vluncasu/SolarSkin/README.md

# SolarSkin - a 3D printed kinetic facade

The original SolarSkin office carries **twenty moving modules** across its
front. Behind the facade are four occupied levels, furnished rooms and a
technical roof. The assembled CAD model stands about 87 cm tall.
In the Blender scene, each row and column starts at a different point in
the opening cycle. Together the leaves make a wave across the building.

[Browse all building angles](docs/20_building_views.md) · [Original render sheets by revision](docs/21_revision_views.md)

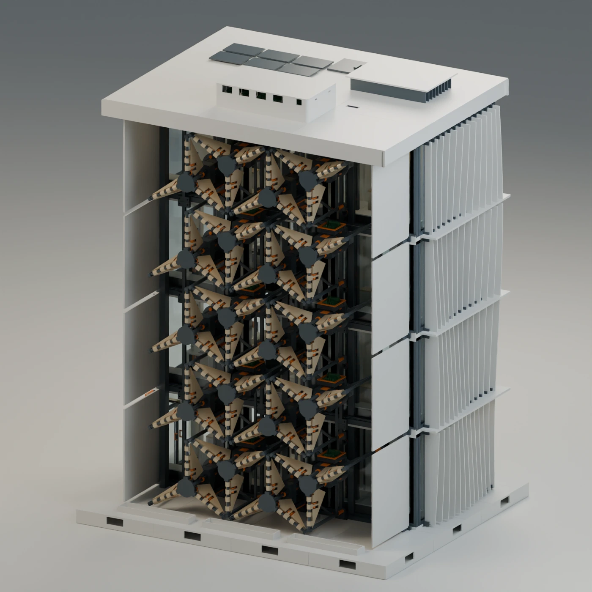
[picture p1: media/renders/original20_front.webp]
Complete September SolarSkin office with its twenty kinetic modules


**[Download the original building - Blender and FreeCAD ZIP](https://github.com/vluncasu/SolarSkin/releases/latest/download/SOLARSKIN_ORIGINAL_OFFICE_20.zip)**
· [Open the animated Blender model](cad/original_20_module_building/COMPLETE_BUILDING_20.blend)
· [Corrected R6 assembly in FreeCAD](cad/original_20_module_building/COMPLETE_BUILDING_R6.FCStd)
· [Download the CAD, print files and manuals](https://github.com/vluncasu/SolarSkin/releases)

| The twenty-module facade in motion | Inside the building | Roof equipment |
|---|---|---|
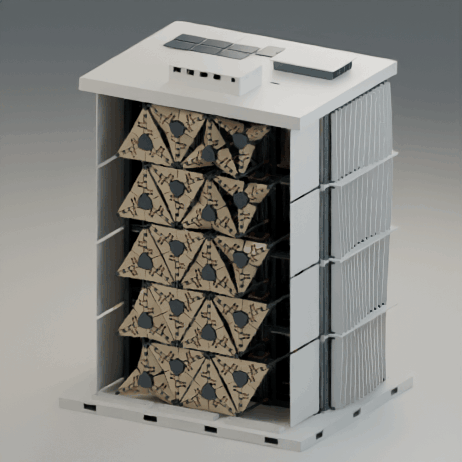
[picture p2: media/renders/original20_motion.gif]
Wave across the original twenty-module office
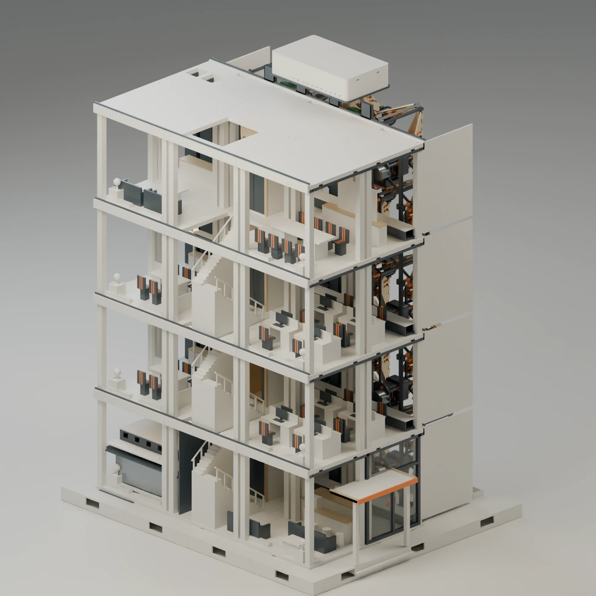
[picture p3: media/renders/original20_cutaway.webp]
Office floors and furnishings in cutaway
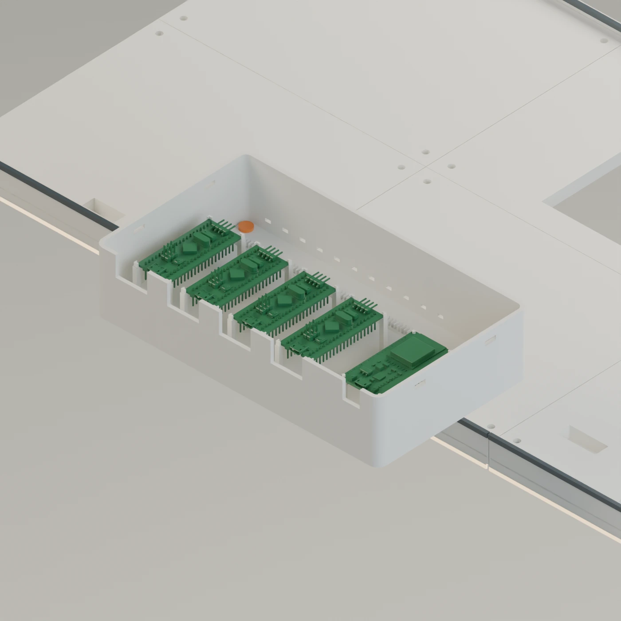
[picture p4: media/renders/original20_roof.webp]
Plant and access space on the technical roof
|  |  |  |

| Around the building | Glazed rear facade | Furnished floor |
|---|---|---|
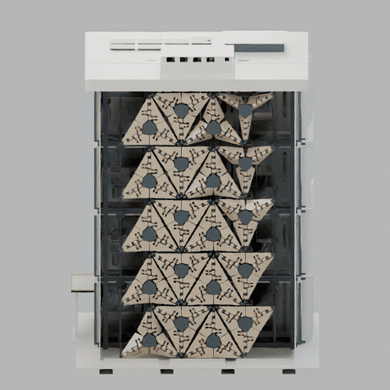
[picture p5: media/views/original20_orbit.gif]
Around the building
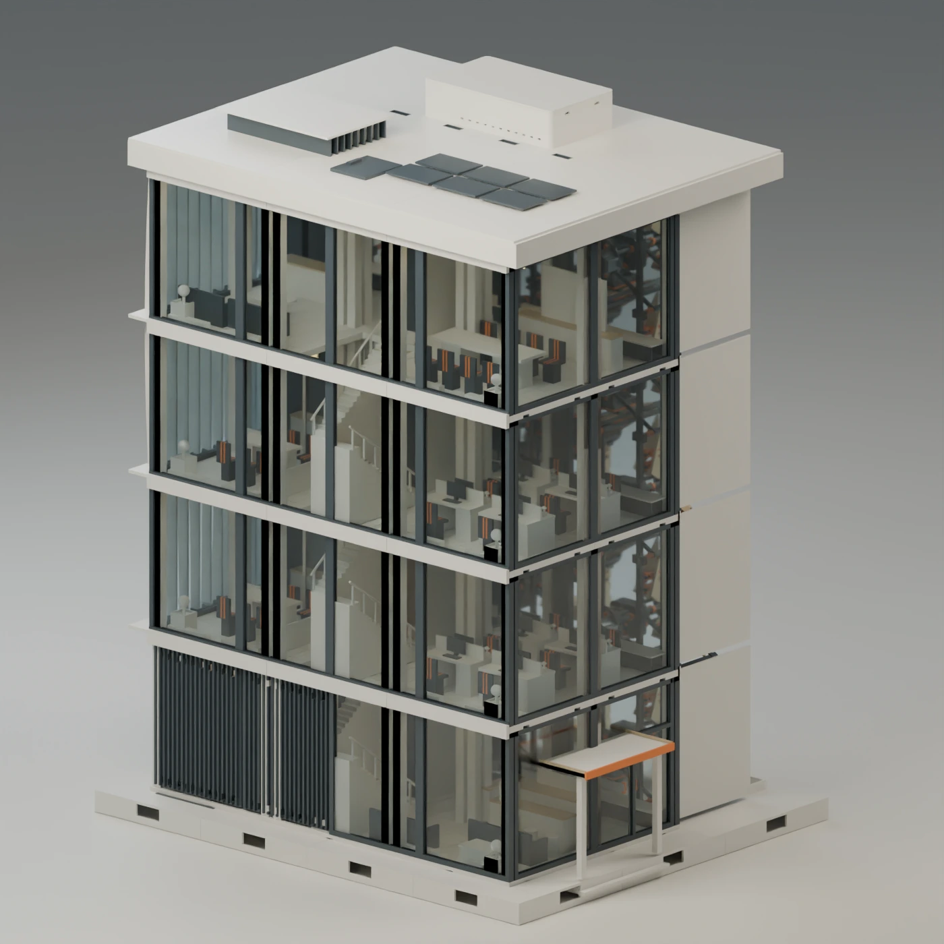
[picture p6: media/renders/original20_rear.webp]
Glazed rear facade
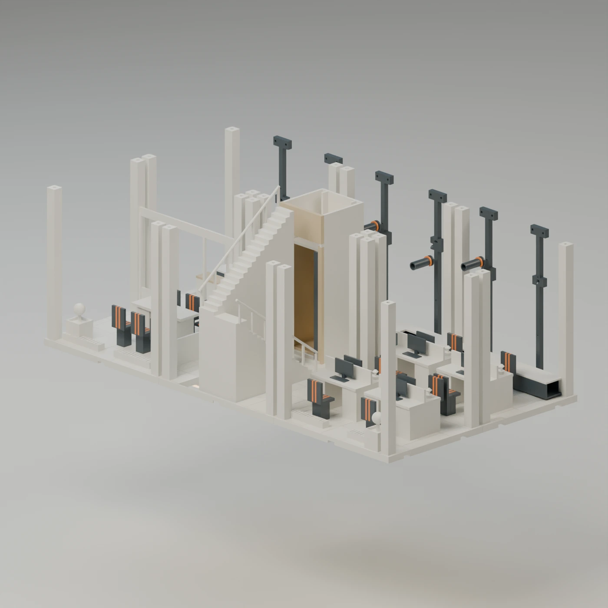
[picture p7: media/renders/original20_floor.webp]
Furnished floor
|  |  |  |

[All angles of the original twenty-module office](docs/20_building_views.md#original-twenty-module-office).

The facade animation above is an accelerated preview. Open the Blender file and
press Space to see the full 40-second sequence at its saved playback rate.
The R6 FreeCAD file exposes the individual M01-M20 placements for inspection.
[Building elevations, office detail and revision notes](docs/19_original_office.md).

## Compact office, Aurora pavilion and rigid office

| Compact office | Aurora pavilion | Rigid office |
|---|---|---|
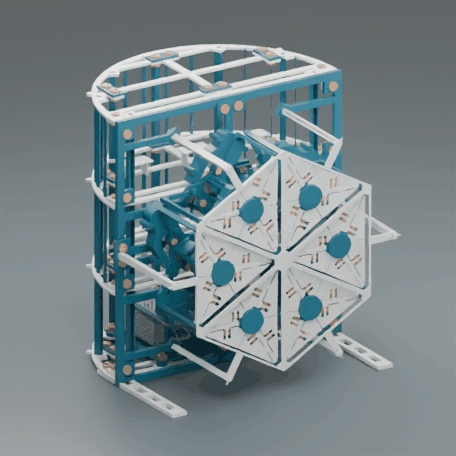
[picture p8: media/renders/compact_motion.gif]
Six modules folding on the compact office
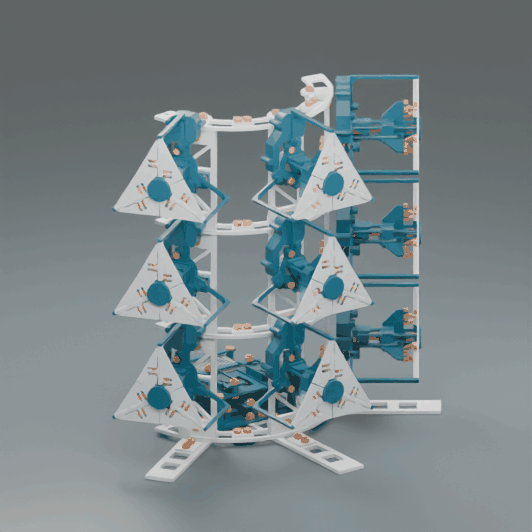
[picture p9: media/renders/aurora_motion.gif]
Moving leaves on the Aurora pavilion
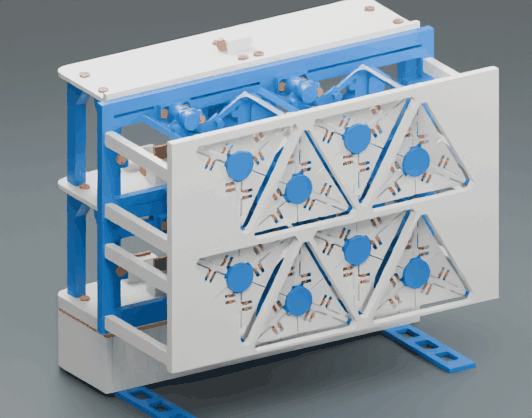
[picture p10: media/renders/rigid_motion.gif]
Eight modules opening on the rigid office
|  |  |  |
| [Animated Blender assembly](cad/earlier_offices/COMPACT_OFFICE.blend) | [Animated Blender assembly](cad/earlier_offices/AURORA_PAVILION.blend) | [Animated Blender assembly](cad/earlier_offices/RIGID_OFFICE.blend) |

The cameras in the motion previews stay still while the leaves move. In the views
below, the buildings stay still so you can inspect the sides, roof and rear.

| Compact office | Aurora pavilion | Rigid office |
|---|---|---|
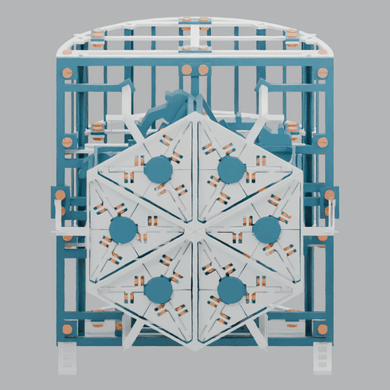
[picture p11: media/views/compact_orbit.gif]
Compact office
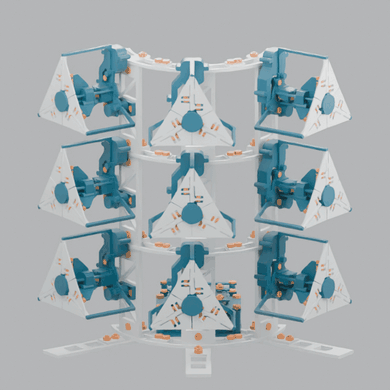
[picture p12: media/views/aurora_orbit.gif]
Aurora pavilion
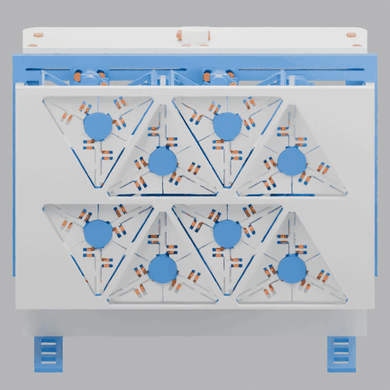
[picture p13: media/views/rigid_orbit.gif]
Rigid office
|  |  |  |

| Compact - curved rear | Aurora - service side | Rigid - rear floors |
|---|---|---|
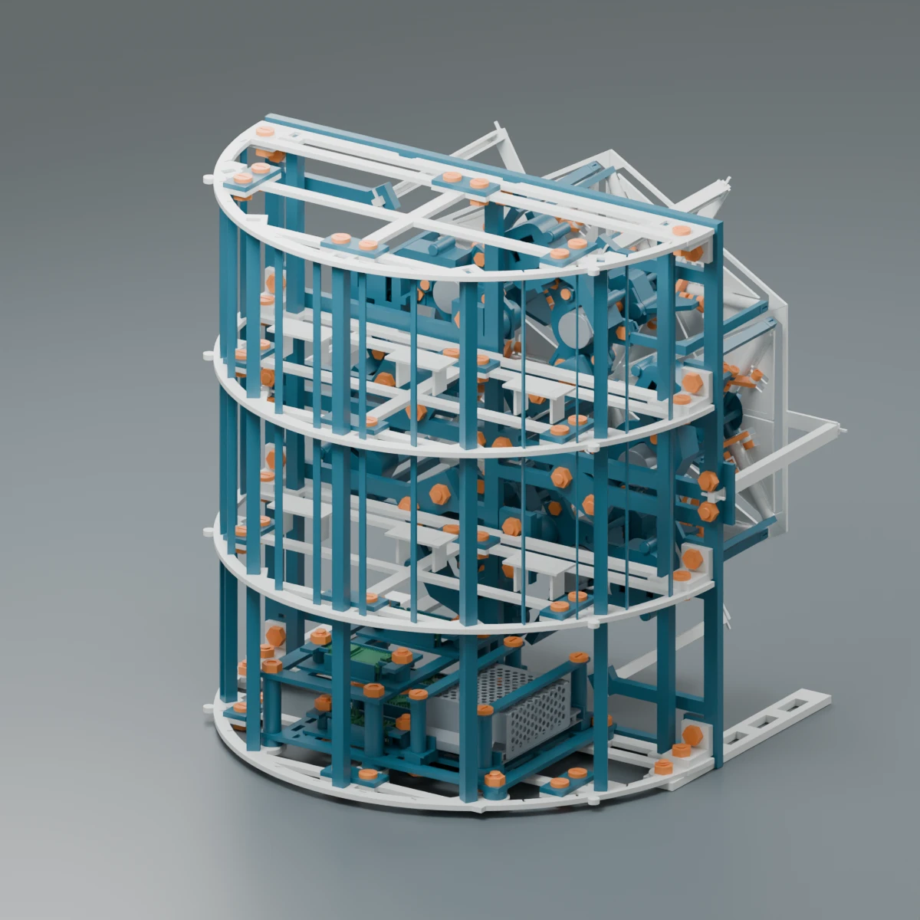
[picture p14: media/views/compact_source_rear.webp]
Compact - curved rear
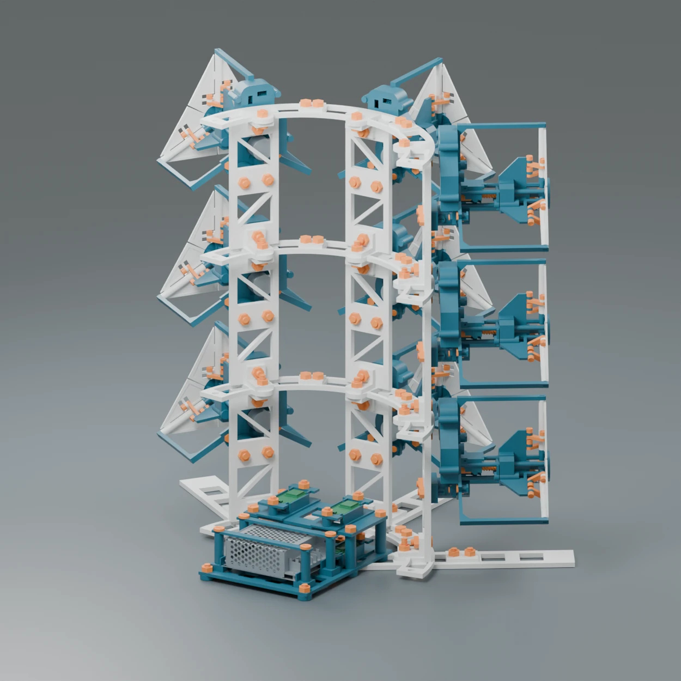
[picture p15: media/views/aurora_source_service_rear.webp]
Aurora - service side
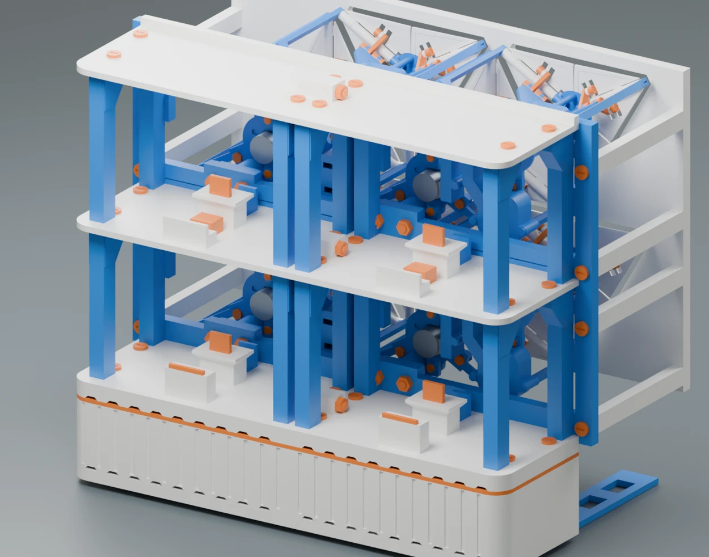
[picture p16: media/views/rigid_source_rear.webp]
Rigid - rear floors
|  |  |  |

| Compact - technical cassette | Aurora - exposed frame | Rigid - equipment bay |
|---|---|---|
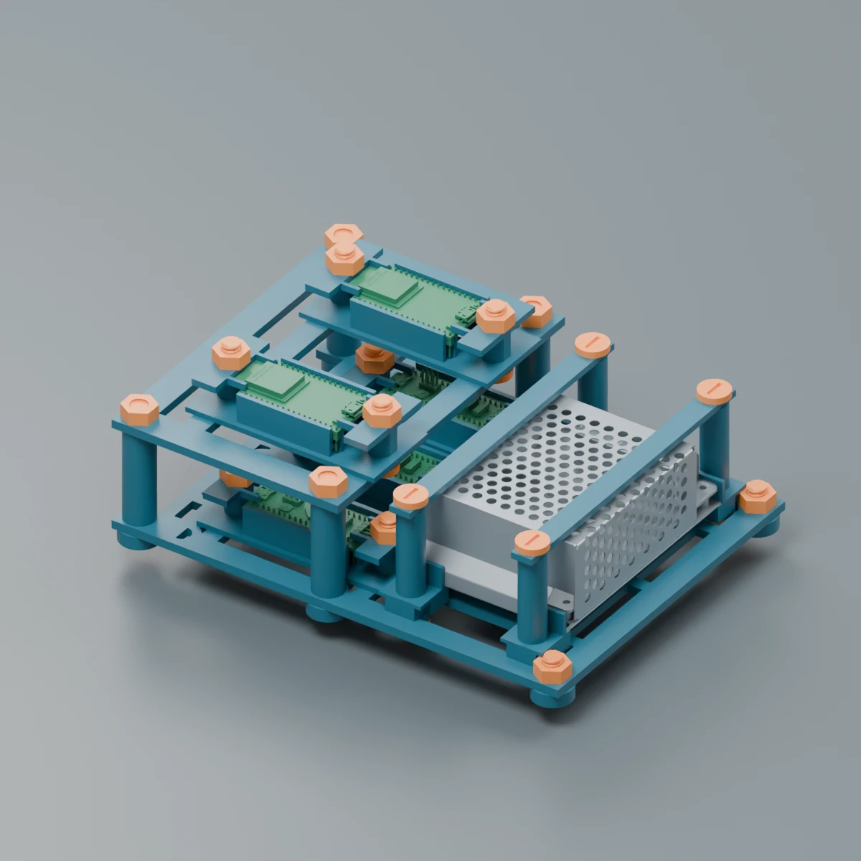
[picture p17: media/views/compact_source_electronics.webp]
Compact - technical cassette
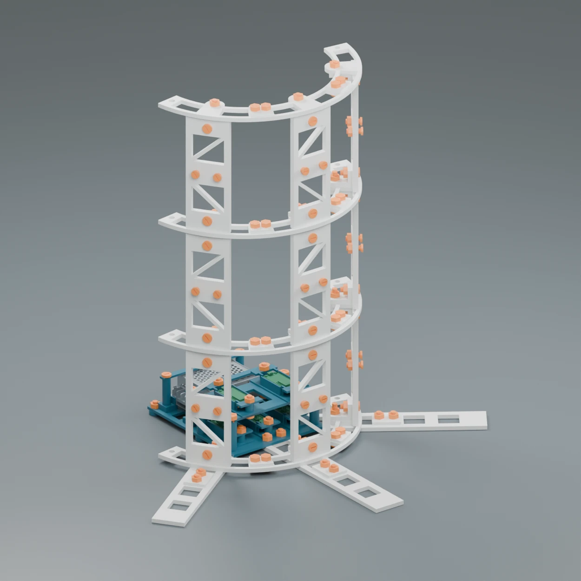
[picture p18: media/views/aurora_source_structure.webp]
Aurora - exposed frame
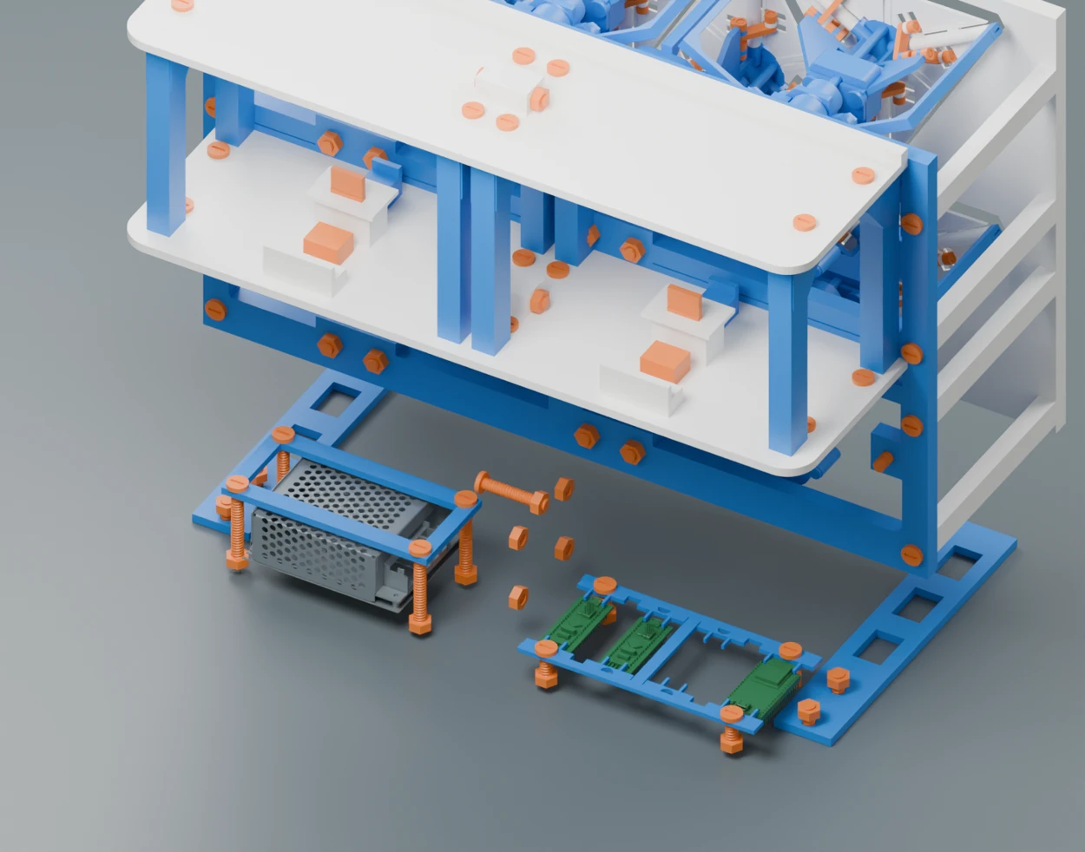
[picture p19: media/views/rigid_source_equipment_bay.webp]
Rigid - equipment bay
|  |  |  |

[All angles of the compact office](docs/20_building_views.md#compact-office) · [All angles of the aurora pavilion](docs/20_building_views.md#aurora-pavilion) · [All angles of the rigid office](docs/20_building_views.md#rigid-office).

The opening sequences follow the original CAD motion of the leaves.
Compact has six installed modules, Aurora has nine, and Rigid has eight.
The assemblies contain 36, 54 and 48 moving leaves respectively. Follow a single hinge in each view to see how its leaf
moves relative to the fixed frame.

The [design archive](docs/18_architectural_design_archive.md) includes the
[nine-position office animation](media/renders/building_motion.gif) and
identifies the later mounting revisions by their original folder names.

### Nine-module office

| Exterior survey | View into the rear | Service access |
|---|---|---|
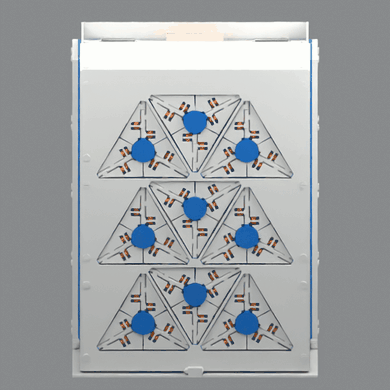
[picture p20: media/views/office9_orbit.gif]
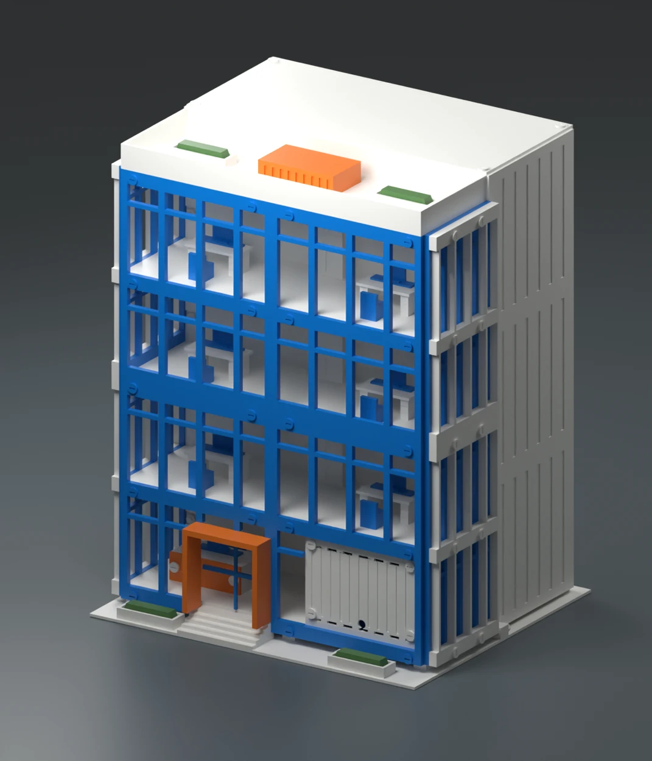
[picture p21: media/views/office9_source_rear.webp]
View into the rear
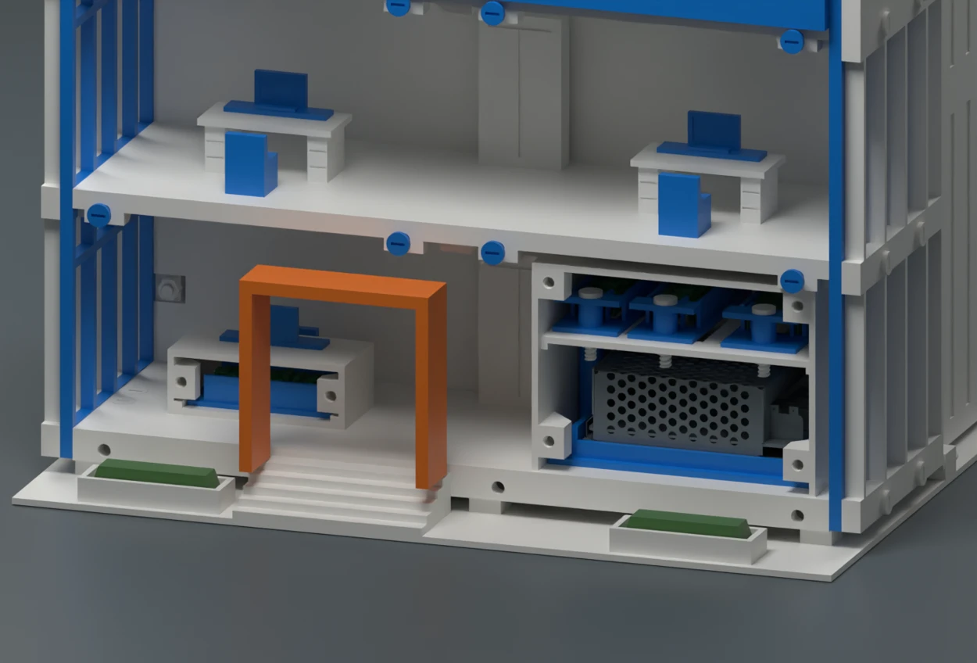
[picture p22: media/views/office9_source_service.webp]
Service access
|  |  |  |

[All angles of the nine-module office](docs/20_building_views.md#nine-module-office).

## The later furnished office - sixteen modules

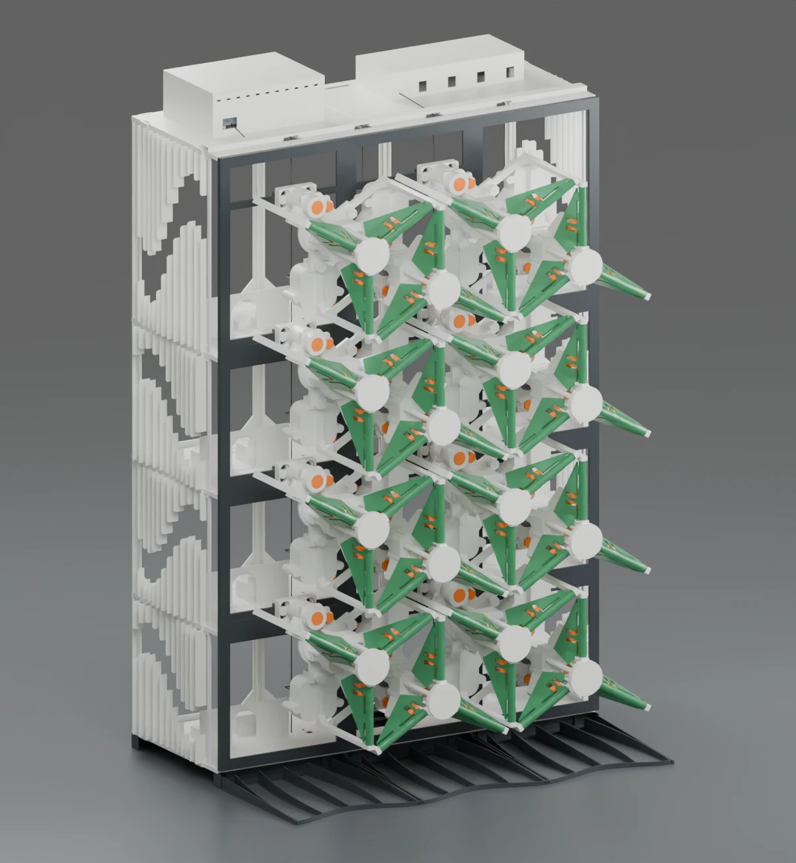
[picture p23: media/renders/furnished_open.webp]
The furnished sixteen-module office


[Open this office in Blender](cad/furnished/OFFICE_16.blend).

The rear is open so that you can see past the facade into the rooms.
The stair runs through the middle. Two reception units sit on the first
occupied level, four workshop units occupy the middle levels and two meeting
units sit above them. Every unit drops onto its floor and is held by a
two-pin bar. Fit that bar while you can still reach it from above.

| Facade closed | View from the rear |
|---|---|
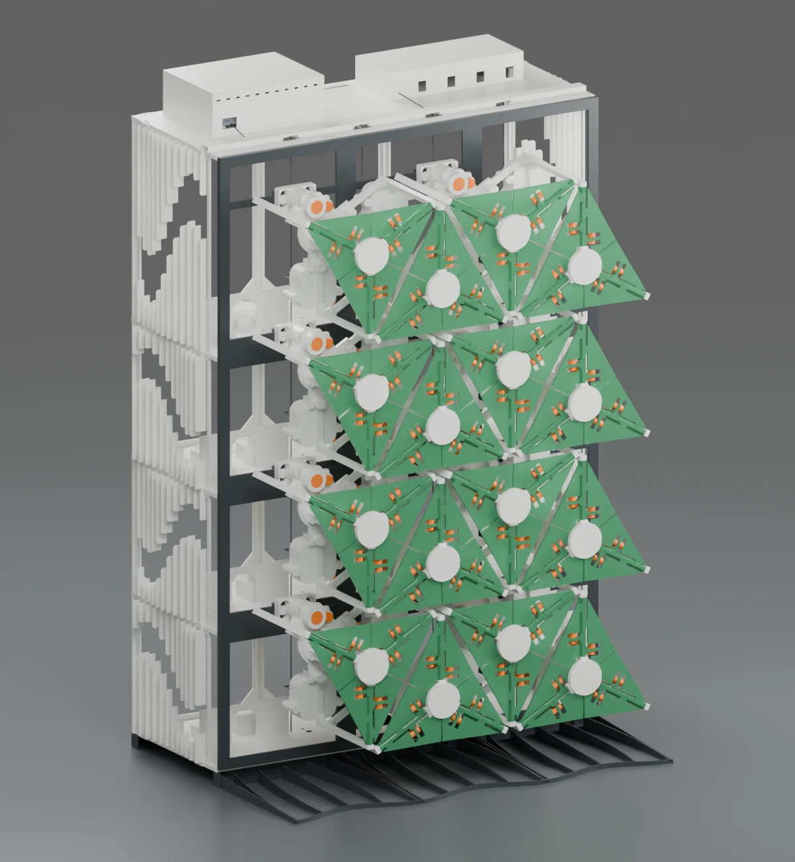
[picture p24: media/renders/furnished_closed.webp]
Closed leaves on the furnished office
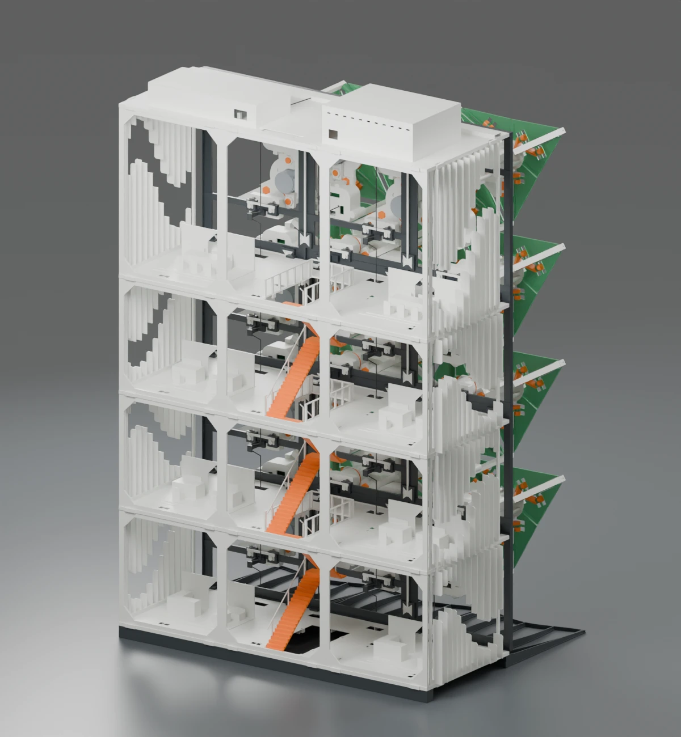
[picture p25: media/renders/furnished_rear.webp]
Open rear frames expose the floors and rooms
|  |  |

| Stair and landings | Furniture detail |
|---|---|
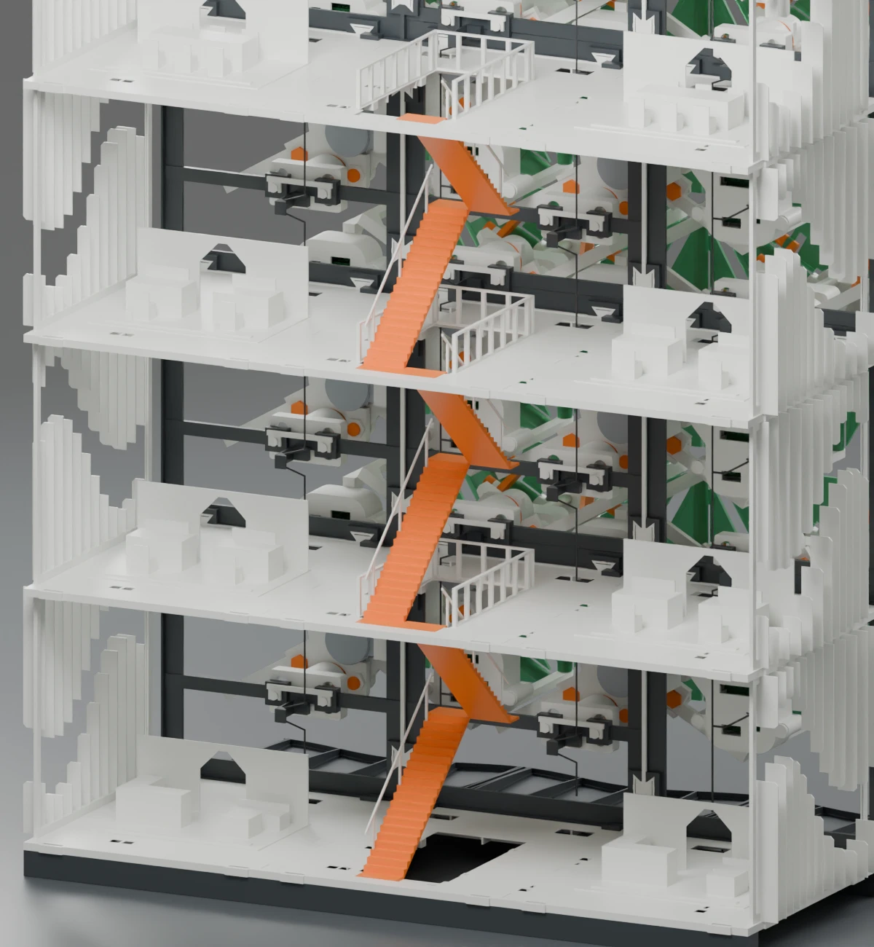
[picture p26: media/renders/furnished_interior.webp]
Stair flights connecting the furnished floors
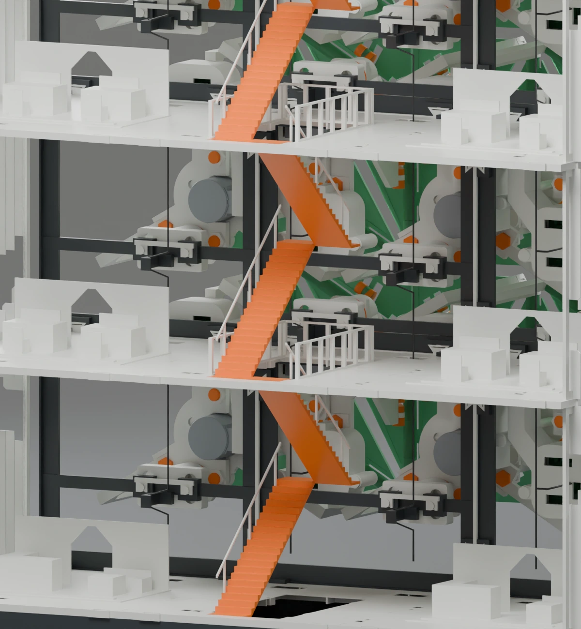
[picture p27: media/renders/furnished_room_detail.webp]
Furnished room and adjacent circulation space
|  |  |

The wavy strips along the sides are eight printed panels. Each panel carries
its fins in one frame, which sets their spacing during assembly. The fins
project between 8 and 14 mm. At the front, twelve cassettes carry the sixteen
module receivers. The rear view below shows the cassette joints that are
hidden once the facade is on the building.

| Side panel profile | Rear of the facade before installation | Ribbed front base |
|---|---|---|
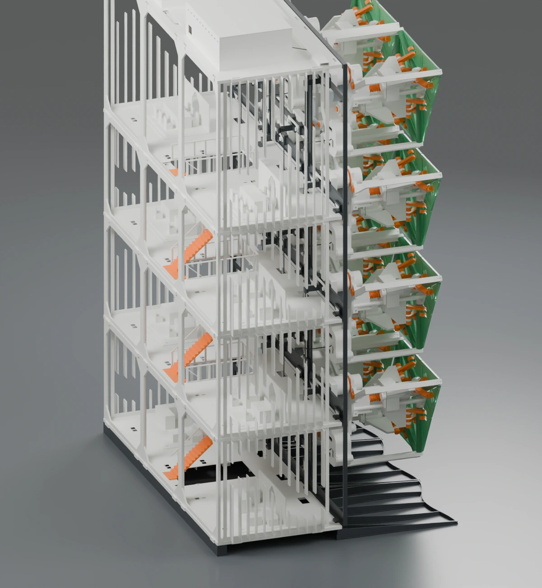
[picture p28: media/renders/furnished_fin_profile.webp]
Projection of the side fins
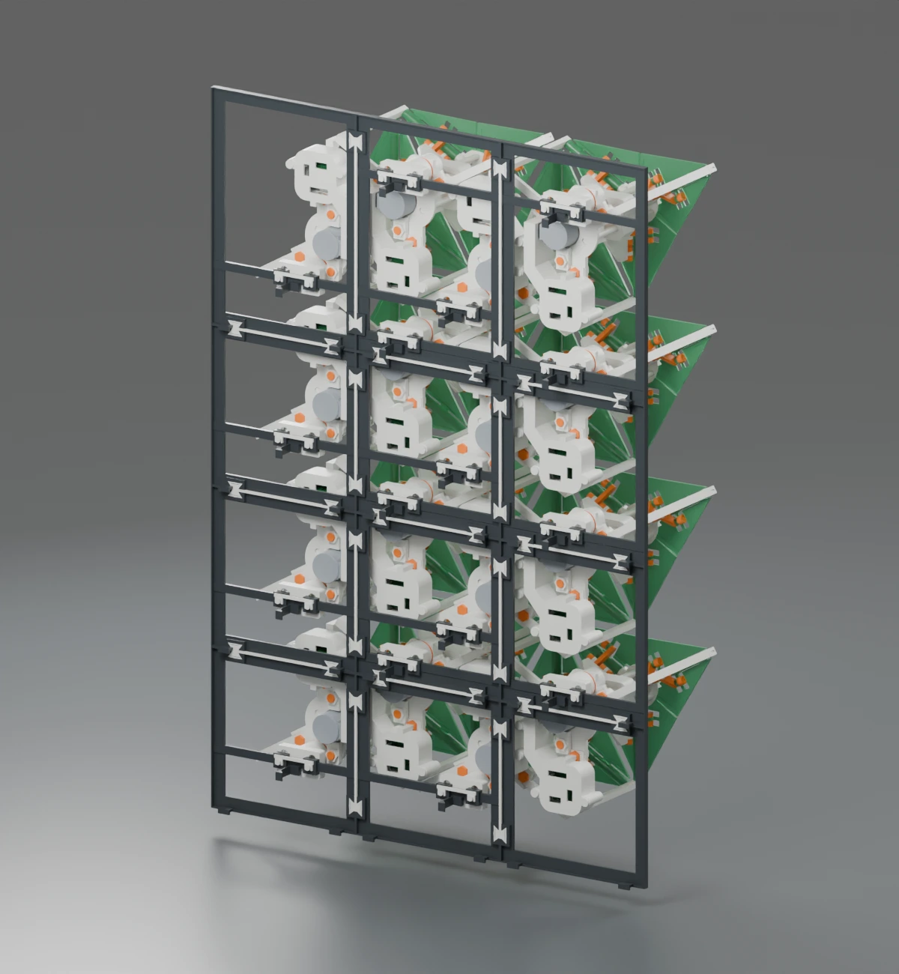
[picture p29: media/renders/furnished_cassette_rear.webp]
Back of the separately assembled facade
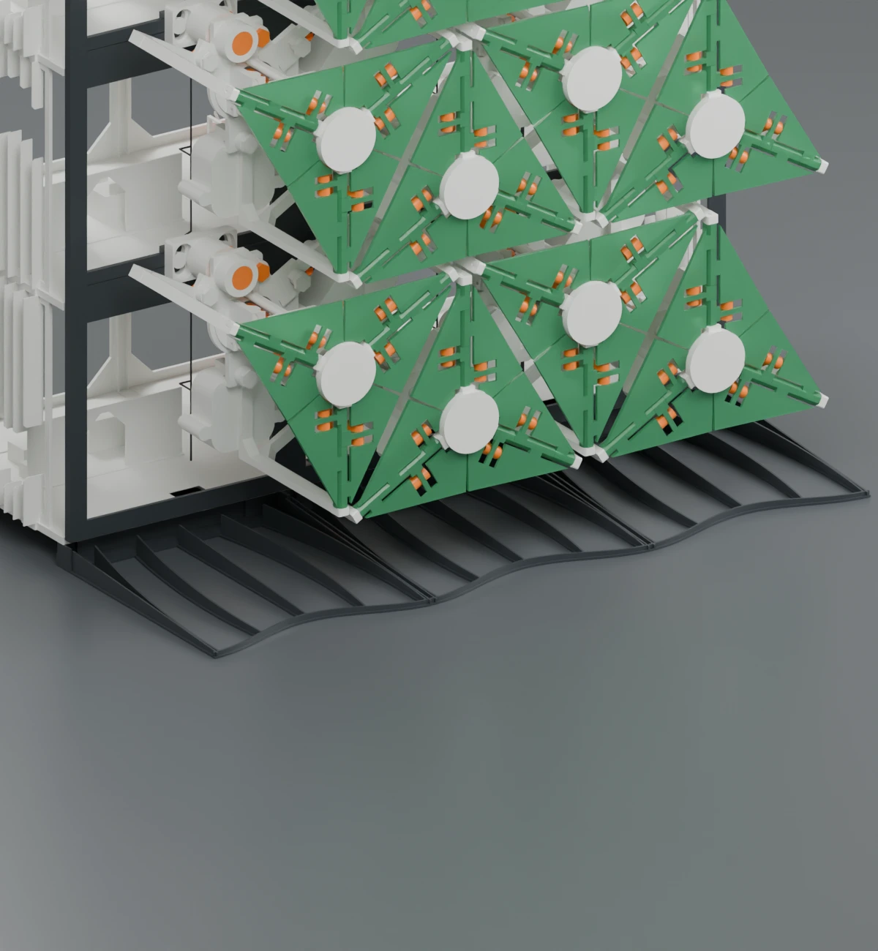
[picture p30: media/renders/furnished_fan_base.webp]
Fan-shaped ribs at the front base
|  |  |  |

| Exterior survey | Direct side view | Roof plan |
|---|---|---|
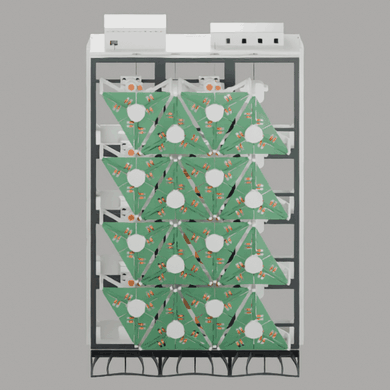
[picture p31: media/views/furnished_orbit.gif]
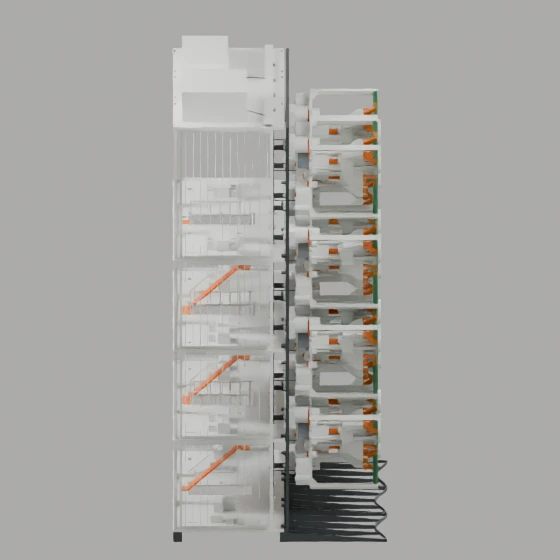
[picture p32: media/views/furnished_side-a.webp]
Direct side view
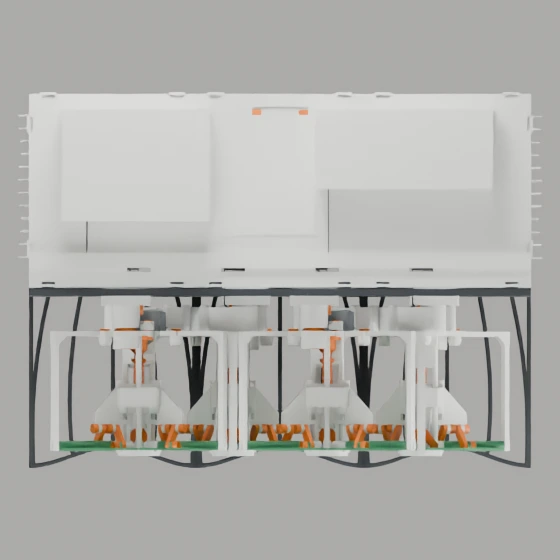
[picture p33: media/views/furnished_roof.webp]
Roof plan
|  |  |  |

[All angles of the furnished office](docs/20_building_views.md#furnished-office).

The furnished office requires **193 architectural pieces on 46 print beds**.
That count assumes the moving modules have already been made.
[Building parts and quantities](docs/atlas/furnished-office.md) ·
[Floor-by-floor assembly](docs/furnished_workshop.md) ·
[Prepared print beds](print/furnished/)

## Watch one module open

| Complete mechanism | Same motion with the leaves and outer frame hidden |
|---|---|
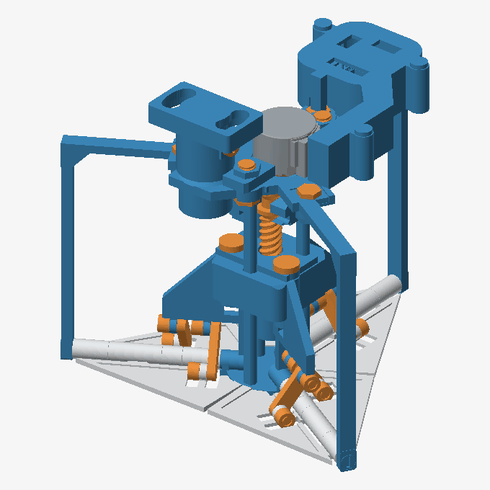
[picture p34: media/renders/module_cycle.gif]
Animated six-leaf module from the 10 mm Blender assembly
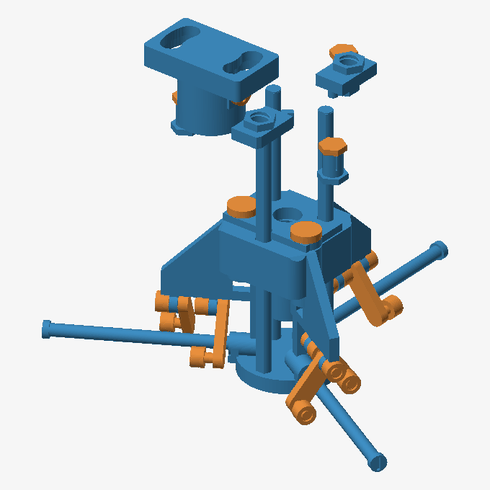
[picture p35: media/renders/module_drive.gif]
Carriage and rods travelling between the two end poses
|  |  |

Follow the blue carriage in the right-hand view. Three guides keep it from
turning with the screw. As it slides, each rod pulls on a point 12 mm from
its leaf pivot. Both animations use the same frames from the
[mechanism CAD](cad/01_mechanism/MECHANISM_10MM.blend). Playback is for
inspection. The motor speed on the stand is set in firmware.

The screw has three thread starts. Adjacent crests are 3.33 mm apart
along the axis. A nut following one start advances **10 mm per turn**.
With a 20 mm rod, moving a leaf from 0 to 75 degrees requires 15.348 mm
of carriage travel. That takes 1.535 screw turns, or about **6,287 half-steps**
with direct coupling and the nominal 4,096 half-steps per geared output turn.
Multiply that count by any additional reduction between the output and screw.

[Thread profile and equations](docs/02_screw_and_motor_calculations.md) ·
[Linkage geometry](docs/01_mechanism_and_kinematics.md) ·
[Compare the calculation with nine CAD poses](docs/17_simulation_and_commissioning.md)

## Print and assemble the first module

Print the orange P13 screw and the two blue nuts, P12 and P26, first.
Run each nut along the screw by hand. A tight fit is easier to diagnose
on the bench than inside the carriage. For a complete module, the print
set has **30 blue structural parts, 6 white leaves and 26 orange parts**.
The architectural renders preserve the material colors of their own revisions.

| Fit both nuts in the carriage | Insert the screw through the side | Attach the paired leaves and rods |
|---|---|---|
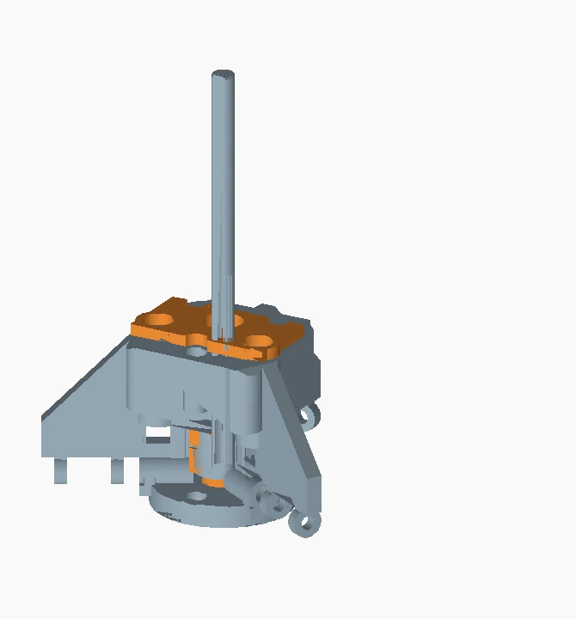
[picture p36: media/atlas/module-stage-1.webp]
Split nuts and cover fitted on the carriage
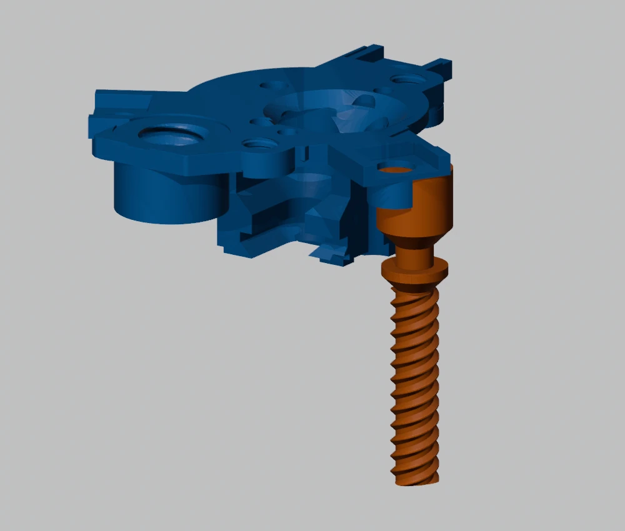
[picture p37: media/renders/screw_insertion_01.webp]
Lead screw entering the rear frame
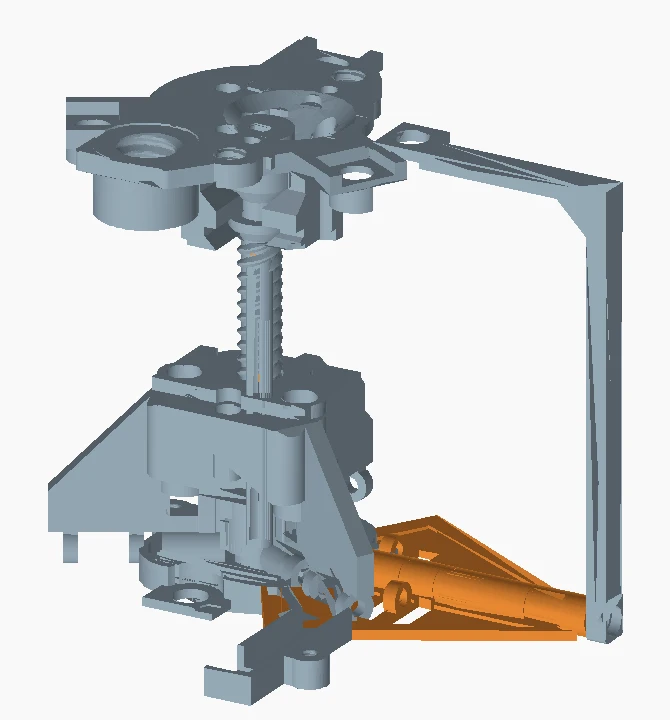
[picture p38: media/atlas/module-stage-4.webp]
Leaf hinges and six links in their assembled positions
|  |  |  |

Seat the screw in the rear frame **before** fitting the motor and clamps.
The side opening gives the coupling room to pass. After the three axles
and six rods are in place, turn the screw by hand through the intended
travel. Each rod must pivot at both ends. Check the cable loop again
with the module attached to its receiver.

[Four arranged 3MF plates](print/09_one_module_plates/) ·
[Bed layout by color](docs/13_print_beds.md) ·
[Module assembly steps](docs/module_workshop.md) ·
[All printable parts, with dimensions and two views each](docs/pdf/SOLARSKIN_ALL_PARTS.pdf)

## The simplified office and the exhibition stand

| Simplified office | Independent stand |
|---|---|
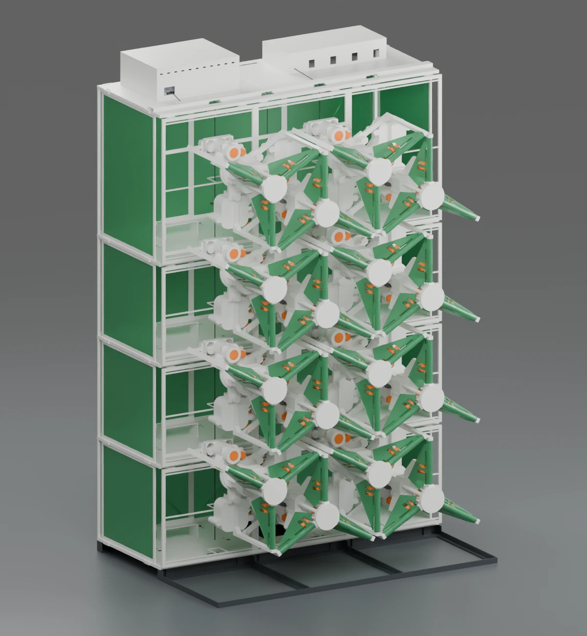
[picture p39: media/renders/simplified_open.webp]
Rapid office with its facade open
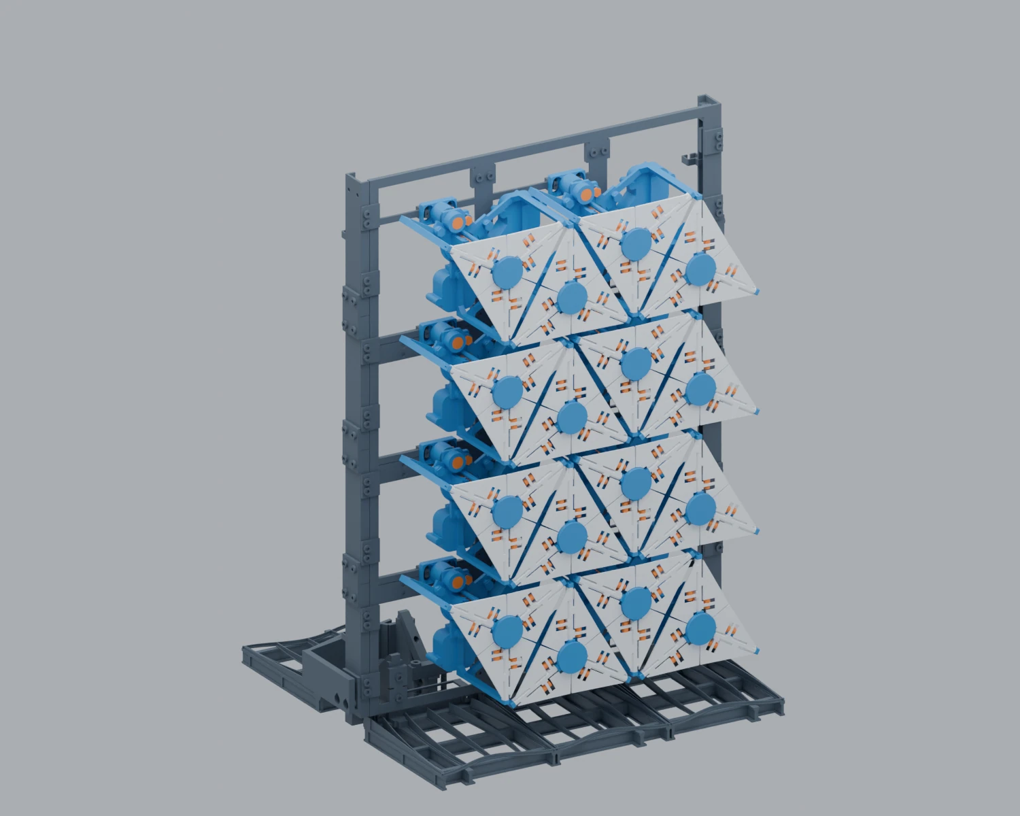
[picture p40: media/renders/assembly_01.webp]
Populated stand showing the frame and supporting feet
|  |  |
| [Open the building](cad/simplified/OFFICE_16.blend) | [Open the reinforced assembly](cad/03_reinforced_assembly/REINFORCED_16_MODULE_ASSEMBLY.blend) |

| Around the simplified office | Rapid office from the rear | Rapid office interior |
|---|---|---|
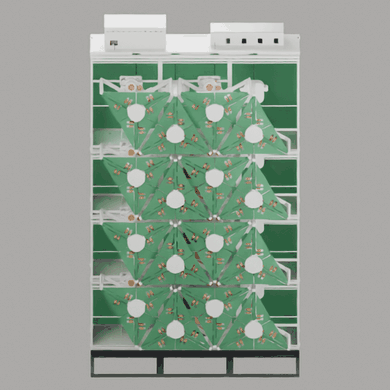
[picture p41: media/views/simplified_orbit.gif]
Around the simplified office
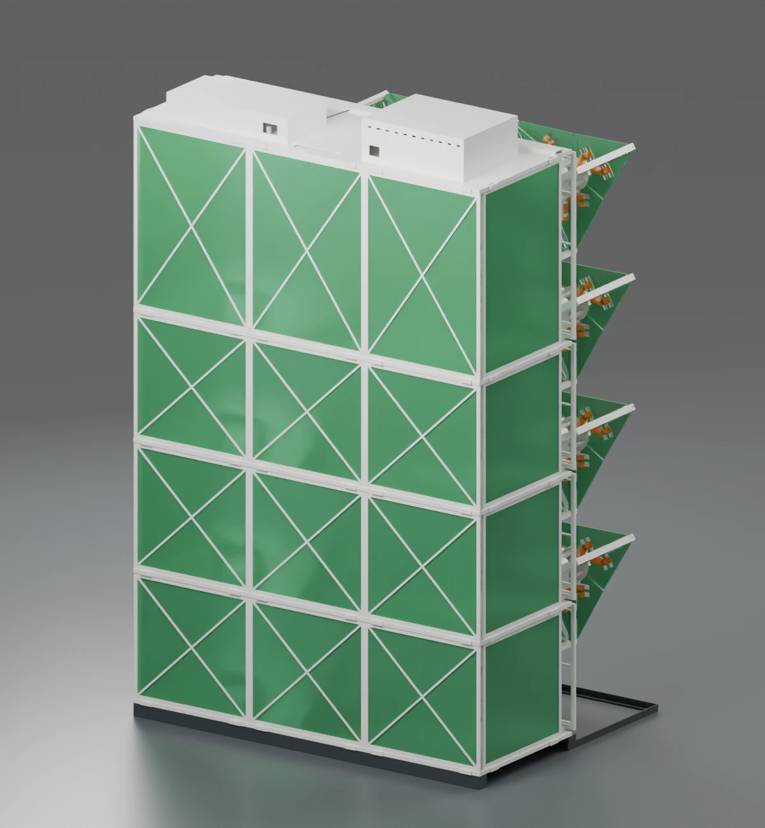
[picture p42: media/renders/simplified_rear.webp]
Rapid office from the rear
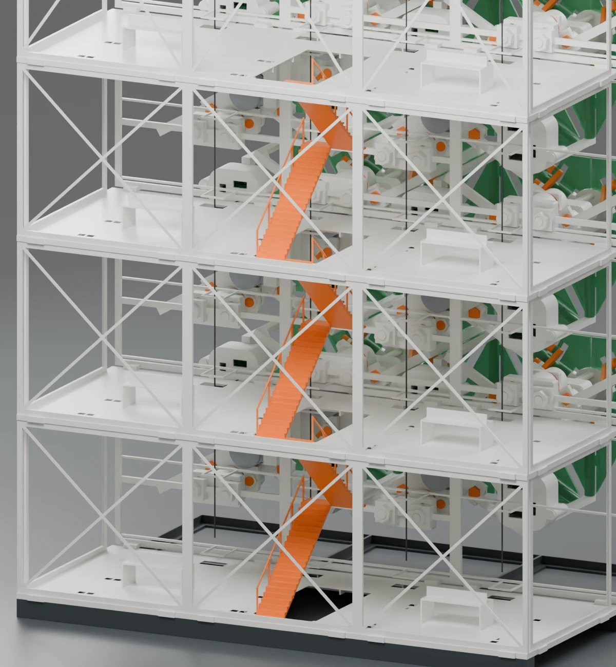
[picture p43: media/renders/simplified_interior.webp]
Rapid office interior
|  |  |  |

[All angles of the simplified office](docs/20_building_views.md#simplified-office).

The **simplified office** keeps the floors, stair and facade. Its print
inventory omits the optional furniture and includes thin translucent panes.
It takes 158 architectural pieces across 63 beds. The slabs print on edge,
so their brim and the bridges across the stair opening deserve a first-bed
check. Its receivers use J02 D8 screws. The furnished office uses F01 bolts
and an F02 locking bar.
[Rapid office inventory](docs/atlas/simplified-office.md) ·
[Assembly and glazing](docs/simplified_workshop.md)

| Around the populated stand | Empty supporting frame | Rear foot connection |
|---|---|---|
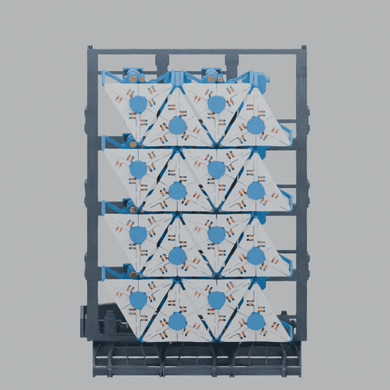
[picture p44: media/views/stand_orbit.gif]
Around the populated stand
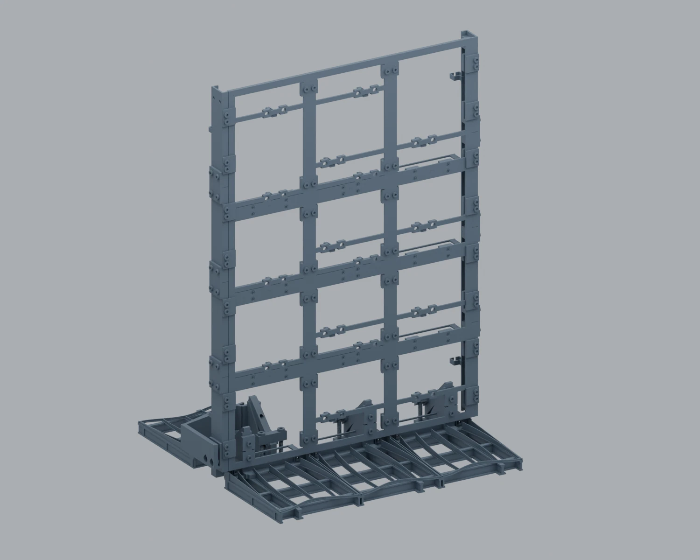
[picture p45: media/renders/assembly_03.webp]
Empty supporting frame
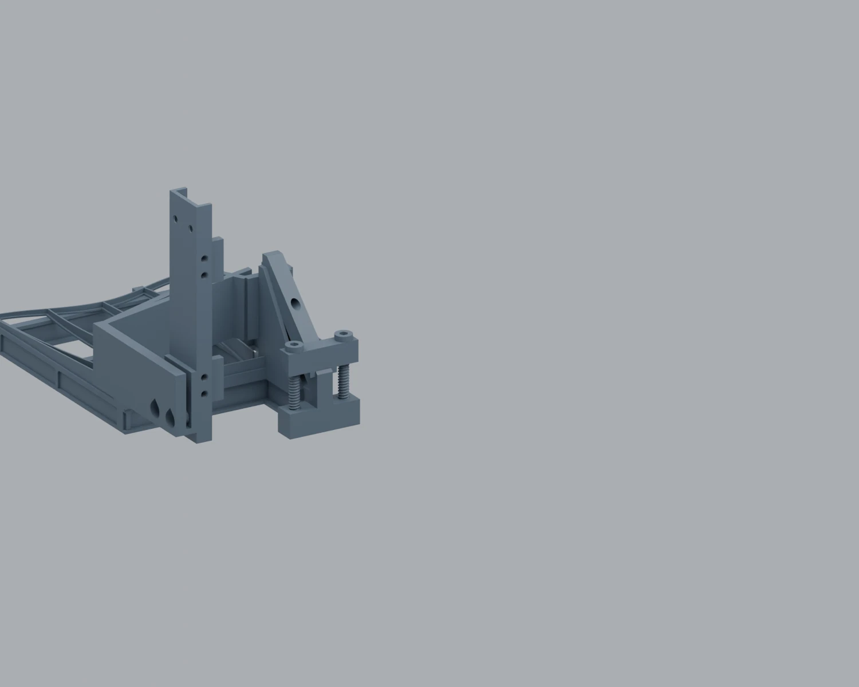
[picture p46: media/renders/assembly_08.webp]
Rear foot connection
|  |  |  |

[All angles of the independent stand](docs/20_building_views.md#independent-stand).

The **stand** leaves the motors, plugs and receiver screws accessible from
behind. Assemble its twelve cassettes on a flat surface before loading
them. The ribs bridge the cassette joints. The base supports stiffen the
printed soles, and the fourth foot extends behind the frame. In Blender,
scene 03 isolates the frame. Scenes 04 to 06 show one module attachment.
[Stand and foot assembly](docs/stand_workshop.md) ·
[Fastener sizes and cassette map](docs/05_frame_assembly.md)

## Run the facade with an ESP32

One ESP32 shifts 56 bits through seven 74HC595 registers. Each register feeds
two ULN2003 drivers. Each driver controls one 12 V geared motor, giving the
installed chain **14 motor channels** for a facade with 16 physical positions.

The baseline program starts from an assumed closed position and alternates
opening and closing without a browser. Connect to its SolarSkin Wi-Fi network
to stop, resume or reverse it. The long exhibition program commands 25,148
full steps per direction. Measure the extra reduction before using that value:
with direct coupling it would request 122.8 mm of travel from a mechanism
whose design stroke is 15.35 mm. There is no end-position sensor.

[Pin-by-pin wiring](docs/06_electronics.md) ·
[Build, calibrate and operate the firmware](docs/07_firmware.md) ·
[Commissioning sheet and simulation results](docs/17_simulation_and_commissioning.md)

For the workbench, download the [24-step assembly sequence](docs/pdf/SOLARSKIN_WORKSHOP_SEQUENCE.pdf)
and the [illustrated parts atlas](docs/pdf/SOLARSKIN_ALL_PARTS.pdf).
For the design rationale, read the [engineering manual](docs/pdf/SOLARSKIN_ENGINEERING_AND_ASSEMBLY.pdf)
and its [references](docs/11_references.md).

Maintained by [vluncasu](https://github.com/vluncasu). [License status](LICENSE_STATUS.md).
