vluncasu/SolarSkin/docs/atlas/README.md

# Illustrated parts inventory

Choose one construction route. Quantities apply to the named group. The same identifier can refer to different geometry across revisions. All dimensions below are STL bounding boxes in millimetres.

- [One mechanism - 28 entries](one-mechanism.md)
- [Independent stand - 25 entries](independent-stand.md)
- [Stand reinforcement - 14 entries](stand-reinforcement.md)
- [Furnished office - 47 entries](furnished-office.md)
- [Simplified office - 41 entries](simplified-office.md)
- [Optional architectural revision - 43 entries](optional-architectural-revision.md)
- [Workshop tools and additional exports - 2 entries](workshop-tools-and-additional-exports.md)
