vluncasu/SolarSkin/docs/10_repository_and_downloads.md

# Download SolarSkin

Open the [current release](https://github.com/vluncasu/SolarSkin/releases/latest).
Choose **SOLARSKIN_ESSENTIAL.zip** for the complete project, including all
building views, editable models, print files, firmware and manuals.
Extract it and open SolarSkin/README.md.

Choose **SOLARSKIN_ORIGINAL_OFFICE_20.zip** if you only want the original
twenty-module building in Blender and FreeCAD. Both ZIPs contain the actual
CAD files. The five PDF downloads are also inside the complete ZIP.

## Clone

```sh
git lfs install
git clone https://github.com/vluncasu/SolarSkin.git
cd SolarSkin
python3 tools/verify.py
```

Git LFS is required for editable CAD and print/PDF assets. For a download without Git, use the complete essential ZIP in [Releases](https://github.com/vluncasu/SolarSkin/releases). The release also offers the comparative study, engineering manual and parts catalogue separately. Preserve the directory structure.
