vluncasu/SolarSkin/docs/21_revision_views.md

# Saved views by design revision

These images come from the original design sheets. Each group retains its own source identifier. Some later revisions reuse the earlier architectural views while adding a fastener or mounting detail.

## Compact accents

Source: `SOLARSKIN_16_COMPACT_ACCENTE/PLANSE`.

| Front inspection | Closed facade | Open facade |
|---|---|---|
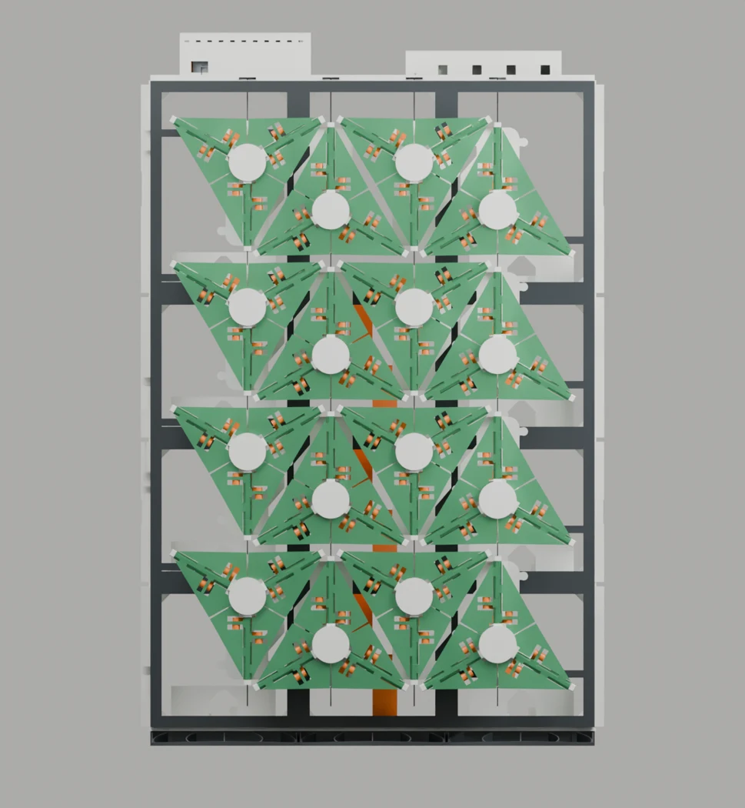
[picture p48: media/views/revisions/_16_compact_accente_00.webp]
Front inspection
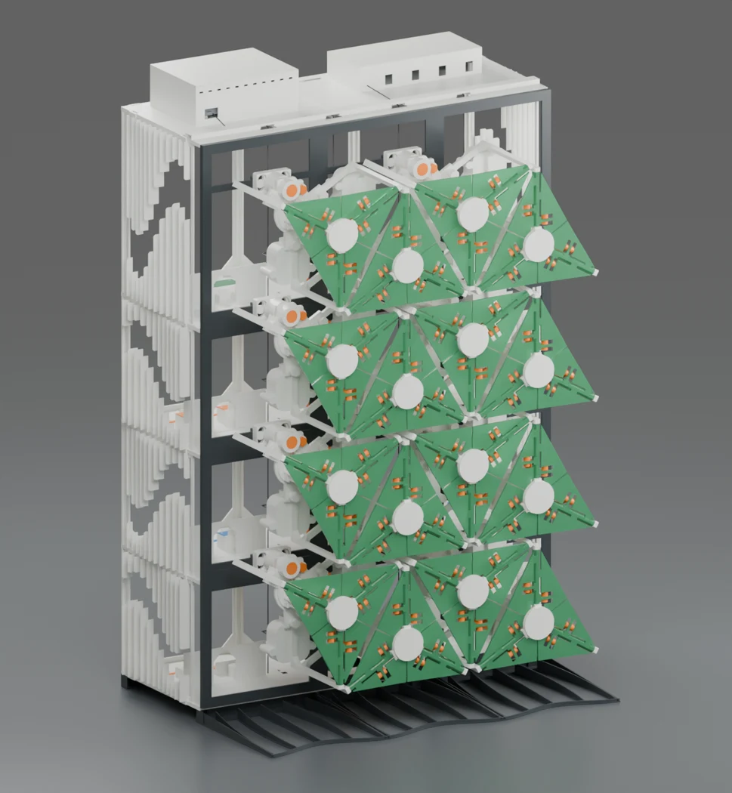
[picture p49: media/views/revisions/_16_compact_accente_01.webp]
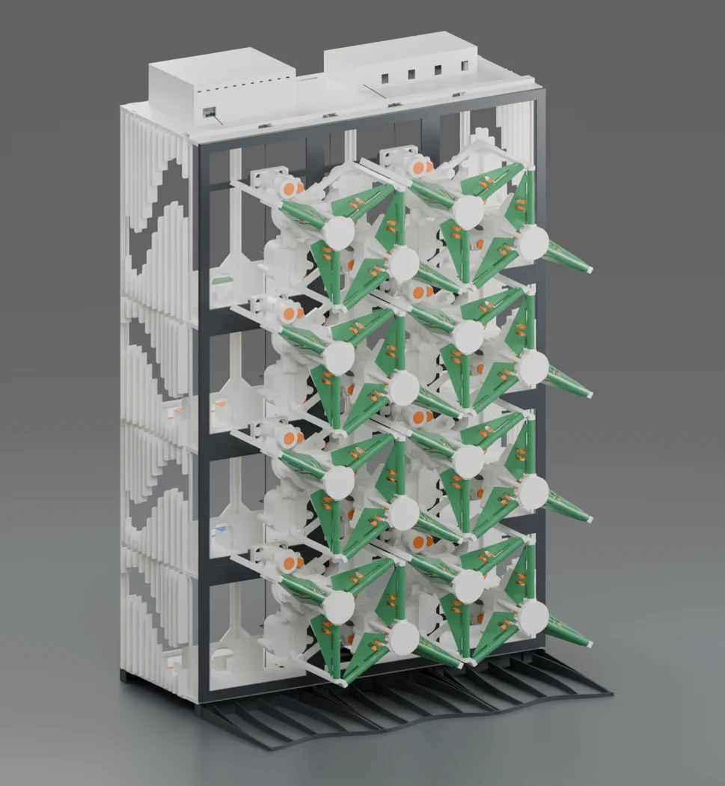
[picture p50: media/views/revisions/_16_compact_accente_02.webp]
|  |  |  |

| Rear | Stair and interior | Floor print orientation |
|---|---|---|
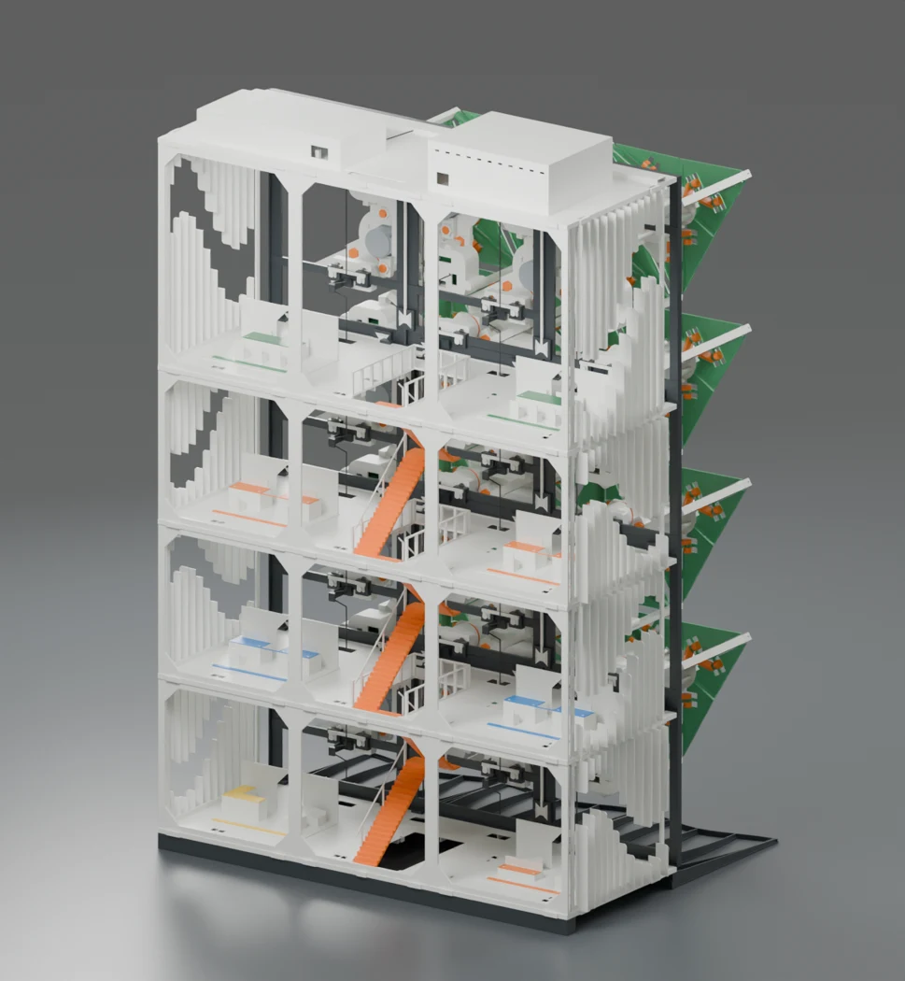
[picture p51: media/views/revisions/_16_compact_accente_03.webp]
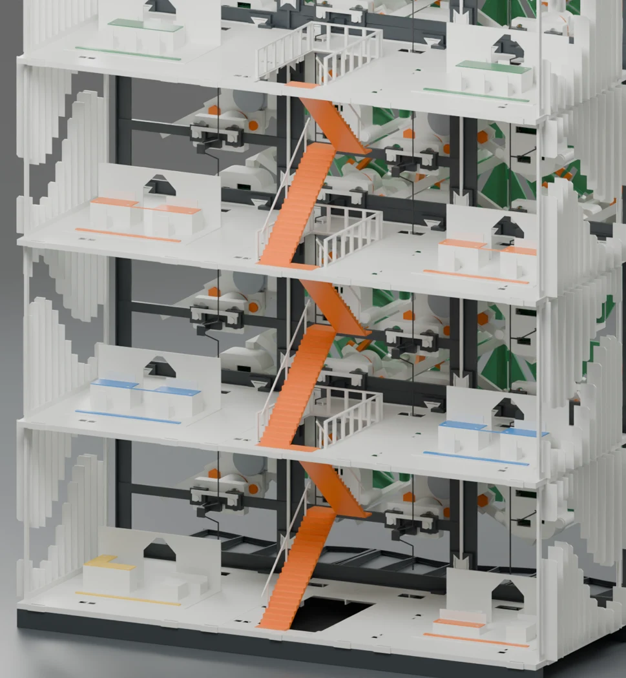
[picture p52: media/views/revisions/_16_compact_accente_04.webp]
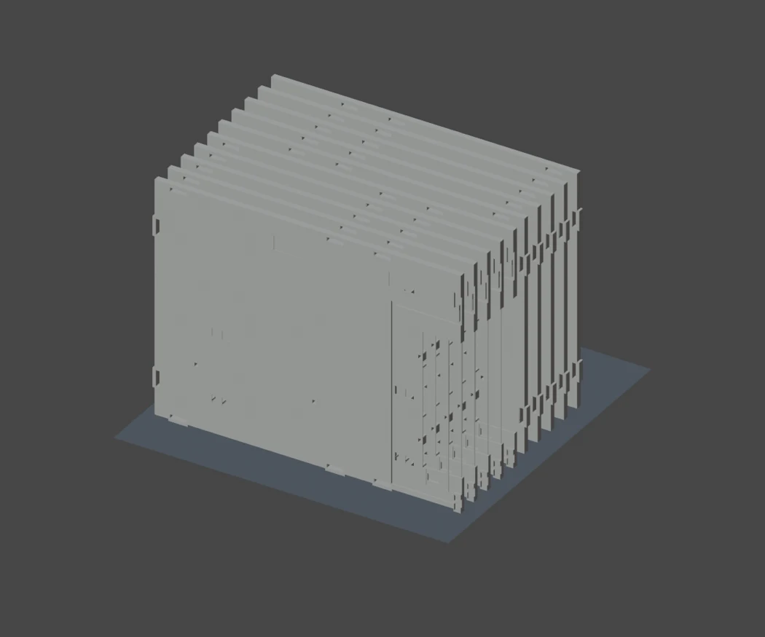
[picture p53: media/views/revisions/_16_compact_accente_05.webp]
|  |  |  |

| Facade subassembly from behind | Ribbed base | Side fins |
|---|---|---|
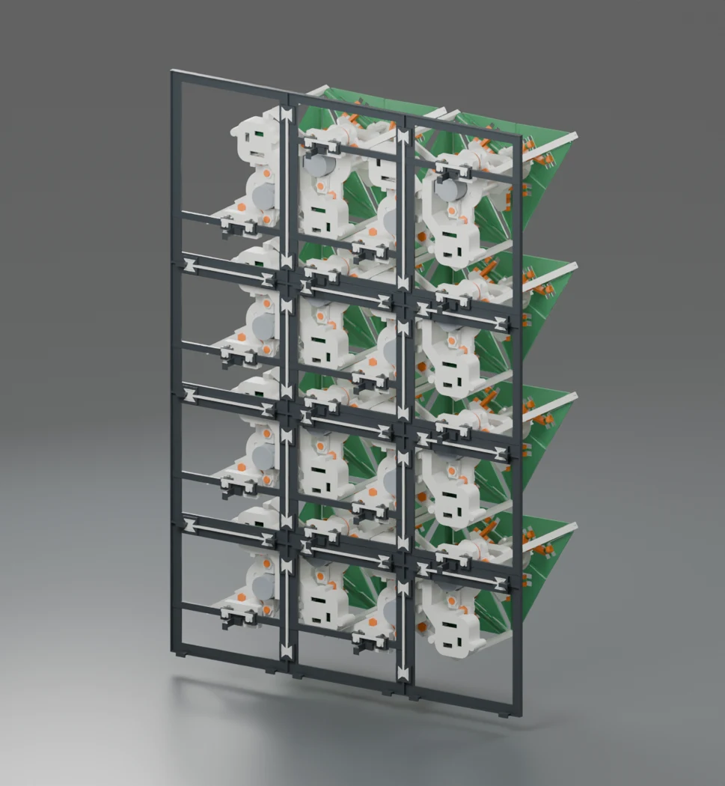
[picture p54: media/views/revisions/_16_compact_accente_06.webp]
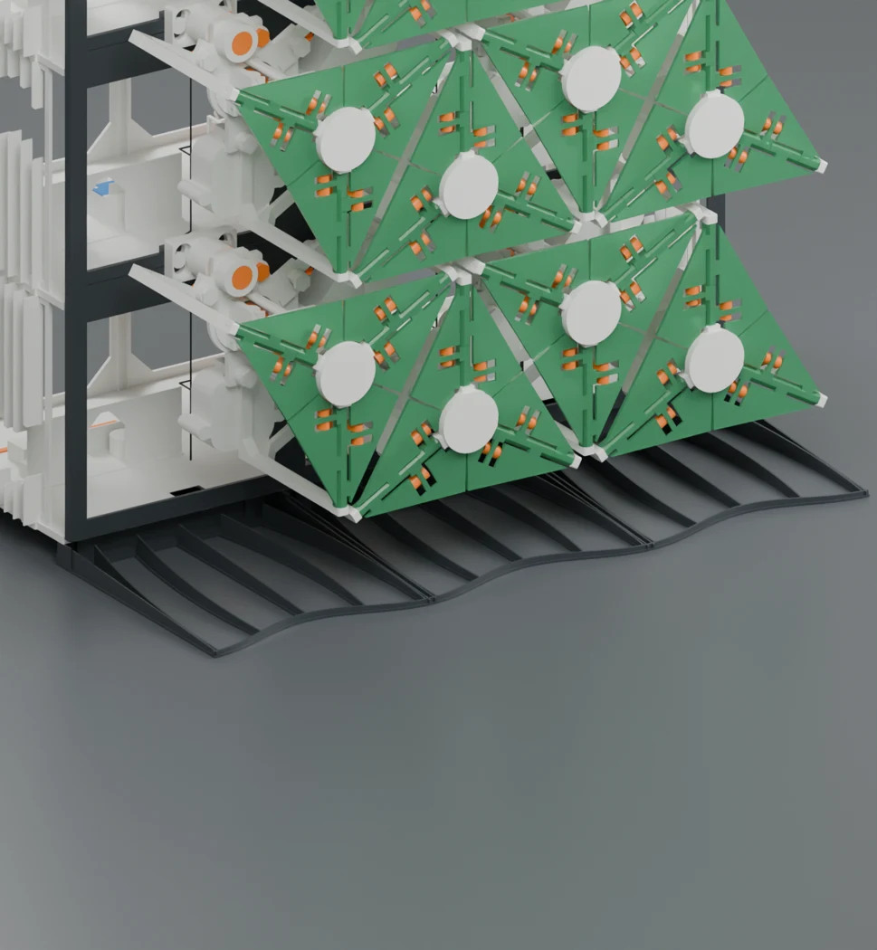
[picture p55: media/views/revisions/_16_compact_accente_07.webp]
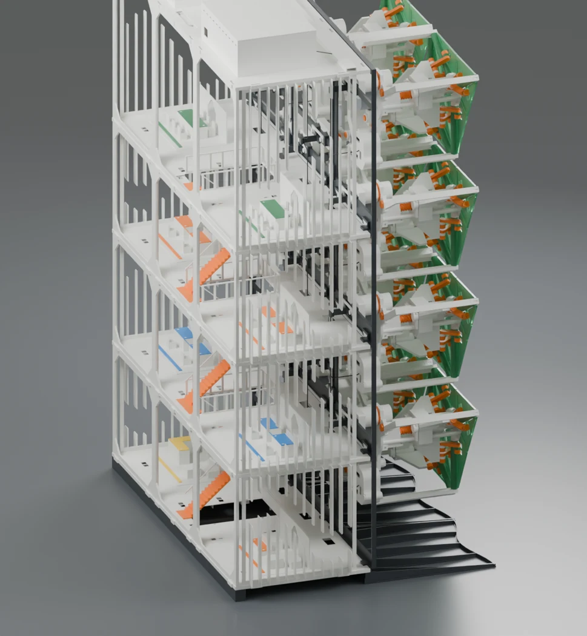
[picture p56: media/views/revisions/_16_compact_accente_08.webp]
|  |  |  |

| Furniture detail | Centred facade |
|---|---|
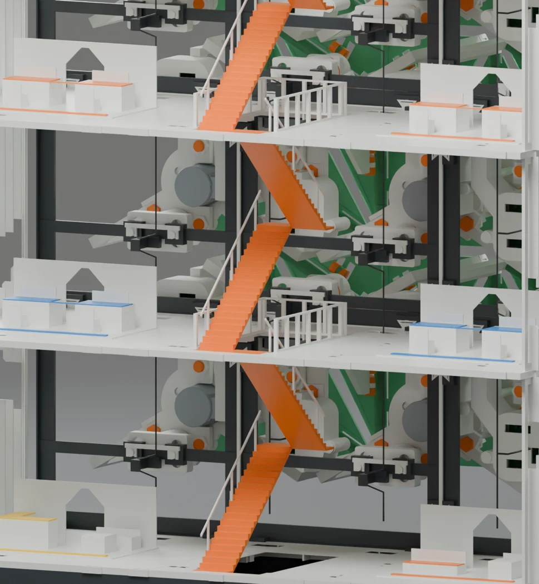
[picture p57: media/views/revisions/_16_compact_accente_09.webp]
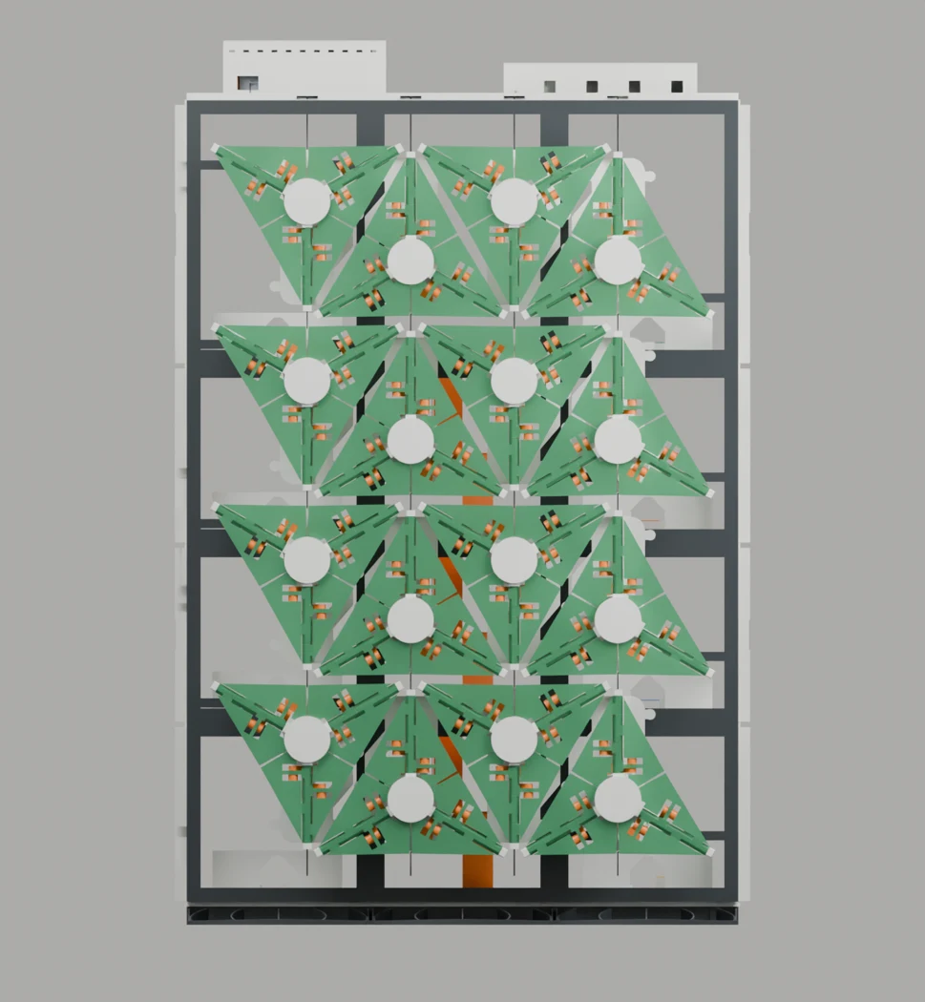
[picture p58: media/views/revisions/_16_compact_accente_10.webp]
|  |  |

## Connector revision

Source: `SOLARSKIN_16_CONECTORI/PLANSE`.

| Closed facade | Open facade | Rear |
|---|---|---|
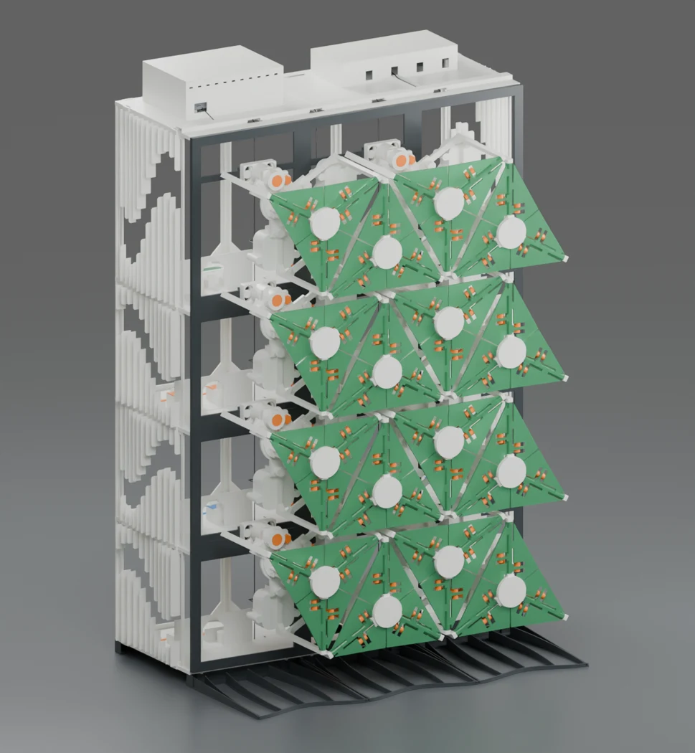
[picture p59: media/views/revisions/_16_conectori_01.webp]
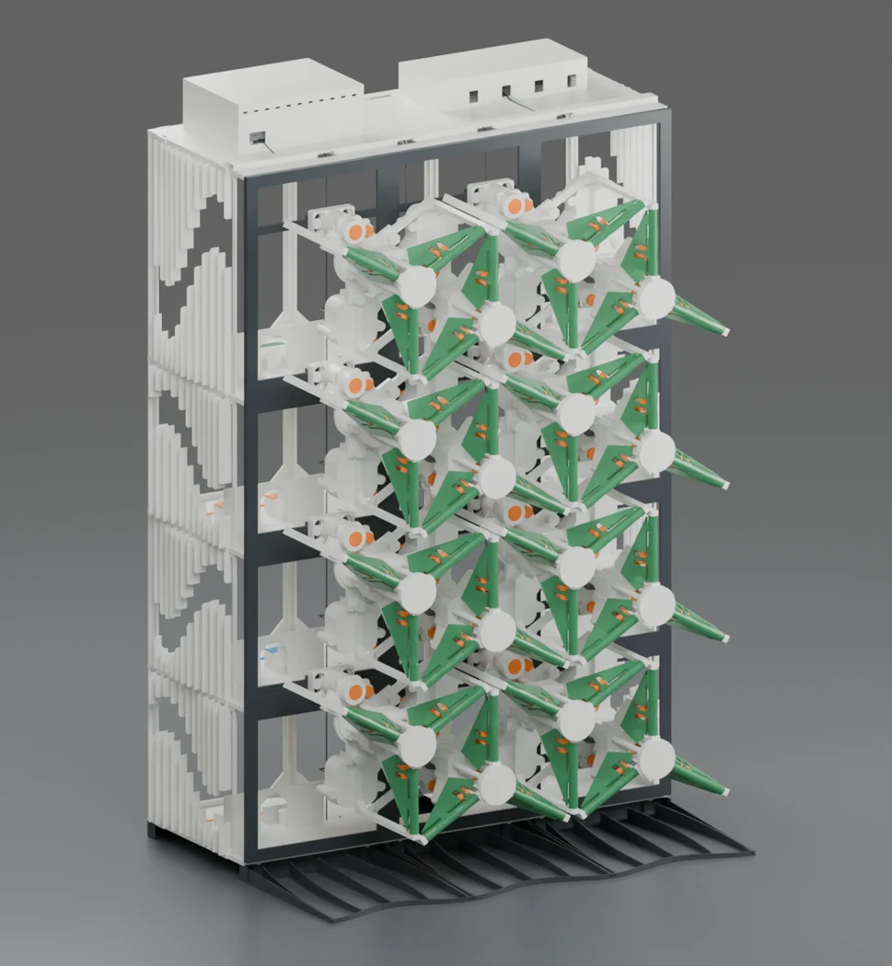
[picture p60: media/views/revisions/_16_conectori_02.webp]
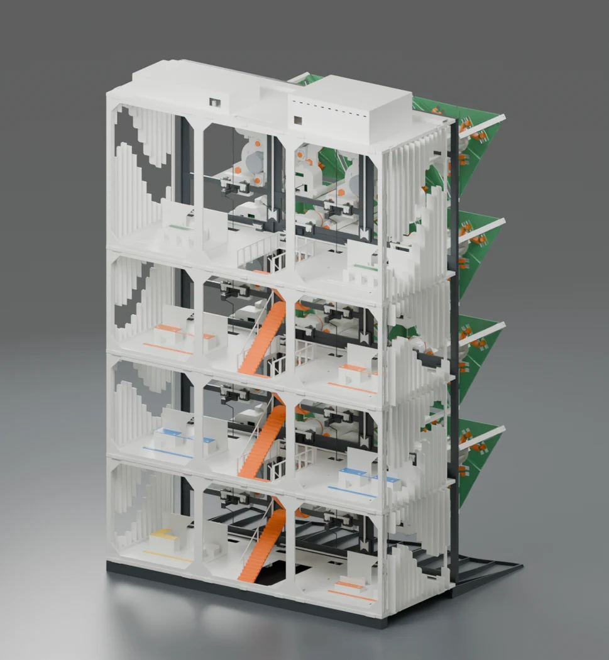
[picture p61: media/views/revisions/_16_conectori_03.webp]
|  |  |  |

| Stair and interior | Floor print orientation | Facade subassembly from behind |
|---|---|---|
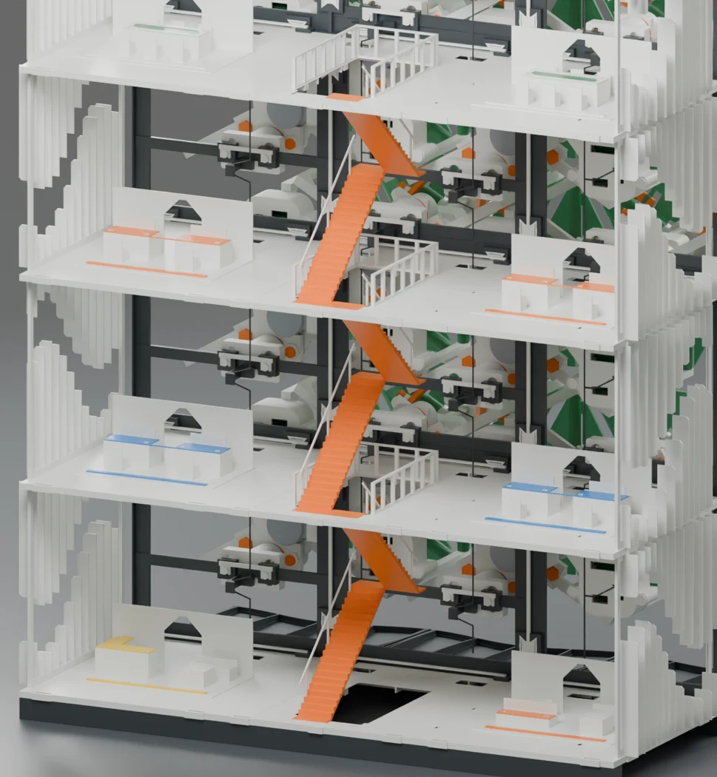
[picture p62: media/views/revisions/_16_conectori_04.webp]
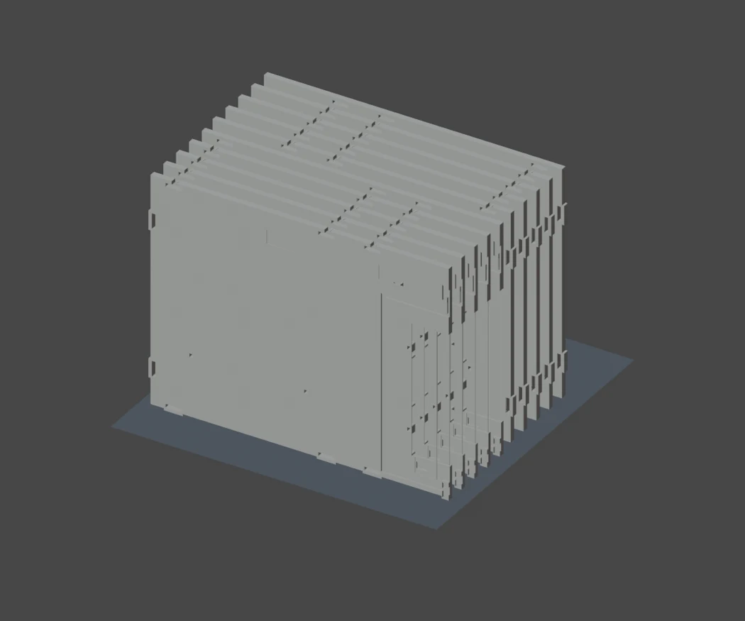
[picture p63: media/views/revisions/_16_conectori_05.webp]
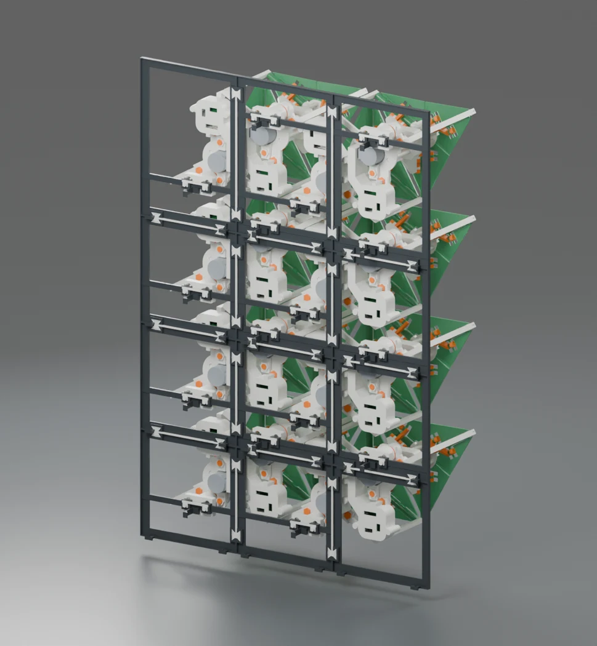
[picture p64: media/views/revisions/_16_conectori_06.webp]
|  |  |  |

| Ribbed base | Side fins | Furniture detail |
|---|---|---|
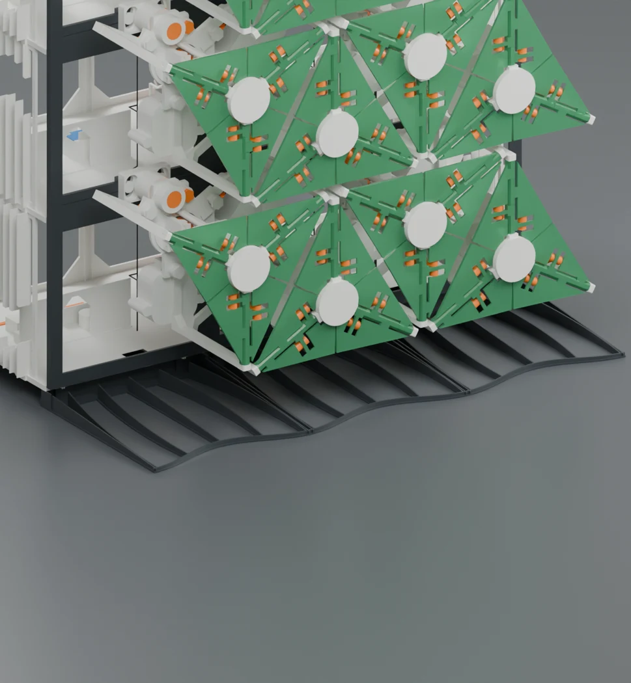
[picture p65: media/views/revisions/_16_conectori_07.webp]
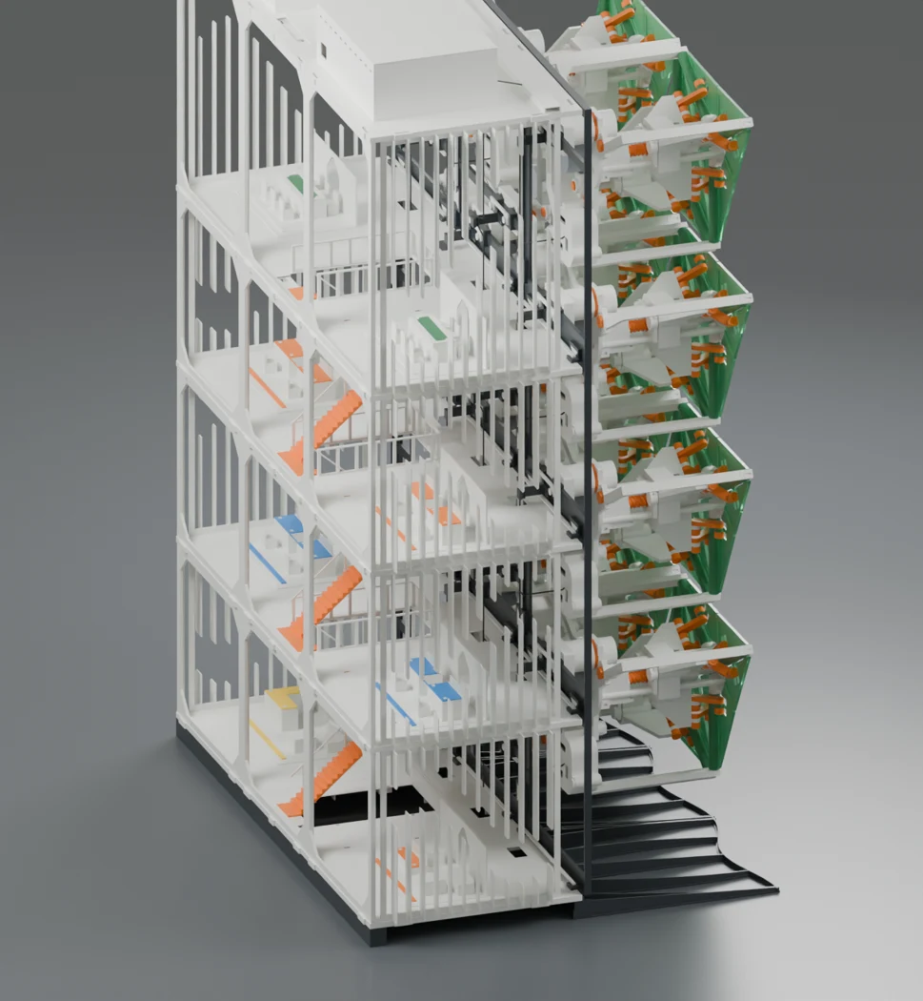
[picture p66: media/views/revisions/_16_conectori_08.webp]
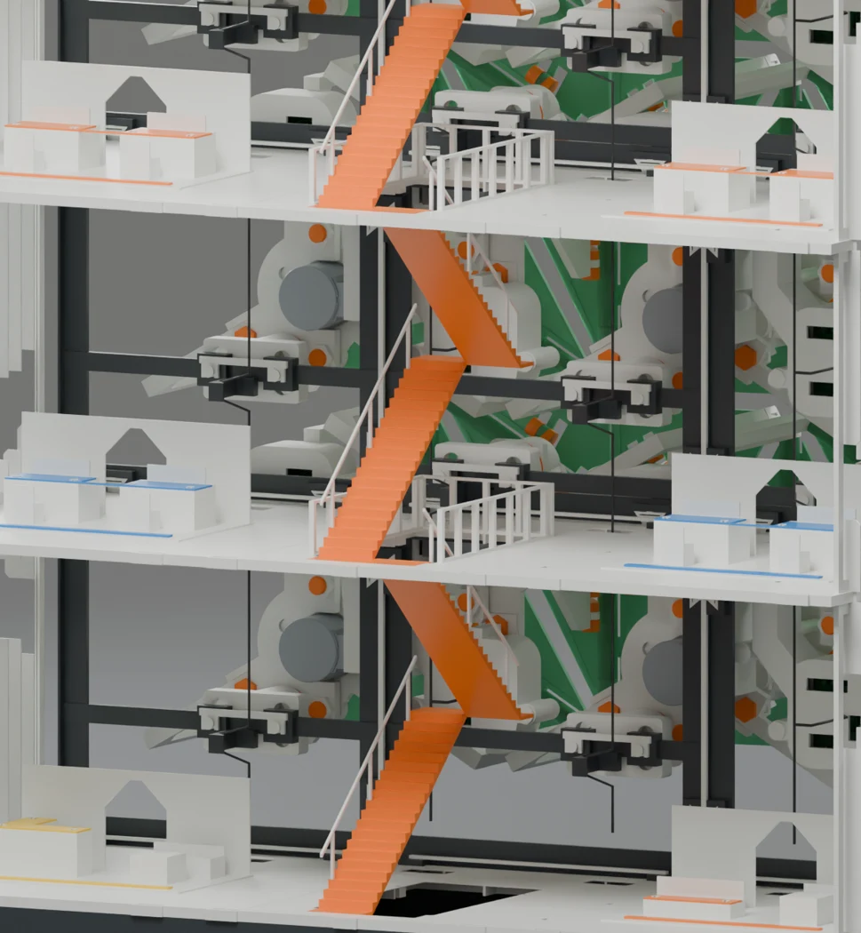
[picture p67: media/views/revisions/_16_conectori_09.webp]
|  |  |  |

| Centred facade | Accent assembly |
|---|---|
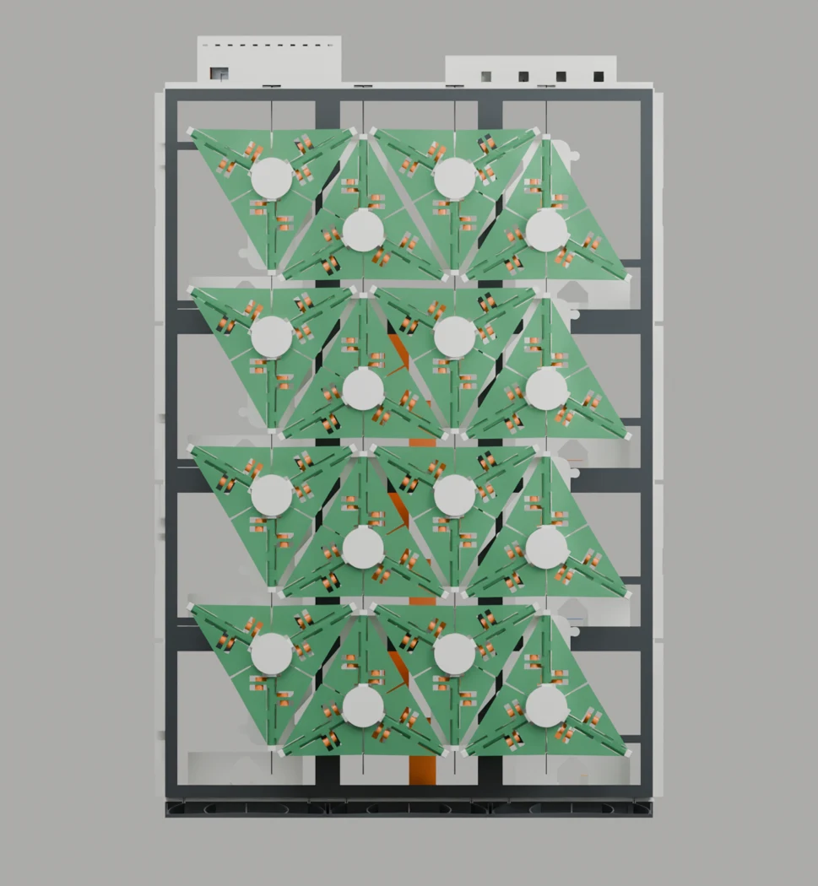
[picture p68: media/views/revisions/_16_conectori_10.webp]
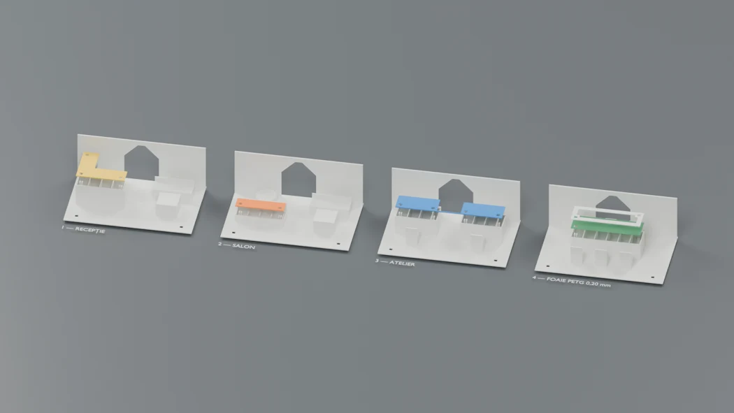
[picture p69: media/views/revisions/_16_conectori_11.webp]
|  |  |

## Unified facade

Source: `SOLARSKIN_16_FATADA_UNITARA/PLANSE`.

| Closed facade | Open facade | Rear |
|---|---|---|
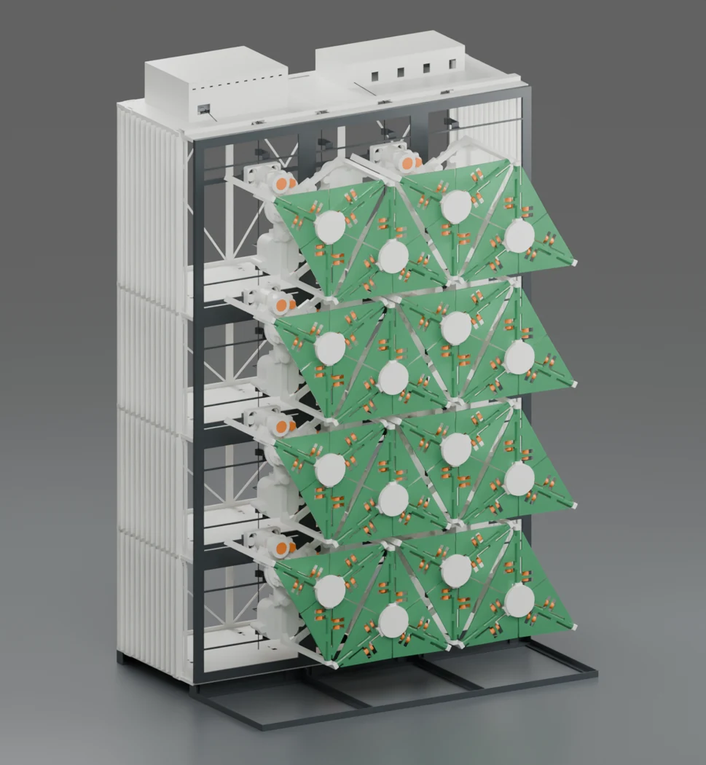
[picture p70: media/views/revisions/_16_fatada_unitara_01.webp]
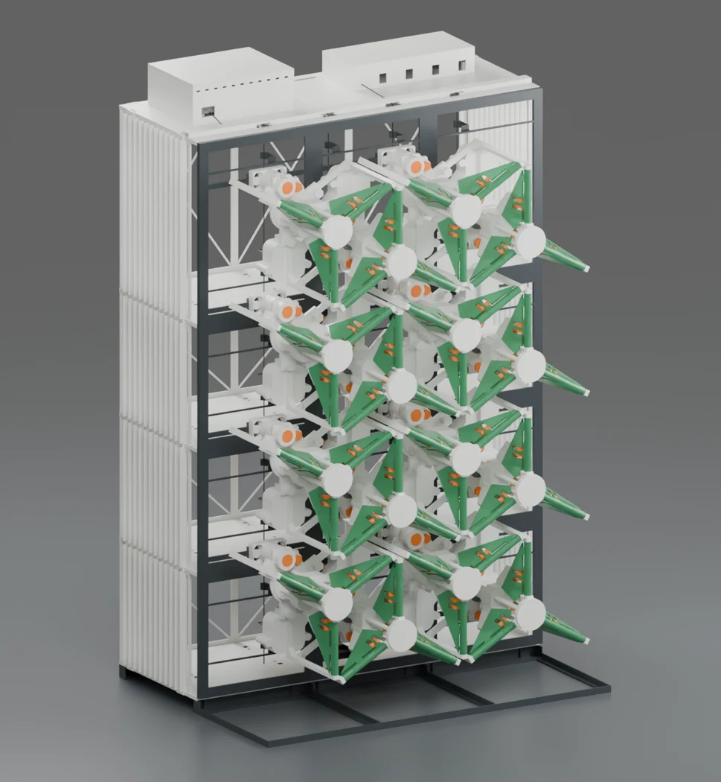
[picture p71: media/views/revisions/_16_fatada_unitara_02.webp]
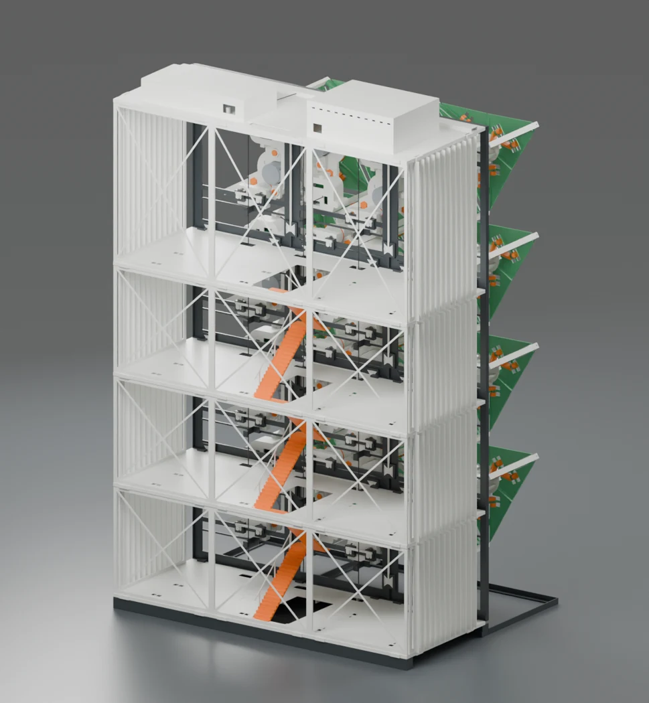
[picture p72: media/views/revisions/_16_fatada_unitara_03.webp]
|  |  |  |

| Stair and interior | Floor print orientation | Facade subassembly from behind |
|---|---|---|
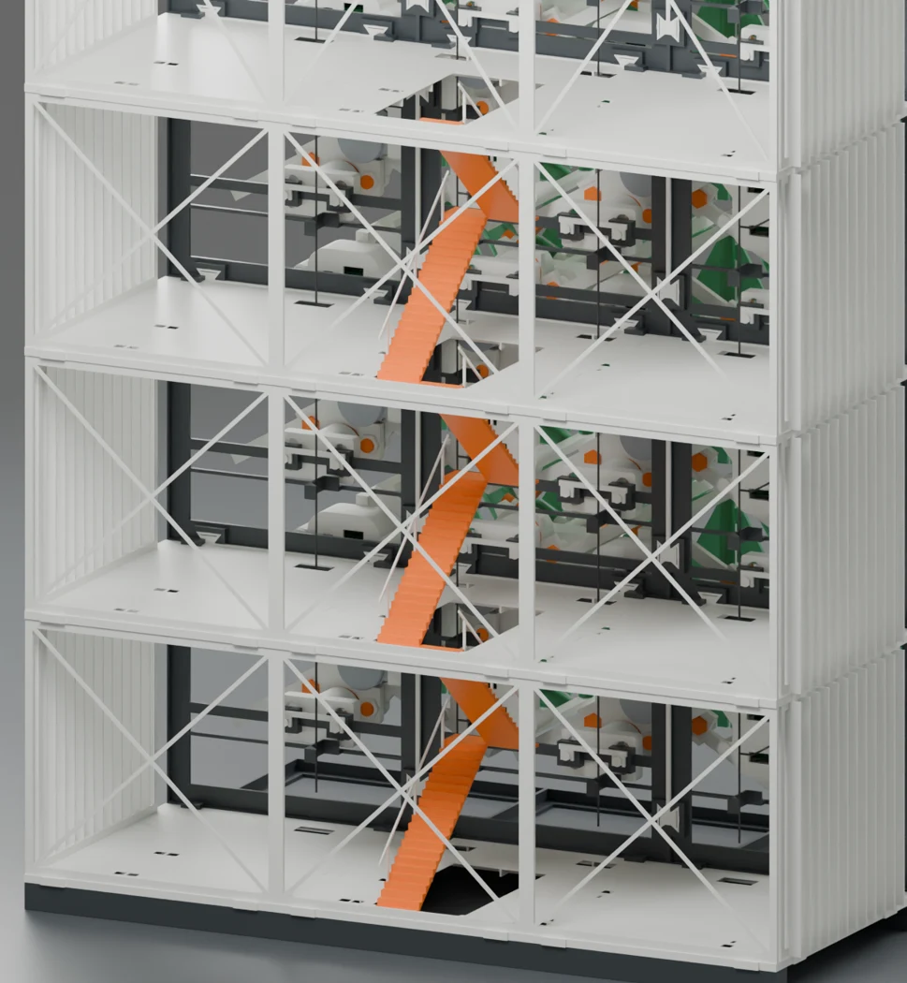
[picture p73: media/views/revisions/_16_fatada_unitara_04.webp]
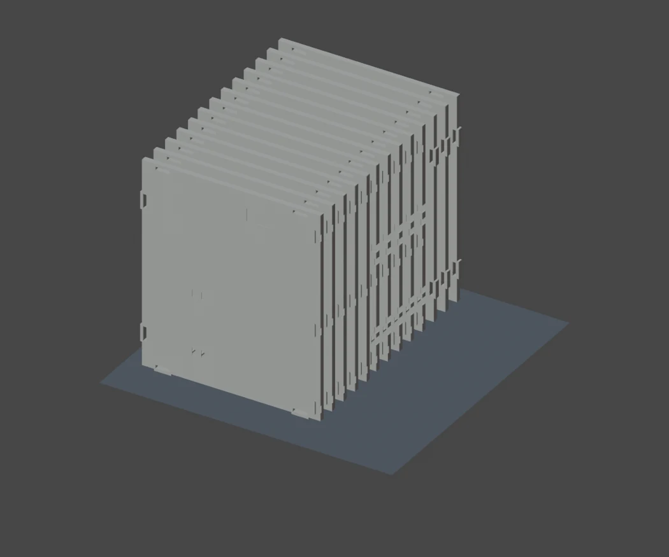
[picture p74: media/views/revisions/_16_fatada_unitara_05.webp]
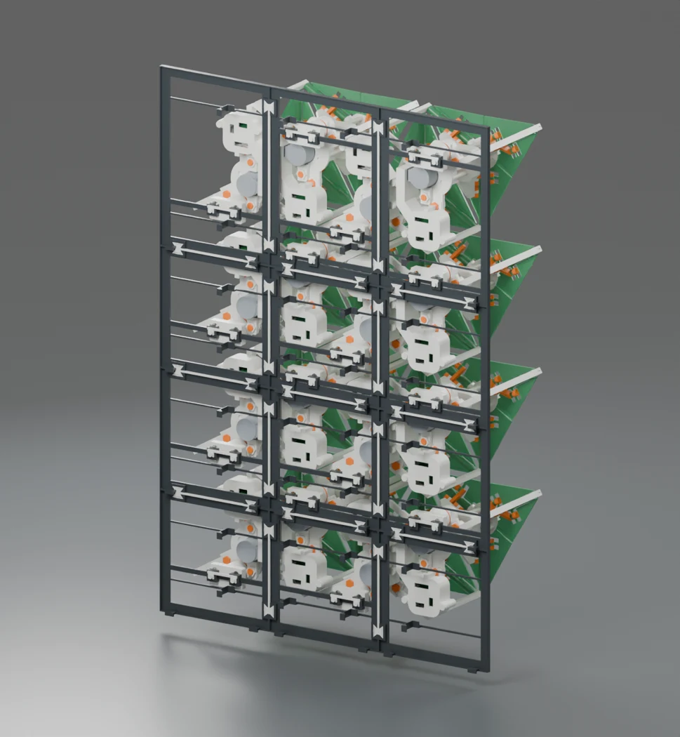
[picture p75: media/views/revisions/_16_fatada_unitara_06.webp]
|  |  |  |

## Threaded mounting revision

Source: `SOLARSKIN_16_FILET_PRIORITAR/PLANSE`.

| Closed facade | Open facade | Rear |
|---|---|---|
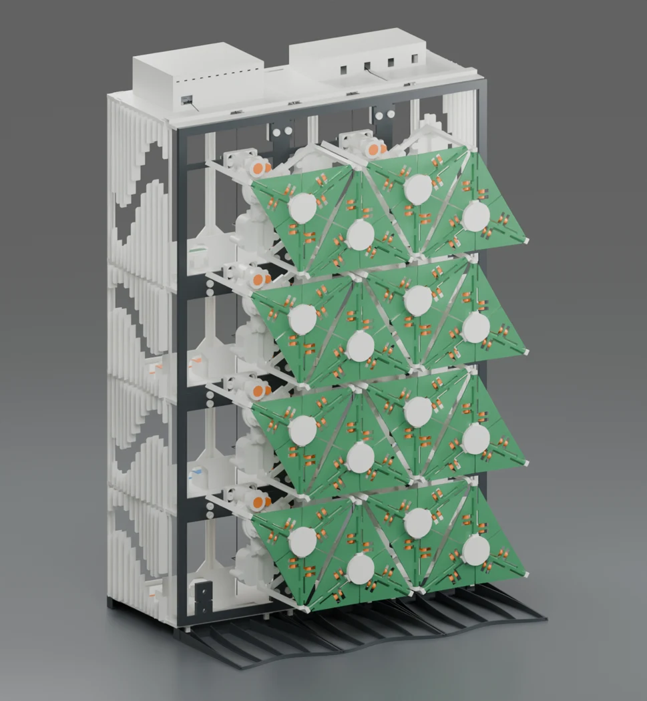
[picture p76: media/views/revisions/_16_filet_prioritar_01.webp]
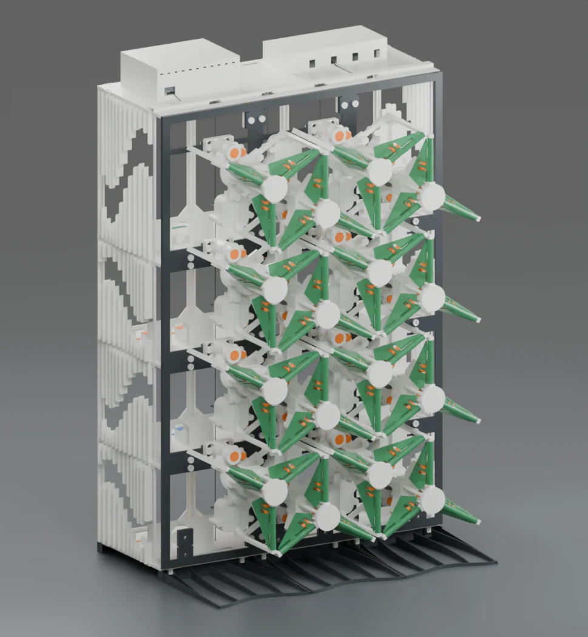
[picture p77: media/views/revisions/_16_filet_prioritar_02.webp]
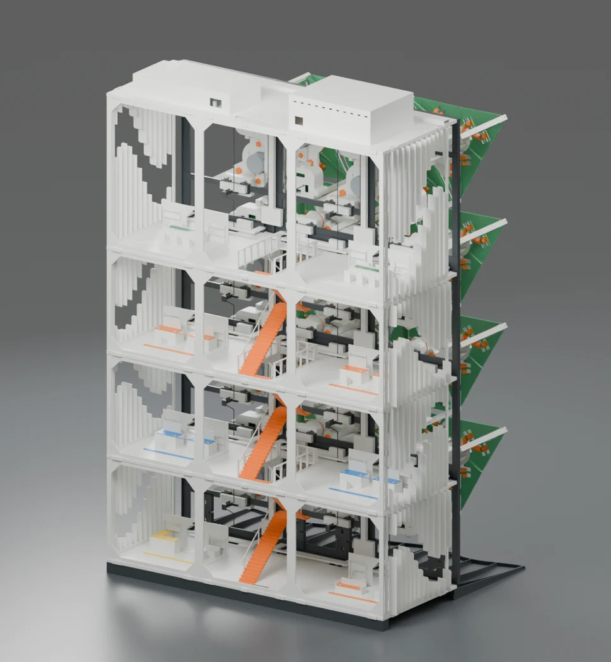
[picture p78: media/views/revisions/_16_filet_prioritar_03.webp]
|  |  |  |

| Stair and interior | Ribbed base | Side fins |
|---|---|---|
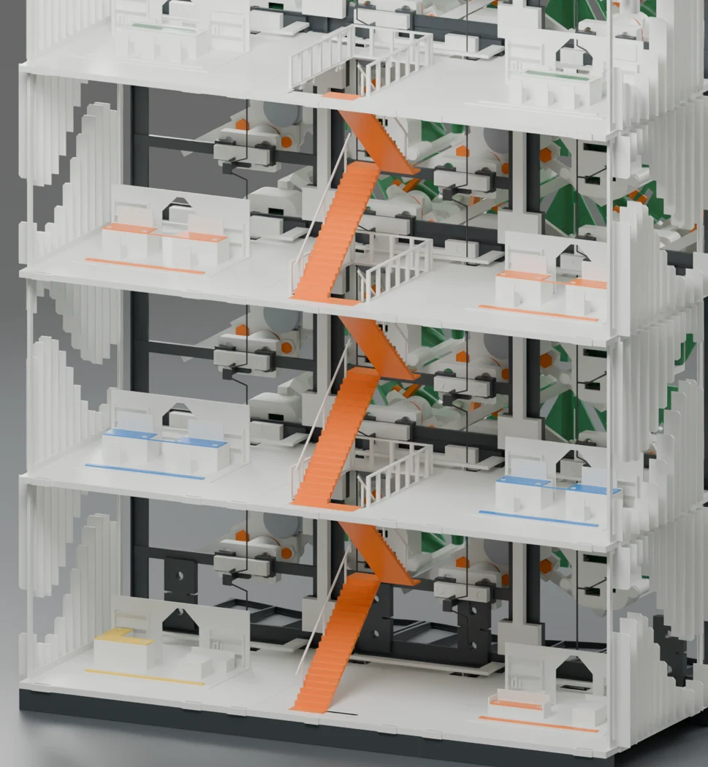
[picture p79: media/views/revisions/_16_filet_prioritar_04.webp]
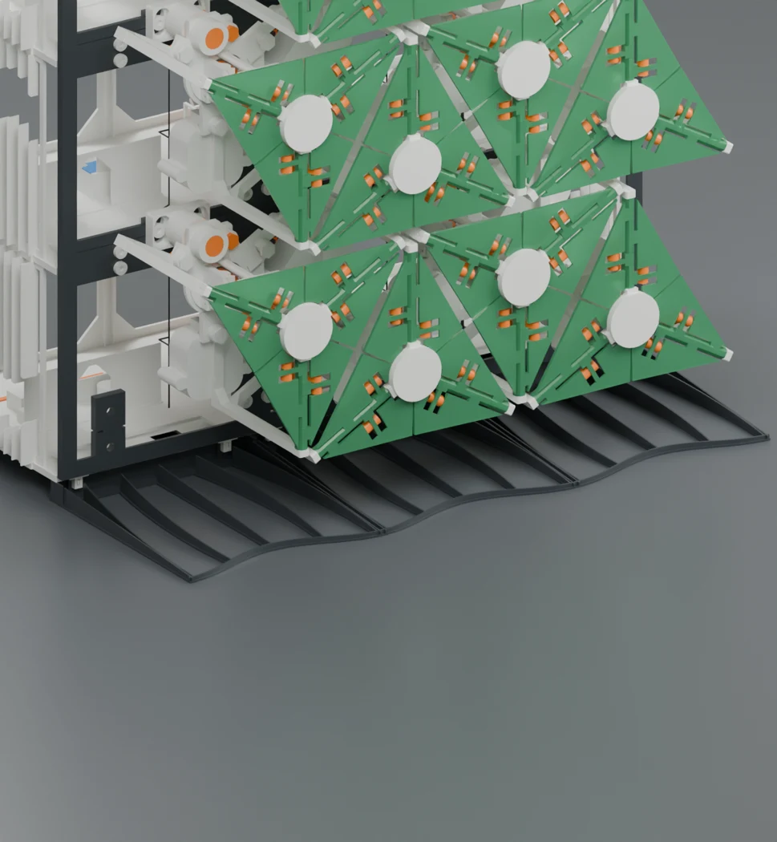
[picture p80: media/views/revisions/_16_filet_prioritar_07.webp]
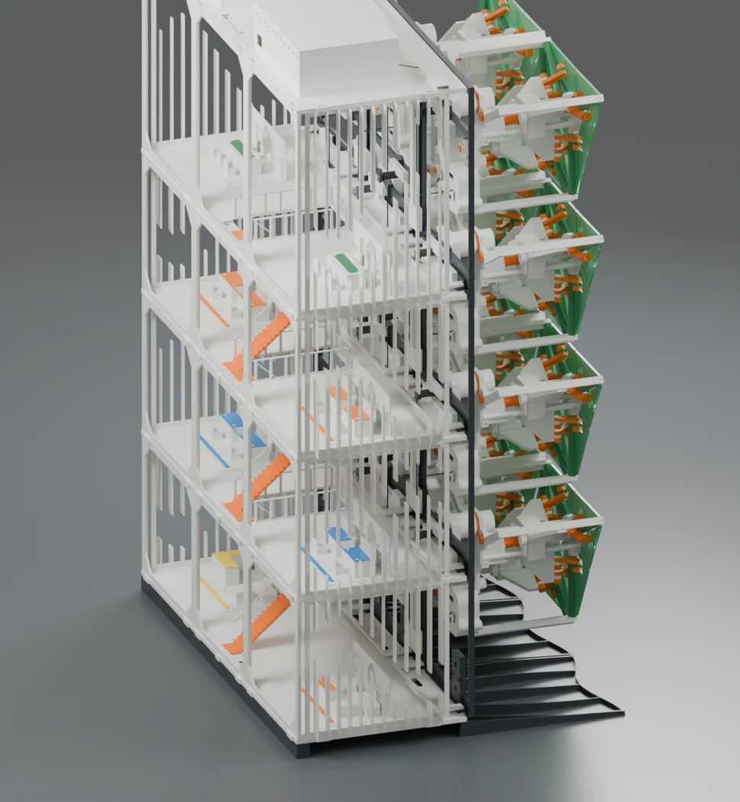
[picture p81: media/views/revisions/_16_filet_prioritar_08.webp]
|  |  |  |

| Furniture detail | Centred facade | Independent facade |
|---|---|---|
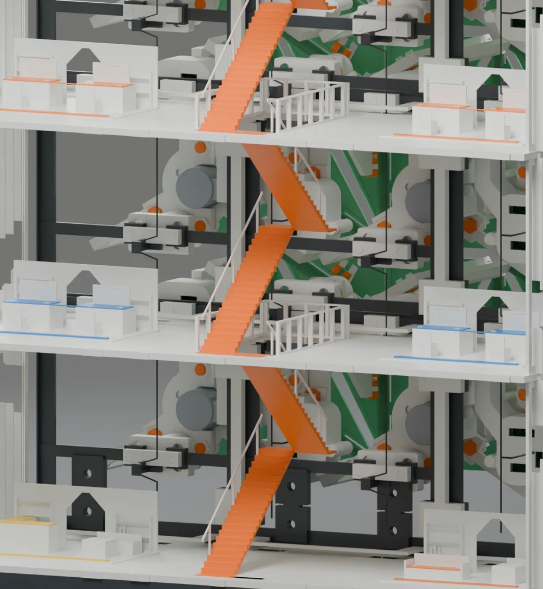
[picture p82: media/views/revisions/_16_filet_prioritar_09.webp]
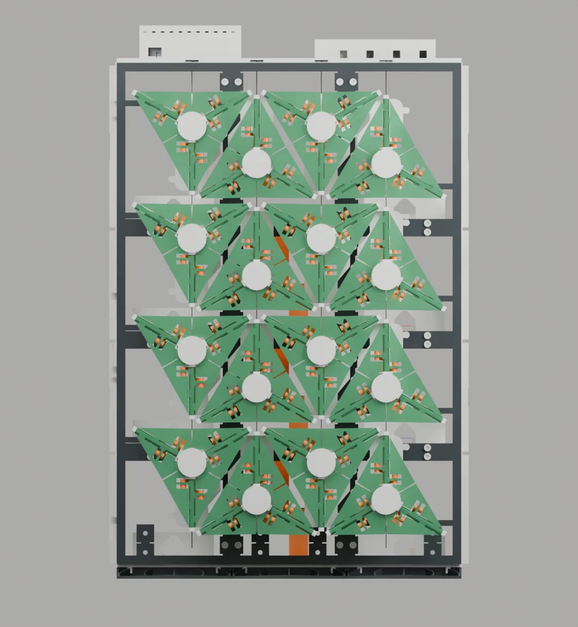
[picture p83: media/views/revisions/_16_filet_prioritar_10.webp]
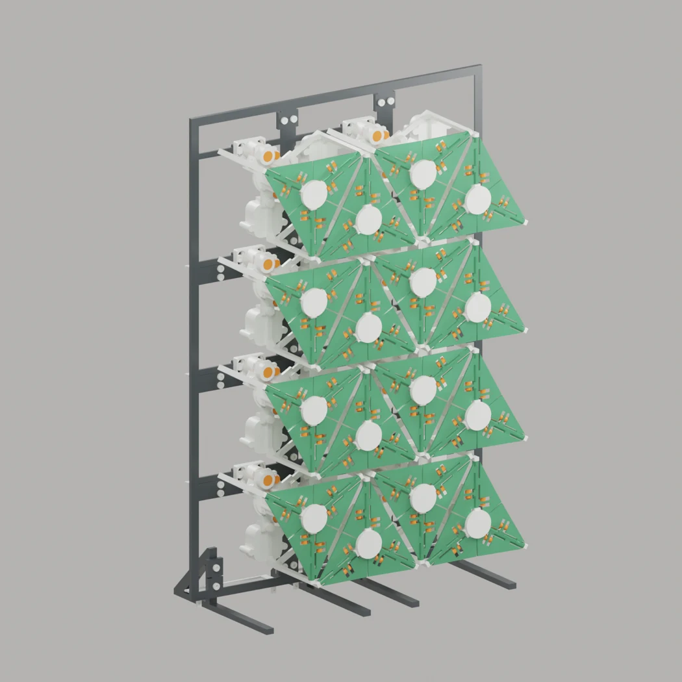
[picture p84: media/views/revisions/_16_filet_prioritar_11.webp]
Independent facade
|  |  |  |

| Thread detail |
|---|
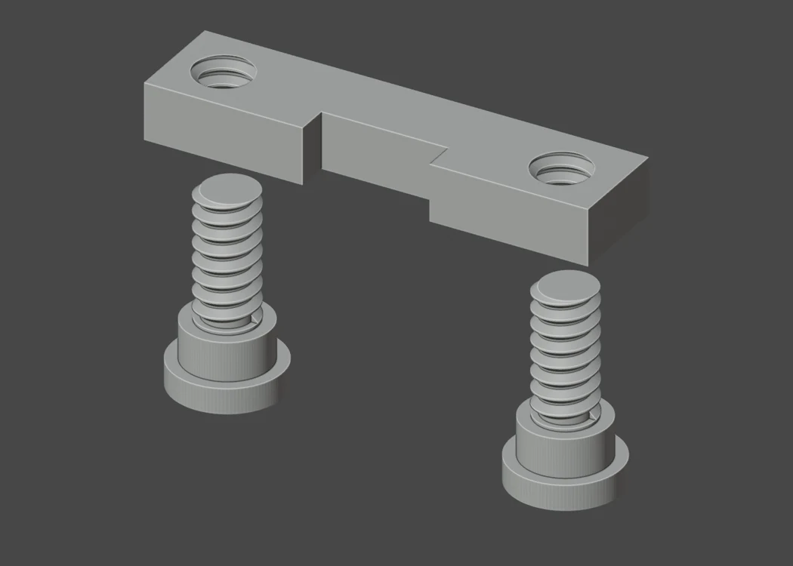
[picture p85: media/views/revisions/_16_filet_prioritar_12.webp]
Thread detail
|  |

## Engraved parts

Source: `SOLARSKIN_16_GRAVATE/PLANSE`.

| Closed facade | Open facade | Rear |
|---|---|---|
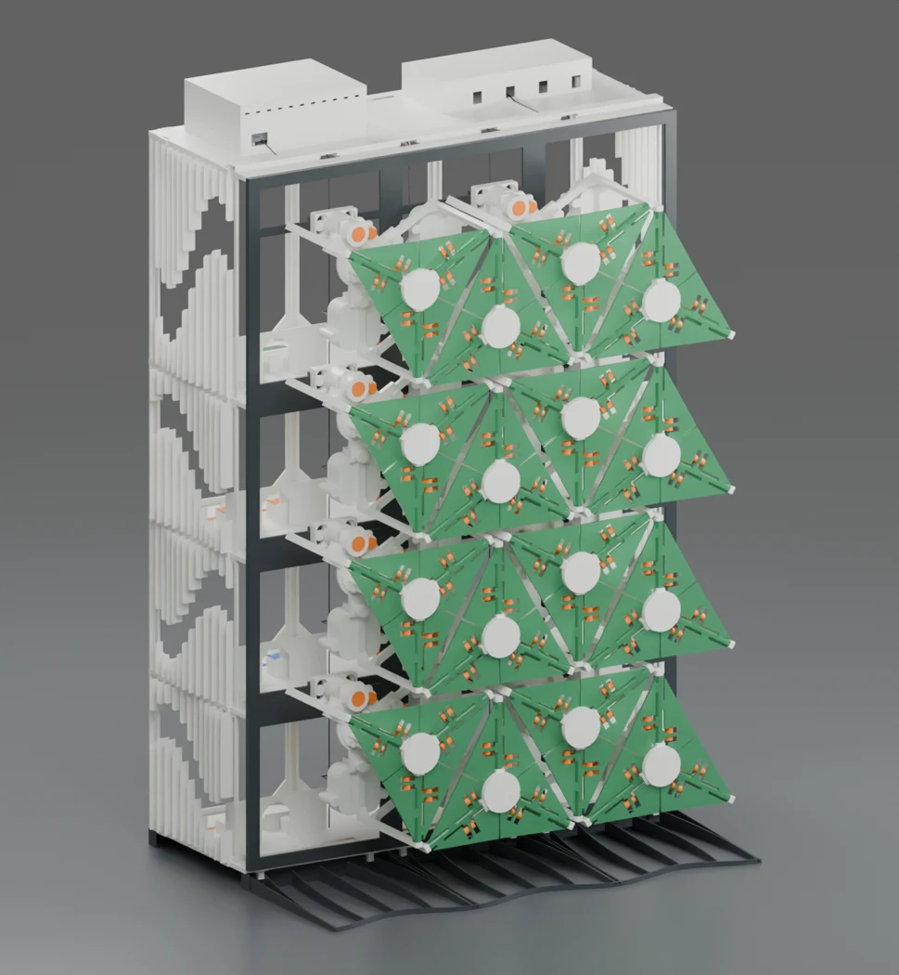
[picture p86: media/views/revisions/_16_gravate_01.webp]
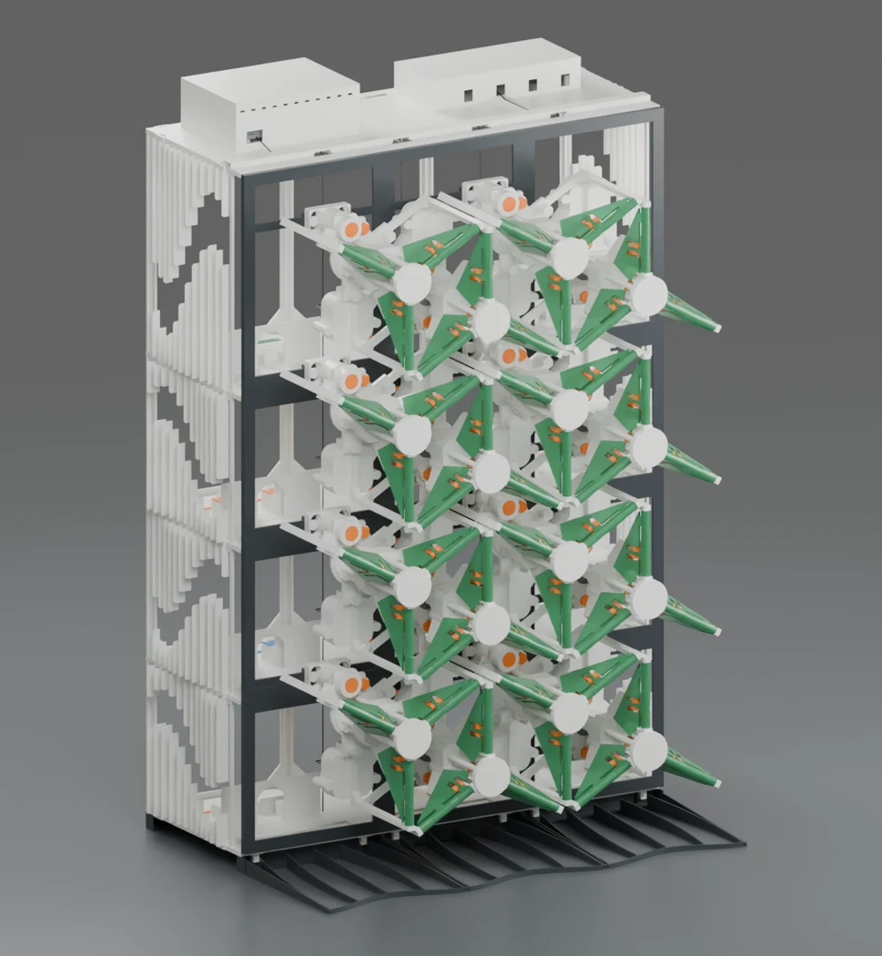
[picture p87: media/views/revisions/_16_gravate_02.webp]
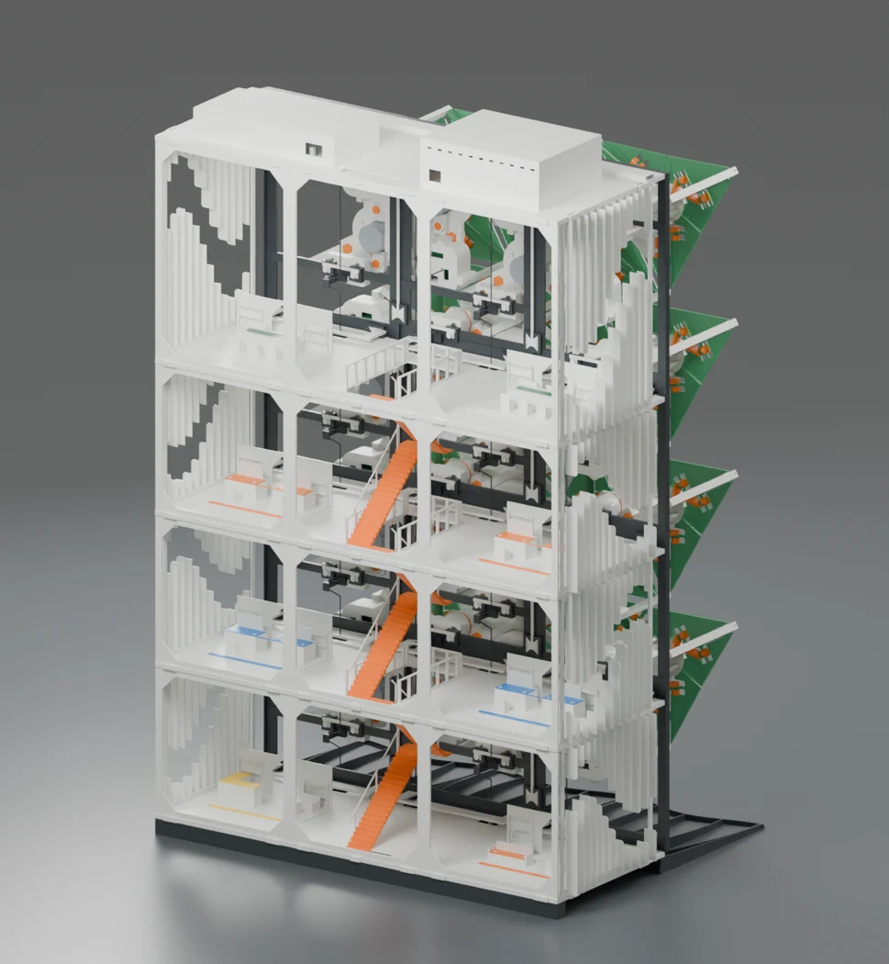
[picture p88: media/views/revisions/_16_gravate_03.webp]
|  |  |  |

| Stair and interior | Floor print orientation | Facade subassembly from behind |
|---|---|---|
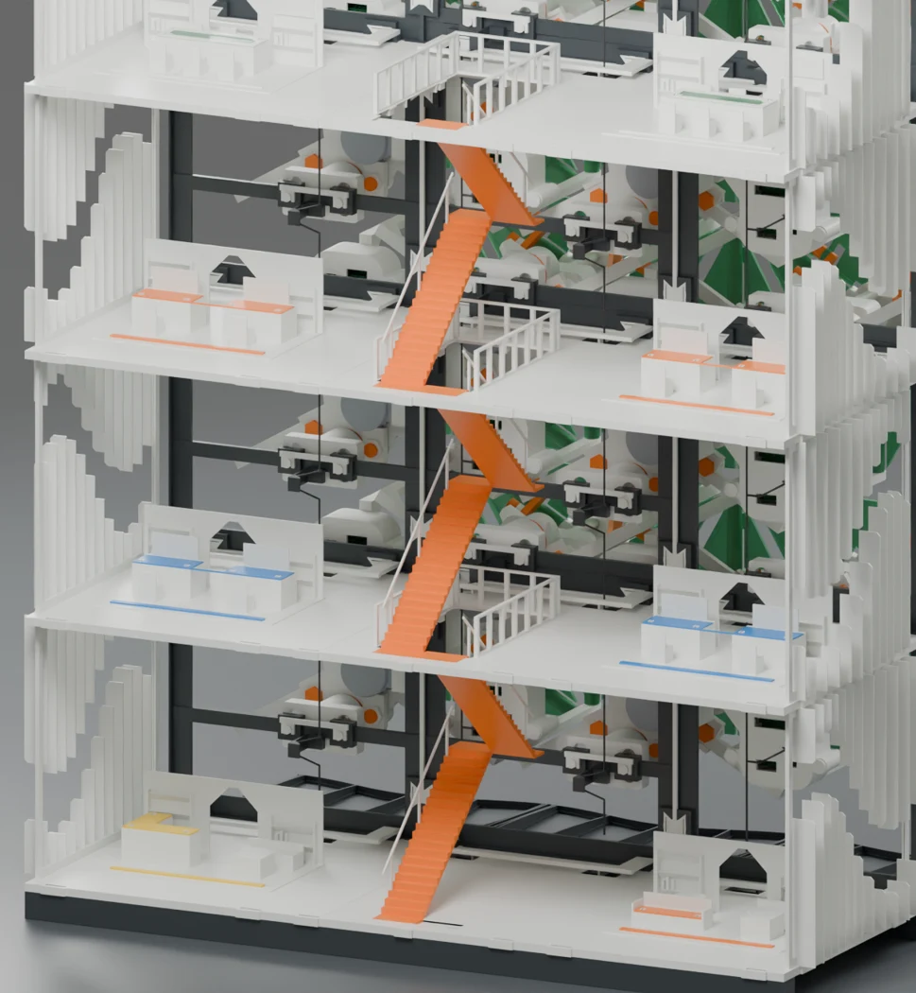
[picture p89: media/views/revisions/_16_gravate_04.webp]
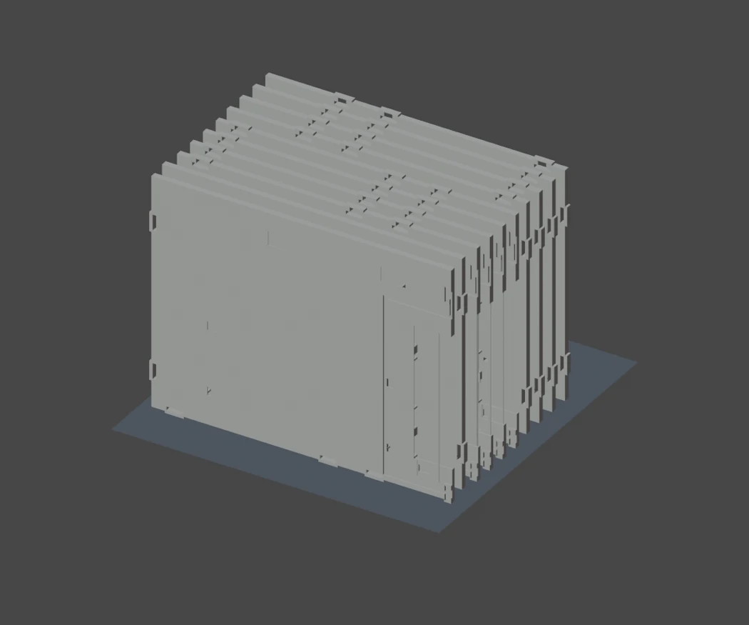
[picture p90: media/views/revisions/_16_gravate_05.webp]
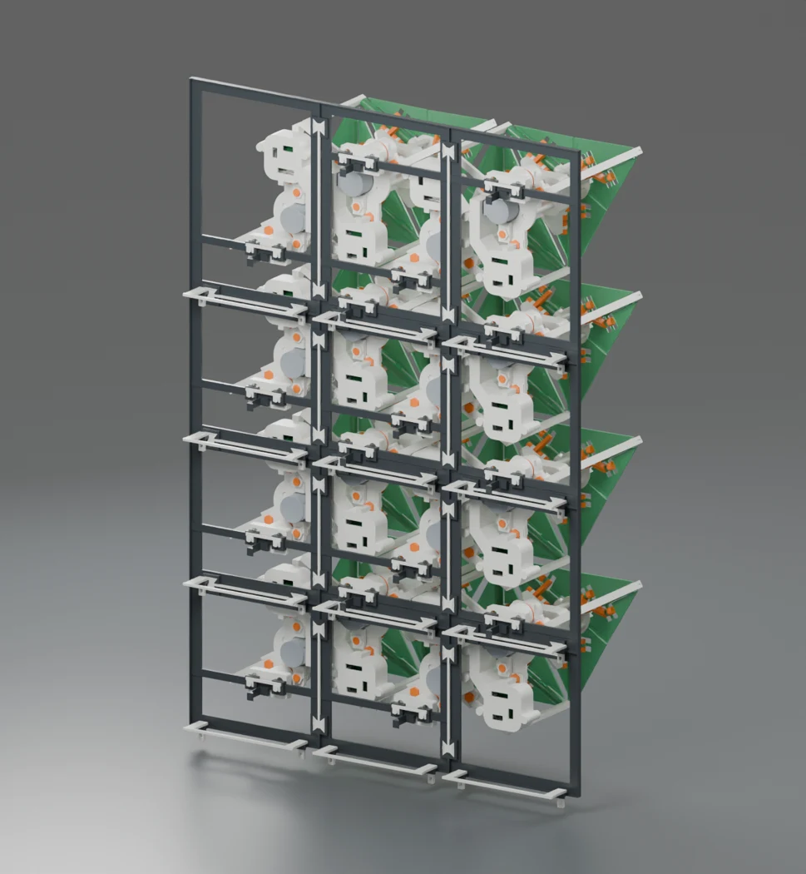
[picture p91: media/views/revisions/_16_gravate_06.webp]
|  |  |  |

| Ribbed base | Side fins | Furniture detail |
|---|---|---|
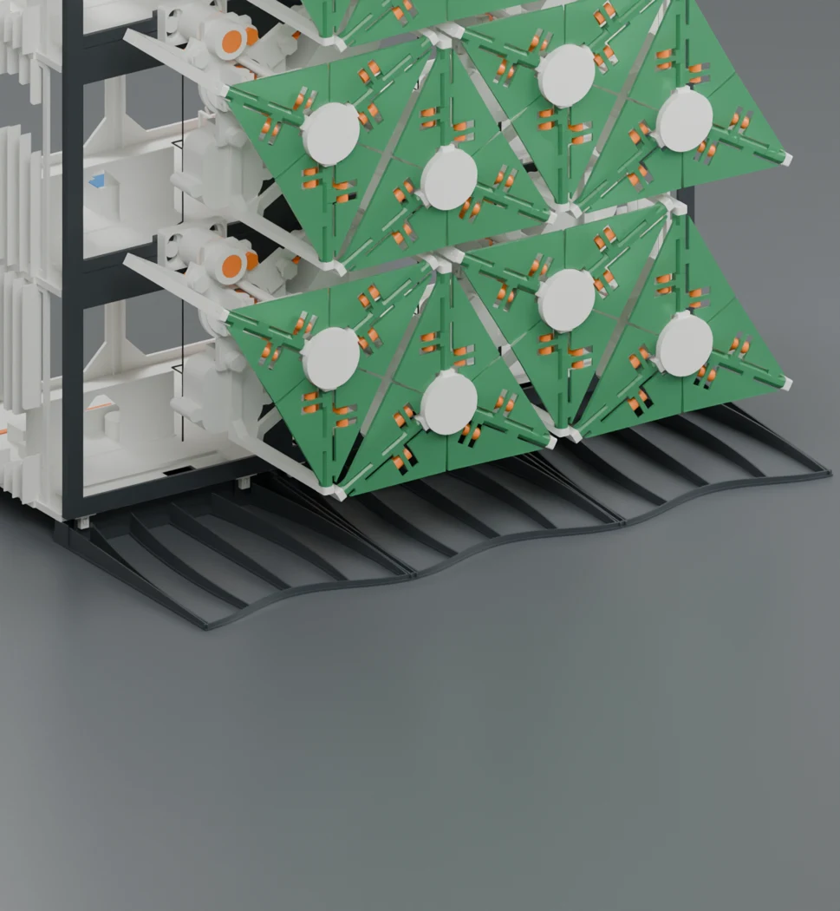
[picture p92: media/views/revisions/_16_gravate_07.webp]
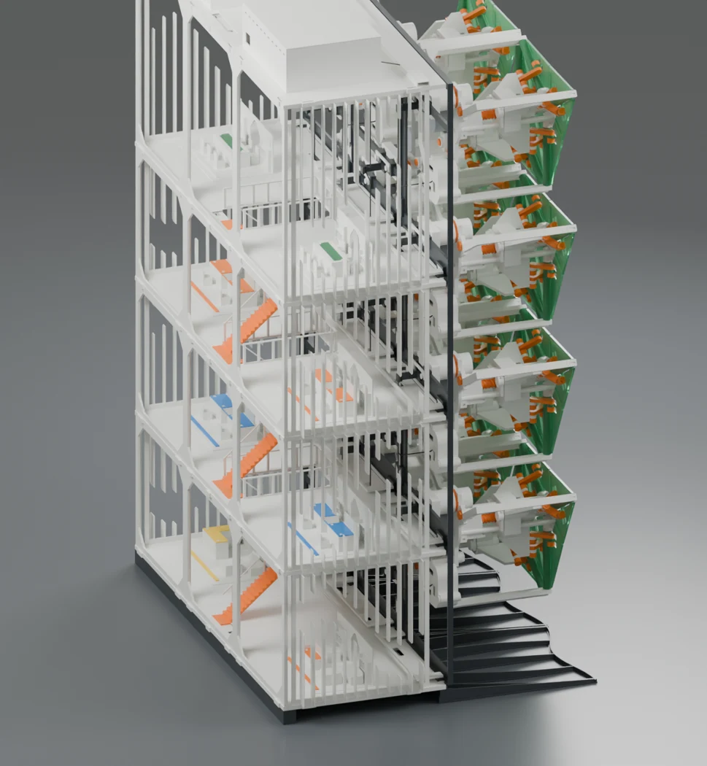
[picture p93: media/views/revisions/_16_gravate_08.webp]
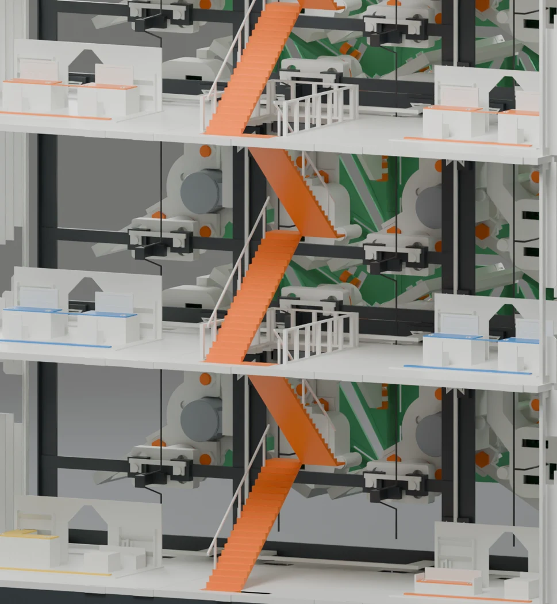
[picture p94: media/views/revisions/_16_gravate_09.webp]
|  |  |  |

| Centred facade | Accent assembly | Captive mount |
|---|---|---|
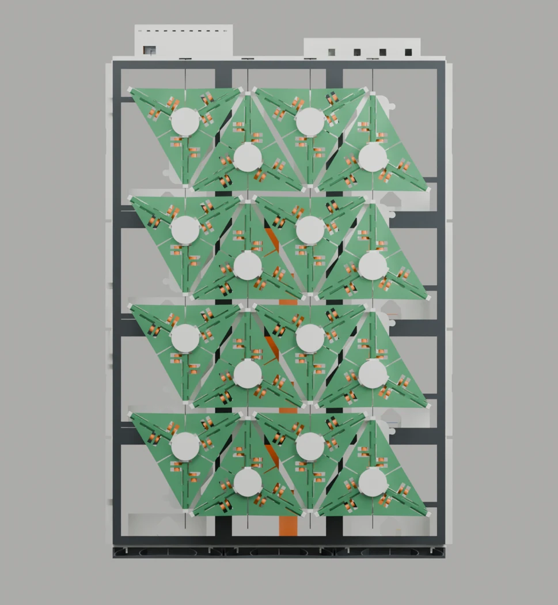
[picture p95: media/views/revisions/_16_gravate_10.webp]
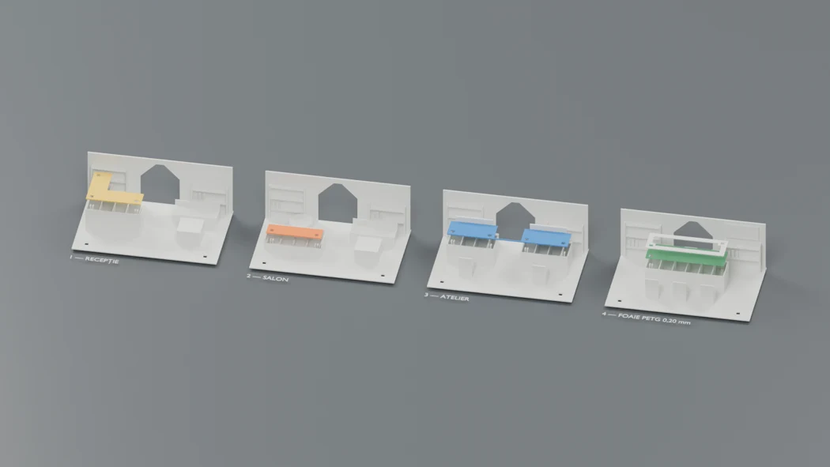
[picture p96: media/views/revisions/_16_gravate_11.webp]
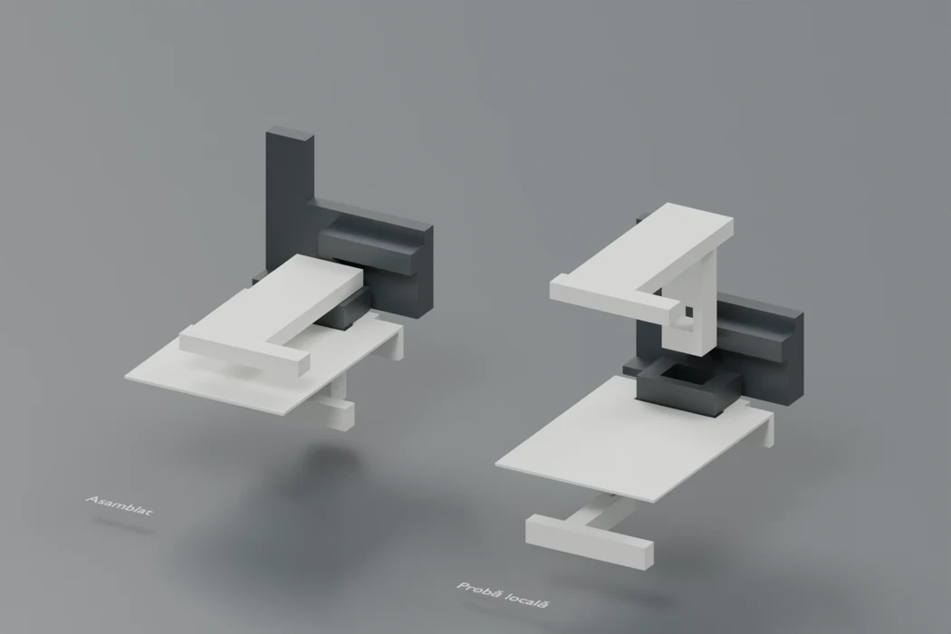
[picture p97: media/views/revisions/_16_gravate_12.webp]
Captive mount
|  |  |  |

## Integrated facade

Source: `SOLARSKIN_16_INTEGRAT/PLANSE`.

| Closed facade | Open facade | Front elevation |
|---|---|---|
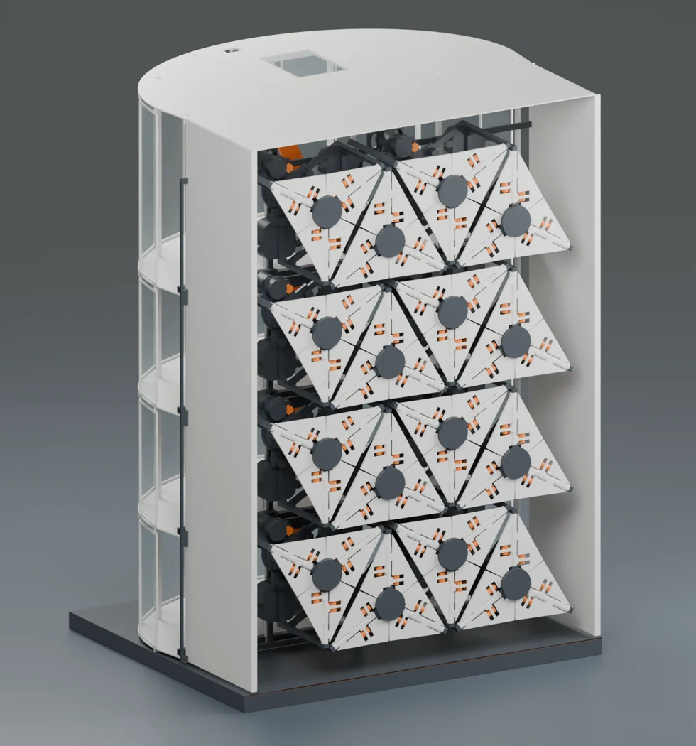
[picture p98: media/views/revisions/_16_integrat_01.webp]
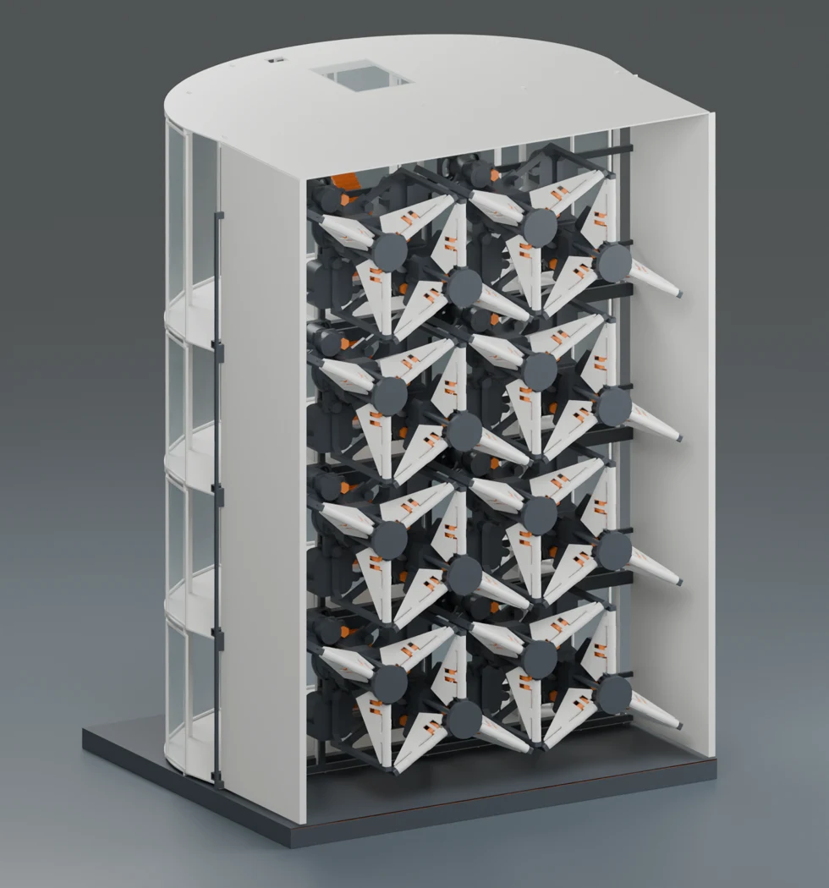
[picture p99: media/views/revisions/_16_integrat_02.webp]
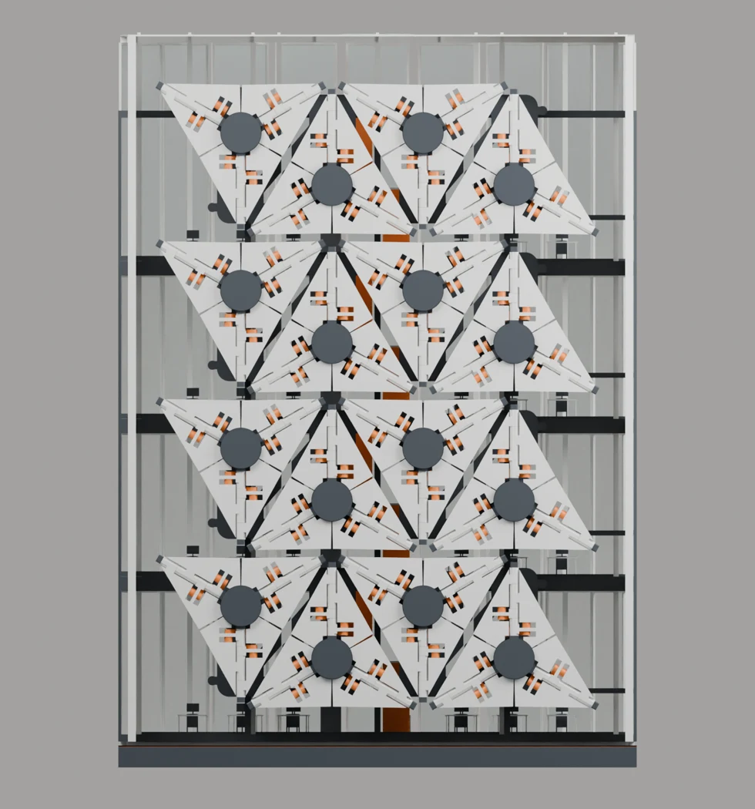
[picture p100: media/views/revisions/_16_integrat_03.webp]
Front elevation
|  |  |  |

| Office interior |
|---|
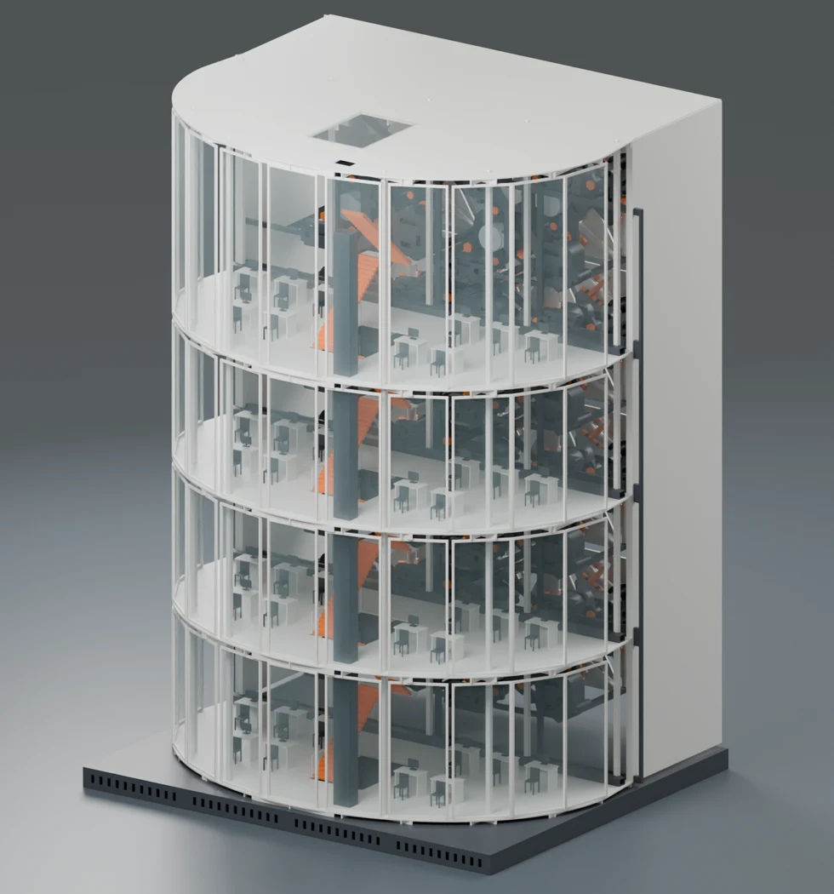
[picture p101: media/views/revisions/_16_integrat_04.webp]
Office interior
|  |

## Furnished office

Source: `SOLARSKIN_16_INTERIOR_COMPLET/PLANSE`.

| Closed facade | Open facade | Rear |
|---|---|---|
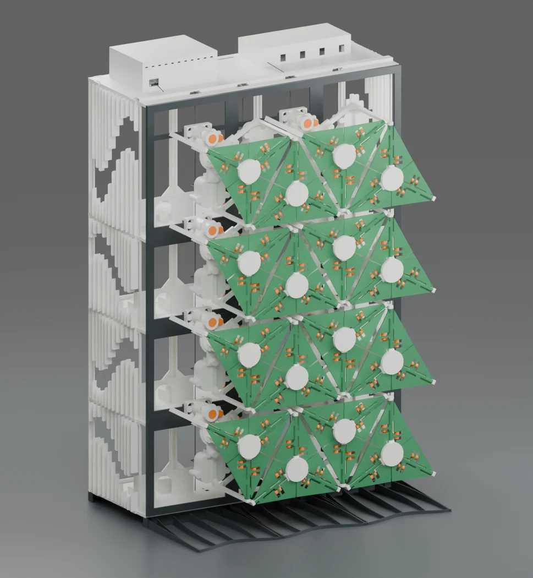
[picture p102: media/views/revisions/_16_interior_complet_01.webp]
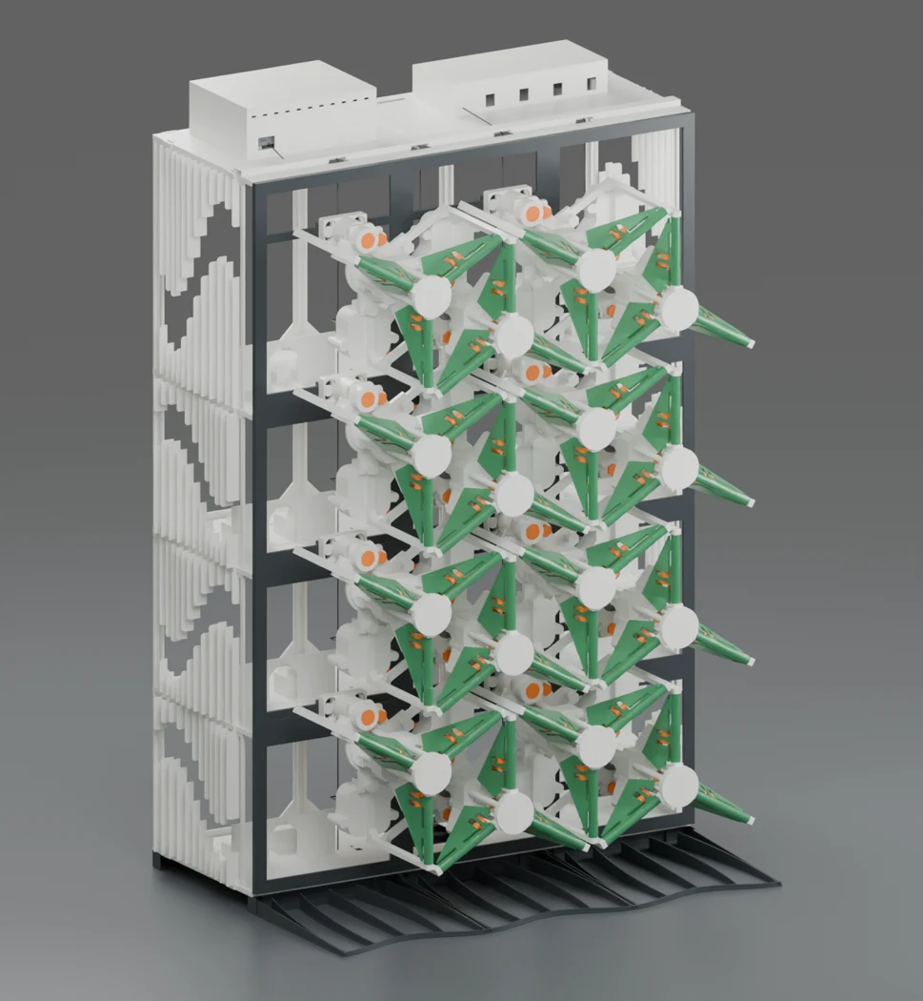
[picture p103: media/views/revisions/_16_interior_complet_02.webp]
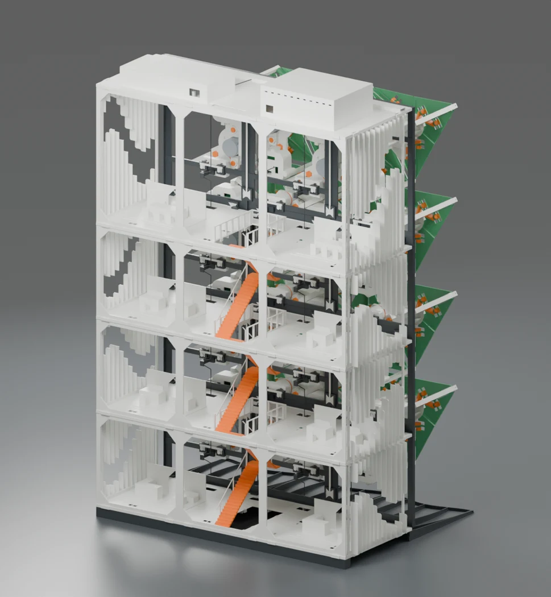
[picture p104: media/views/revisions/_16_interior_complet_03.webp]
|  |  |  |

| Stair and interior | Floor print orientation | Facade subassembly from behind |
|---|---|---|
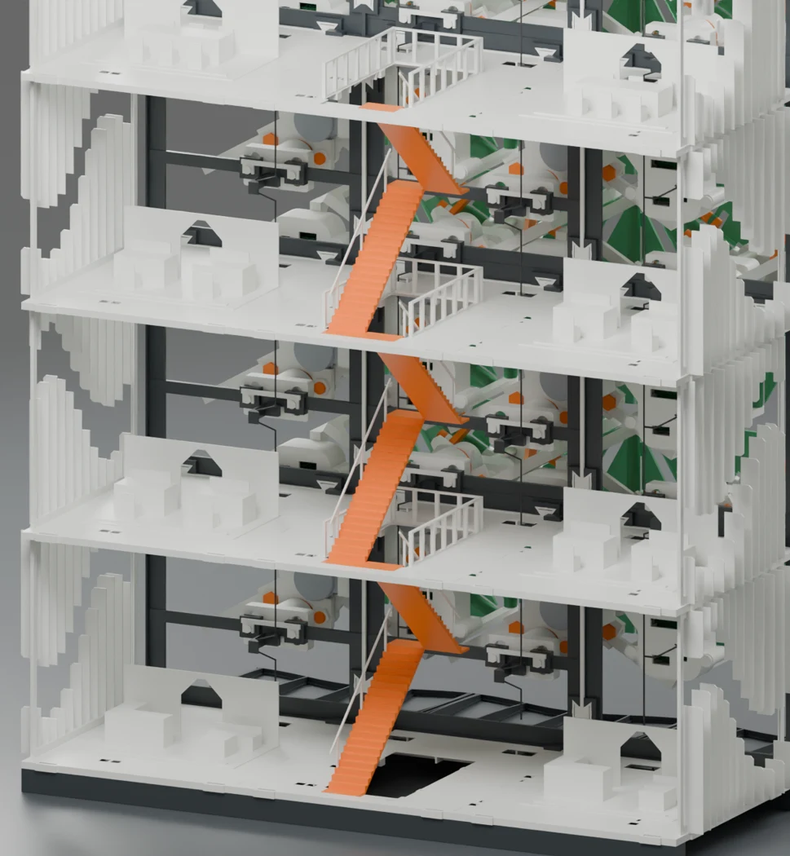
[picture p105: media/views/revisions/_16_interior_complet_04.webp]
Stair and interior
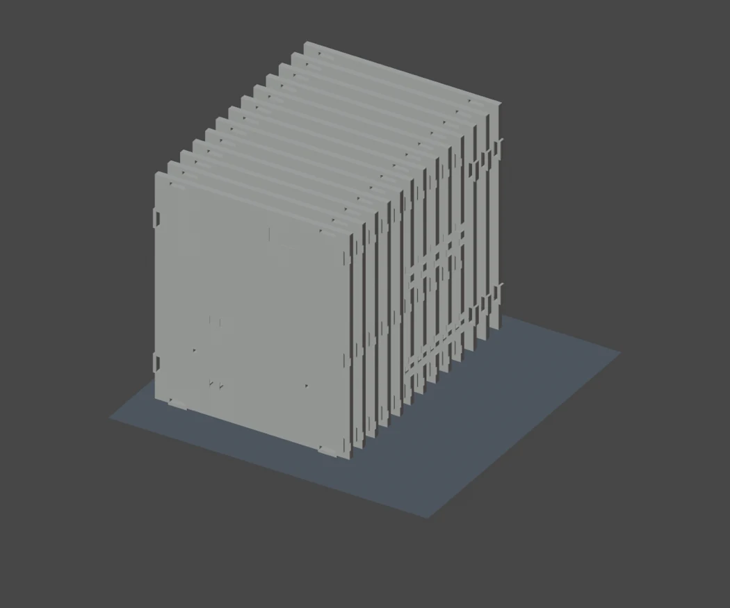
[picture p106: media/views/revisions/_16_interior_complet_05.webp]
|  |  | Facade subassembly from behind |

| Ribbed base | Side fins | Furniture detail |
|---|---|---|
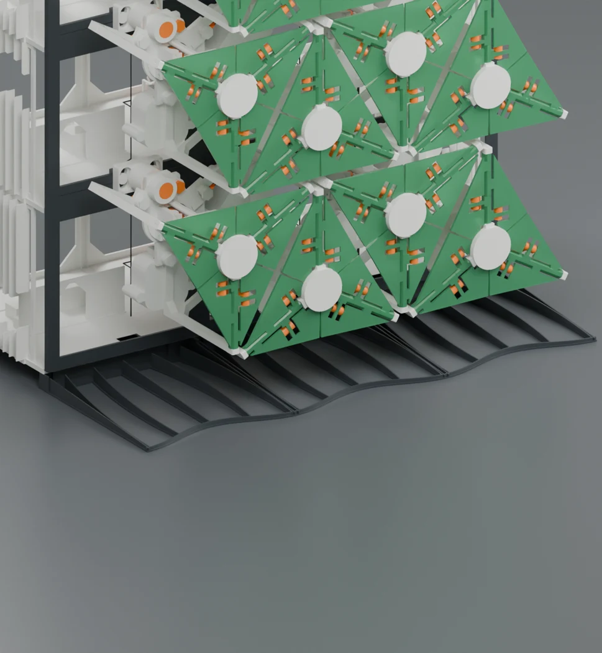
[picture p107: media/views/revisions/_16_interior_complet_07.webp]
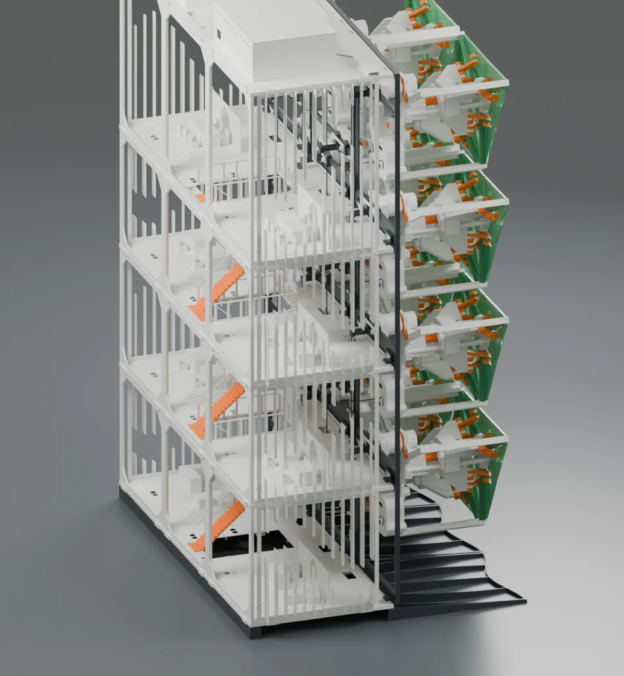
[picture p108: media/views/revisions/_16_interior_complet_08.webp]
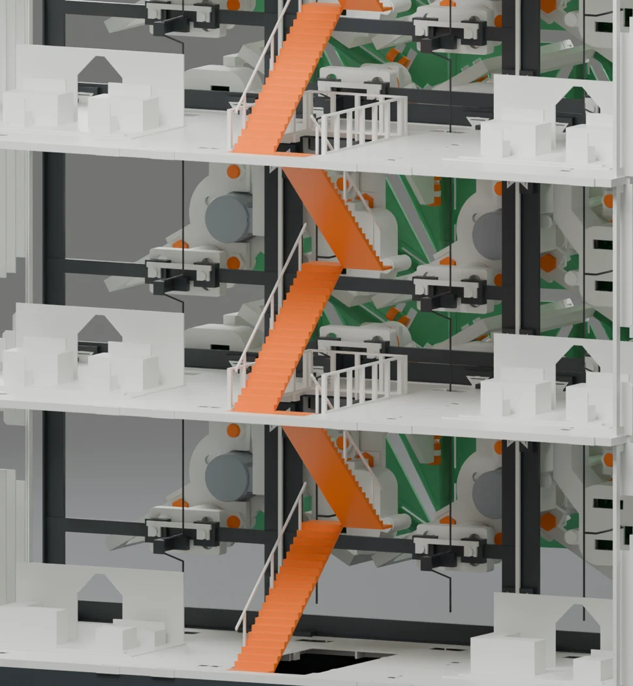
[picture p109: media/views/revisions/_16_interior_complet_09.webp]
|  |  |  |

## Marked parts

Source: `SOLARSKIN_16_PIESE_MARCATE/PLANSE`.

| Closed facade | Open facade | Rear |
|---|---|---|
| Closed facade | Open facade | Rear |

| Stair and interior | Floor print orientation | Facade subassembly from behind |
|---|---|---|
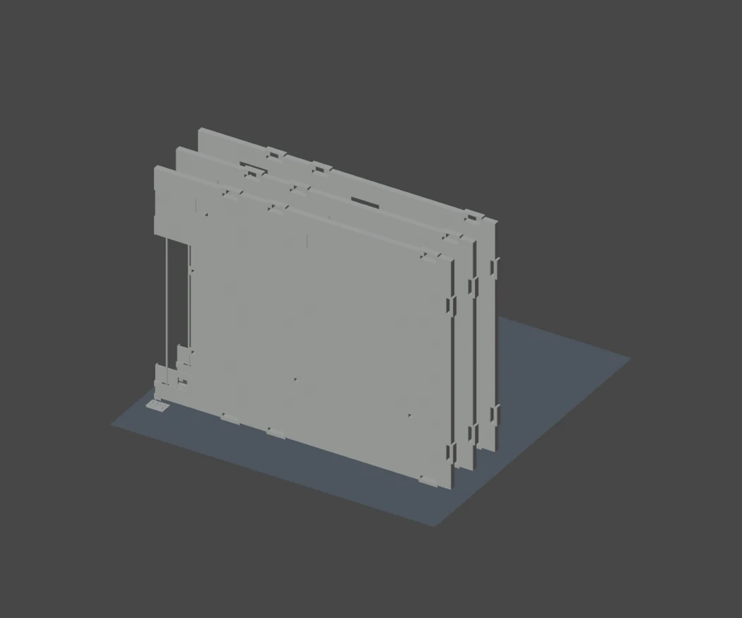
[picture p110: media/views/revisions/_16_piese_marcate_05.webp]
| Stair and interior |  | Facade subassembly from behind |

| Ribbed base | Side fins | Furniture detail |
|---|---|---|
| Ribbed base | Side fins | Furniture detail |

| Centred facade | Accent assembly | Captive mount |
|---|---|---|
| Centred facade | Accent assembly | Captive mount |

## Revised mounts

Source: `SOLARSKIN_16_PRINDERI_REVIZUITE/PLANSE`.

| Closed facade | Open facade | Rear |
|---|---|---|
| Closed facade | Open facade | Rear |

| Stair and interior | Floor print orientation | Facade subassembly from behind |
|---|---|---|
| Stair and interior | Floor print orientation | Facade subassembly from behind |

| Ribbed base | Side fins | Furniture detail |
|---|---|---|
| Ribbed base | Side fins | Furniture detail |

| Centred facade | Accent assembly | Receiver mount |
|---|---|---|
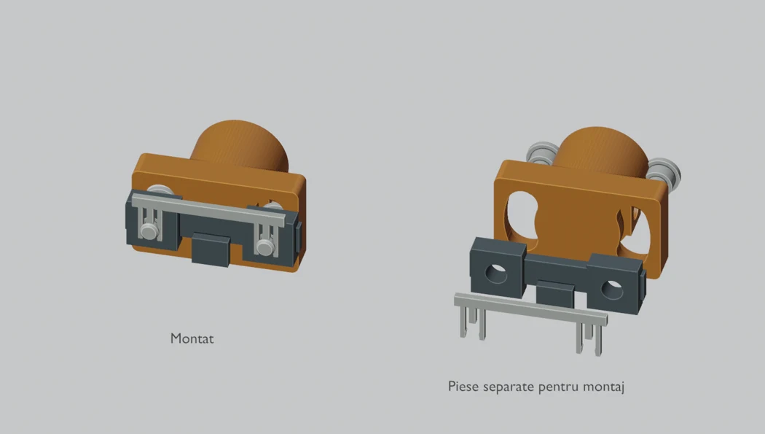
[picture p111: media/views/revisions/_16_prinderi_revizuite_13.webp]
Receiver mount
| Centred facade | Accent assembly |  |

## Interior supports

Source: `SOLARSKIN_16_REAZEME_INTERIOR/PLANSE`.

| Closed facade | Open facade | Rear |
|---|---|---|
| Closed facade | Open facade | Rear |

| Stair and interior | Floor print orientation | Facade subassembly from behind |
|---|---|---|
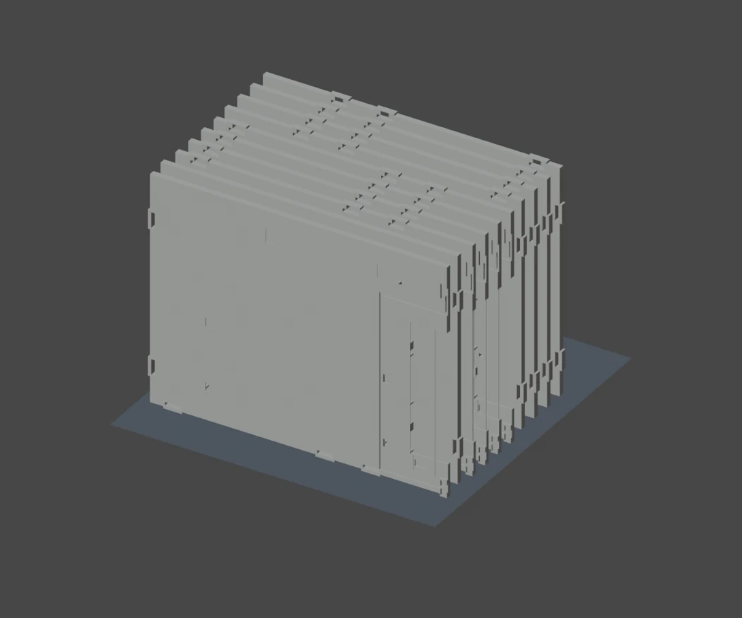
[picture p112: media/views/revisions/_16_reazeme_interior_05.webp]
| Stair and interior |  | Facade subassembly from behind |

| Ribbed base | Side fins | Furniture detail |
|---|---|---|
| Ribbed base | Side fins | Furniture detail |

| Centred facade | Accent assembly | Captive mount |
|---|---|---|
| Centred facade | Accent assembly | Captive mount |

## Sculptural envelope

Source: `SOLARSKIN_16_SCULPTURAL/PLANSE`.

| Closed facade | Open facade | Rear |
|---|---|---|
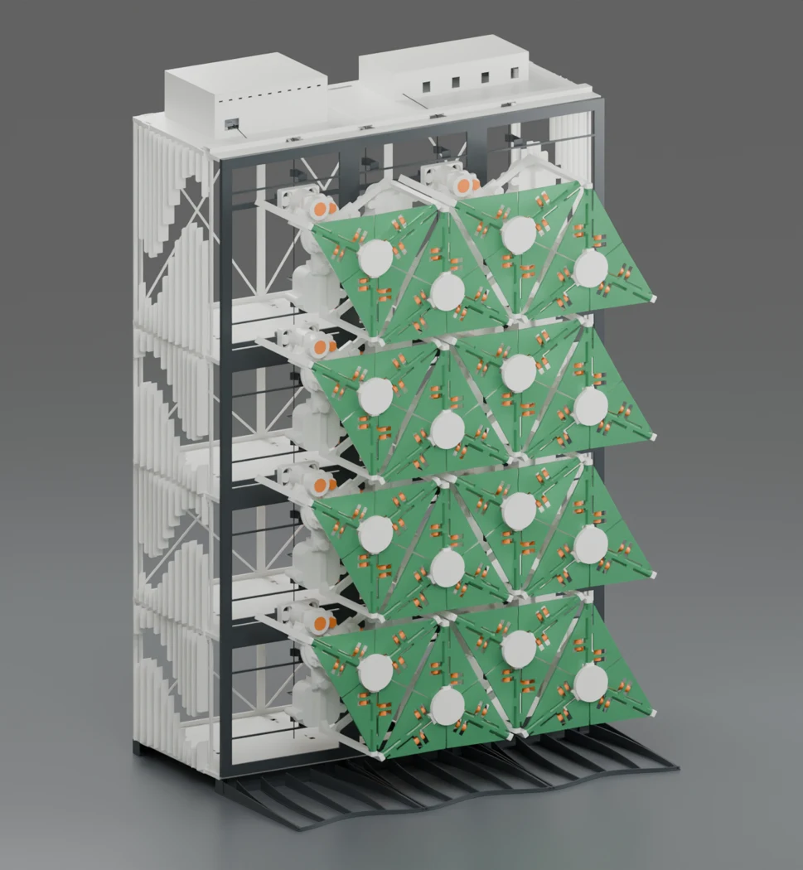
[picture p113: media/views/revisions/_16_sculptural_01.webp]
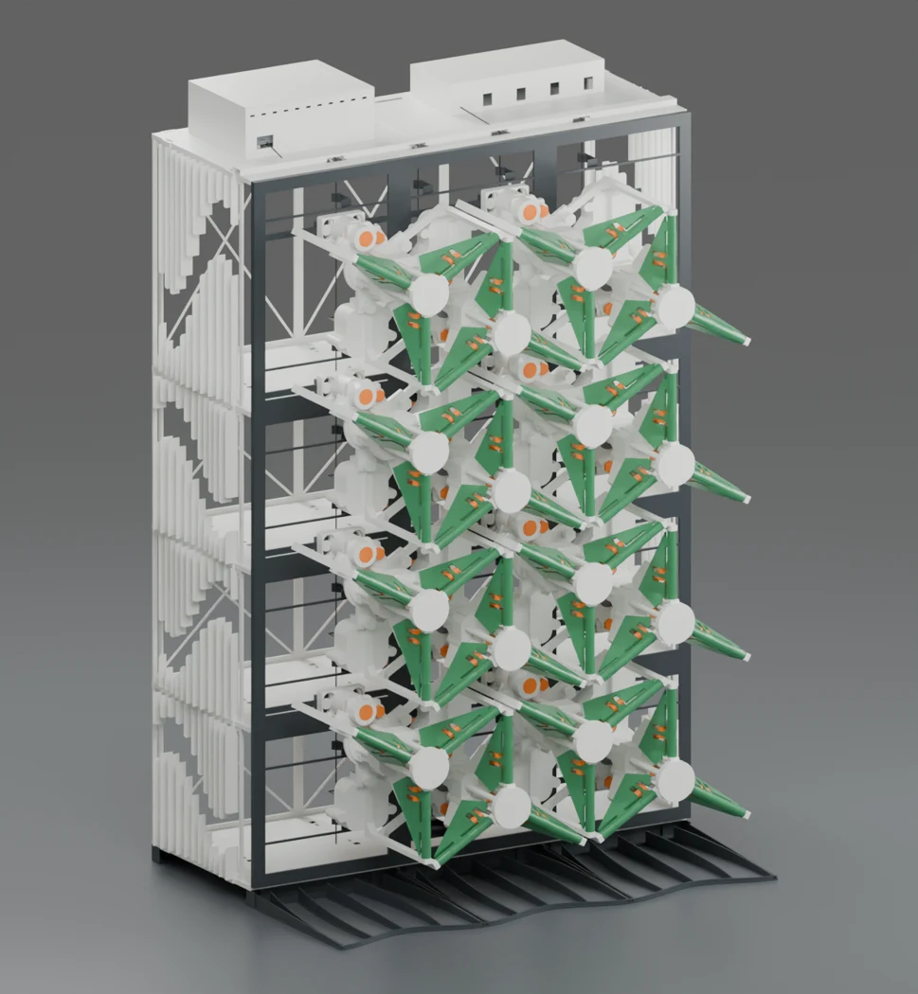
[picture p114: media/views/revisions/_16_sculptural_02.webp]
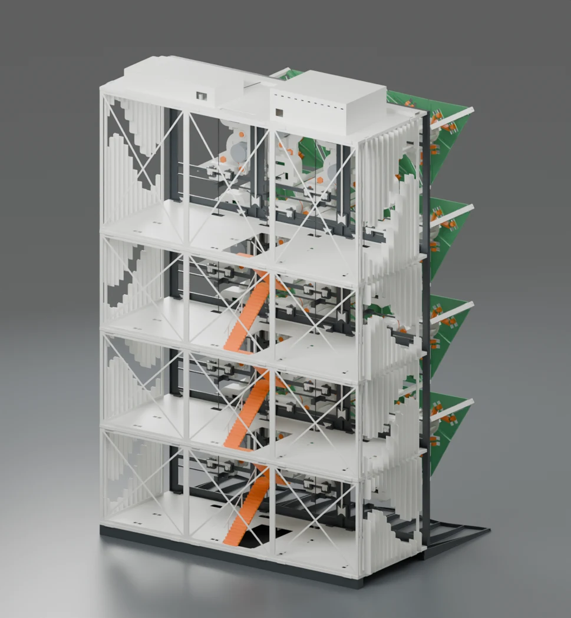
[picture p115: media/views/revisions/_16_sculptural_03.webp]
|  |  |  |

| Stair and interior | Floor print orientation | Facade subassembly from behind |
|---|---|---|
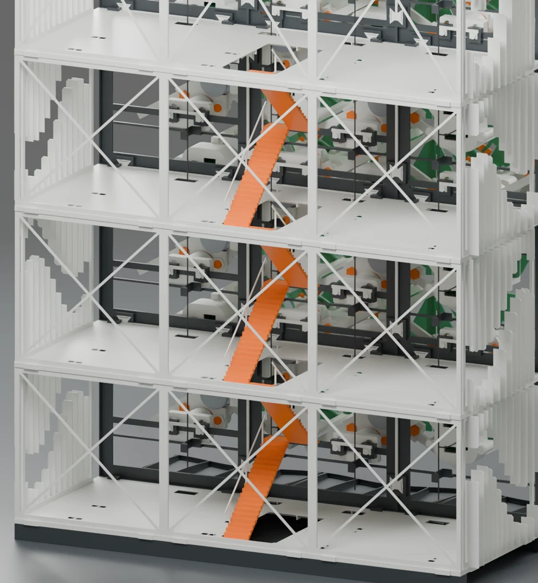
[picture p116: media/views/revisions/_16_sculptural_04.webp]
|  | Floor print orientation | Facade subassembly from behind |

| Ribbed base | Side fins |
|---|---|
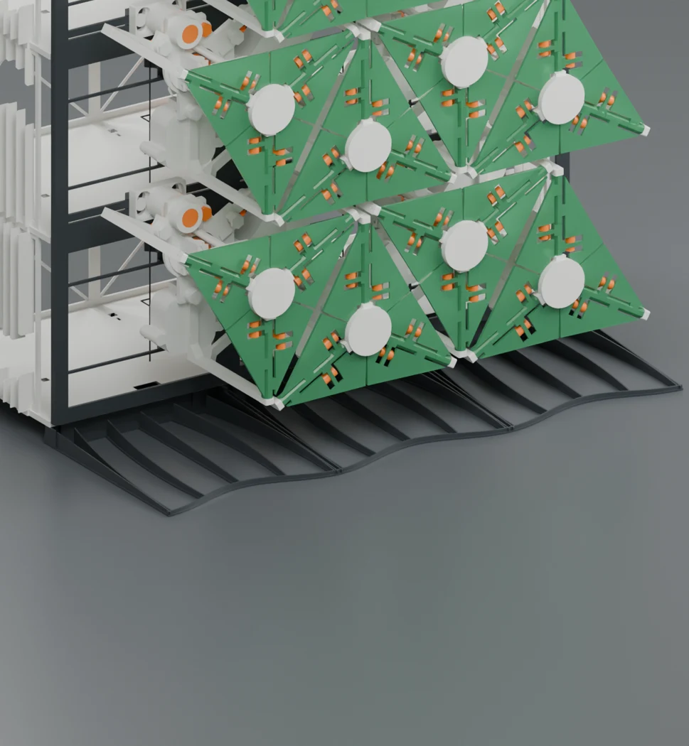
[picture p117: media/views/revisions/_16_sculptural_07.webp]
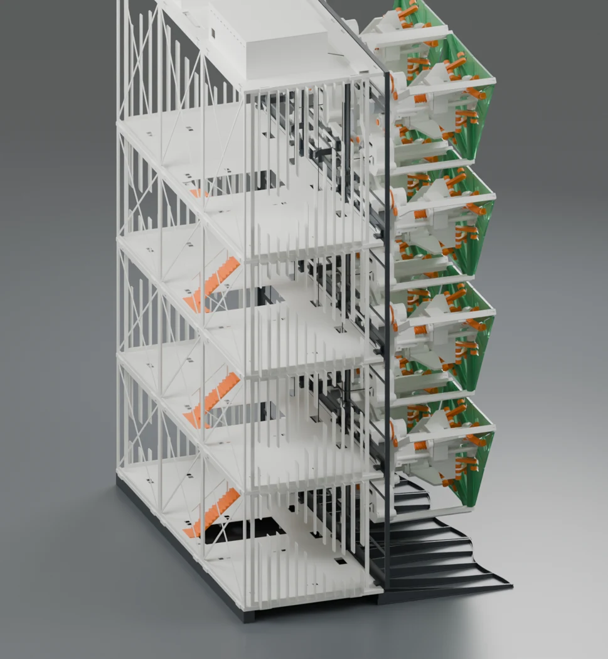
[picture p118: media/views/revisions/_16_sculptural_08.webp]
|  |  |

## Rapid office

Source: `SOLARSKIN_16_V5_RAPID/PLANSE`.

| Closed facade | Open facade | Rear |
|---|---|---|
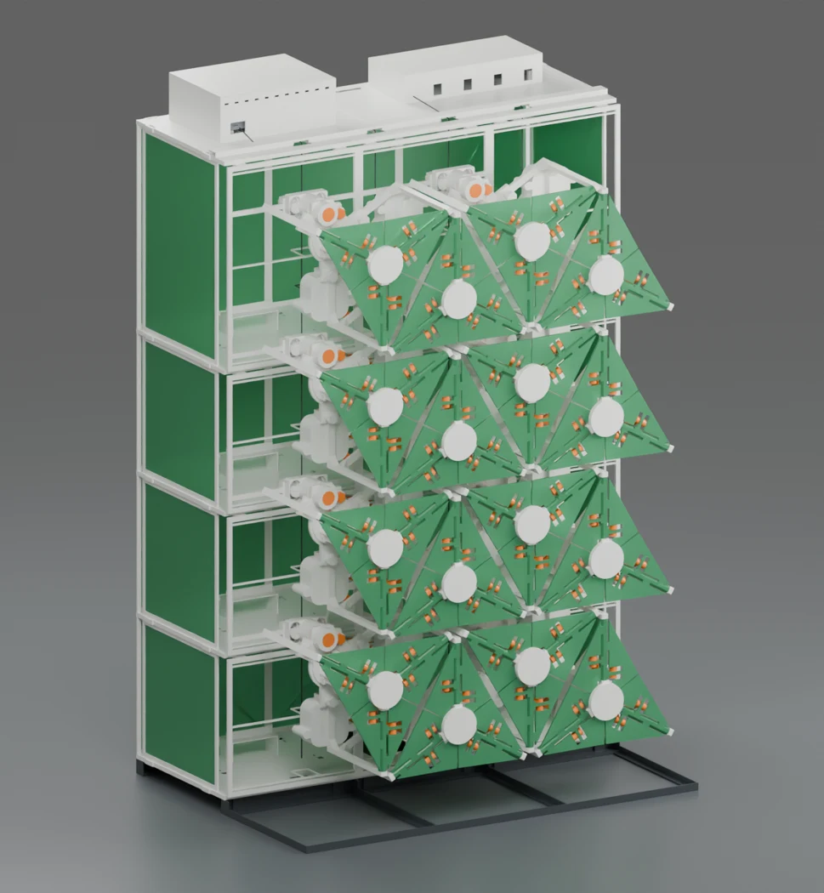
[picture p119: media/views/revisions/_16_v5_rapid_01.webp]
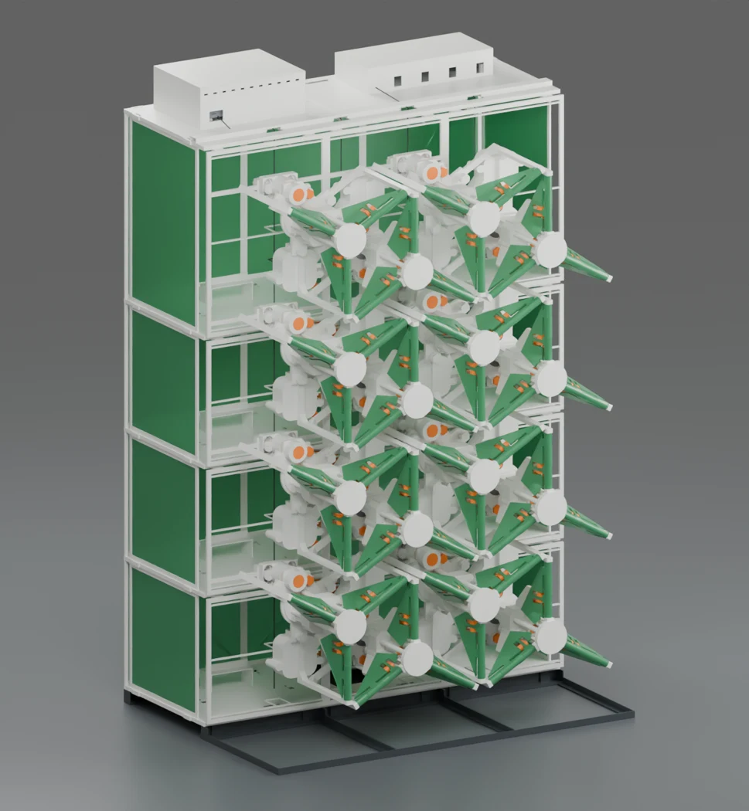
[picture p120: media/views/revisions/_16_v5_rapid_02.webp]
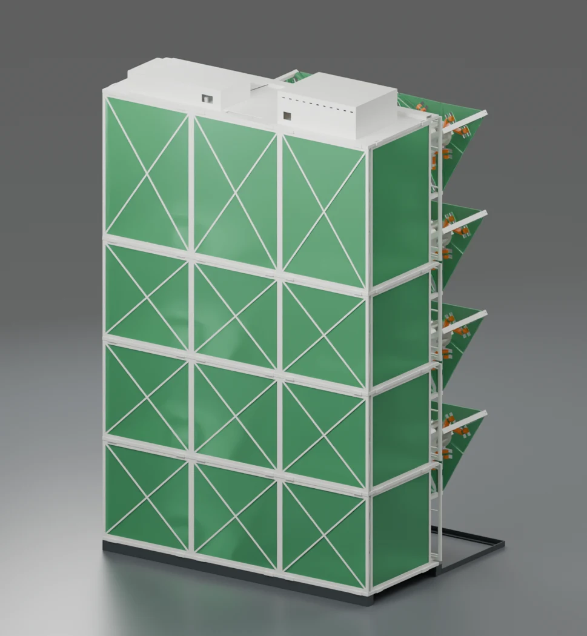
[picture p121: media/views/revisions/_16_v5_rapid_03.webp]
|  |  |  |

| Stair and interior | Floor print orientation |
|---|---|
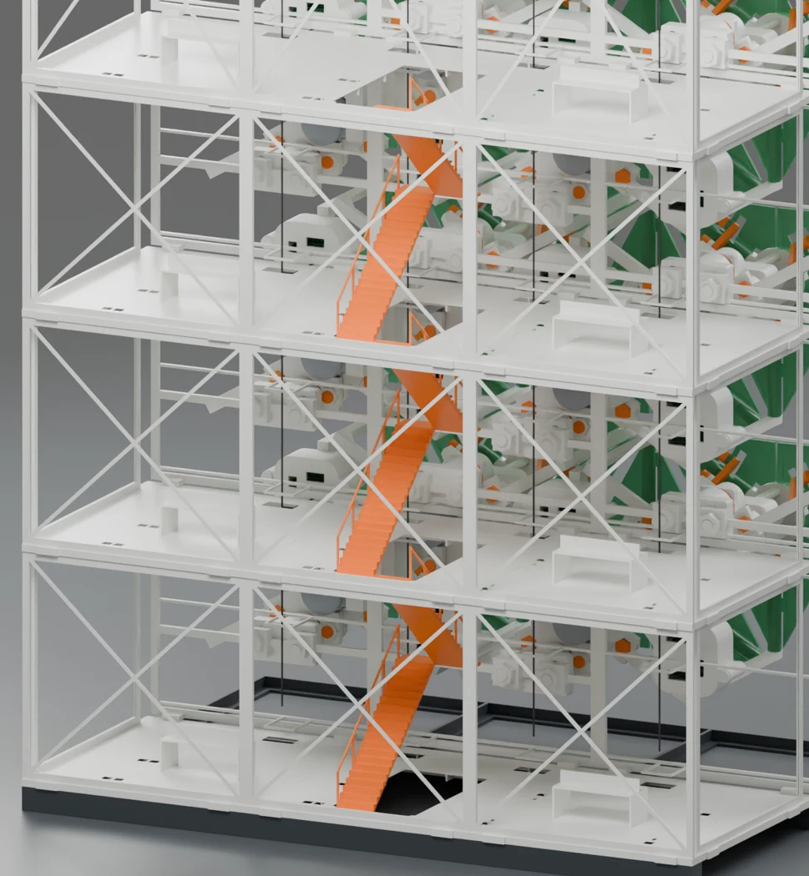
[picture p122: media/views/revisions/_16_v5_rapid_04.webp]
|  | Floor print orientation |
