vluncasu/SolarSkin/docs/simplified_workshop.md

# Simplified office - assembly sequence

Orange identifies the group being discussed. Blue-grey gives the installed context. Views show final part positions. Fit each storey while it is open.

## 1. Base and first floor

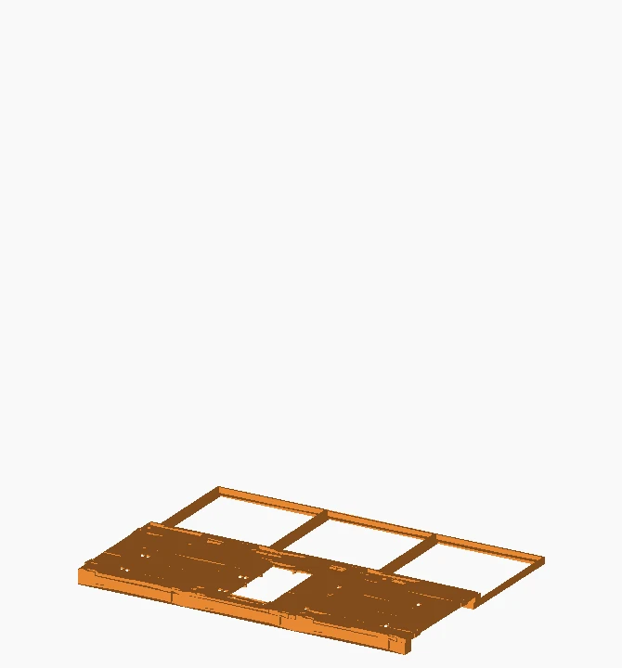
[picture p136: media/atlas/simplified-stage-0.webp]
Base and first floor


J03 fit coupon; A01 bays 1, 2 and 3; J01 floor keys; three each of B01, B02 and B03.

Test the printed joint with J03. Lay out the three floor bays in their CAD order. The central stair opening sets the orientation of the middle bay. Seat the floor on the base and install its mating keys.

**Check before continuing.** Use a flat surface. A stepped seam or a floor that rocks prevents the next level from seating.

## 2. First occupied level

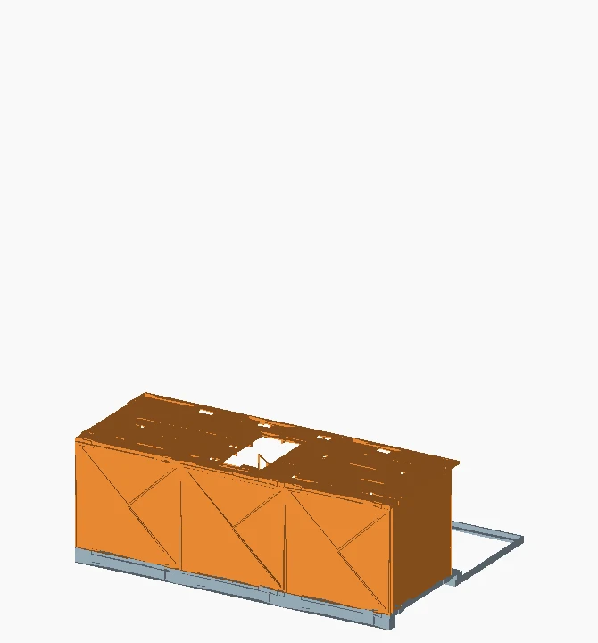
[picture p137: media/atlas/simplified-stage-1.webp]
First occupied level


A02 rear frames, S01 lower stair flight and S02 upper flight.

Locate the rear frames in the floor sockets. Assemble the two stair flights in the central opening. Build the sides and first interior while the space above the floor remains accessible. Fit V01 rear glazing into the A02 frames and V02 side glazing into A03 frames. The rapid lot omits the optional desk islands visible in the assembly reference.

**Check before continuing.** Look down through the opening. The landing must meet the next floor and the stair must clear the adjacent room.

## 3. Intermediate floors

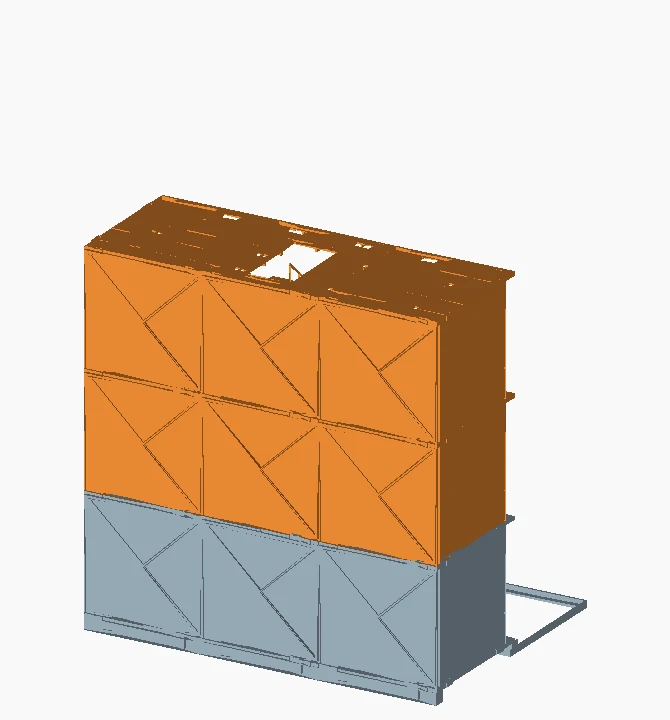
[picture p138: media/atlas/simplified-stage-2.webp]
Intermediate floors


A01 bays at each level; ordinary rear and side frames; stair flights.

Repeat the three-bay floor stack. The CAD floor origins rise from 18.0 to 170.1, 322.2 and 474.3 mm. Assemble each occupied storey before covering it. Keep glazing flat until installation. Match each ordinary pane to its own frame before stacking the next floor.

**Check before continuing.** Use the three equal 152.1 mm level intervals to identify ordinary storeys. They are assembly-origin differences, not dimensions to add to individual STL parts.

## 4. Upper storey and roof

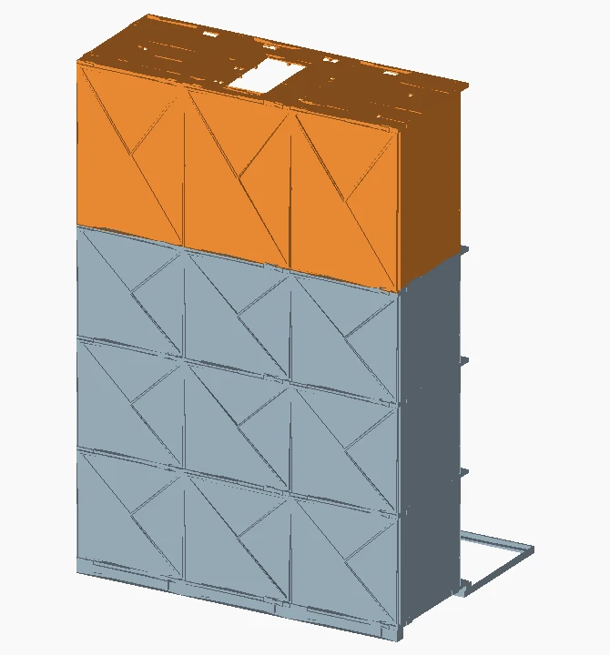
[picture p139: media/atlas/simplified-stage-3.webp]
Upper storey and roof


Tall rear and side elements; A01 roof bays; T02 roof hatch.

Use the tall frame parts at N4. The last floor-to-roof interval is 223.7 mm. Keep the service opening accessible when placing the three roof bays and the hatch. Pair the tall V01/V02 panes with the tall A02/A03 frames. Check the stair opening before seating the roof.

**Check before continuing.** Check the roof origin at Z = 698.0 mm in the scene. The hatch must remain accessible after fitting the cable channels.

## 5. Front structure and receivers

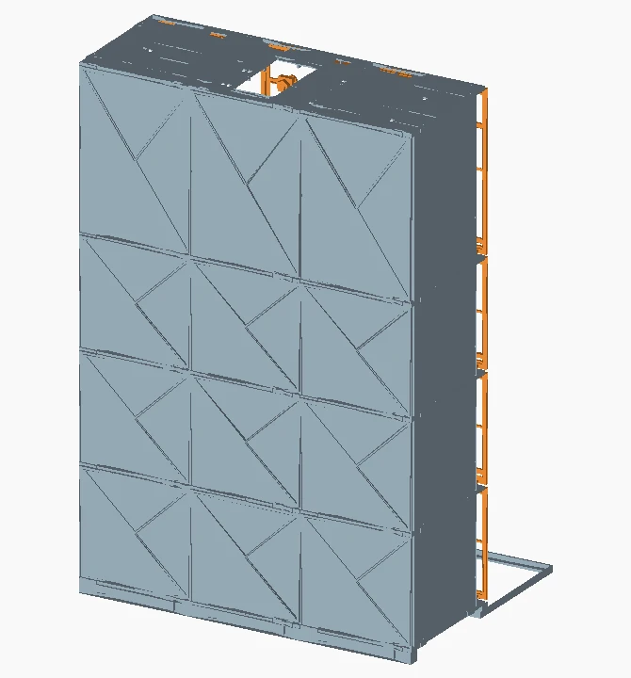
[picture p140: media/atlas/simplified-stage-4.webp]
Front structure and receivers


Twelve A04 load-bearing panels and 32 J02 D8 receiver screws.

Build three facade columns across four levels on a flat surface. Keep the module positions in front-view order: M01 to M04 at the top, M13 to M16 at the bottom. Columns 2 and 4 are rotated 180 degrees in the saved layouts. Match each panel number and N1-N4 level to the rapid Blender scene. This route uses two J02 D8 screws per module. Keep these screws separate from the F01/F02 system on the furnished building and stand.

**Check before continuing.** Test one receiver and check tool access from behind it. Support the module body while fitting it. Repeat only after the first mount allows the required leaf travel.

## 6. Roof equipment and cabling

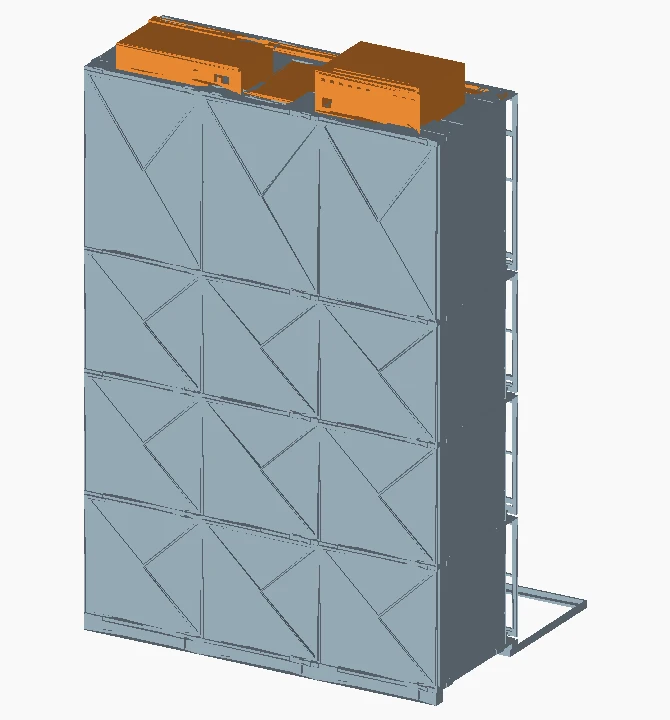
[picture p141: media/atlas/simplified-stage-5.webp]
Roof equipment and cabling


E02 enclosure, E03 lid, two E04 clamps, E05/E06 control enclosure, E07 channels and E08 covers.

Check the actual boards and source against the mounting geometry. Place the housings before routing cables. Route low-voltage leads to the drivers, leave service loops and fit the channel covers last.

**Check before continuing.** With motor power off, move the leaves through their travel and remove one service cover. The cable should neither pull on its connector nor enter the linkage sweep.
