vluncasu/SolarSkin/docs/14_photo_walkthrough.md

# SolarSkin in pictures

## Architectural development archive

The nine-position elevation and wave study belong to an earlier design. [Current three-model comparison](12_building_and_facade.md).

Open facade

Follow one group of six leaves around its hub. The building repeats the module in three rows of three.

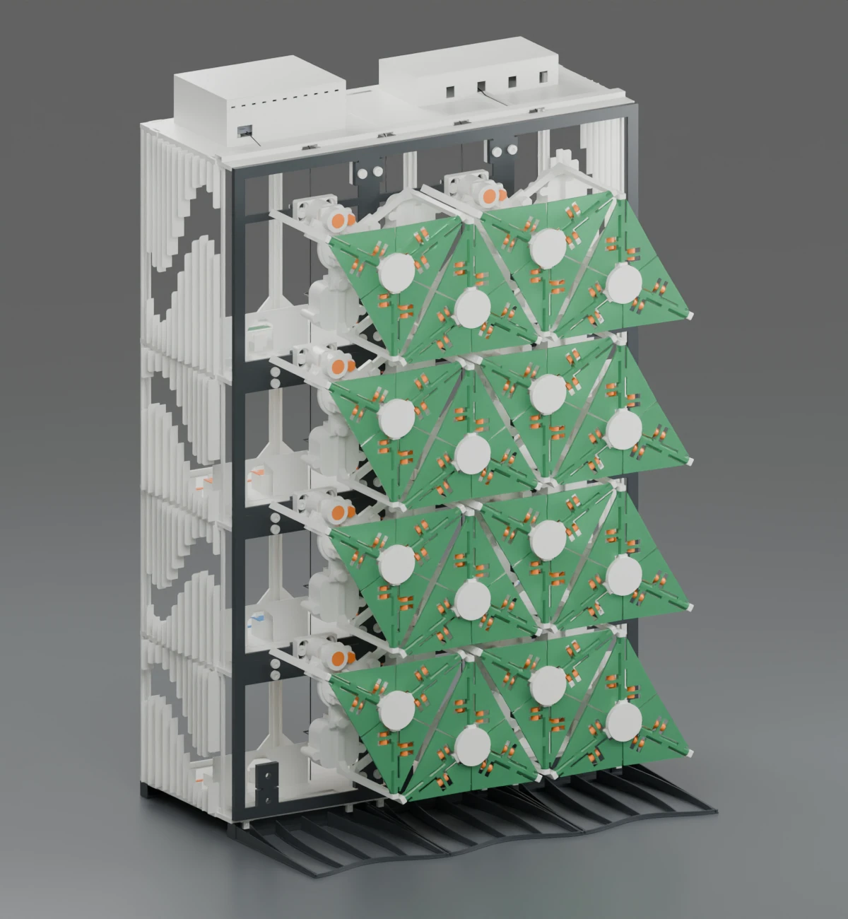
[picture p151: media/renders/building_closed.webp]
Closed facade


Compare the same facade after the leaves fold back across the openings.

Rear elevation

The rear view exposes the supporting structure behind the modules.

Office floors

The floor slabs and furniture belong to the architectural print set.

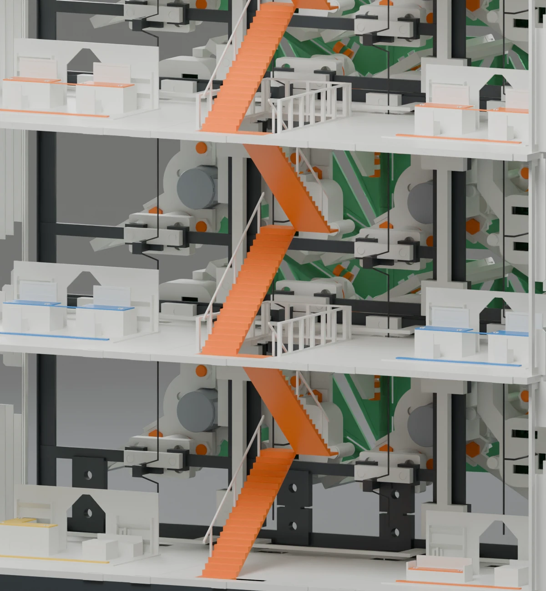
[picture p152: media/renders/interior_detail.webp]
Office interior


The interior stays visible through the rear of the model.

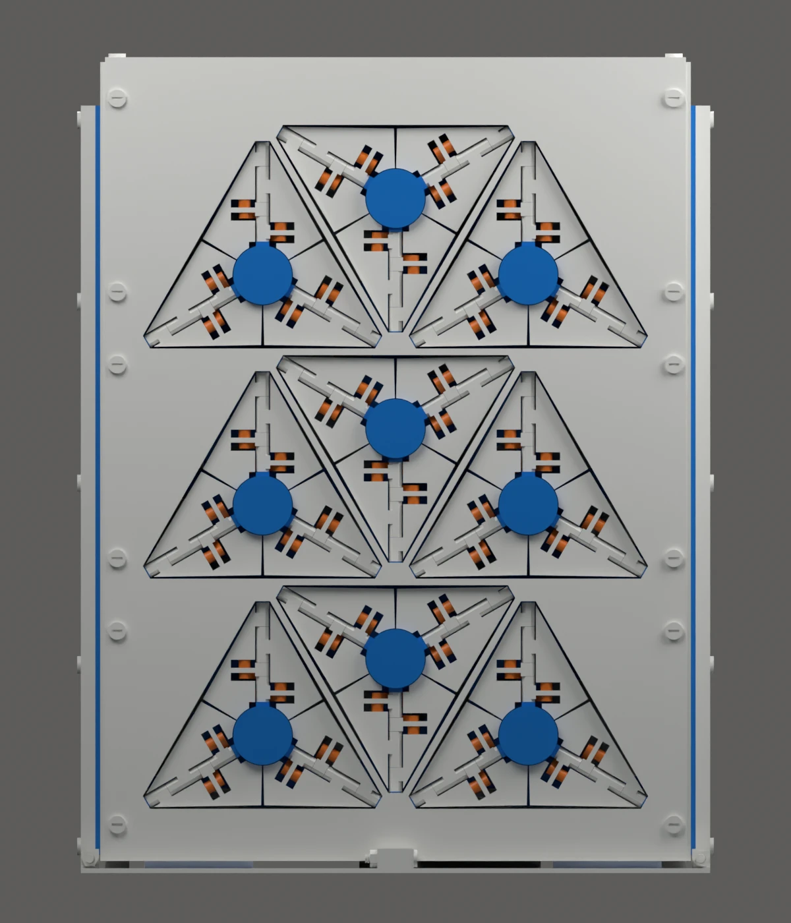
[picture p153: media/renders/building_front_elevation.webp]
Front elevation with the full three-by-three array


Seen straight on, the three rows show how the neighbouring leaves share the facade.

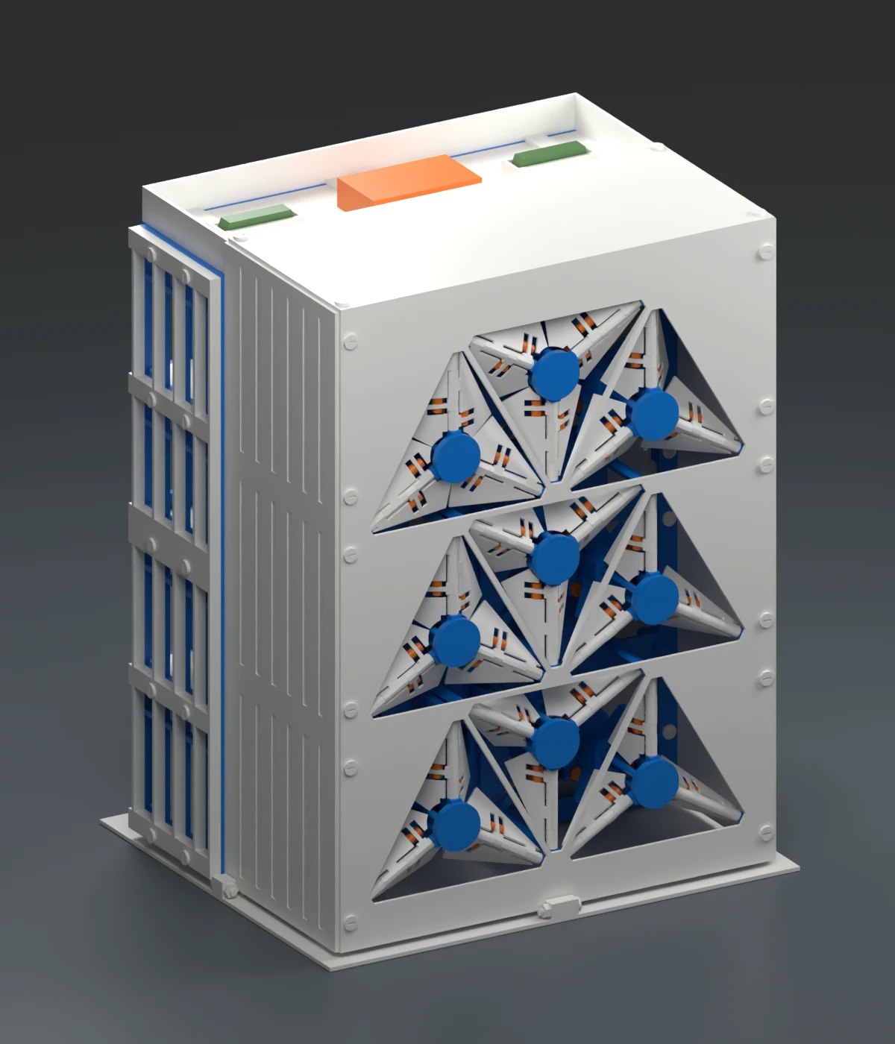
[picture p154: media/renders/building_wave_pose.webp]
Architectural wave pose


The architectural study shows a wave across the facade. The published baseline
firmware sends the same phase sequence to all fourteen channels.

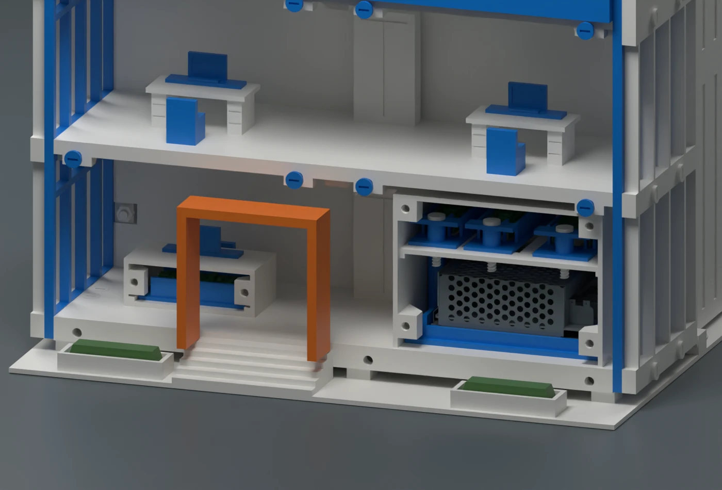
[picture p155: media/renders/building_service_access.webp]
Access behind the facade


Use the service view when locating the electronics behind the display.

## One mechanism

Six-leaf module

The three blue guides keep the carriage aligned as the orange screw turns.

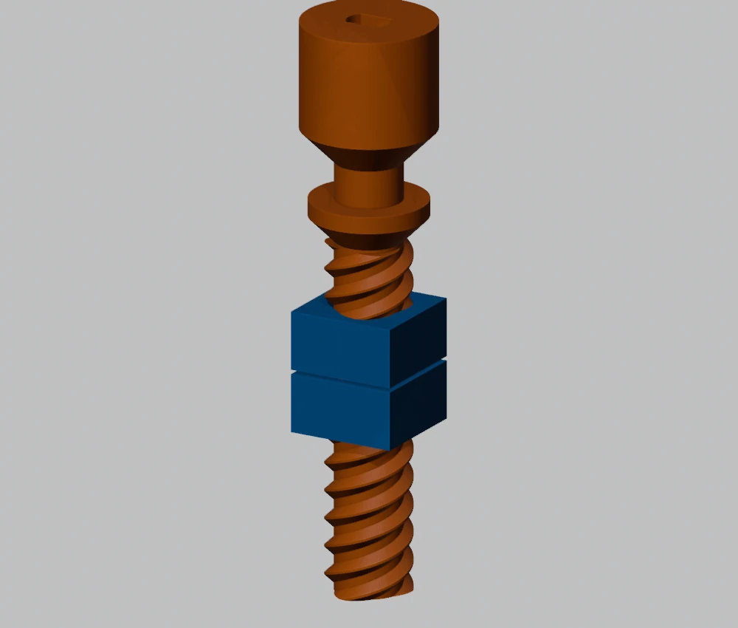
[picture p156: media/renders/lead_screw_10mm.webp]
Lead screw and split nuts


P13, P12 and P26 share the same three-start profile.

Screw entering the rear frame

Leave the motor off so the screw can enter the side opening.

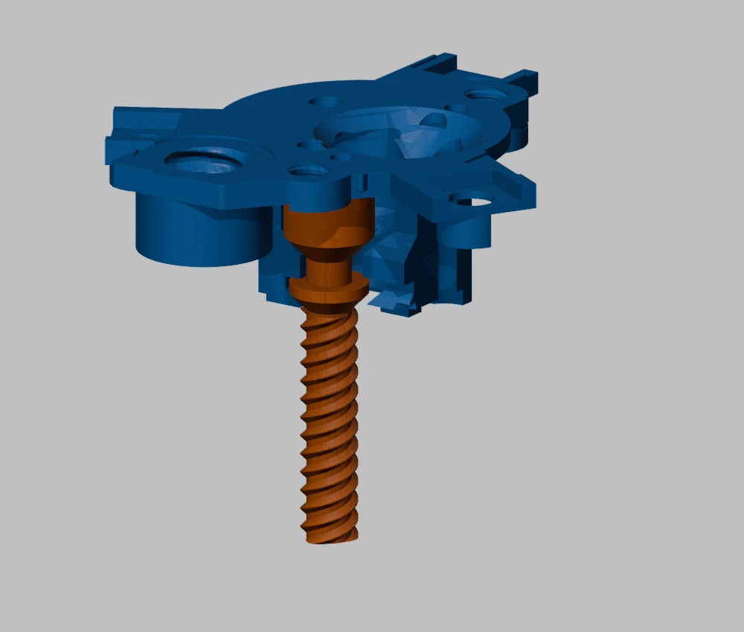
[picture p157: media/renders/screw_insertion_02.webp]
Screw moving towards the bearing


Keep the shaft parallel to its working axis.

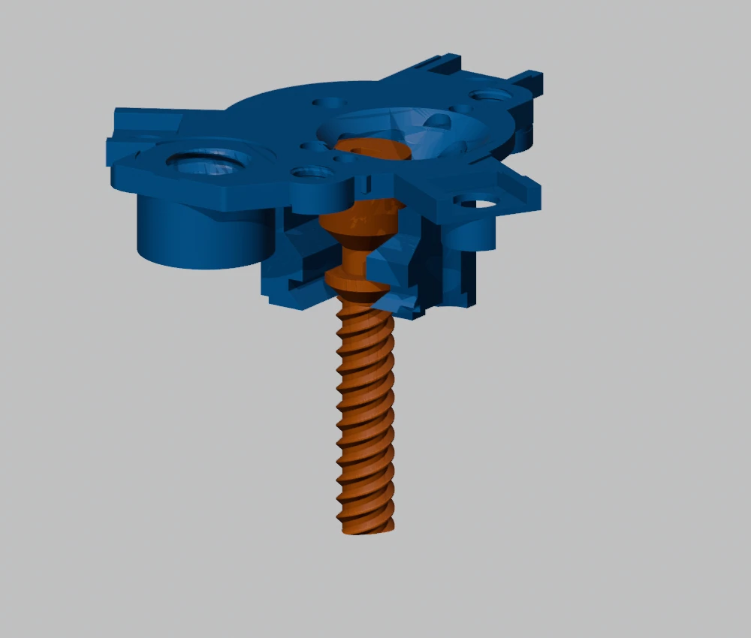
[picture p158: media/renders/screw_insertion_03.webp]
Coupling seated


Seat the shoulder before lowering the frame onto its guides.

## The exhibition stand

Populated stand

This frame has sixteen receiver positions.

Empty reinforced frame

The rear foot extends the base behind the tall frame.

Exploded module mounting

Follow the receiver from the module to the cassette.

Receiver and fasteners

Each occupied stand position uses two F01 screws and one F02 locking plate.

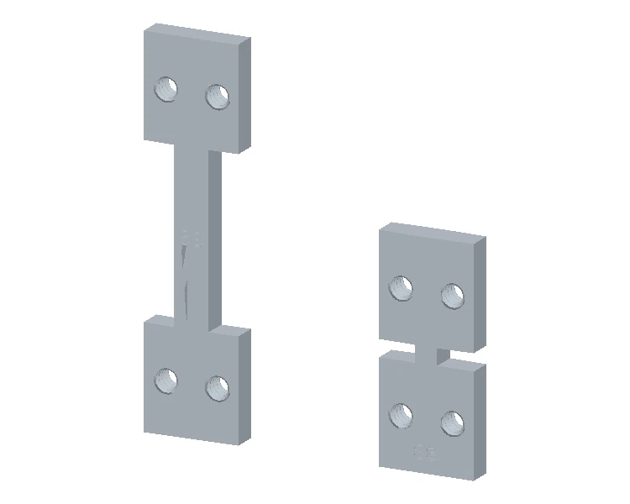
[picture p159: media/renders/frame_horizontal_splices.webp]
Horizontal joints


Align adjacent cassettes before tightening their fasteners.

Vertical joints

Keep the stacked cassettes on a flat surface during assembly.

Rear foot

The extra foot attaches through the rear adapter.

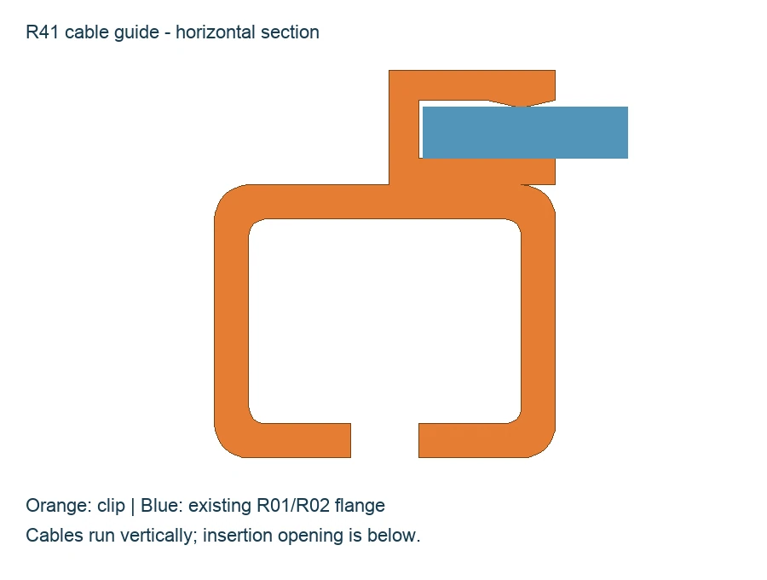
[picture p160: media/renders/cable_clip_section.webp]
Cable clip cross section


Leave a service loop between the fixed frame and each removable driver.
