vluncasu/SolarSkin/docs/18_architectural_design_archive.md

# Architectural design archive

[Original twenty-module office building and kinetic facade](19_original_office.md).

The folder identifiers below match the original design records. Several mounting revisions retain the same exterior rendering. Use the CAD and print inventory of the selected revision to identify its hardware.

## Compact office, six modules

Animated Compact office, six modules

[Open the animated Blender scene](../cad/earlier_offices/COMPACT_OFFICE.blend).

Source assembly family: `SOLARSKIN_COMPACT_OFFICE_6`.

## Aurora pavilion

Animated Aurora pavilion

[Open the animated Blender scene](../cad/earlier_offices/AURORA_PAVILION.blend).

Source assembly family: `SOLARSKIN_AURORA_9`.

## Rigid office, eight modules

Animated Rigid office, eight modules

[Open the animated Blender scene](../cad/earlier_offices/RIGID_OFFICE.blend).

Source assembly family: `SOLARSKIN_OFFICE_RIGID_8`.

## Office, nine modules

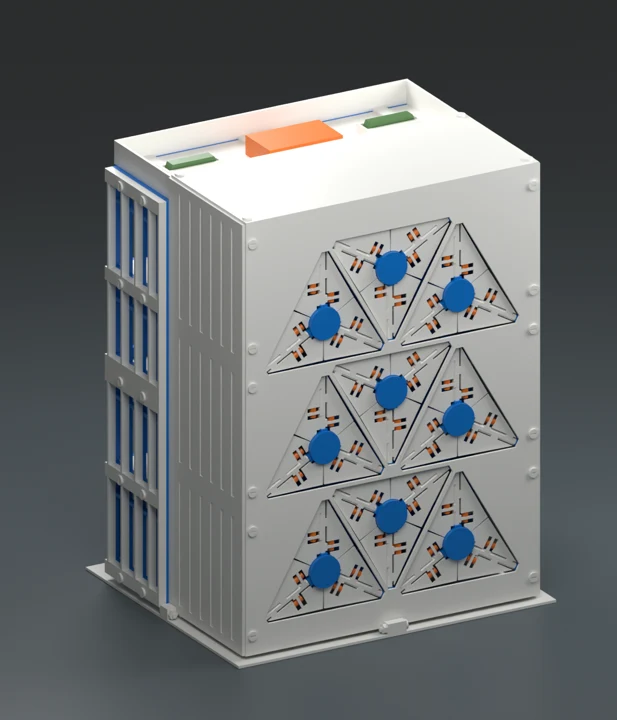
[picture p339: media/renders/archive_office_9_architect.webp]
Office, nine modules - source elevation


Source assembly family: `SOLARSKIN_OFFICE_9_ARCHITECT`.

## Integrated facade

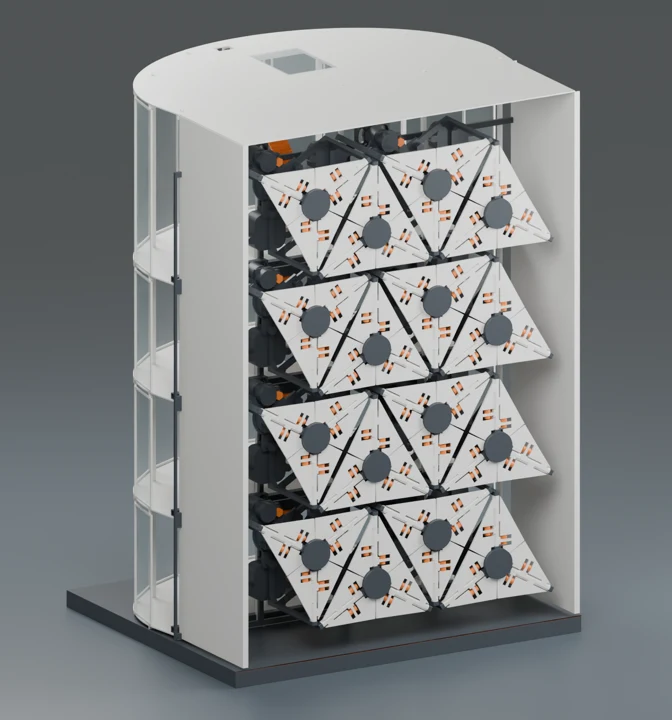
[picture p340: media/renders/archive_16_integrat.webp]
Integrated facade - source elevation


Source assembly family: `SOLARSKIN_16_INTEGRAT`. [Open the saved views](21_revision_views.md#integrated-facade).

## Rapid office

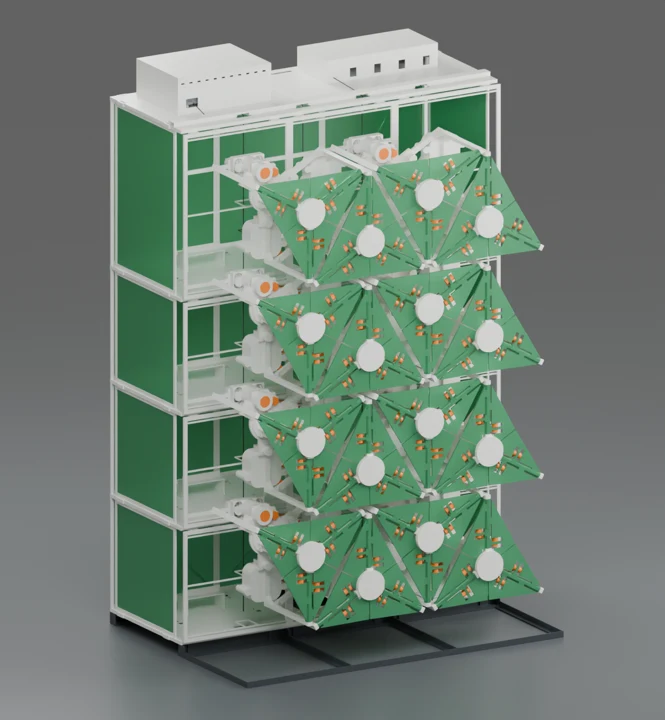
[picture p341: media/renders/archive_16_v5_rapid.webp]
Rapid office - source elevation


Source assembly family: `SOLARSKIN_16_V5_RAPID`. [Open the saved views](21_revision_views.md#rapid-office).

## Unified facade

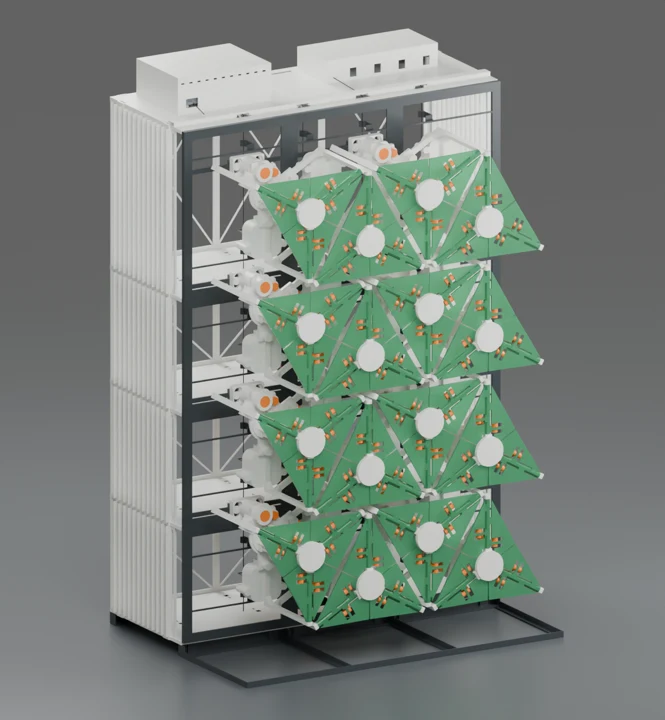
[picture p342: media/renders/archive_16_fatada_unitara.webp]
Unified facade - source elevation


Source assembly family: `SOLARSKIN_16_FATADA_UNITARA`. [Open the saved views](21_revision_views.md#unified-facade).

## Compact accents

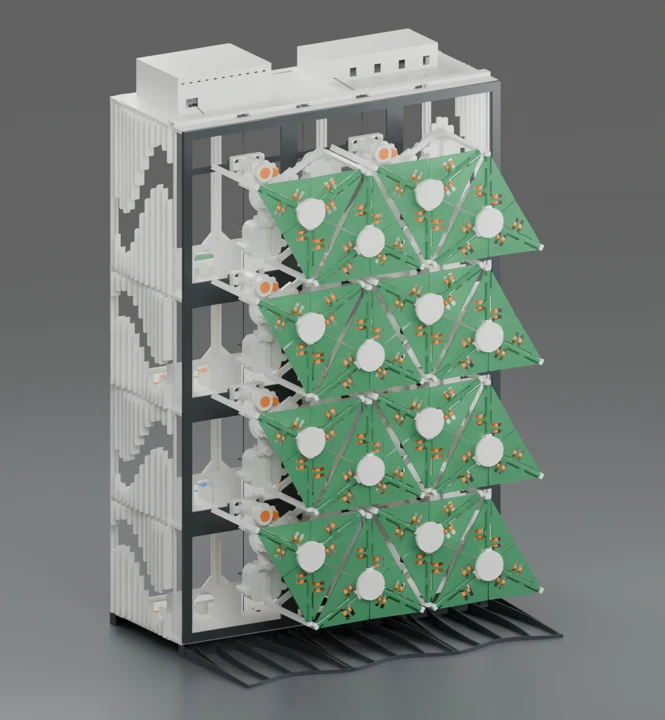
[picture p343: media/renders/archive_16_compact_accente.webp]
Compact accents - source elevation


Source assembly family: `SOLARSKIN_16_COMPACT_ACCENTE`. [Open the saved views](21_revision_views.md#compact-accents).

## Sculptural envelope

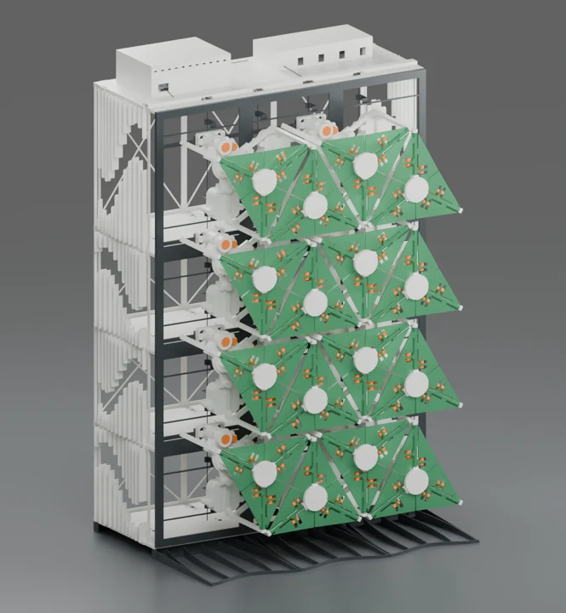
[picture p344: media/renders/archive_16_sculptural.webp]
Sculptural envelope - source elevation


Source assembly family: `SOLARSKIN_16_SCULPTURAL`. [Open the saved views](21_revision_views.md#sculptural-envelope).

## Furnished office

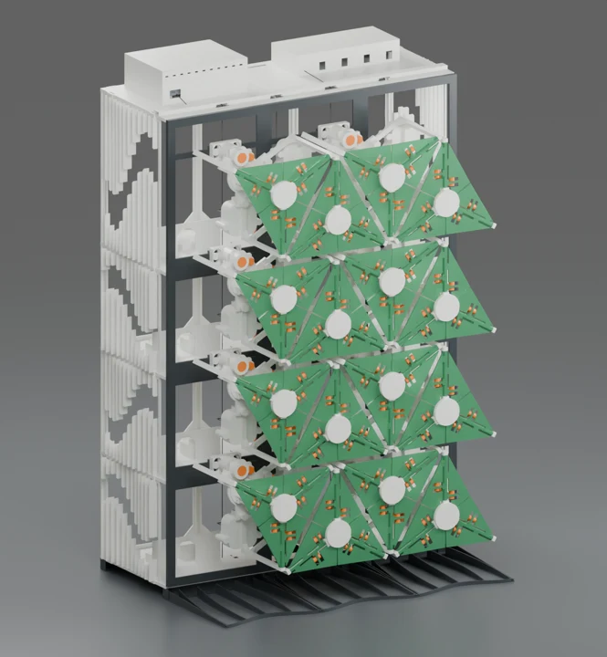
[picture p345: media/renders/archive_16_interior_complet.webp]
Furnished office - source elevation


Source assembly family: `SOLARSKIN_16_INTERIOR_COMPLET`. [Open the saved views](21_revision_views.md#furnished-office).

## Interior supports

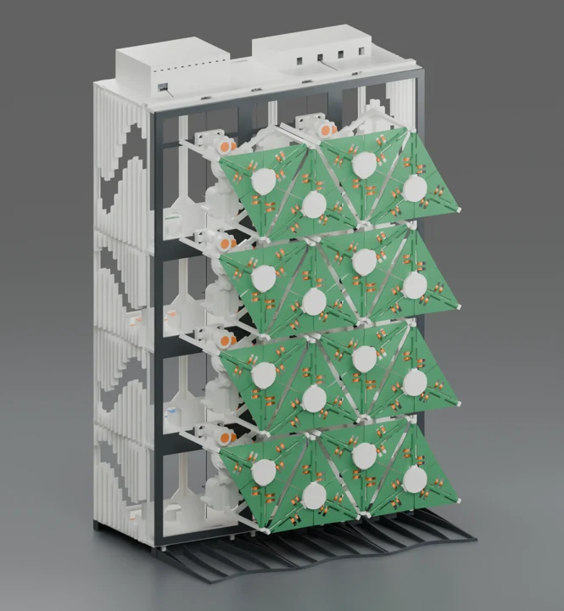
[picture p346: media/renders/archive_16_reazeme_interior.webp]
Interior supports - source elevation


Source assembly family: `SOLARSKIN_16_REAZEME_INTERIOR`. [Open the saved views](21_revision_views.md#interior-supports).

## Connector revision

Connector revision - source elevation

Source assembly family: `SOLARSKIN_16_CONECTORI`. [Open the saved views](21_revision_views.md#connector-revision).

## Revised mounts

Revised mounts - source elevation

Source assembly family: `SOLARSKIN_16_PRINDERI_REVIZUITE`. [Open the saved views](21_revision_views.md#revised-mounts).

## Marked parts

Marked parts - source elevation

Source assembly family: `SOLARSKIN_16_PIESE_MARCATE`. [Open the saved views](21_revision_views.md#marked-parts).

## Engraved parts

Engraved parts - source elevation

Source assembly family: `SOLARSKIN_16_GRAVATE`. [Open the saved views](21_revision_views.md#engraved-parts).

## Threaded mounting revision

Threaded mounting revision - source elevation

Source assembly family: `SOLARSKIN_16_FILET_PRIORITAR`. [Open the saved views](21_revision_views.md#threaded-mounting-revision).

## Motion in the downloadable scenes

The three preview assemblies preserve their building geometry and module
placement. The moving components use transforms sampled every six frames
from the original 10 mm mechanism. Each module has its own parent placement
in its building. Press Space in Blender to play the 241-frame sequence.

We reopened the delivered files and compared the world transforms of each
leaf at frames 1 and 121. All 36 leaves in Compact, 54 in Aurora and 48 in
Rigid change pose. The earlier twenty-module building retains its original
animation; all 120 of its leaves change pose between the same sampled frames.
[Read the verification record](../verification/original_offices_motion.json).
