vluncasu/SolarSkin/print/furnished/inventory.csv

part_id | copies | material | size_mm
J01_CHEIE_FLUTURE | 30 | matte_white_PLA | [9.399999999999999, 11.520000000000001, 1.4]
A01_PLANSEU_1 | 5 | matte_white_PLA | [157.60000000000002, 4.600000000000021, 181.6]
A01_PLANSEU_2 | 5 | matte_white_PLA | [156.0, 4.600000000000021, 181.6]
A01_PLANSEU_3 | 5 | matte_white_PLA | [157.60000000000002, 4.600000000000021, 181.6]
A02_CADRU_SPATE | 9 | matte_white_PLA | [156.0, 151.9, 5.000000000000016]
A02_CADRU_SPATE_INALT | 3 | matte_white_PLA | [156.0, 223.5, 5.000000000000025]
S01_SCARA_RAMPA_INFERIOARA | 3 | orange_PLA | [82.651, 112.0, 30.000000000000007]
S02_SCARA_RAMPA_SUPERIOARA | 3 | orange_PLA | [77.65100000000022, 112.0, 26.000000000000007]
J03_PROBA_IMBINARI | 1 | matte_white_PLA | [32.0, 24.0, 4.0]
E02_CUTIE_SURSA_12V | 1 | matte_white_PLA | [138.0, 105.0, 52.0]
E03_CAPAC_SURSA | 1 | matte_white_PLA | [138.0, 105.0, 3.8]
E04_BRIDA_SURSA | 2 | orange_PLA | [114.6, 50.300000000000004, 5.000000000000005]
E05_CUTIE_COMANDA | 1 | matte_white_PLA | [164.0, 75.0, 33.0]
E06_CAPAC_COMANDA | 1 | matte_white_PLA | [164.0, 75.0, 3.8]
E07_CANAL_ACOPERIS_1 | 1 | matte_white_PLA | [156.0, 14.0, 5.0]
E07_CANAL_ACOPERIS_2 | 1 | matte_white_PLA | [156.0, 14.0, 5.0]
E07_CANAL_ACOPERIS_3 | 1 | matte_white_PLA | [156.0, 14.0, 5.0]
E08_CAPAC_CANAL_ACOPERIS | 3 | matte_white_PLA | [156.0, 14.0, 0.6]
T02_TRAPA_ACOPERIS | 1 | matte_white_PLA | [66, 112, 2.8]
B03_SOCLU_SPATE_CU_TALPA | 3 | anthracite_PLA | [156.0, 14.0, 17.400000000000002]
F01_BOLT_5_6 | 32 | matte_white_PLA | [10.4, 10.4, 15.6]
F02_SIGURANTA_DUBLA | 16 | matte_white_PLA | [42.0, 9.0, 1.6000000000000005]
F05_CHEIE_VERTICALA | 6 | matte_white_PLA | [14.16, 115.53999999999999, 1.8000000000000131]
F06_CHEIE_VERTICALA_LUNGA | 2 | matte_white_PLA | [14.16, 187.14, 1.8000000000000207]
F07_CHEIE_ORIZONTALA | 9 | matte_white_PLA | [14.16, 119.44, 1.8000000000000134]
F04_CASETA_C1_N1 | 1 | anthracite_PLA | [156.00000000000003, 153.5, 30.000000000000007]
F04_CASETA_C1_N2 | 1 | anthracite_PLA | [156.00000000000003, 153.5, 30.000000000000007]
F04_CASETA_C1_N3 | 1 | anthracite_PLA | [156.0, 153.50000000000023, 30.000000000000007]
F04_CASETA_C1_N4 | 1 | anthracite_PLA | [156.0, 225.09999999999997, 30.000000000000007]
F04_CASETA_C2_N1 | 1 | anthracite_PLA | [156.00000000000003, 153.5, 30.000000000000007]
F04_CASETA_C2_N2 | 1 | anthracite_PLA | [156.0, 153.5, 30.000000000000007]
F04_CASETA_C2_N3 | 1 | anthracite_PLA | [156.00000000000006, 153.50000000000023, 30.000000000000007]
F04_CASETA_C2_N4 | 1 | anthracite_PLA | [156.00000000000003, 225.09999999999997, 30.000000000000018]
F04_CASETA_C3_N1 | 1 | anthracite_PLA | [156.0, 153.5, 13.1]
F04_CASETA_C3_N2 | 1 | anthracite_PLA | [156.0, 153.5, 30.000000000000004]
F04_CASETA_C3_N3 | 1 | anthracite_PLA | [156.0, 153.5000000000001, 30.000000000000004]
F04_CASETA_C3_N4 | 1 | anthracite_PLA | [156.0, 225.09999999999997, 30.000000000000018]
S03_BALUSTRADA_SEPARATA | 6 | matte_white_PLA | [89.8425, 88.00000000000001, 1.20000000000001]
A05_LAMELE_UNDA_ASCENDENTA | 4 | matte_white_PLA | [152.0, 151.9, 14.000000000000016]
A06_LAMELE_UNDA_DESCENDENTA | 2 | matte_white_PLA | [152.0, 151.9, 13.878478920843508]
A07_LAMELE_UNDA_ETAJ_INALT | 2 | matte_white_PLA | [152.0, 223.5, 13.878478920843516]
B04_SOCLU_EVANTAI_INTEGRAT | 3 | anthracite_PLA | [156.0, 175.20000000000002, 17.400000000000002]
I01_RECEPTIE | 2 | matte_white_PLA | [110.0, 70.0, 42.8]
I01_ATELIER | 4 | matte_white_PLA | [110.0, 70.0, 42.8]
I01_SEDINTA | 2 | matte_white_PLA | [110.0, 70.0, 42.8]
I02_BARA_POZITIONARE | 8 | matte_white_PLA | [94.0, 4.0, 4.4]
I03_PROTECTIE_GOL_SCARA | 3 | matte_white_PLA | [64.4, 104.4, 25.20000000000001]
