vluncasu/SolarSkin/media/parts/E01_iso.png

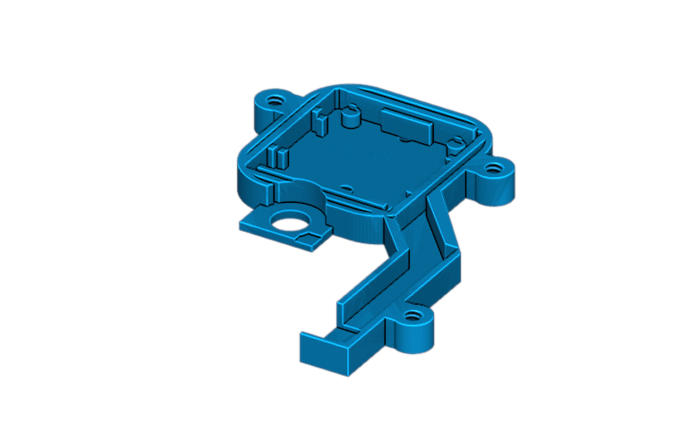
media/parts/E01_iso.png
