vluncasu/SolarSkin/media/parts/E01_plan.png

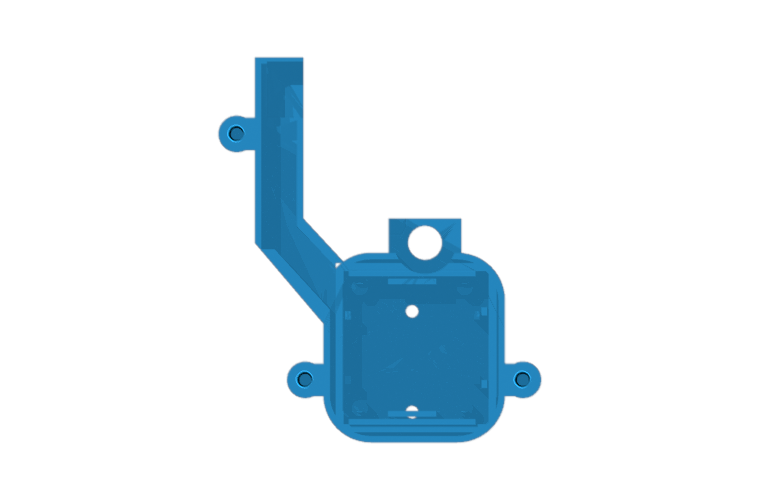
media/parts/E01_plan.png
