vluncasu/SolarSkin/media/parts/E02_iso.png

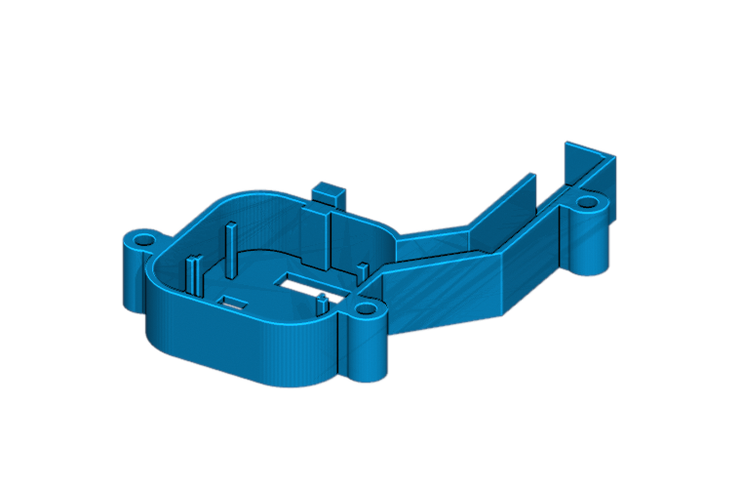
media/parts/E02_iso.png
