vluncasu/SolarSkin/media/parts/E02_plan.png

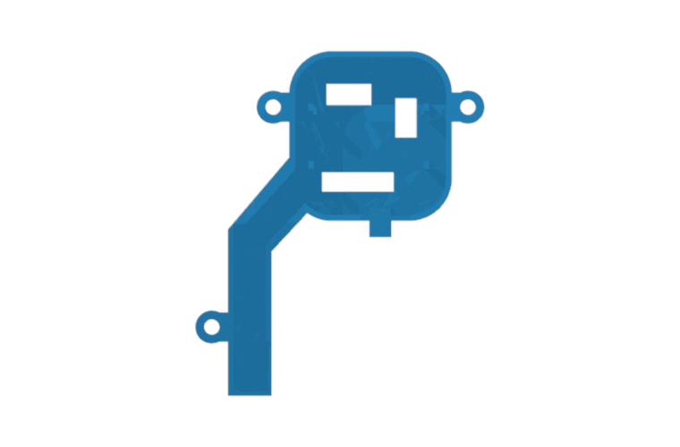
media/parts/E02_plan.png
