vluncasu/SolarSkin/media/parts/E03_iso.png

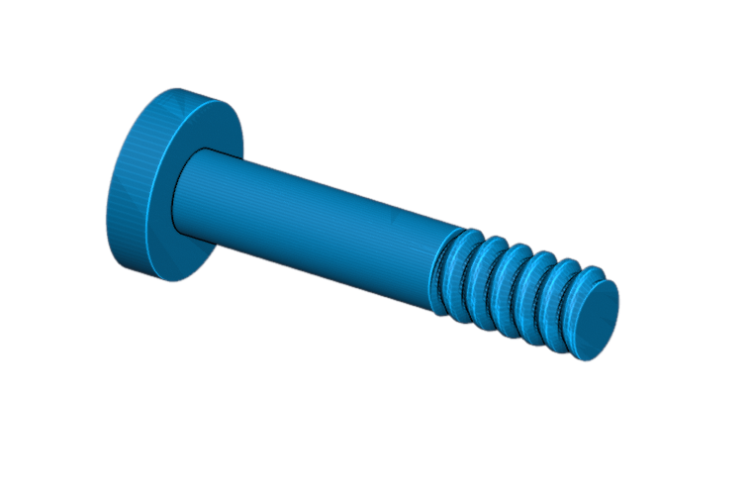
media/parts/E03_iso.png
