vluncasu/SolarSkin/media/parts/E03_plan.png

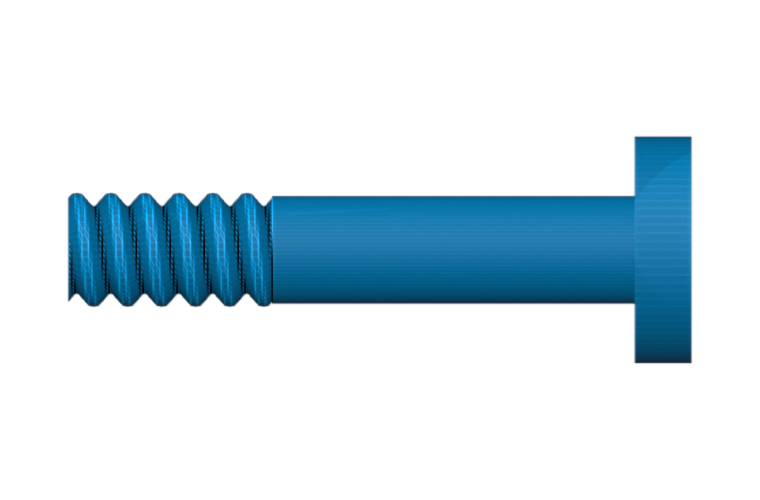
media/parts/E03_plan.png
