vluncasu/SolarSkin/media/parts/P02_iso.png

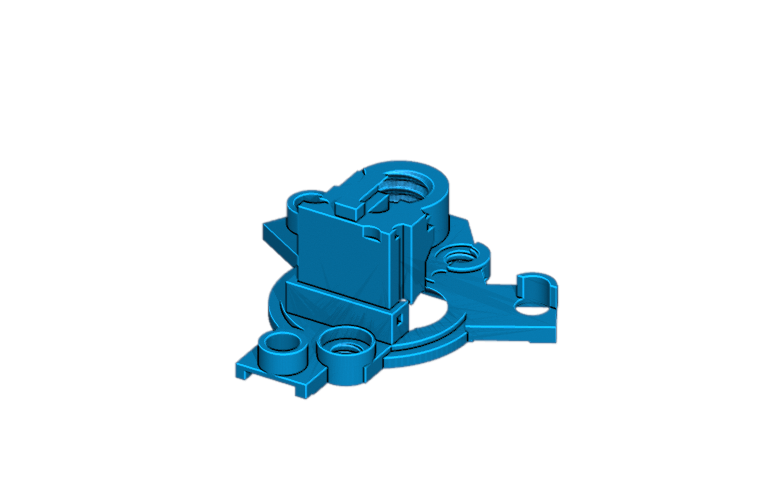
media/parts/P02_iso.png
