vluncasu/SolarSkin/media/parts/P02_plan.png

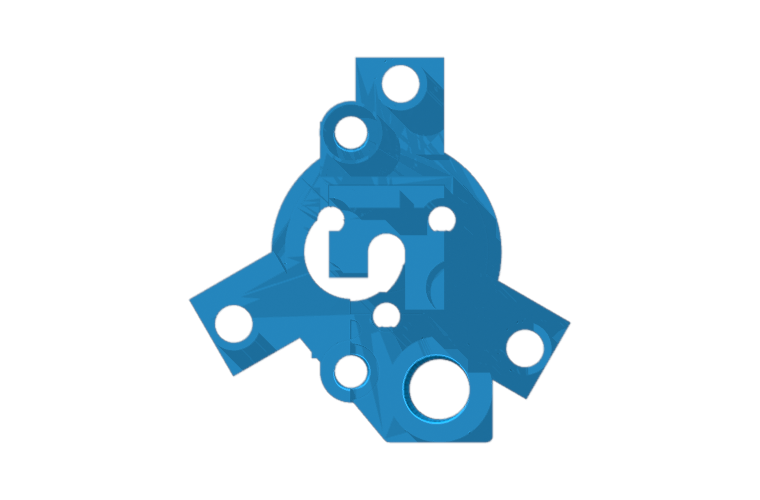
media/parts/P02_plan.png
