vluncasu/SolarSkin/media/parts/P03_iso.png

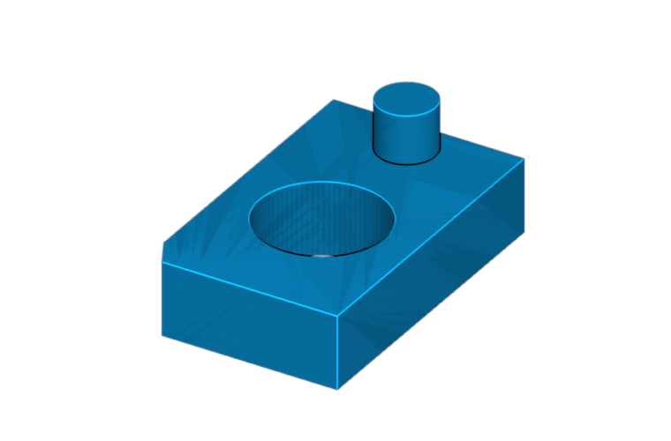
media/parts/P03_iso.png
