vluncasu/SolarSkin/media/parts/P03_plan.png

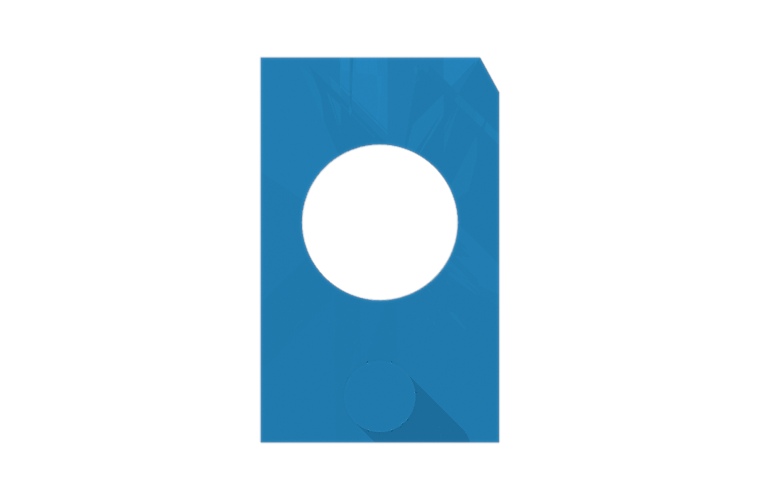
media/parts/P03_plan.png
