vluncasu/SolarSkin/media/parts/P04_iso.png

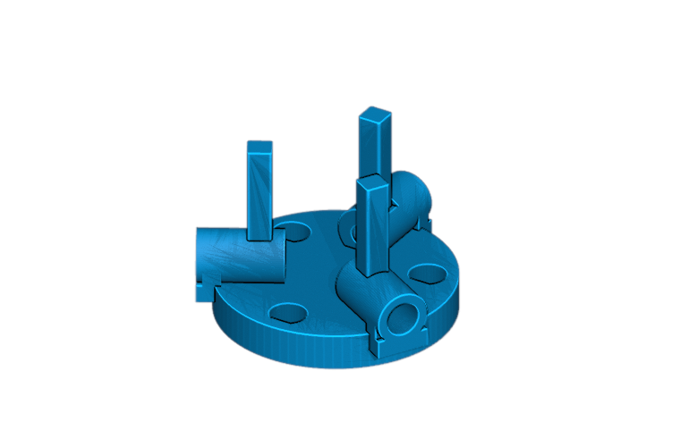
media/parts/P04_iso.png
