vluncasu/SolarSkin/media/parts/P04_plan.png

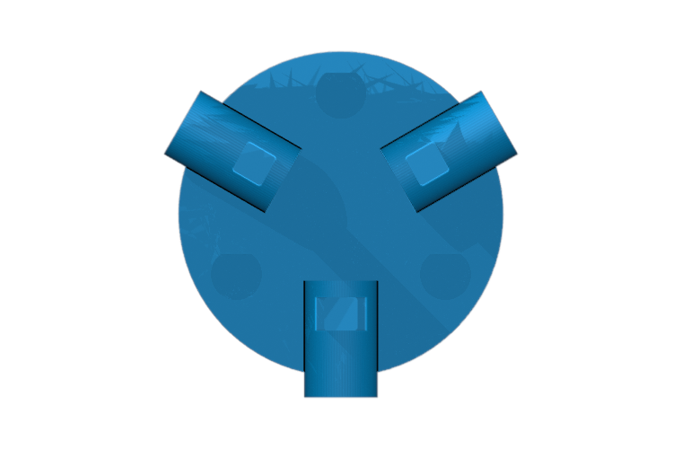
media/parts/P04_plan.png
