vluncasu/SolarSkin/media/parts/P05_iso.png

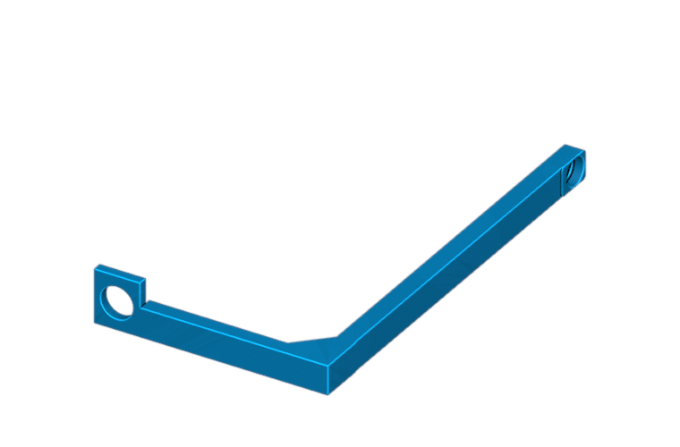
media/parts/P05_iso.png
