vluncasu/SolarSkin/media/parts/P05_plan.png

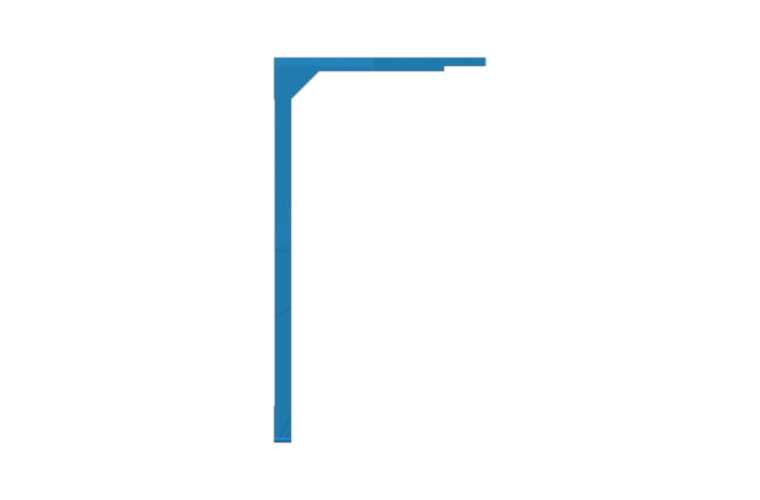
media/parts/P05_plan.png
