vluncasu/SolarSkin/media/parts/P07L_iso.png

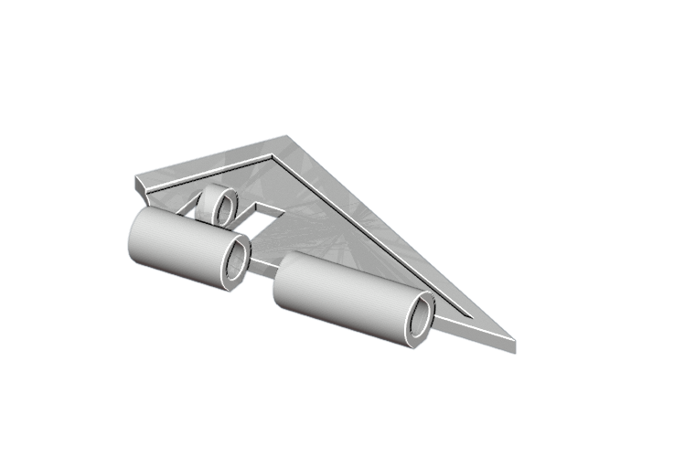
media/parts/P07L_iso.png
