vluncasu/SolarSkin/media/parts/P07L_plan.png

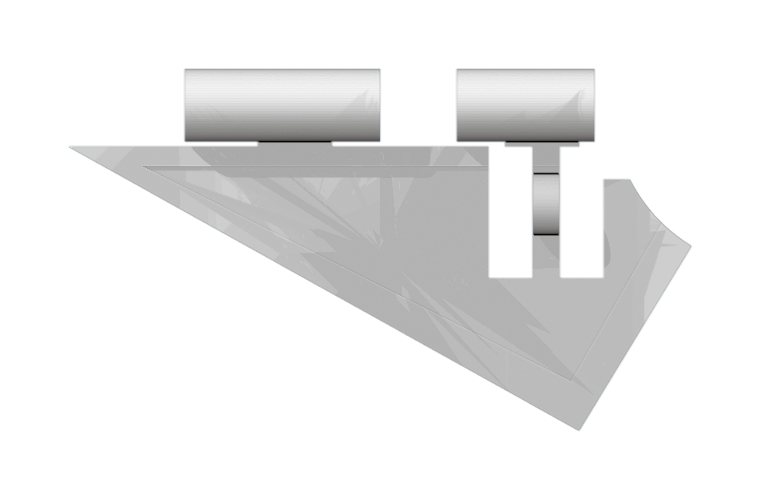
media/parts/P07L_plan.png
