vluncasu/SolarSkin/media/parts/P07R_iso.png

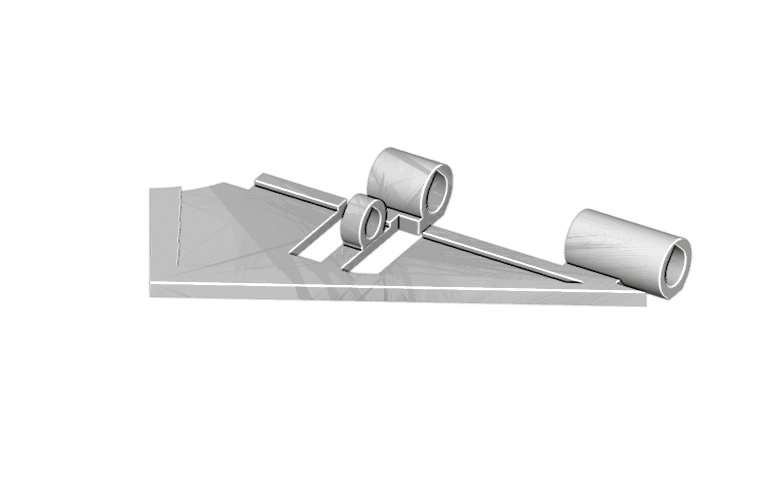
media/parts/P07R_iso.png
