vluncasu/SolarSkin/media/parts/P07R_plan.png

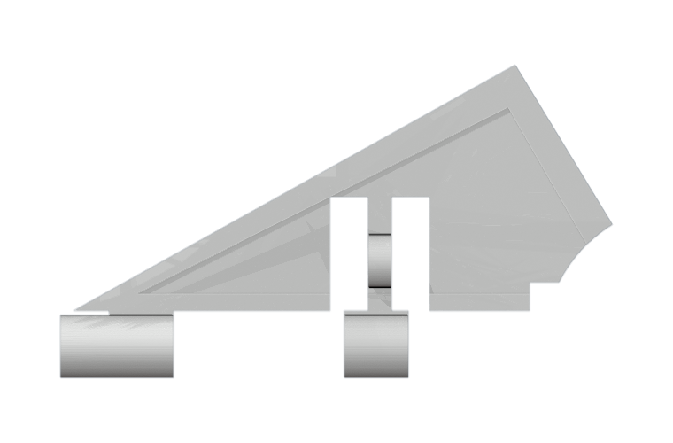
media/parts/P07R_plan.png
