vluncasu/SolarSkin/media/parts/P08_iso.png

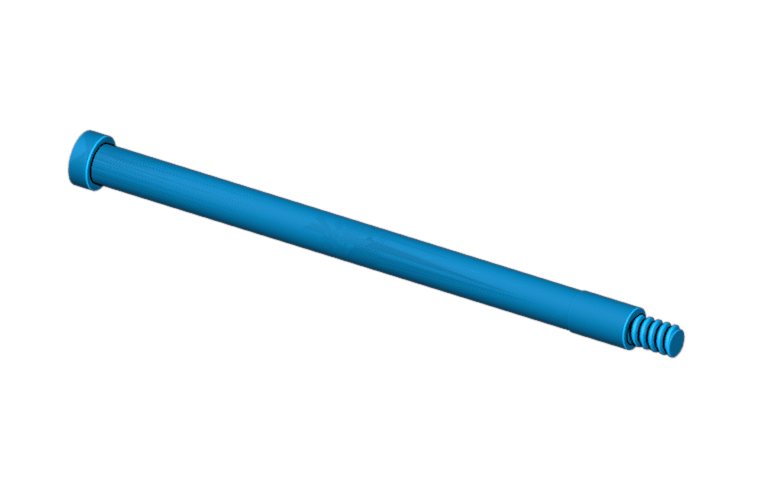
media/parts/P08_iso.png
