vluncasu/SolarSkin/media/parts/P08_plan.png

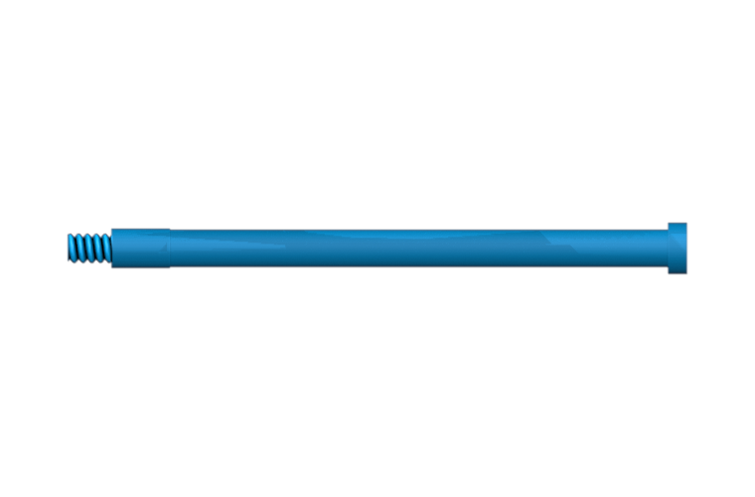
media/parts/P08_plan.png
