vluncasu/SolarSkin/media/parts/P09_plan.png

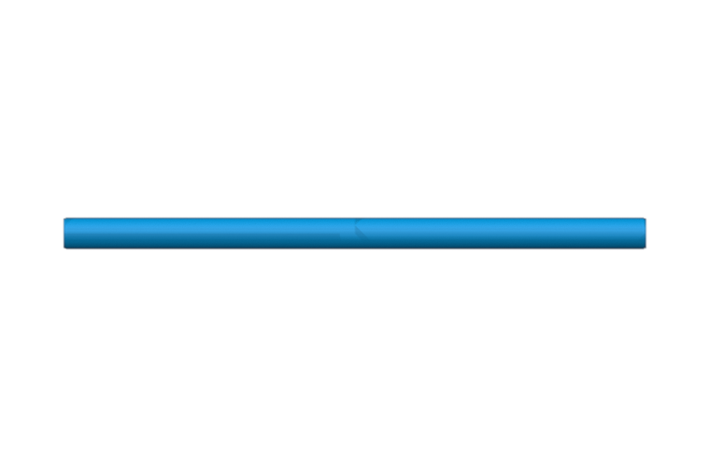
media/parts/P09_plan.png
