vluncasu/SolarSkin/media/parts/P10_iso.png

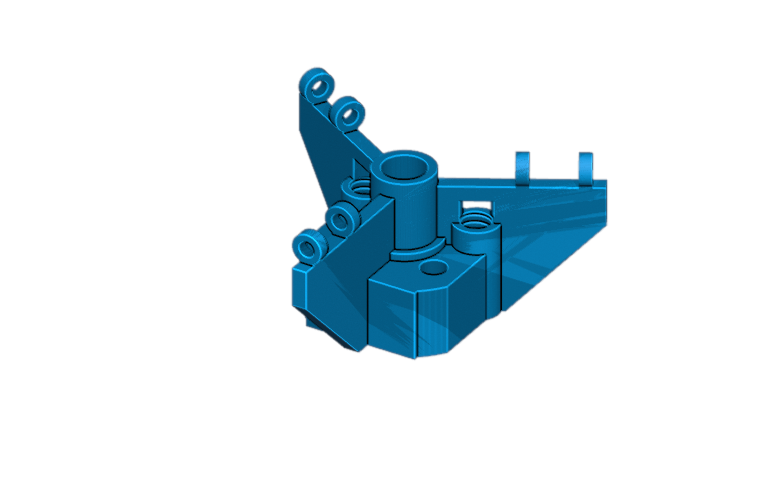
media/parts/P10_iso.png
