vluncasu/SolarSkin/media/parts/P10_plan.png

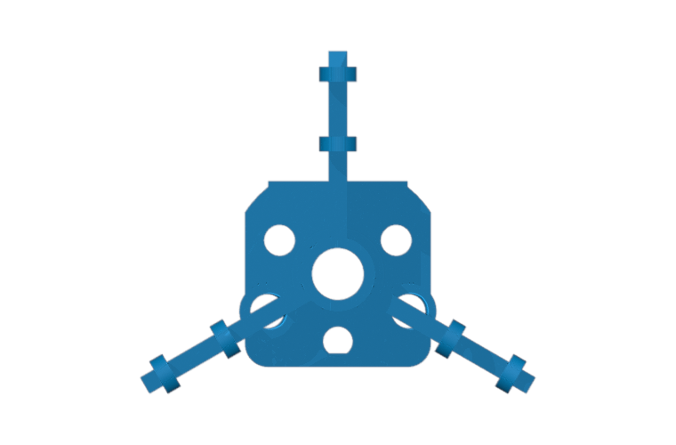
media/parts/P10_plan.png
