vluncasu/SolarSkin/media/parts/P11_iso.png

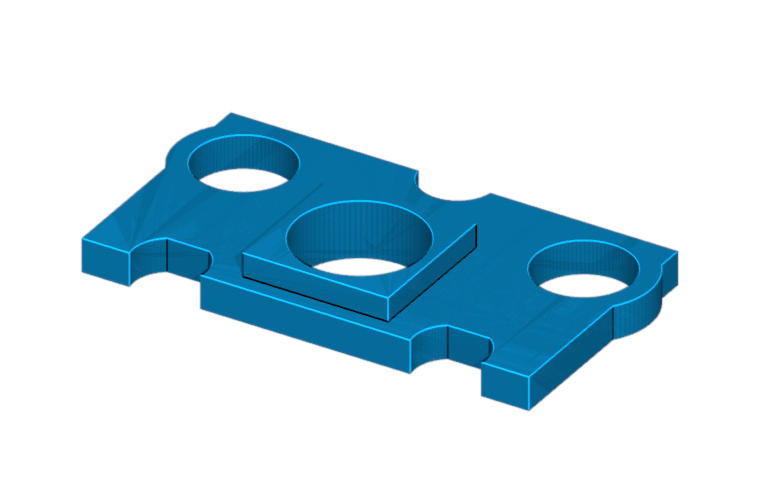
media/parts/P11_iso.png
