vluncasu/SolarSkin/media/parts/P11_plan.png

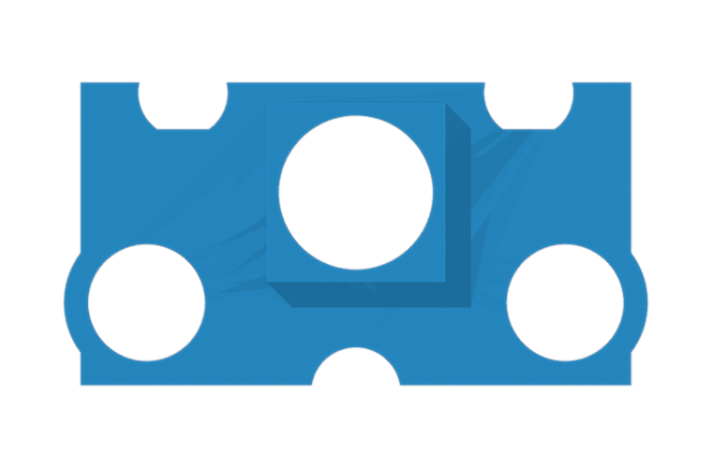
media/parts/P11_plan.png
