vluncasu/SolarSkin/media/parts/P12_iso.png

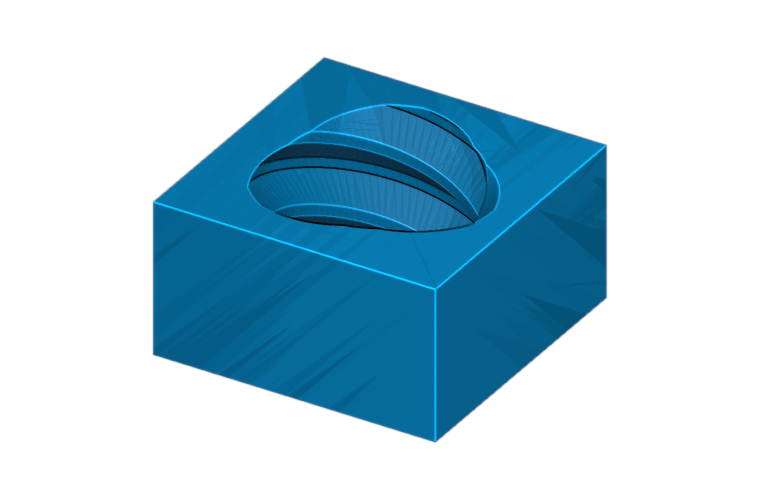
media/parts/P12_iso.png
