vluncasu/SolarSkin/media/parts/P12_plan.png

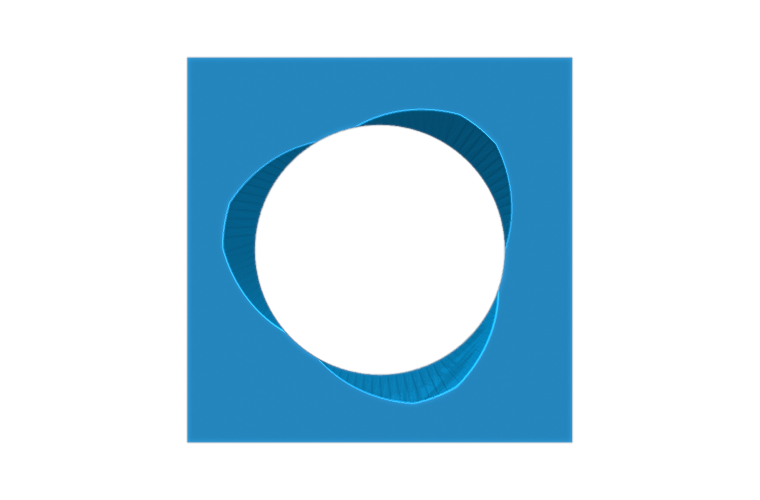
media/parts/P12_plan.png
