vluncasu/SolarSkin/media/parts/P13_iso.png

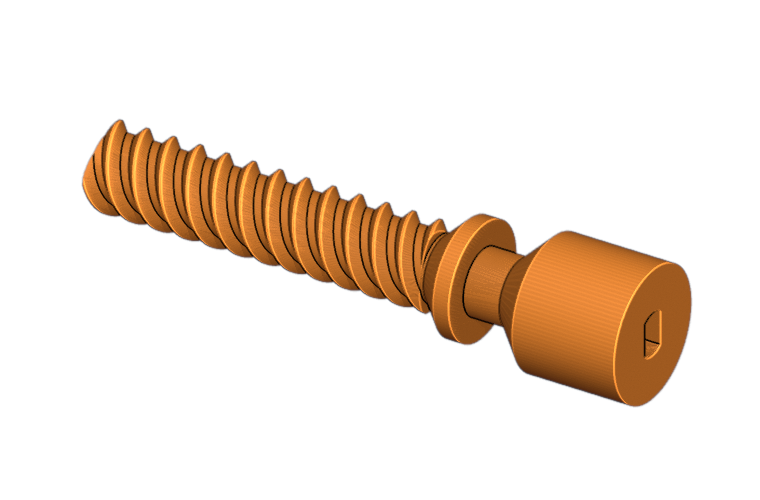
media/parts/P13_iso.png
