vluncasu/SolarSkin/media/parts/P13_plan.png

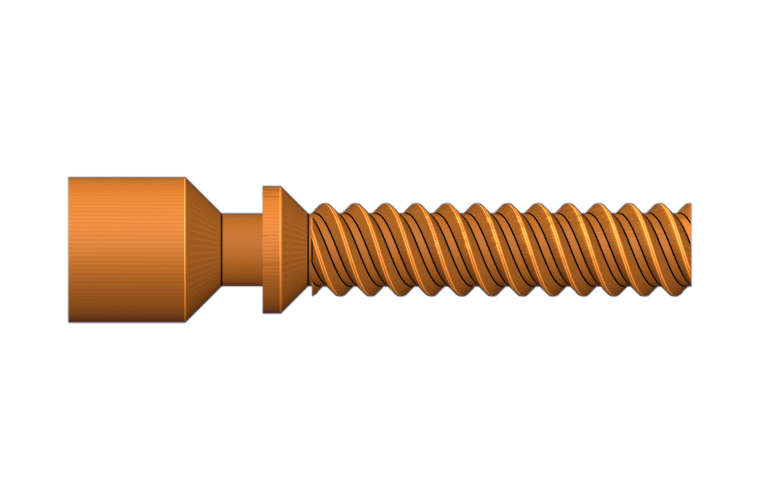
media/parts/P13_plan.png
