vluncasu/SolarSkin/media/parts/P16_iso.png

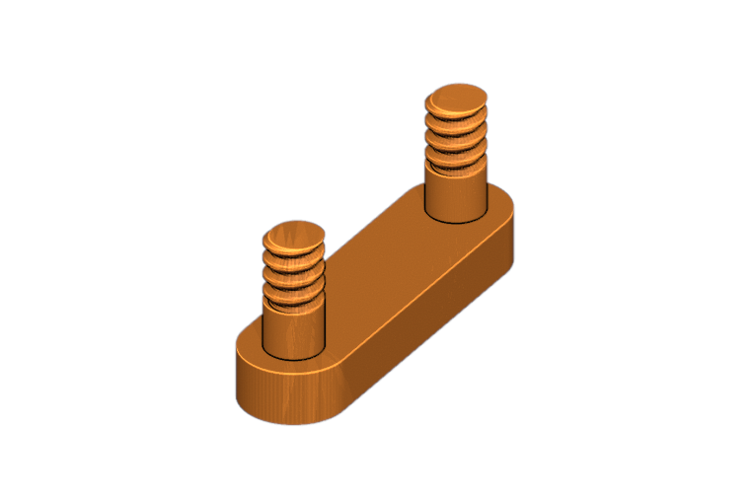
media/parts/P16_iso.png
