vluncasu/SolarSkin/media/parts/P29_iso.png

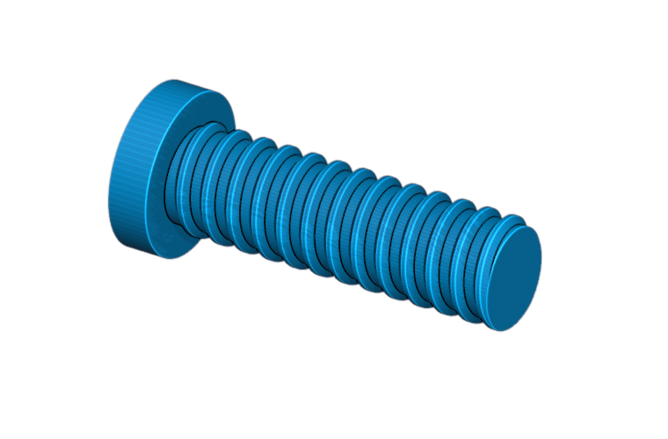
media/parts/P29_iso.png
