vluncasu/SolarSkin/media/parts/P29_plan.png

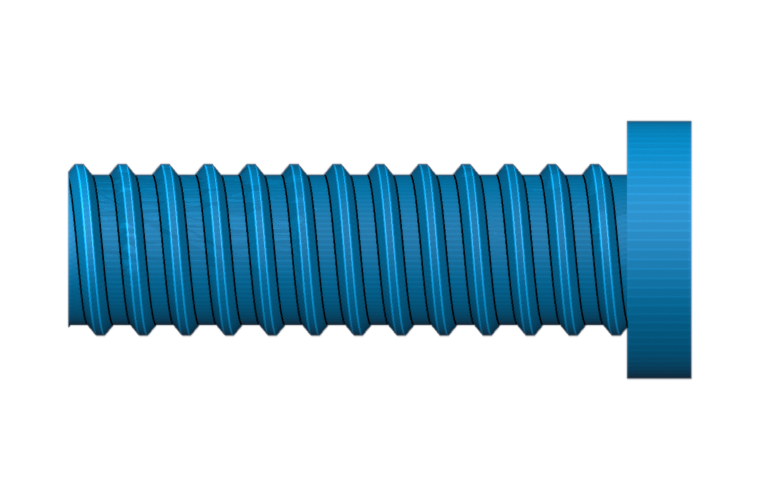
media/parts/P29_plan.png
