vluncasu/SolarSkin/media/parts/P30_iso.png

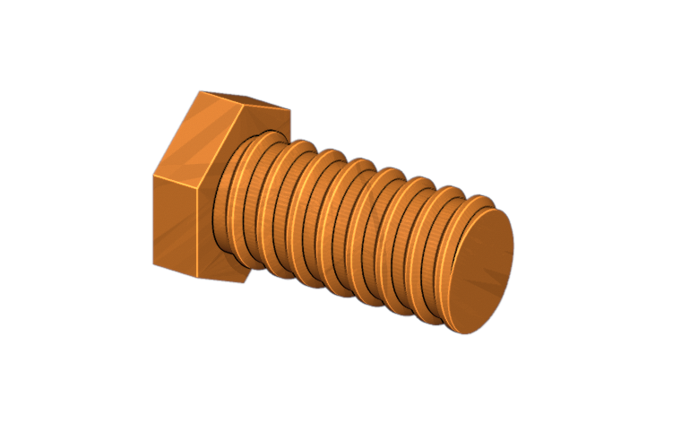
media/parts/P30_iso.png
