vluncasu/SolarSkin/media/parts/P30_plan.png

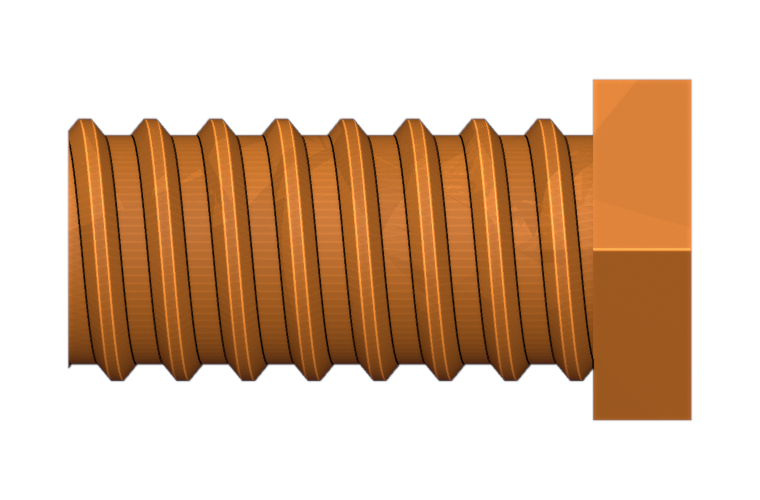
media/parts/P30_plan.png
