vluncasu/SolarSkin/media/parts/P31_iso.png

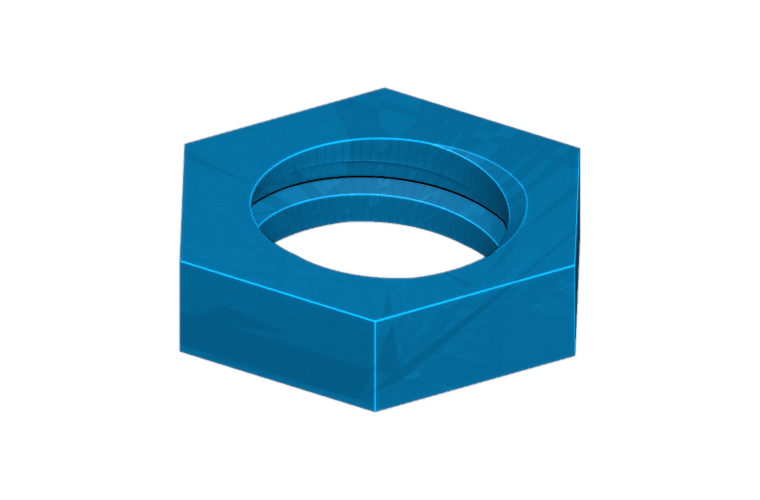
media/parts/P31_iso.png
