vluncasu/SolarSkin/media/parts/P31_plan.png

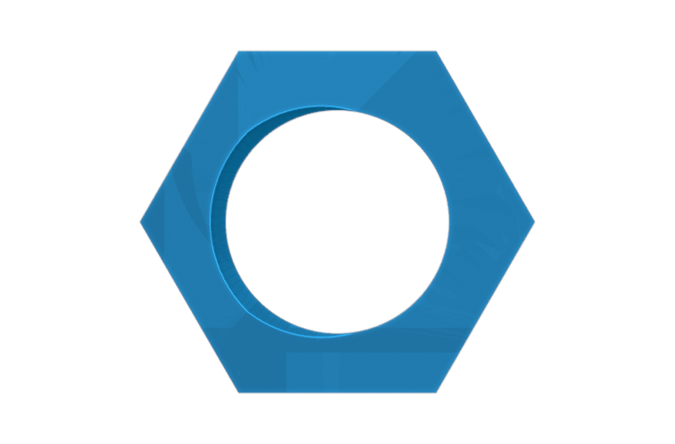
media/parts/P31_plan.png
