vluncasu/SolarSkin/media/parts/P32_plan.png

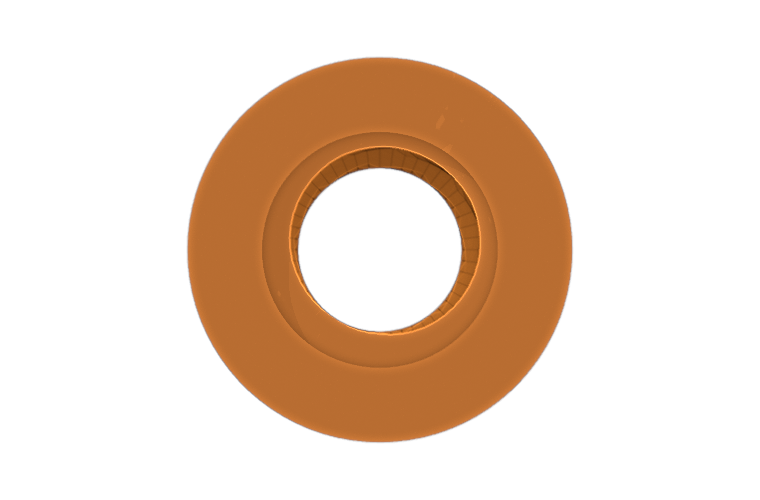
media/parts/P32_plan.png
