vluncasu/SolarSkin/media/parts/P33_iso.png

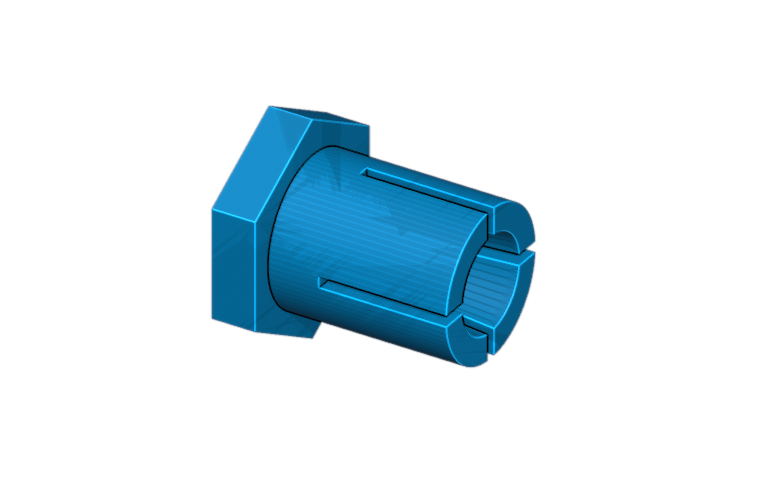
media/parts/P33_iso.png
