vluncasu/SolarSkin/media/parts/P33_plan.png

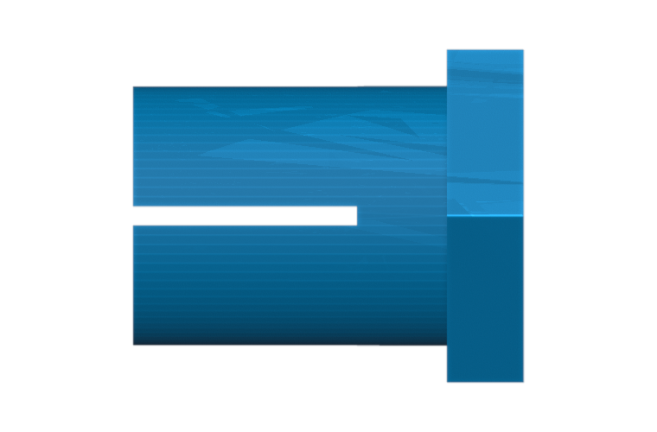
media/parts/P33_plan.png
