vluncasu/SolarSkin/media/parts/P34_iso.png

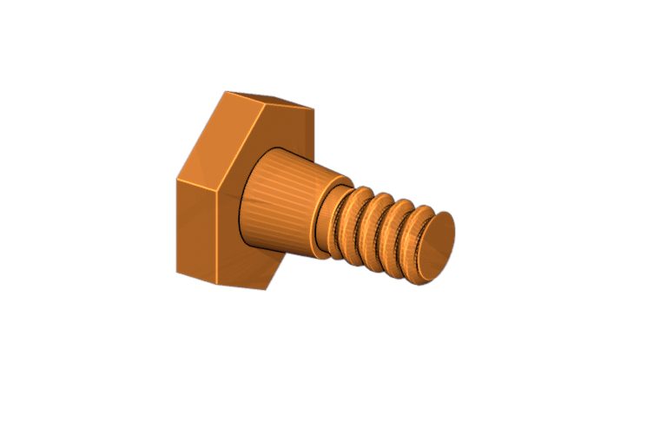
media/parts/P34_iso.png
