vluncasu/SolarSkin/media/parts/P34_plan.png

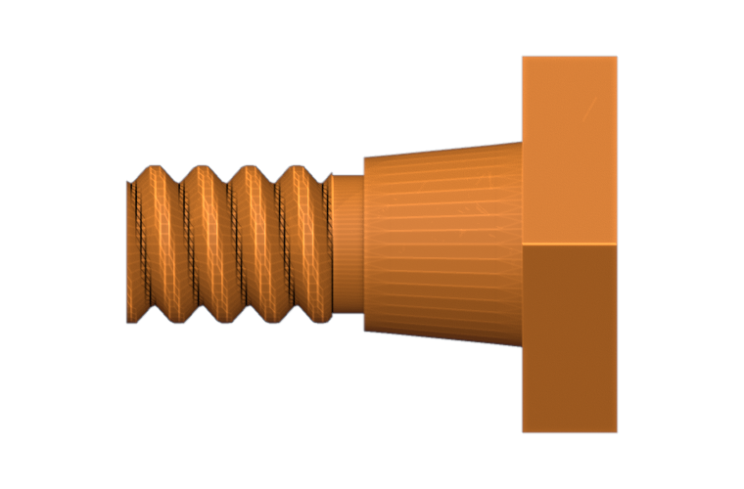
media/parts/P34_plan.png
