vluncasu/SolarSkin/media/parts/P36_plan.png

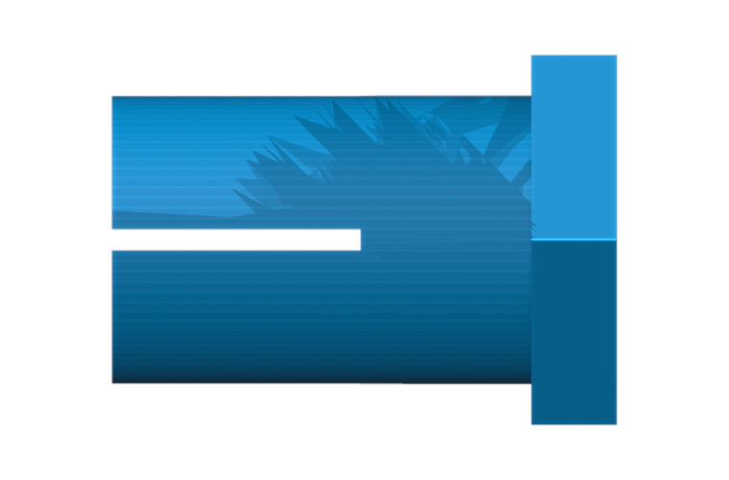
media/parts/P36_plan.png
