vluncasu/SolarSkin/media/parts/P37_plan.png

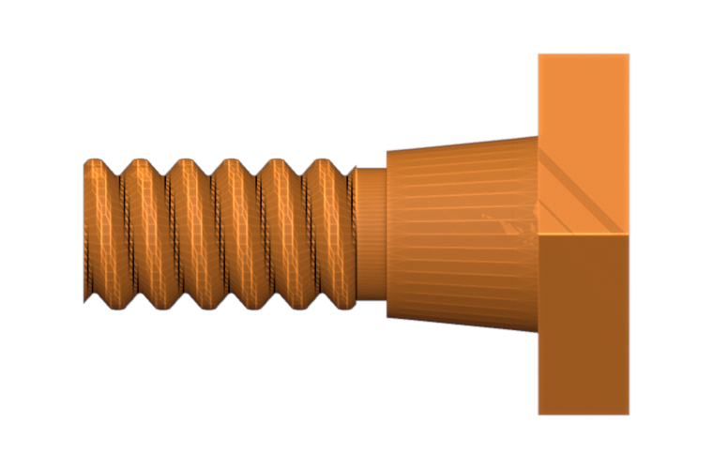
media/parts/P37_plan.png
