vluncasu/SolarSkin/media/parts/P44_iso.png

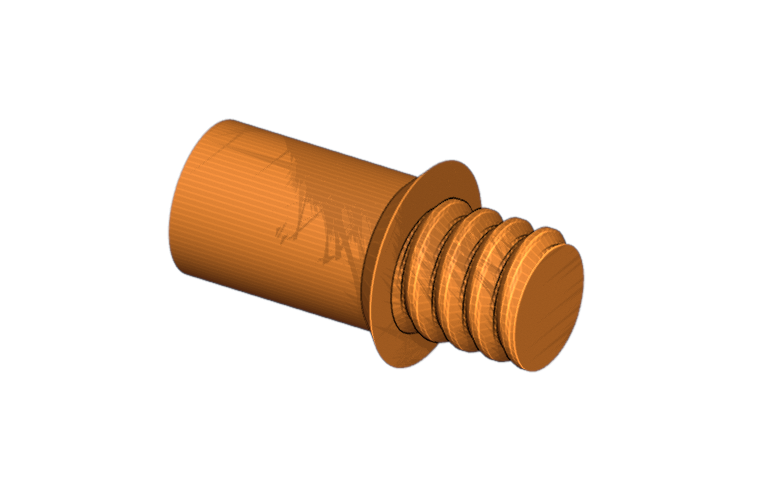
media/parts/P44_iso.png
