vluncasu/SolarSkin/media/parts/P44_plan.png

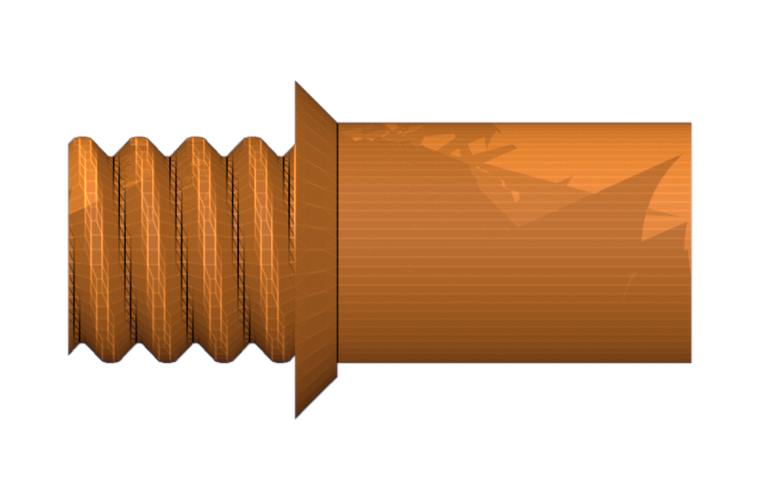
media/parts/P44_plan.png
