vluncasu/SolarSkin/media/parts/P45_iso.png

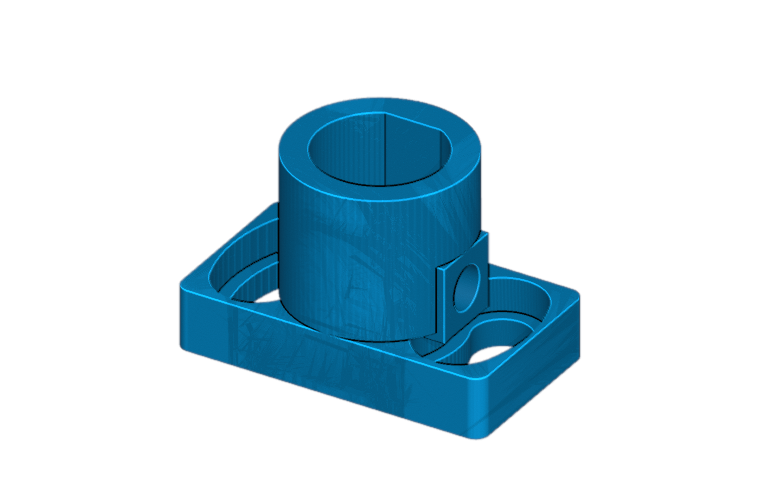
media/parts/P45_iso.png
