vluncasu/SolarSkin/media/parts/P45_plan.png

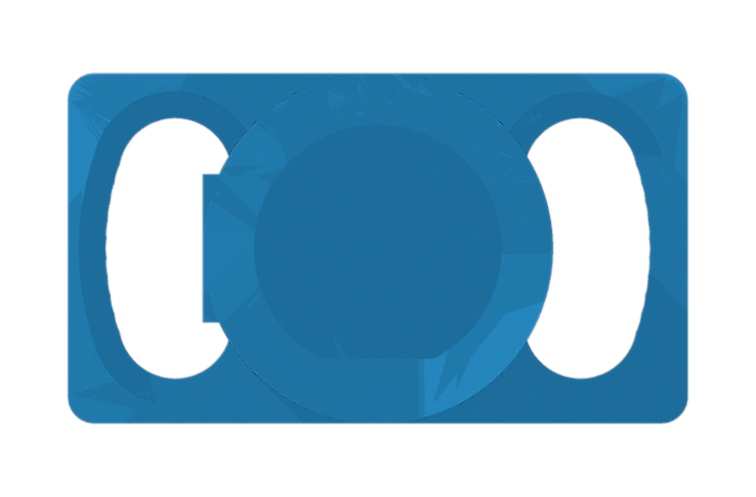
media/parts/P45_plan.png
