vluncasu/SolarSkin/media/parts/P46_plan.png

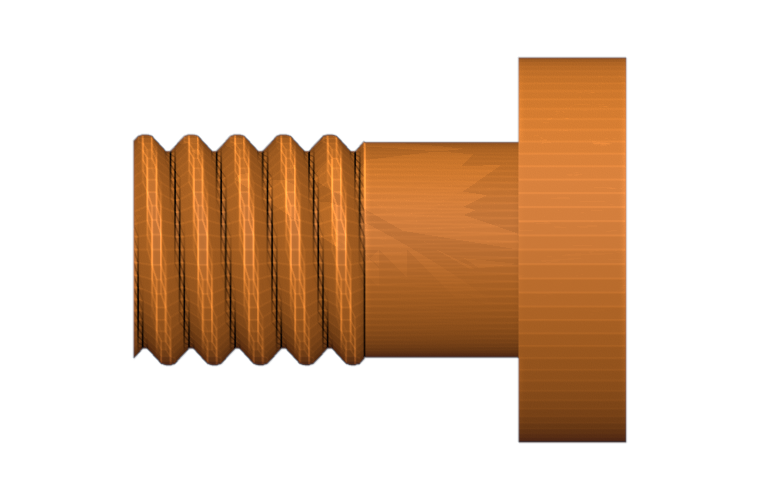
media/parts/P46_plan.png
