vluncasu/SolarSkin/(list of files, cad)

Other CAD files:
cad/original_20_module_building/COMPLETE_BUILDING_R6.FCStd
print/03_reinforcement/white/R26_ASSEMBLY_KEY__qty_01.stl
cad/01_mechanism/MECHANISM_10MM.FCStd
cad/04_building_optional/BUILDING_FACADE.step
print/01_mechanism/one_module/white/P07L_LEFT_WING__qty_03.stl
print/01_mechanism/one_module/windows_blue/P10_CARRIAGE__qty_01.stl
print/02_frame/anthracite/35_F04_FRAME_CASSETTE_C3_N3__qty_01.stl
print/03_reinforcement/anthracite/F18_EXTRA_REAR_FOOT__qty_01.stl
print/03_reinforcement/orange/R24_FOOT_RETAINING_SADDLE__qty_04.stl
print/07_building_optional/anthracite/13_B04_BASE_FAN_INTEGRATED.stl
print/07_building_optional/blue/47_I02_STRIP_BLUE.stl
print/07_building_optional/green/55_I04_ACCENT_MEETING_ROOM_GREEN.stl
print/07_building_optional/orange/52_I04_ACCENT_WORKSHOP_ORANGE.stl
print/07_building_optional/white/46_I02_STRIP_WHITE.stl
print/08_shared_tools/SIDE_CONE_SOCKET_KEY__qty_01.stl
print/09_one_module_plates/windows_blue_plate_2.3mf
print/furnished/bed_38_anthracite_PLA.3mf
print/furnished/parts/F04_CASETA_C2_N4.stl
print/simplified/bed_35_matte_white_PLA.3mf
print/simplified/parts/A04_PORTANT_2_N3.stl
cad/02_frame/parts/28_F04_FRAME_CASSETTE_C1_N4__qty_01.step
cad/04_building_optional/BUILDING.FCStd
print/01_mechanism/one_module/orange/P34_CLAMP_CONE__qty_02.stl
print/01_mechanism/one_module/white/P07R_RIGHT_WING__qty_03.stl
print/01_mechanism/one_module/windows_blue/P04_FRONT_HUB__qty_01.stl
print/02_frame/anthracite/31_F04_FRAME_CASSETTE_C2_N3__qty_01.stl
print/03_reinforcement/anthracite/R22_LEFT_CENTRE_BASE_SUPPORT__qty_02.stl
print/07_building_optional/anthracite/12_B03_BASE_REAR_WITH_FOOT.stl
print/07_building_optional/blue/51_I04_ACCENT_WORKSHOP_BLUE.stl
print/07_building_optional/orange/59_S01_STAIR_FLIGHT_LOWER.stl
print/07_building_optional/white/14_E02_BOX_POWER_SUPPLY_12V.stl
print/08_shared_tools/AXLE_HEAD_FLAT_KEY__qty_01.stl
print/09_one_module_plates/windows_blue_plate_1.3mf
print/furnished/bed_29_anthracite_PLA.3mf
print/furnished/parts/A02_CADRU_SPATE.stl
print/simplified/bed_28_matte_white_PLA.3mf
print/simplified/parts/A04_PORTANT_1_N1.stl
cad/02_frame/parts/36_F04_FRAME_CASSETTE_C3_N4__qty_01.step
print/01_mechanism/one_module/orange/P37_DRIVER_TRAY_CONE__qty_01.stl
print/01_mechanism/one_module/windows_blue/P02_REAR_FRAME__qty_01.stl
print/02_frame/anthracite/25_F04_FRAME_CASSETTE_C1_N1__qty_01.stl
print/02_frame/white/37_F05_VERTICAL_SPLICE__qty_06.stl
print/03_reinforcement/anthracite/R23_RIGHT_REAR_BASE_SUPPORT__qty_02.stl
print/03_reinforcement/white/R04_SIDE_SPLICE__qty_06.stl
print/07_building_optional/orange/60_S02_STAIR_FLIGHT_UPPER.stl
print/07_building_optional/white/43_I01_RECEPTION.stl
print/09_one_module_plates/white_plate_1.3mf
print/furnished/bed_23_matte_white_PLA.3mf
print/furnished/parts/E02_CUTIE_SURSA_12V.stl
print/simplified/bed_54_matte_white_PLA.3mf
print/simplified/parts/E07_CANAL_ACOPERIS_1.stl
cad/02_frame/parts/32_F04_FRAME_CASSETTE_C2_N4__qty_01.step
print/02_frame/anthracite/30_F04_FRAME_CASSETTE_C2_N2__qty_01.stl
print/02_frame/white/68_F17_LONG_RECEIVER_KEY__qty_01.stl
print/03_reinforcement/anthracite/R02_LEFT_RIB__qty_04.stl
print/03_reinforcement/white/R03_FRONT_CLAMP__qty_16.stl
print/07_building_optional/orange/49_I02_STRIP_ORANGE.stl
print/07_building_optional/white/20_E07_CHANNEL_ROOF_2.stl
print/09_one_module_plates/orange_plate_1.3mf
print/furnished/bed_06_matte_white_PLA.3mf
print/furnished/parts/I03_PROTECTIE_GOL_SCARA.stl
print/simplified/bed_24_matte_white_PLA.3mf
print/simplified/parts/B02_TALPA_FATA.stl
cad/02_frame/parts/29_F04_FRAME_CASSETTE_C2_N1__qty_01.step
print/01_mechanism/one_module/orange/P44_FRAME_CONNECTOR__qty_01.stl
print/01_mechanism/one_module/windows_blue/P31_MOTOR_LOCKNUT__qty_02.stl
print/02_frame/anthracite/32_F04_FRAME_CASSETTE_C2_N4__qty_01.stl
print/02_frame/white/38_F06_LONG_SPLICE__qty_02.stl
print/03_reinforcement/anthracite/R31_REAR_FOOT_ADAPTER__qty_01.stl
print/07_building_optional/orange/54_I04_ACCENT_LOUNGE_ORANGE.stl
print/07_building_optional/white/11_A07_FINS_WAVE_FLOOR_TALL.stl
print/furnished/bed_18_matte_white_PLA.3mf
print/furnished/parts/J01_CHEIE_FLUTURE.stl
print/simplified/bed_06_translucent_green_PETG.3mf
print/simplified/parts/V01_VITRAJ_SPATE_INALT.stl
cad/02_frame/parts/65_F14_HEX_KEY__qty_01.step
print/01_mechanism/one_module/orange/P16_LINK_ROD__qty_06.stl
print/01_mechanism/one_module/windows_blue/P11_CARRIAGE_COVER__qty_01.stl
print/02_frame/anthracite/64_F13_PRESENTATION_FOOT__qty_02.stl
print/03_reinforcement/anthracite/R41_CLIP_ON_CABLE_GUIDE__qty_04.stl
print/07_building_optional/orange/16_E04_CLAMP_POWER_SUPPLY.stl
print/07_building_optional/white/41_F11_KEY_TRANSVERSALA.stl
print/furnished/bed_20_matte_white_PLA.3mf
print/furnished/parts/F04_CASETA_C2_N3.stl
print/simplified/bed_41_matte_white_PLA.3mf
print/simplified/parts/T02_TRAPA_ACOPERIS.stl
cad/02_frame/parts/25_F04_FRAME_CASSETTE_C1_N1__qty_01.step
print/01_mechanism/one_module/windows_blue/P45_D_PROFILE_RECEIVER__qty_01.stl
print/02_frame/anthracite/29_F04_FRAME_CASSETTE_C2_N1__qty_01.stl
print/02_frame/white/39_F07_HORIZONTAL_SPLICE__qty_06.stl
print/03_reinforcement/anthracite/R01_RIGHT_RIB__qty_04.stl
print/07_building_optional/white/53_I04_ACCENT_RECEPTION_YELLOW.stl
print/furnished/bed_09_matte_white_PLA.3mf
print/furnished/parts/F04_CASETA_C3_N1.stl
print/simplified/bed_60_anthracite_PLA.3mf
print/simplified/parts/E07_CANAL_ACOPERIS_2.stl
print/02_frame/anthracite/33_F04_FRAME_CASSETTE_C3_N1__qty_01.stl
print/02_frame/white/66_F15_CENTRAL_SPLICE__qty_03.stl
print/07_building_optional/white/45_I01_MEETING_ROOM.stl
print/furnished/bed_24_matte_white_PLA.3mf
print/furnished/parts/A01_PLANSEU_2.stl
print/simplified/bed_51_matte_white_PLA.3mf
print/simplified/parts/A04_PORTANT_3_N1.stl
cad/02_frame/parts/30_F04_FRAME_CASSETTE_C2_N2__qty_01.step
print/01_mechanism/one_module/windows_blue/P33_EXPANSION_BUSHING__qty_02.stl
print/02_frame/anthracite/26_F04_FRAME_CASSETTE_C1_N2__qty_01.stl
print/02_frame/white/40_F10_CAPTIVE_CROSS_MEMBER__qty_12.stl
print/07_building_optional/white/01_A01_ROOF_1.stl
print/furnished/bed_32_anthracite_PLA.3mf
print/furnished/parts/E07_CANAL_ACOPERIS_3.stl
print/simplified/bed_53_matte_white_PLA.3mf
print/simplified/parts/E02_CUTIE_SURSA_12V.stl
cad/02_frame/parts/33_F04_FRAME_CASSETTE_C3_N1__qty_01.step
print/01_mechanism/one_module/windows_blue/P09_D_PROFILE_GUIDE__qty_03.stl
print/02_frame/anthracite/36_F04_FRAME_CASSETTE_C3_N4__qty_01.stl
print/02_frame/white/65_F14_HEX_KEY__qty_01.stl
print/07_building_optional/white/02_A01_ROOF_2.stl
print/furnished/bed_44_orange_PLA.3mf
print/furnished/parts/T02_TRAPA_ACOPERIS.stl
print/simplified/bed_44_matte_white_PLA.3mf
print/simplified/parts/E03_CAPAC_SURSA.stl
cad/02_frame/parts/34_F04_FRAME_CASSETTE_C3_N2__qty_01.step
print/01_mechanism/one_module/windows_blue/P05_PILLAR__qty_03.stl
print/02_frame/anthracite/27_F04_FRAME_CASSETTE_C1_N3__qty_01.stl
print/07_building_optional/white/56_I05_FRAME_SHEET_PETG.stl
print/furnished/bed_35_anthracite_PLA.3mf
print/furnished/parts/A07_LAMELE_UNDA_ETAJ_INALT.stl
print/simplified/bed_31_matte_white_PLA.3mf
print/simplified/parts/E05_CUTIE_COMANDA.stl
cad/02_frame/parts/40_F10_CAPTIVE_CROSS_MEMBER__qty_12.step
print/02_frame/anthracite/69_F18_RIGHT_BASE_FOOT__qty_01.stl
print/07_building_optional/white/04_A01_FLOOR_2.stl
print/furnished/bed_33_anthracite_PLA.3mf
print/simplified/bed_04_translucent_green_PETG.3mf
print/simplified/parts/A04_PORTANT_1_N2.stl
cad/02_frame/parts/26_F04_FRAME_CASSETTE_C1_N2__qty_01.step
print/01_mechanism/one_module/windows_blue/P08_WING_AXLE__qty_03.stl
print/02_frame/anthracite/28_F04_FRAME_CASSETTE_C1_N4__qty_01.stl
print/07_building_optional/white/42_I01_WORKSHOP.stl
print/furnished/bed_26_matte_white_PLA.3mf
print/furnished/parts/E03_CAPAC_SURSA.stl
print/simplified/bed_14_translucent_green_PETG.3mf
print/simplified/parts/A04_PORTANT_2_N1.stl
print/01_mechanism/one_module/windows_blue/E02_DRIVER_COVER__qty_01.stl
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
