vluncasu/SolarSkin/docs/15_print_dimensions.md

# Bed footprint of every supplied STL

Dimensions are measured in the exported orientation, in millimetres. Each row covers one copy.
The 236 mm envelope allows a 10 mm margin on each side of a 256 mm bed.
Z is the build height. Footprint alone cannot establish adhesion or support requirements.

| STL | X | Y | Z | Within margin |
|---|---:|---:|---:|---|
| [P13_THREE_START_LEAD_SCREW__qty_01](../print/01_mechanism/one_module/orange/P13_THREE_START_LEAD_SCREW__qty_01.stl) | 16.0 | 16.0 | 68.3 | Yes |
| [P16_LINK_ROD__qty_06](../print/01_mechanism/one_module/orange/P16_LINK_ROD__qty_06.stl) | 7.4 | 27.4 | 12.0 | Yes |
| [P30_MOTOR_SCREW__qty_02](../print/01_mechanism/one_module/orange/P30_MOTOR_SCREW__qty_02.stl) | 12.0 | 10.4 | 19.0 | Yes |
| [P32_AXLE_NUT__qty_12](../print/01_mechanism/one_module/orange/P32_AXLE_NUT__qty_12.stl) | 8.0 | 8.0 | 5.2 | Yes |
| [P34_CLAMP_CONE__qty_02](../print/01_mechanism/one_module/orange/P34_CLAMP_CONE__qty_02.stl) | 11.0 | 9.5 | 12.4 | Yes |
| [P37_DRIVER_TRAY_CONE__qty_01](../print/01_mechanism/one_module/orange/P37_DRIVER_TRAY_CONE__qty_01.stl) | 11.0 | 9.5 | 14.4 | Yes |
| [P44_FRAME_CONNECTOR__qty_01](../print/01_mechanism/one_module/orange/P44_FRAME_CONNECTOR__qty_01.stl) | 24.0 | 24.0 | 44.0 | Yes |
| [P46_RECEIVER_CROSS_SCREW__qty_01](../print/01_mechanism/one_module/orange/P46_RECEIVER_CROSS_SCREW__qty_01.stl) | 10.0 | 10.0 | 12.8 | Yes |
| [P07L_LEFT_WING__qty_03](../print/01_mechanism/one_module/white/P07L_LEFT_WING__qty_03.stl) | 75.6 | 43.9 | 8.8 | Yes |
| [P07R_RIGHT_WING__qty_03](../print/01_mechanism/one_module/white/P07R_RIGHT_WING__qty_03.stl) | 77.5 | 43.9 | 8.8 | Yes |
| [E01_DRIVER_TRAY__qty_01](../print/01_mechanism/one_module/windows_blue/E01_DRIVER_TRAY__qty_01.stl) | 80.0 | 95.5 | 7.8 | Yes |
| [E02_DRIVER_COVER__qty_01](../print/01_mechanism/one_module/windows_blue/E02_DRIVER_COVER__qty_01.stl) | 80.0 | 95.5 | 17.6 | Yes |
| [E03_DRIVER_COVER_SCREW__qty_03](../print/01_mechanism/one_module/windows_blue/E03_DRIVER_COVER_SCREW__qty_03.stl) | 8.0 | 8.0 | 22.0 | Yes |
| [P02_REAR_FRAME__qty_01](../print/01_mechanism/one_module/windows_blue/P02_REAR_FRAME__qty_01.stl) | 86.2 | 87.0 | 37.5 | Yes |
| [P03_MOTOR_CLAMP__qty_02](../print/01_mechanism/one_module/windows_blue/P03_MOTOR_CLAMP__qty_02.stl) | 13.0 | 21.0 | 8.3 | Yes |
| [P04_FRONT_HUB__qty_01](../print/01_mechanism/one_module/windows_blue/P04_FRONT_HUB__qty_01.stl) | 42.5 | 41.5 | 29.0 | Yes |
| [P05_PILLAR__qty_03](../print/01_mechanism/one_module/windows_blue/P05_PILLAR__qty_03.stl) | 61.0 | 110.9 | 14.0 | Yes |
| [P08_WING_AXLE__qty_03](../print/01_mechanism/one_module/windows_blue/P08_WING_AXLE__qty_03.stl) | 7.0 | 7.0 | 85.0 | Yes |
| [P09_D_PROFILE_GUIDE__qty_03](../print/01_mechanism/one_module/windows_blue/P09_D_PROFILE_GUIDE__qty_03.stl) | 6.0 | 112.7 | 5.4 | Yes |
| [P10_CARRIAGE__qty_01](../print/01_mechanism/one_module/windows_blue/P10_CARRIAGE__qty_01.stl) | 85.1 | 73.8 | 42.2 | Yes |
| [P11_CARRIAGE_COVER__qty_01](../print/01_mechanism/one_module/windows_blue/P11_CARRIAGE_COVER__qty_01.stl) | 42.4 | 22.0 | 5.1 | Yes |
| [P12_LOWER_SPLIT_NUT__qty_01](../print/01_mechanism/one_module/windows_blue/P12_LOWER_SPLIT_NUT__qty_01.stl) | 13.0 | 13.0 | 7.0 | Yes |
| [P26_UPPER_SPLIT_NUT__qty_01](../print/01_mechanism/one_module/windows_blue/P26_UPPER_SPLIT_NUT__qty_01.stl) | 13.0 | 13.0 | 7.0 | Yes |
| [P29_COVER_SCREW__qty_02](../print/01_mechanism/one_module/windows_blue/P29_COVER_SCREW__qty_02.stl) | 12.0 | 12.0 | 29.0 | Yes |
| [P31_MOTOR_LOCKNUT__qty_02](../print/01_mechanism/one_module/windows_blue/P31_MOTOR_LOCKNUT__qty_02.stl) | 13.0 | 11.3 | 3.0 | Yes |
| [P33_EXPANSION_BUSHING__qty_02](../print/01_mechanism/one_module/windows_blue/P33_EXPANSION_BUSHING__qty_02.stl) | 12.0 | 10.4 | 12.2 | Yes |
| [P36_DRIVER_TRAY_BUSHING__qty_01](../print/01_mechanism/one_module/windows_blue/P36_DRIVER_TRAY_BUSHING__qty_01.stl) | 12.0 | 10.4 | 14.2 | Yes |
| [P45_D_PROFILE_RECEIVER__qty_01](../print/01_mechanism/one_module/windows_blue/P45_D_PROFILE_RECEIVER__qty_01.stl) | 46.0 | 26.0 | 30.0 | Yes |
| [25_F04_FRAME_CASSETTE_C1_N1__qty_01](../print/02_frame/anthracite/25_F04_FRAME_CASSETTE_C1_N1__qty_01.stl) | 156.0 | 153.5 | 30.0 | Yes |
| [26_F04_FRAME_CASSETTE_C1_N2__qty_01](../print/02_frame/anthracite/26_F04_FRAME_CASSETTE_C1_N2__qty_01.stl) | 156.0 | 153.5 | 30.0 | Yes |
| [27_F04_FRAME_CASSETTE_C1_N3__qty_01](../print/02_frame/anthracite/27_F04_FRAME_CASSETTE_C1_N3__qty_01.stl) | 156.0 | 153.5 | 30.0 | Yes |
| [28_F04_FRAME_CASSETTE_C1_N4__qty_01](../print/02_frame/anthracite/28_F04_FRAME_CASSETTE_C1_N4__qty_01.stl) | 156.0 | 225.1 | 30.0 | Yes |
| [29_F04_FRAME_CASSETTE_C2_N1__qty_01](../print/02_frame/anthracite/29_F04_FRAME_CASSETTE_C2_N1__qty_01.stl) | 156.0 | 153.5 | 30.0 | Yes |
| [30_F04_FRAME_CASSETTE_C2_N2__qty_01](../print/02_frame/anthracite/30_F04_FRAME_CASSETTE_C2_N2__qty_01.stl) | 156.0 | 153.5 | 30.0 | Yes |
| [31_F04_FRAME_CASSETTE_C2_N3__qty_01](../print/02_frame/anthracite/31_F04_FRAME_CASSETTE_C2_N3__qty_01.stl) | 156.0 | 153.5 | 30.0 | Yes |
| [32_F04_FRAME_CASSETTE_C2_N4__qty_01](../print/02_frame/anthracite/32_F04_FRAME_CASSETTE_C2_N4__qty_01.stl) | 156.0 | 225.1 | 30.0 | Yes |
| [33_F04_FRAME_CASSETTE_C3_N1__qty_01](../print/02_frame/anthracite/33_F04_FRAME_CASSETTE_C3_N1__qty_01.stl) | 156.0 | 153.5 | 13.1 | Yes |
| [34_F04_FRAME_CASSETTE_C3_N2__qty_01](../print/02_frame/anthracite/34_F04_FRAME_CASSETTE_C3_N2__qty_01.stl) | 156.0 | 153.5 | 30.0 | Yes |
| [35_F04_FRAME_CASSETTE_C3_N3__qty_01](../print/02_frame/anthracite/35_F04_FRAME_CASSETTE_C3_N3__qty_01.stl) | 156.0 | 153.5 | 30.0 | Yes |
| [36_F04_FRAME_CASSETTE_C3_N4__qty_01](../print/02_frame/anthracite/36_F04_FRAME_CASSETTE_C3_N4__qty_01.stl) | 156.0 | 225.1 | 30.0 | Yes |
| [64_F13_PRESENTATION_FOOT__qty_02](../print/02_frame/anthracite/64_F13_PRESENTATION_FOOT__qty_02.stl) | 156.0 | 246.0 | 86.0 | Review |
| [69_F18_RIGHT_BASE_FOOT__qty_01](../print/02_frame/anthracite/69_F18_RIGHT_BASE_FOOT__qty_01.stl) | 156.0 | 246.0 | 86.0 | Review |
| [23_F01_RECEIVER_BOLT__qty_32](../print/02_frame/white/23_F01_RECEIVER_BOLT__qty_32.stl) | 5.8 | 10.4 | 18.4 | Yes |
| [24_F02_DOUBLE_RECEIVER_NUT__qty_16](../print/02_frame/white/24_F02_DOUBLE_RECEIVER_NUT__qty_16.stl) | 42.0 | 10.0 | 15.1 | Yes |
| [37_F05_VERTICAL_SPLICE__qty_06](../print/02_frame/white/37_F05_VERTICAL_SPLICE__qty_06.stl) | 25.6 | 119.6 | 6.0 | Yes |
| [38_F06_LONG_SPLICE__qty_02](../print/02_frame/white/38_F06_LONG_SPLICE__qty_02.stl) | 25.6 | 191.2 | 6.0 | Yes |
| [39_F07_HORIZONTAL_SPLICE__qty_06](../print/02_frame/white/39_F07_HORIZONTAL_SPLICE__qty_06.stl) | 22.0 | 88.0 | 6.0 | Yes |
| [40_F10_CAPTIVE_CROSS_MEMBER__qty_12](../print/02_frame/white/40_F10_CAPTIVE_CROSS_MEMBER__qty_12.stl) | 132.0 | 29.6 | 18.5 | Yes |
| [63_F12_FRAME_BOLT__qty_38](../print/02_frame/white/63_F12_FRAME_BOLT__qty_38.stl) | 9.4 | 9.4 | 15.0 | Yes |
| [65_F14_HEX_KEY__qty_01](../print/02_frame/white/65_F14_HEX_KEY__qty_01.stl) | 18.0 | 38.0 | 3.9 | Yes |
| [66_F15_CENTRAL_SPLICE__qty_03](../print/02_frame/white/66_F15_CENTRAL_SPLICE__qty_03.stl) | 22.0 | 52.0 | 6.0 | Yes |
| [67_F16_RECESSED_HEAD_BOLT__qty_36](../print/02_frame/white/67_F16_RECESSED_HEAD_BOLT__qty_36.stl) | 8.2 | 8.2 | 11.5 | Yes |
| [68_F17_LONG_RECEIVER_KEY__qty_01](../print/02_frame/white/68_F17_LONG_RECEIVER_KEY__qty_01.stl) | 12.0 | 67.0 | 3.0 | Yes |
| [F18_EXTRA_REAR_FOOT__qty_01](../print/03_reinforcement/anthracite/F18_EXTRA_REAR_FOOT__qty_01.stl) | 156.0 | 246.0 | 86.0 | Review |
| [R01_RIGHT_RIB__qty_04](../print/03_reinforcement/anthracite/R01_RIGHT_RIB__qty_04.stl) | 169.6 | 35.5 | 24.3 | Yes |
| [R02_LEFT_RIB__qty_04](../print/03_reinforcement/anthracite/R02_LEFT_RIB__qty_04.stl) | 169.6 | 35.5 | 24.3 | Yes |
| [R22_LEFT_CENTRE_BASE_SUPPORT__qty_02](../print/03_reinforcement/anthracite/R22_LEFT_CENTRE_BASE_SUPPORT__qty_02.stl) | 156.0 | 246.0 | 18.0 | Review |
| [R23_RIGHT_REAR_BASE_SUPPORT__qty_02](../print/03_reinforcement/anthracite/R23_RIGHT_REAR_BASE_SUPPORT__qty_02.stl) | 156.0 | 246.0 | 18.0 | Review |
| [R31_REAR_FOOT_ADAPTER__qty_01](../print/03_reinforcement/anthracite/R31_REAR_FOOT_ADAPTER__qty_01.stl) | 164.7 | 148.6 | 44.0 | Yes |
| [R41_CLIP_ON_CABLE_GUIDE__qty_04](../print/03_reinforcement/anthracite/R41_CLIP_ON_CABLE_GUIDE__qty_04.stl) | 20.0 | 22.8 | 8.0 | Yes |
| [R24_FOOT_RETAINING_SADDLE__qty_04](../print/03_reinforcement/orange/R24_FOOT_RETAINING_SADDLE__qty_04.stl) | 54.0 | 12.0 | 19.9 | Yes |
| [R03_FRONT_CLAMP__qty_16](../print/03_reinforcement/white/R03_FRONT_CLAMP__qty_16.stl) | 24.3 | 30.0 | 3.0 | Yes |
| [R04_SIDE_SPLICE__qty_06](../print/03_reinforcement/white/R04_SIDE_SPLICE__qty_06.stl) | 56.0 | 35.5 | 4.0 | Yes |
| [R05_SHORT_SCREW_15MM__qty_34](../print/03_reinforcement/white/R05_SHORT_SCREW_15MM__qty_34.stl) | 9.4 | 9.4 | 15.0 | Yes |
| [R21_LONG_SCREW_18_8MM__qty_26](../print/03_reinforcement/white/R21_LONG_SCREW_18_8MM__qty_26.stl) | 9.4 | 9.4 | 18.8 | Yes |
| [R25_FOOT_SCREW_61MM__qty_08](../print/03_reinforcement/white/R25_FOOT_SCREW_61MM__qty_08.stl) | 12.5 | 12.5 | 61.0 | Yes |
| [R26_ASSEMBLY_KEY__qty_01](../print/03_reinforcement/white/R26_ASSEMBLY_KEY__qty_01.stl) | 24.0 | 50.7 | 5.2 | Yes |
| [12_B03_BASE_REAR_WITH_FOOT](../print/07_building_optional/anthracite/12_B03_BASE_REAR_WITH_FOOT.stl) | 156.0 | 14.0 | 17.4 | Yes |
| [13_B04_BASE_FAN_INTEGRATED](../print/07_building_optional/anthracite/13_B04_BASE_FAN_INTEGRATED.stl) | 156.0 | 175.2 | 17.4 | Yes |
| [47_I02_STRIP_BLUE](../print/07_building_optional/blue/47_I02_STRIP_BLUE.stl) | 94.0 | 4.0 | 4.4 | Yes |
| [51_I04_ACCENT_WORKSHOP_BLUE](../print/07_building_optional/blue/51_I04_ACCENT_WORKSHOP_BLUE.stl) | 91.6 | 17.0 | 0.8 | Yes |
| [55_I04_ACCENT_MEETING_ROOM_GREEN](../print/07_building_optional/green/55_I04_ACCENT_MEETING_ROOM_GREEN.stl) | 59.6 | 19.6 | 0.2 | Yes |
| [16_E04_CLAMP_POWER_SUPPLY](../print/07_building_optional/orange/16_E04_CLAMP_POWER_SUPPLY.stl) | 114.6 | 50.3 | 5.0 | Yes |
| [49_I02_STRIP_ORANGE](../print/07_building_optional/orange/49_I02_STRIP_ORANGE.stl) | 94.0 | 4.0 | 4.4 | Yes |
| [52_I04_ACCENT_WORKSHOP_ORANGE](../print/07_building_optional/orange/52_I04_ACCENT_WORKSHOP_ORANGE.stl) | 91.6 | 17.0 | 0.8 | Yes |
| [54_I04_ACCENT_LOUNGE_ORANGE](../print/07_building_optional/orange/54_I04_ACCENT_LOUNGE_ORANGE.stl) | 41.6 | 11.4 | 0.8 | Yes |
| [59_S01_STAIR_FLIGHT_LOWER](../print/07_building_optional/orange/59_S01_STAIR_FLIGHT_LOWER.stl) | 82.7 | 112.0 | 30.0 | Yes |
| [60_S02_STAIR_FLIGHT_UPPER](../print/07_building_optional/orange/60_S02_STAIR_FLIGHT_UPPER.stl) | 77.7 | 112.0 | 26.0 | Yes |
| [01_A01_ROOF_1](../print/07_building_optional/white/01_A01_ROOF_1.stl) | 235.6 | 4.6 | 182.0 | Yes |
| [02_A01_ROOF_2](../print/07_building_optional/white/02_A01_ROOF_2.stl) | 235.6 | 4.6 | 182.0 | Yes |
| [03_A01_FLOOR_1](../print/07_building_optional/white/03_A01_FLOOR_1.stl) | 235.6 | 4.6 | 183.6 | Yes |
| [04_A01_FLOOR_2](../print/07_building_optional/white/04_A01_FLOOR_2.stl) | 235.6 | 4.6 | 183.6 | Yes |
| [05_A01_GROUND_FLOOR_1](../print/07_building_optional/white/05_A01_GROUND_FLOOR_1.stl) | 235.6 | 4.6 | 183.6 | Yes |
| [06_A01_GROUND_FLOOR_2](../print/07_building_optional/white/06_A01_GROUND_FLOOR_2.stl) | 235.6 | 4.6 | 183.6 | Yes |
| [07_A02_FRAME_REAR](../print/07_building_optional/white/07_A02_FRAME_REAR.stl) | 156.0 | 151.9 | 5.0 | Yes |
| [08_A02_FRAME_REAR_TALL](../print/07_building_optional/white/08_A02_FRAME_REAR_TALL.stl) | 156.0 | 223.5 | 5.0 | Yes |
| [09_A05_FINS_WAVE_RISING](../print/07_building_optional/white/09_A05_FINS_WAVE_RISING.stl) | 152.0 | 151.9 | 14.0 | Yes |
| [10_A06_FINS_WAVE_FALLING](../print/07_building_optional/white/10_A06_FINS_WAVE_FALLING.stl) | 152.0 | 151.9 | 13.9 | Yes |
| [11_A07_FINS_WAVE_FLOOR_TALL](../print/07_building_optional/white/11_A07_FINS_WAVE_FLOOR_TALL.stl) | 152.0 | 223.5 | 13.9 | Yes |
| [14_E02_BOX_POWER_SUPPLY_12V](../print/07_building_optional/white/14_E02_BOX_POWER_SUPPLY_12V.stl) | 138.0 | 105.0 | 52.0 | Yes |
| [15_E03_LID_POWER_SUPPLY](../print/07_building_optional/white/15_E03_LID_POWER_SUPPLY.stl) | 138.0 | 105.0 | 3.8 | Yes |
| [17_E05_BOX_CONTROLLER](../print/07_building_optional/white/17_E05_BOX_CONTROLLER.stl) | 164.0 | 134.0 | 33.0 | Yes |
| [18_E06_LID_CONTROLLER](../print/07_building_optional/white/18_E06_LID_CONTROLLER.stl) | 164.0 | 75.0 | 3.8 | Yes |
| [19_E07_CHANNEL_ROOF_1](../print/07_building_optional/white/19_E07_CHANNEL_ROOF_1.stl) | 156.0 | 14.0 | 5.0 | Yes |
| [20_E07_CHANNEL_ROOF_2](../print/07_building_optional/white/20_E07_CHANNEL_ROOF_2.stl) | 156.0 | 14.0 | 5.0 | Yes |
| [21_E07_CHANNEL_ROOF_3](../print/07_building_optional/white/21_E07_CHANNEL_ROOF_3.stl) | 156.0 | 14.0 | 5.0 | Yes |
| [22_E08_LID_CHANNEL_ROOF](../print/07_building_optional/white/22_E08_LID_CHANNEL_ROOF.stl) | 156.0 | 14.0 | 0.6 | Yes |
| [41_F11_KEY_TRANSVERSALA](../print/07_building_optional/white/41_F11_KEY_TRANSVERSALA.stl) | 132.0 | 17.2 | 3.2 | Yes |
| [42_I01_WORKSHOP](../print/07_building_optional/white/42_I01_WORKSHOP.stl) | 110.0 | 70.0 | 42.8 | Yes |
| [43_I01_RECEPTION](../print/07_building_optional/white/43_I01_RECEPTION.stl) | 110.0 | 70.0 | 42.8 | Yes |
| [44_I01_LOUNGE](../print/07_building_optional/white/44_I01_LOUNGE.stl) | 110.0 | 70.0 | 42.8 | Yes |
| [45_I01_MEETING_ROOM](../print/07_building_optional/white/45_I01_MEETING_ROOM.stl) | 110.0 | 70.0 | 42.8 | Yes |
| [46_I02_STRIP_WHITE](../print/07_building_optional/white/46_I02_STRIP_WHITE.stl) | 94.0 | 4.0 | 4.4 | Yes |
| [48_I02_STRIP_YELLOW](../print/07_building_optional/white/48_I02_STRIP_YELLOW.stl) | 94.0 | 4.0 | 4.4 | Yes |
| [50_I03_GUARD_OPENING_STAIR](../print/07_building_optional/white/50_I03_GUARD_OPENING_STAIR.stl) | 64.4 | 104.4 | 25.2 | Yes |
| [53_I04_ACCENT_RECEPTION_YELLOW](../print/07_building_optional/white/53_I04_ACCENT_RECEPTION_YELLOW.stl) | 41.6 | 35.6 | 0.8 | Yes |
| [56_I05_FRAME_SHEET_PETG](../print/07_building_optional/white/56_I05_FRAME_SHEET_PETG.stl) | 59.6 | 19.6 | 0.6 | Yes |
| [58_J04_KEY_FLOOR_SLAB_U](../print/07_building_optional/white/58_J04_KEY_FLOOR_SLAB_U.stl) | 57.7 | 166.5 | 1.4 | Yes |
| [61_S03_RAILING_SEPARATE](../print/07_building_optional/white/61_S03_RAILING_SEPARATE.stl) | 89.8 | 88.0 | 1.2 | Yes |
| [62_T02_HATCH_ROOF](../print/07_building_optional/white/62_T02_HATCH_ROOF.stl) | 66.0 | 112.0 | 2.8 | Yes |
| [AXLE_HEAD_FLAT_KEY__qty_01](../print/08_shared_tools/AXLE_HEAD_FLAT_KEY__qty_01.stl) | 28.0 | 13.0 | 5.0 | Yes |
| [SIDE_CONE_SOCKET_KEY__qty_01](../print/08_shared_tools/SIDE_CONE_SOCKET_KEY__qty_01.stl) | 40.0 | 14.6 | 22.0 | Yes |
