vluncasu/SolarSkin/docs/20_building_views.md

# Building views

The exterior survey uses eight camera positions, 45 degrees apart. Each camera looks slightly down on the building. The roof and underside views complete the set. Left and right refer to the sides seen when facing the facade. The model stays in one pose throughout the survey. In the motion previews on the homepage, the camera stays still while the mechanism moves.

[Original twenty-module office](#original-twenty-module-office) · [Compact office](#compact-office) · [Aurora pavilion](#aurora-pavilion) · [Rigid office](#rigid-office) · [Nine-module office](#nine-module-office) · [Furnished office](#furnished-office) · [Simplified office](#simplified-office) · [Independent stand](#independent-stand)

## Original twenty-module office

| Front | Front right quarter |
|---|---|
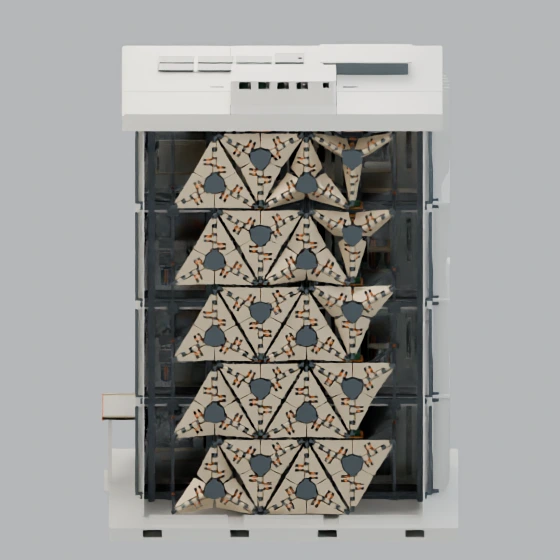
[picture p396: media/views/original20_front.webp]
Front
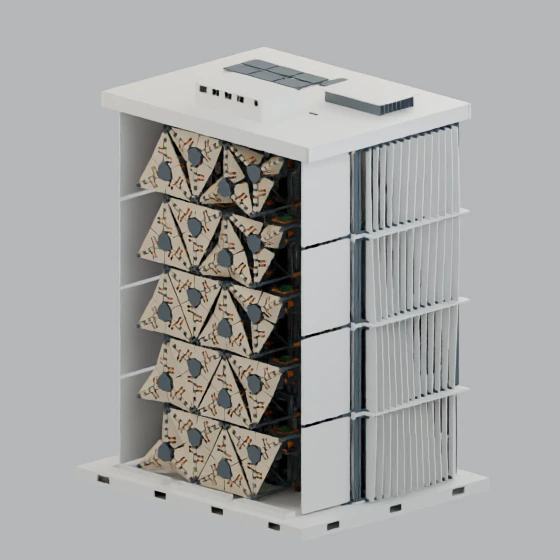
[picture p397: media/views/original20_front-quarter-a.webp]
Front right quarter
|  |  |

| Right elevation | Rear right quarter |
|---|---|
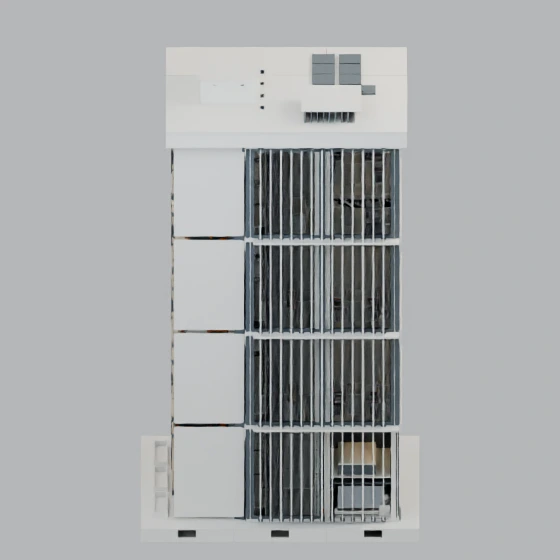
[picture p398: media/views/original20_side-a.webp]
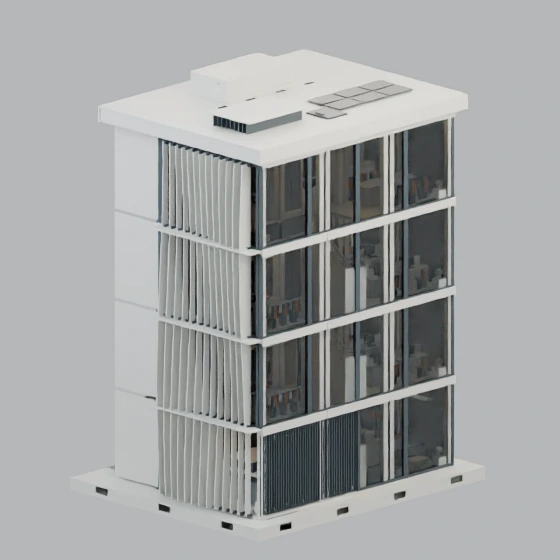
[picture p399: media/views/original20_rear-quarter-a.webp]
Rear right quarter
|  |  |

| Rear | Rear left quarter |
|---|---|
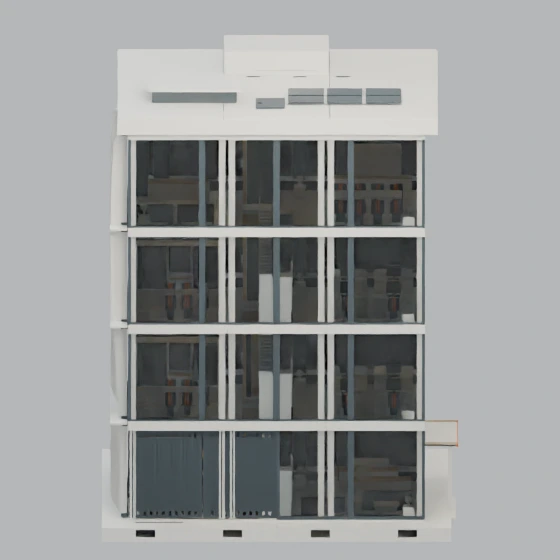
[picture p400: media/views/original20_rear.webp]
Rear
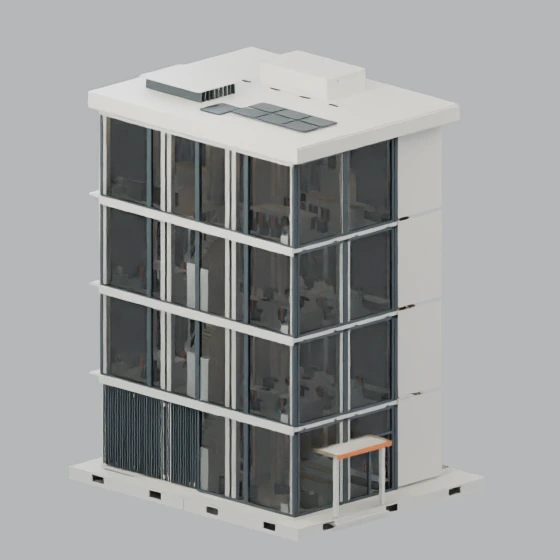
[picture p401: media/views/original20_rear-quarter-b.webp]
Rear left quarter
|  |  |

| Left elevation | Front left quarter |
|---|---|
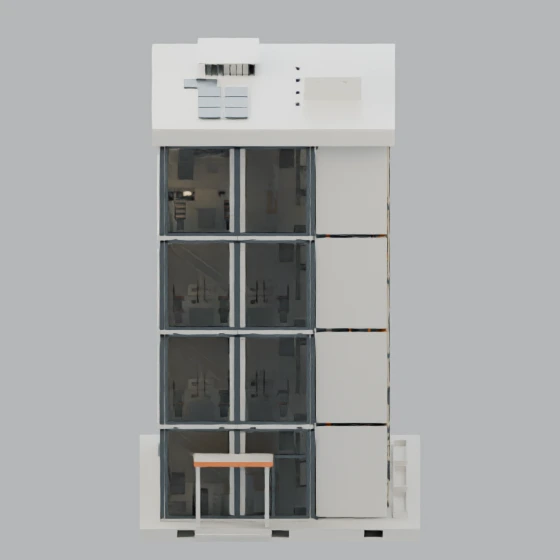
[picture p402: media/views/original20_side-b.webp]
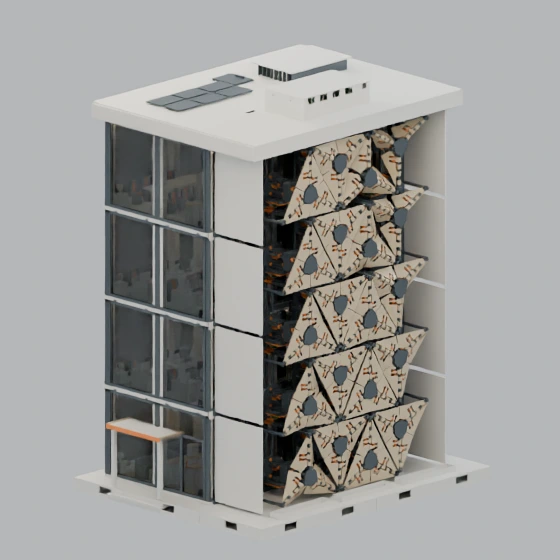
[picture p403: media/views/original20_front-quarter-b.webp]
Front left quarter
|  |  |

| Roof plan | Underside |
|---|---|
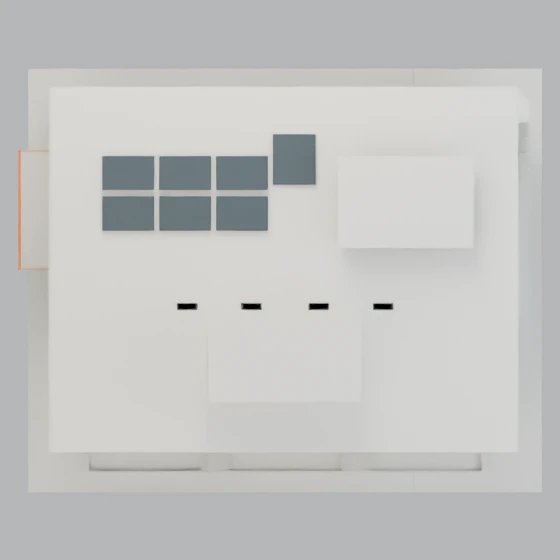
[picture p404: media/views/original20_roof.webp]
Roof plan
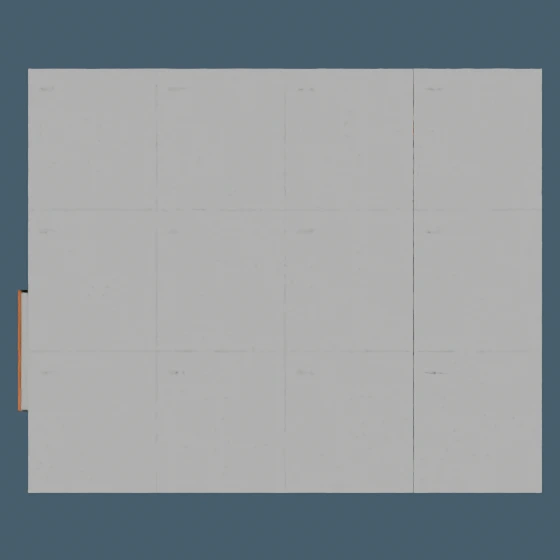
[picture p405: media/views/original20_underside.webp]
Underside
|  |  |

### Original project views

| Front | Rear | Cutaway |
|---|---|---|
| Front | Rear | Cutaway |

| Open | Closed | Office floor |
|---|---|---|
| Open | Closed | Office floor |

| Technical roof | Desks |
|---|---|
| Technical roof | Desks |

## Compact office

| Front | Front left quarter |
|---|---|
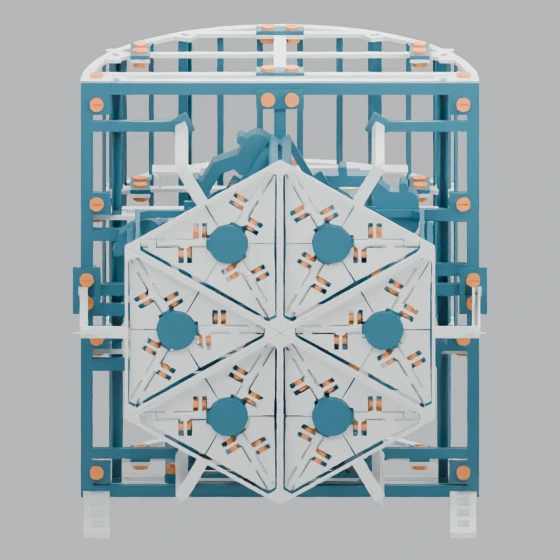
[picture p406: media/views/compact_front.webp]
Front
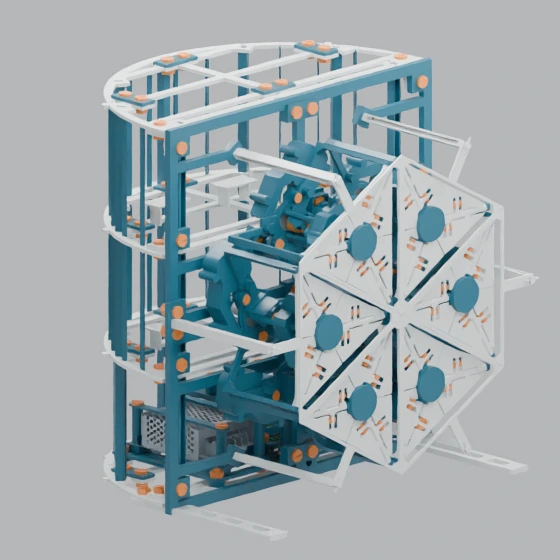
[picture p407: media/views/compact_front-quarter-a.webp]
Front left quarter
|  |  |

| Left elevation | Rear left quarter |
|---|---|
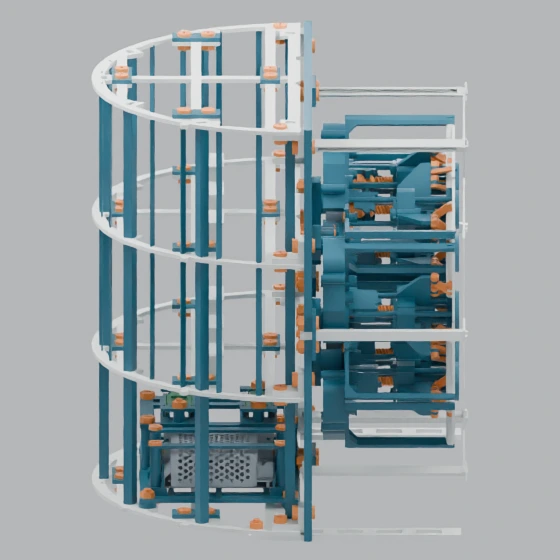
[picture p408: media/views/compact_side-a.webp]
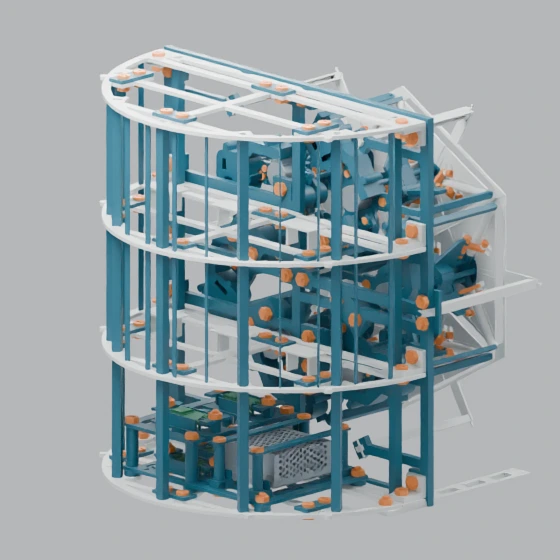
[picture p409: media/views/compact_rear-quarter-a.webp]
Rear left quarter
|  |  |

| Rear | Rear right quarter |
|---|---|
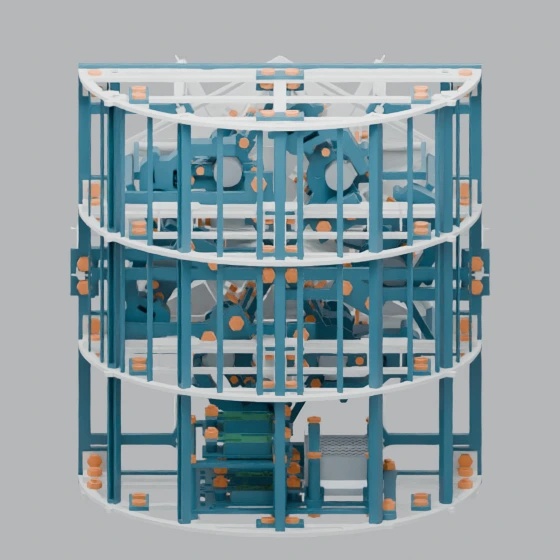
[picture p410: media/views/compact_rear.webp]
Rear
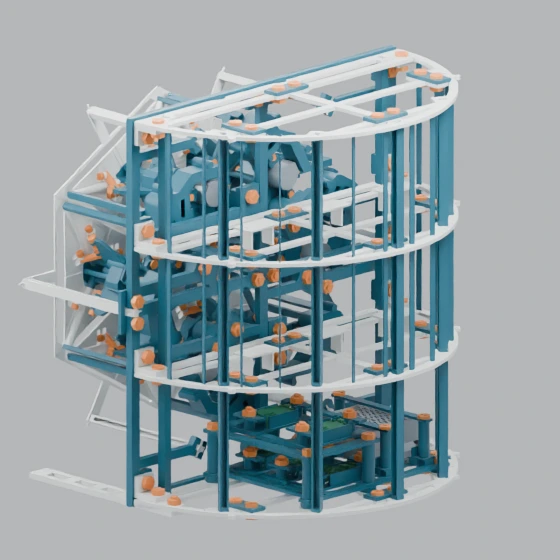
[picture p411: media/views/compact_rear-quarter-b.webp]
Rear right quarter
|  |  |

| Right elevation | Front right quarter |
|---|---|
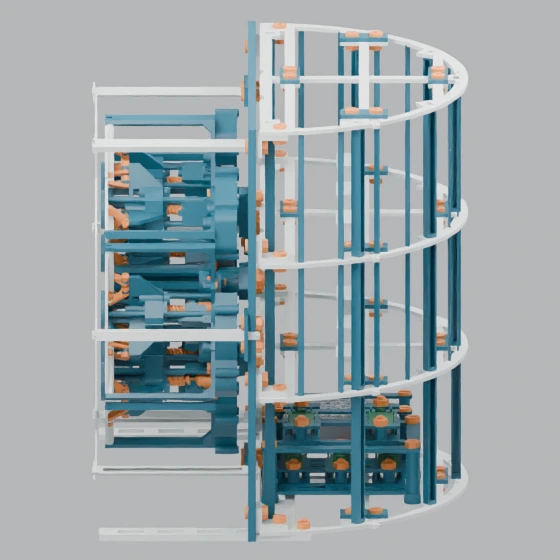
[picture p412: media/views/compact_side-b.webp]
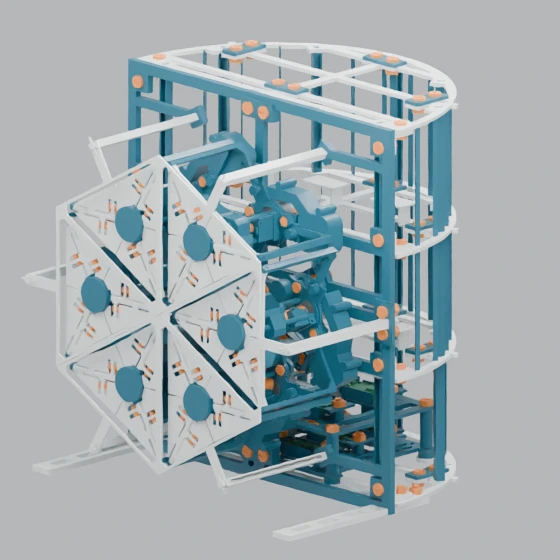
[picture p413: media/views/compact_front-quarter-b.webp]
Front right quarter
|  |  |

| Roof plan | Underside |
|---|---|
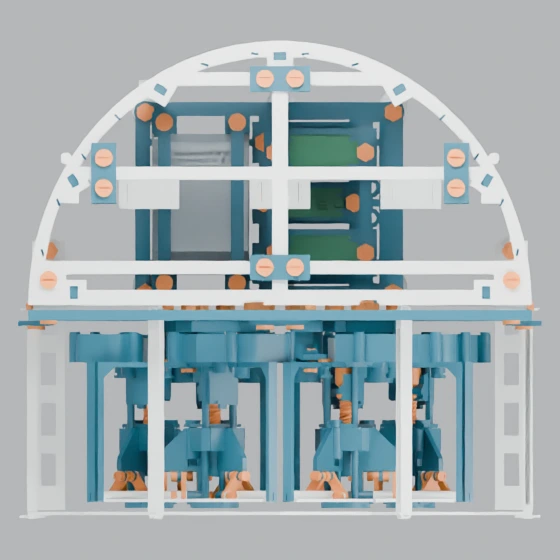
[picture p414: media/views/compact_roof.webp]
Roof plan
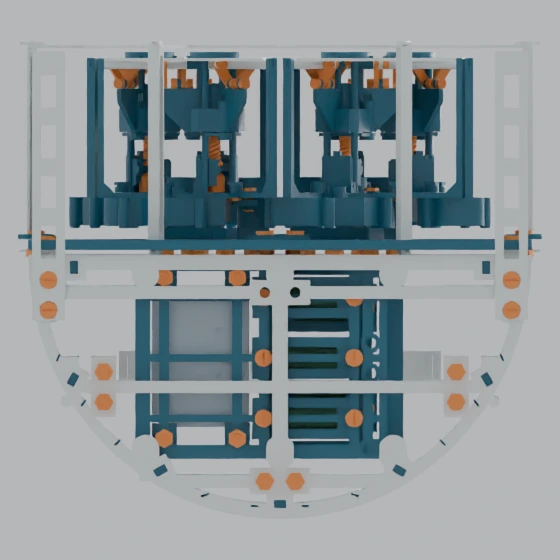
[picture p415: media/views/compact_underside.webp]
Underside
|  |  |

### Original project views

| Facade | Open | Rear |
|---|---|---|
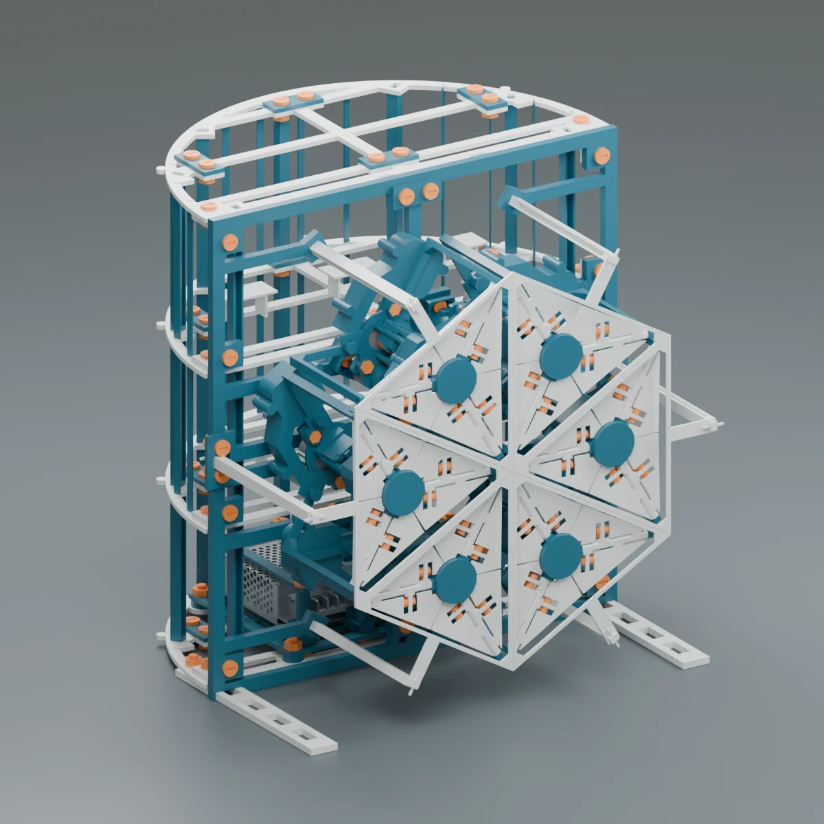
[picture p416: media/views/compact_source_facade.webp]
Facade
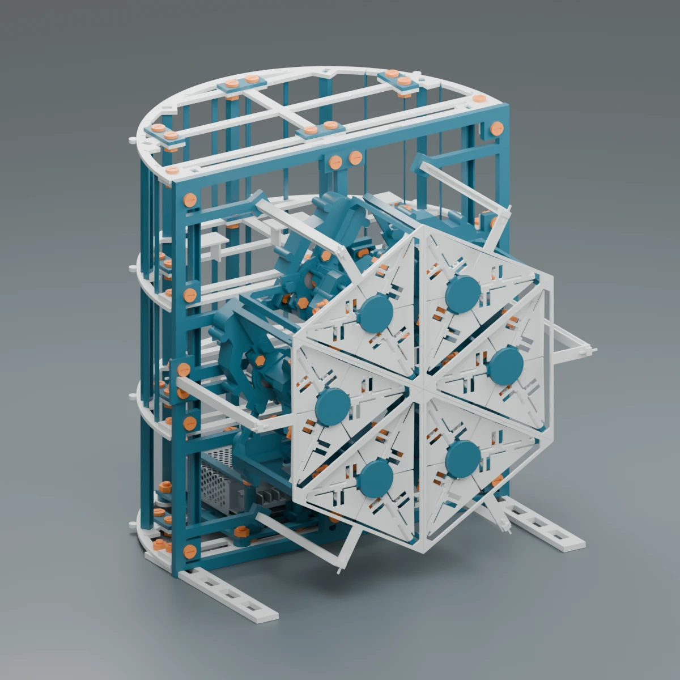
[picture p417: media/views/compact_source_open.webp]
Open
|  |  | Rear |

| Elevation | Electronics |
|---|---|
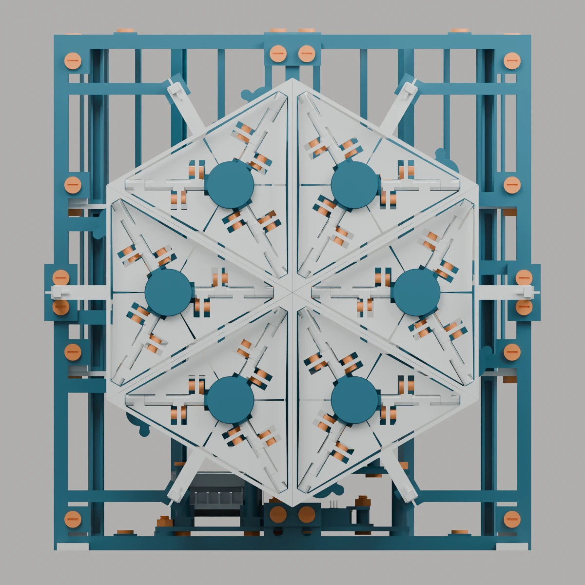
[picture p418: media/views/compact_source_elevation.webp]
Elevation
|  | Electronics |

## Aurora pavilion

| Front | Front left quarter |
|---|---|
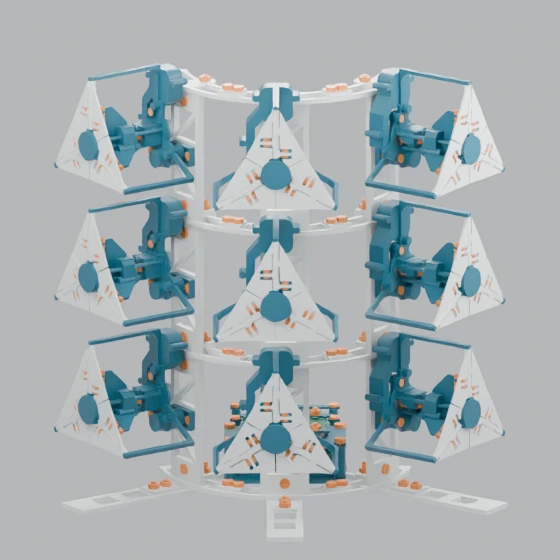
[picture p419: media/views/aurora_front.webp]
Front
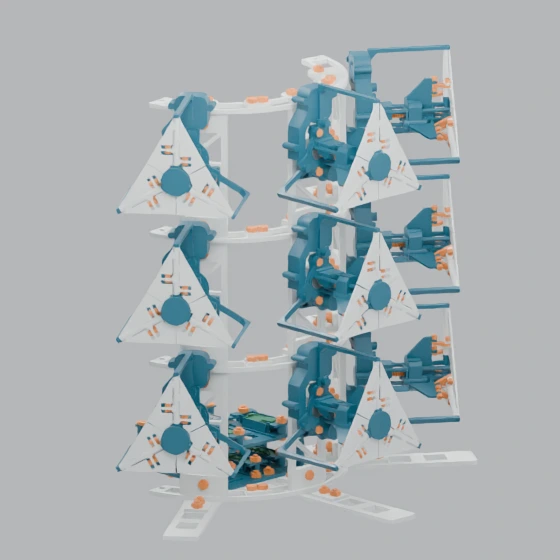
[picture p420: media/views/aurora_front-quarter-a.webp]
Front left quarter
|  |  |

| Left elevation | Rear left quarter |
|---|---|
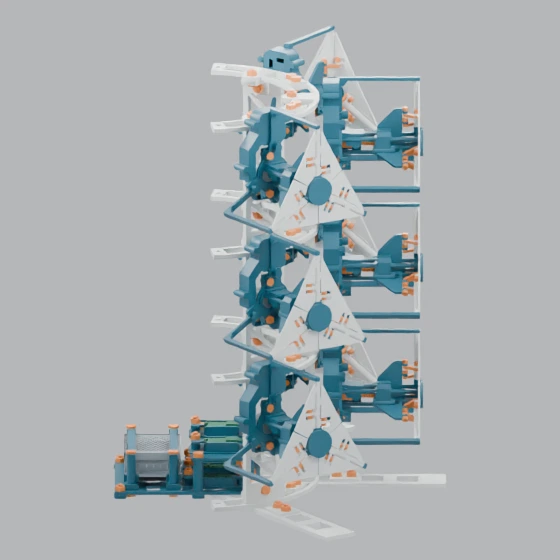
[picture p421: media/views/aurora_side-a.webp]
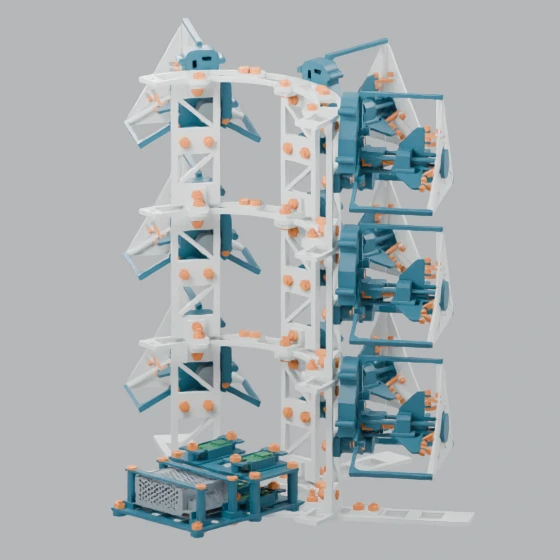
[picture p422: media/views/aurora_rear-quarter-a.webp]
Rear left quarter
|  |  |

| Rear | Rear right quarter |
|---|---|
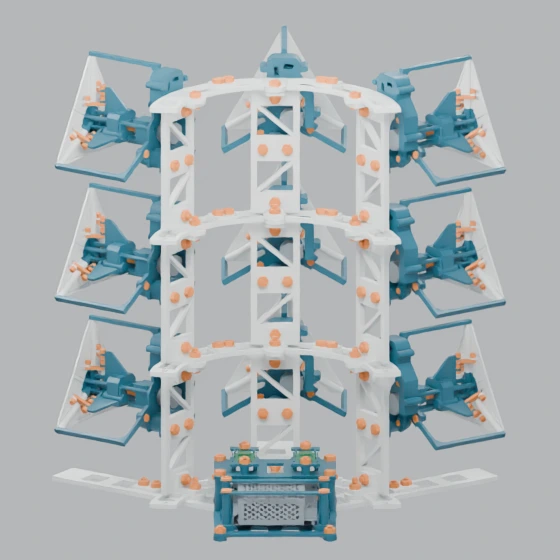
[picture p423: media/views/aurora_rear.webp]
Rear
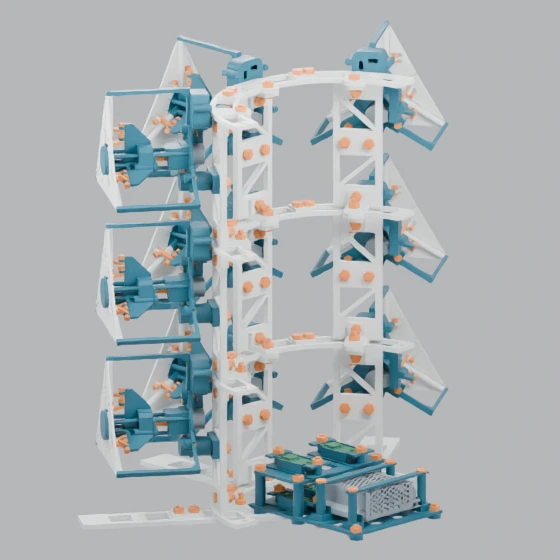
[picture p424: media/views/aurora_rear-quarter-b.webp]
Rear right quarter
|  |  |

| Right elevation | Front right quarter |
|---|---|
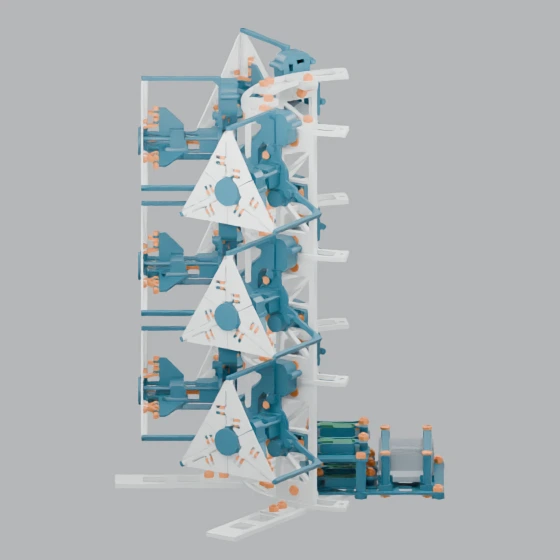
[picture p425: media/views/aurora_side-b.webp]
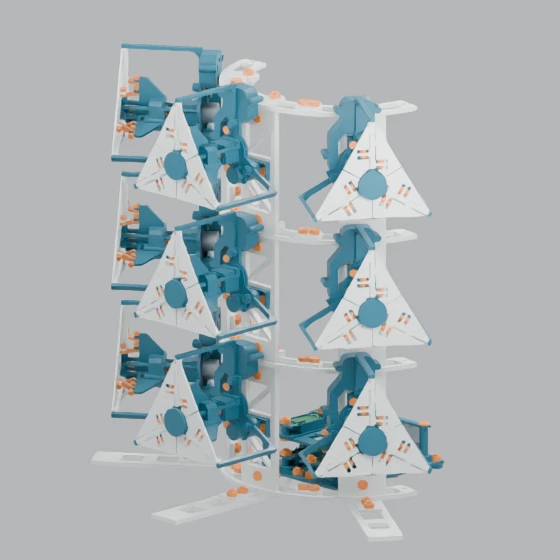
[picture p426: media/views/aurora_front-quarter-b.webp]
Front right quarter
|  |  |

| Roof plan | Underside |
|---|---|
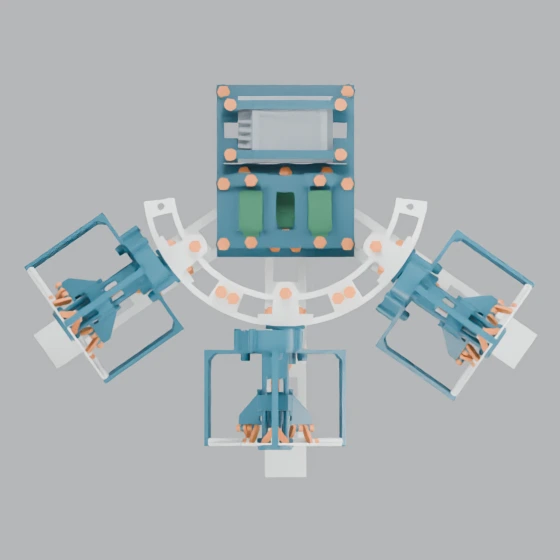
[picture p427: media/views/aurora_roof.webp]
Roof plan
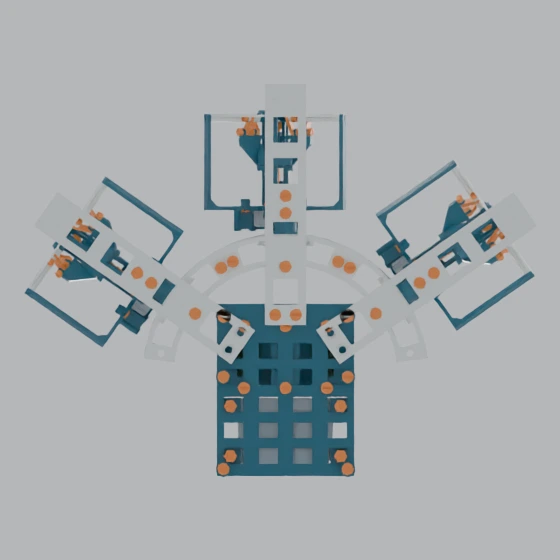
[picture p428: media/views/aurora_underside.webp]
Underside
|  |  |

### Original project views

| Pavilion | Service rear | Electronics |
|---|---|---|
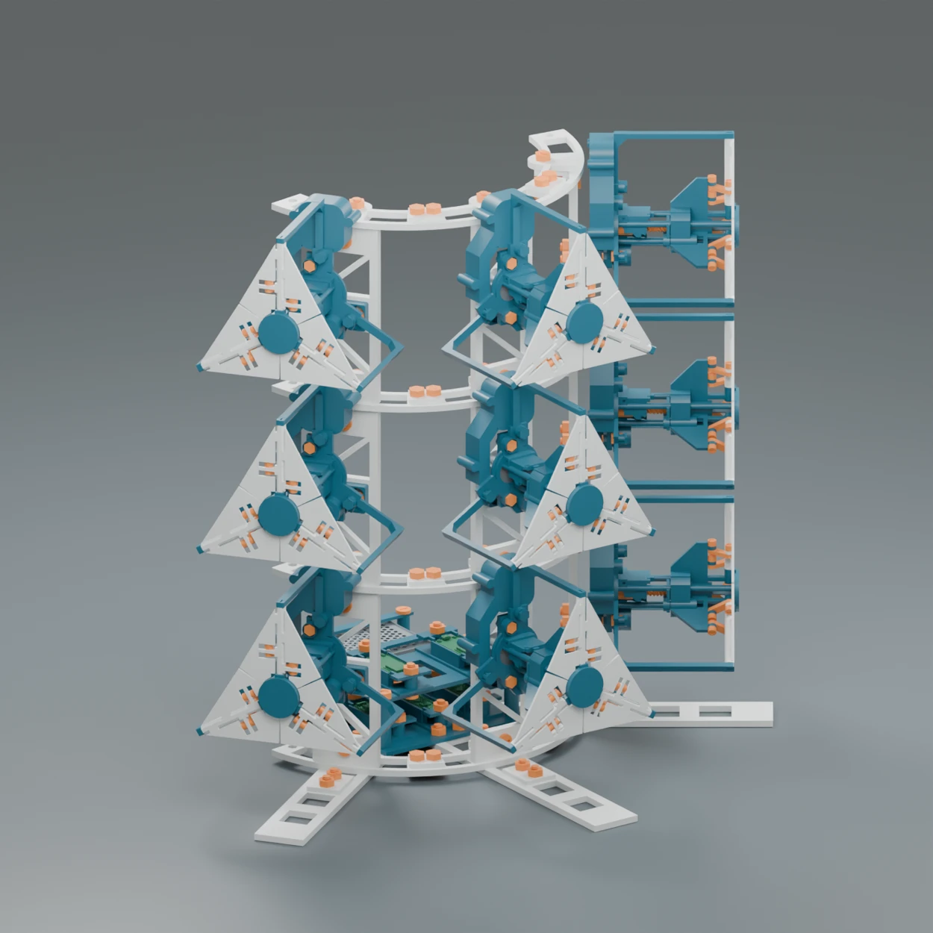
[picture p429: media/views/aurora_source_pavilion.webp]
Pavilion
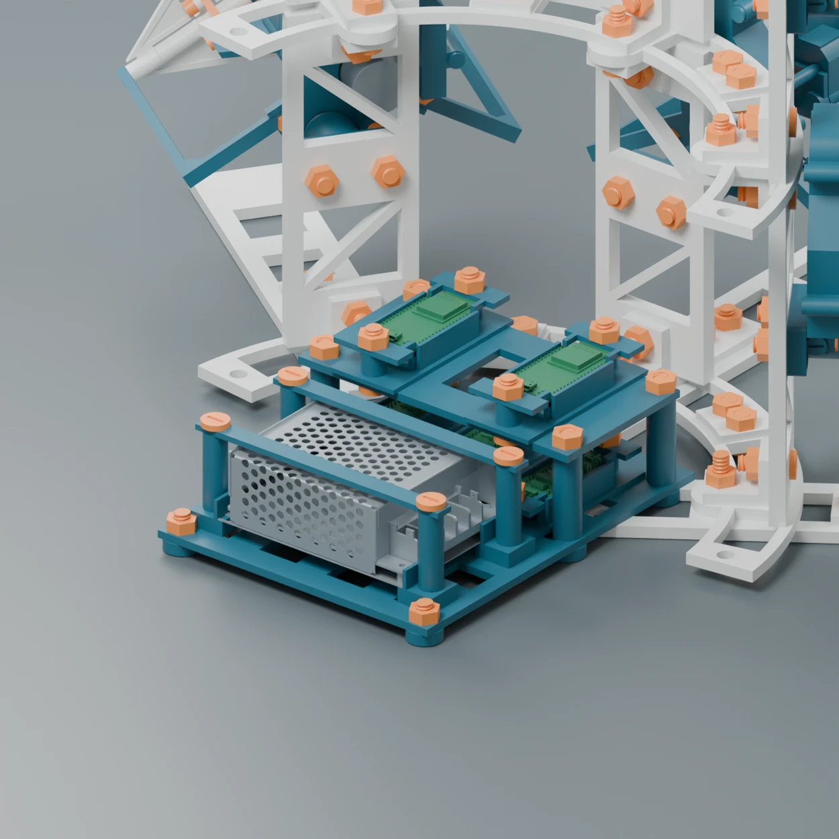
[picture p430: media/views/aurora_source_electronics.webp]
Electronics
|  | Service rear |  |

| Structure | Open |
|---|---|
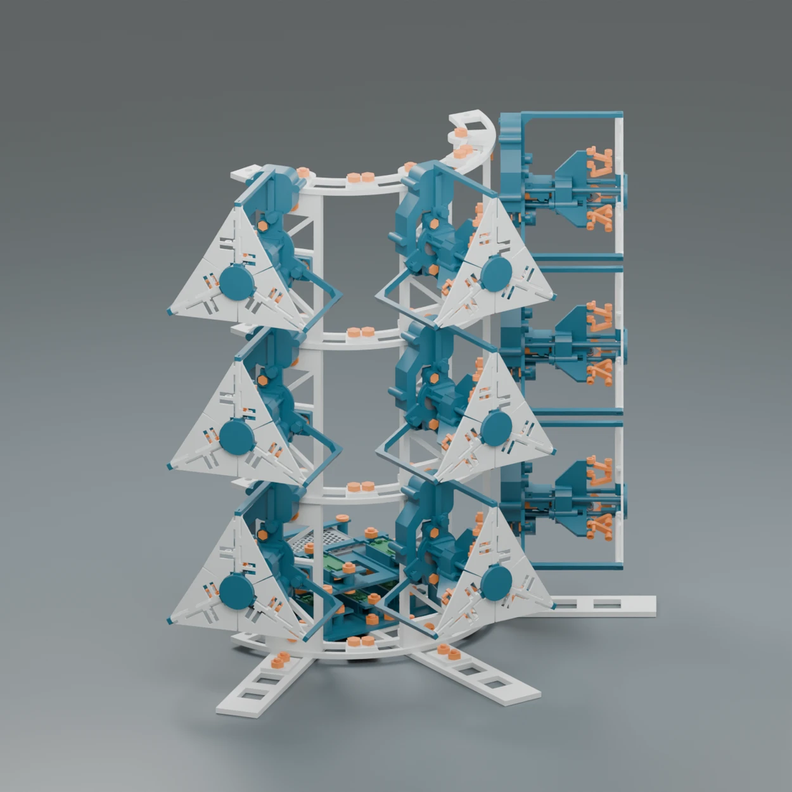
[picture p431: media/views/aurora_source_open.webp]
Open
| Structure |  |

## Rigid office

| Front | Front left quarter |
|---|---|
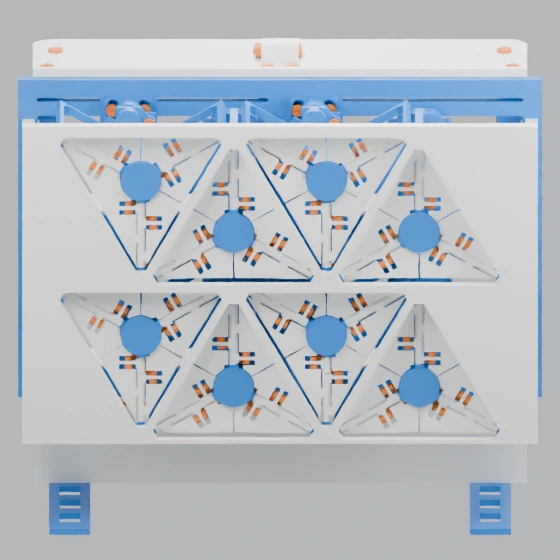
[picture p432: media/views/rigid_front.webp]
Front
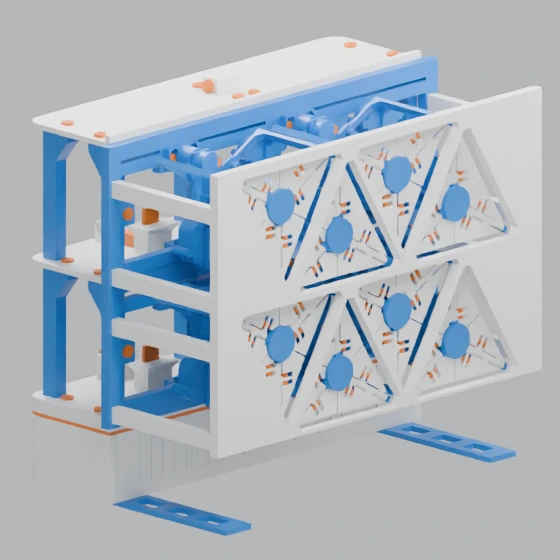
[picture p433: media/views/rigid_front-quarter-a.webp]
Front left quarter
|  |  |

| Left elevation | Rear left quarter |
|---|---|
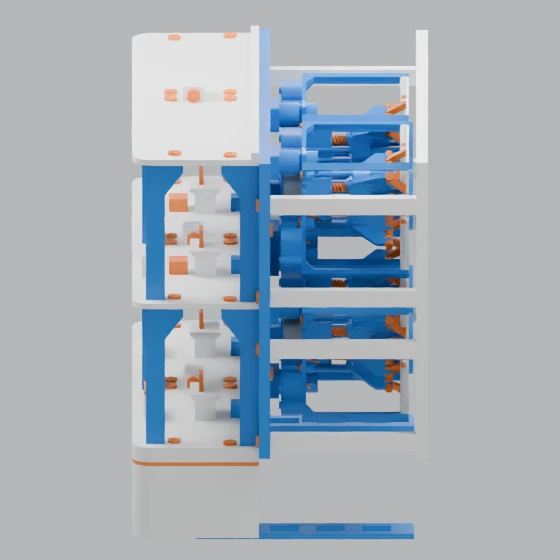
[picture p434: media/views/rigid_side-a.webp]
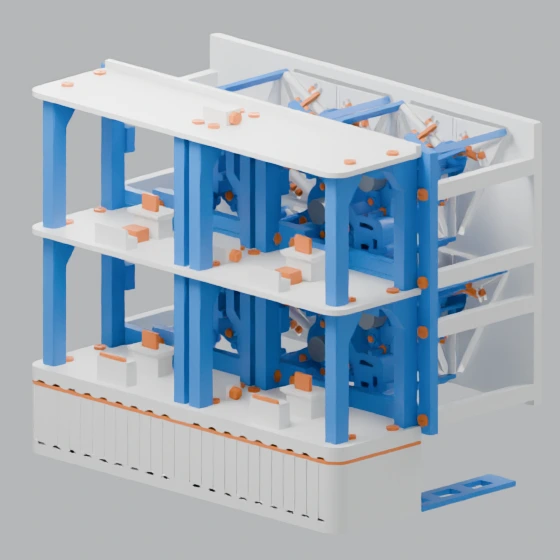
[picture p435: media/views/rigid_rear-quarter-a.webp]
Rear left quarter
|  |  |

| Rear | Rear right quarter |
|---|---|
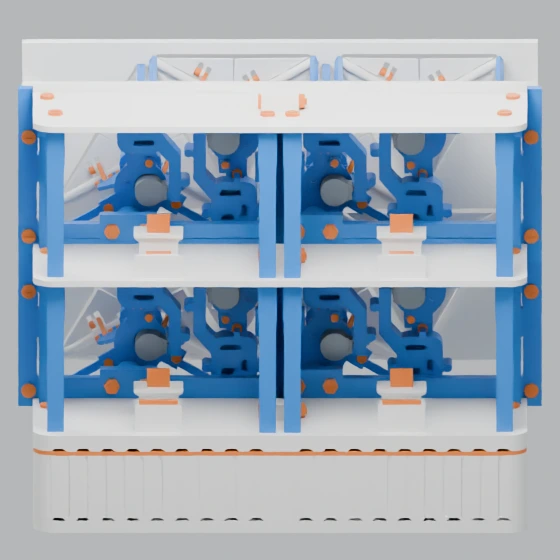
[picture p436: media/views/rigid_rear.webp]
Rear
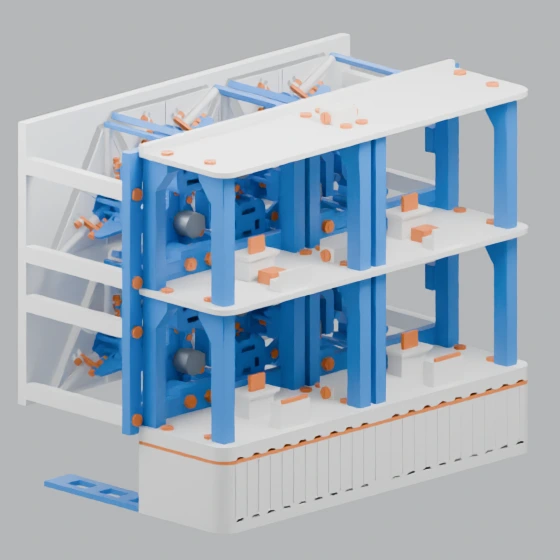
[picture p437: media/views/rigid_rear-quarter-b.webp]
Rear right quarter
|  |  |

| Right elevation | Front right quarter |
|---|---|
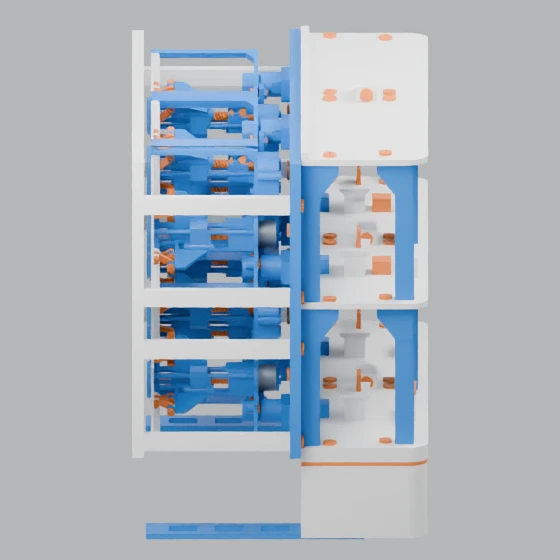
[picture p438: media/views/rigid_side-b.webp]
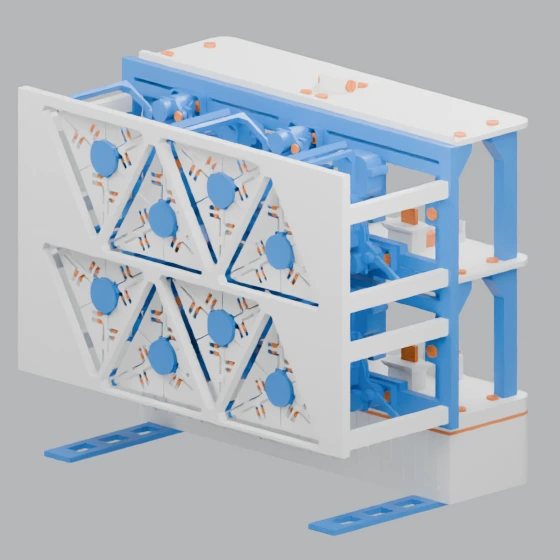
[picture p439: media/views/rigid_front-quarter-b.webp]
Front right quarter
|  |  |

| Roof plan | Underside |
|---|---|
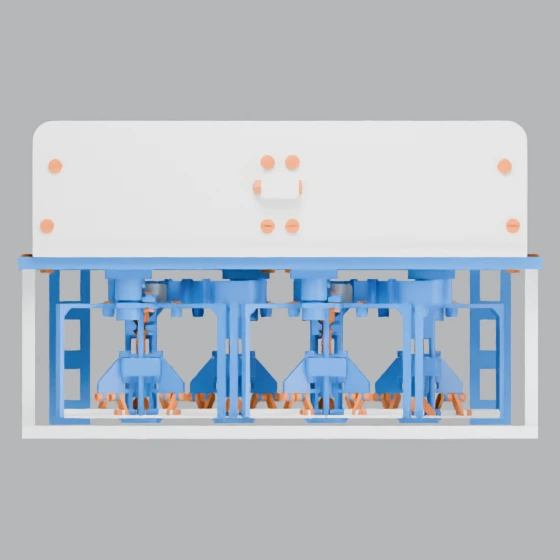
[picture p440: media/views/rigid_roof.webp]
Roof plan
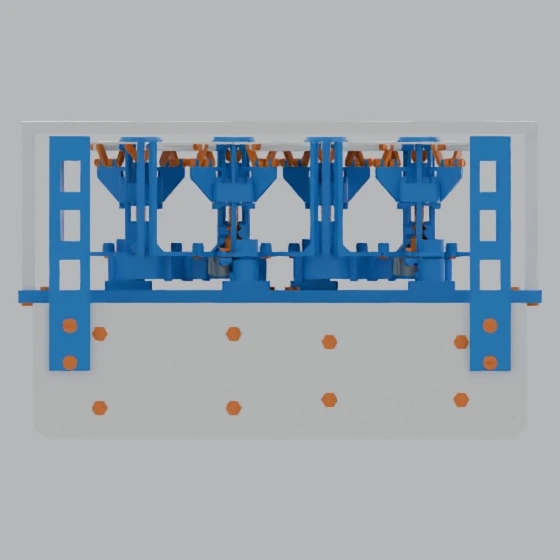
[picture p441: media/views/rigid_underside.webp]
Underside
|  |  |

### Original project views

| Facade | Open | Rear |
|---|---|---|
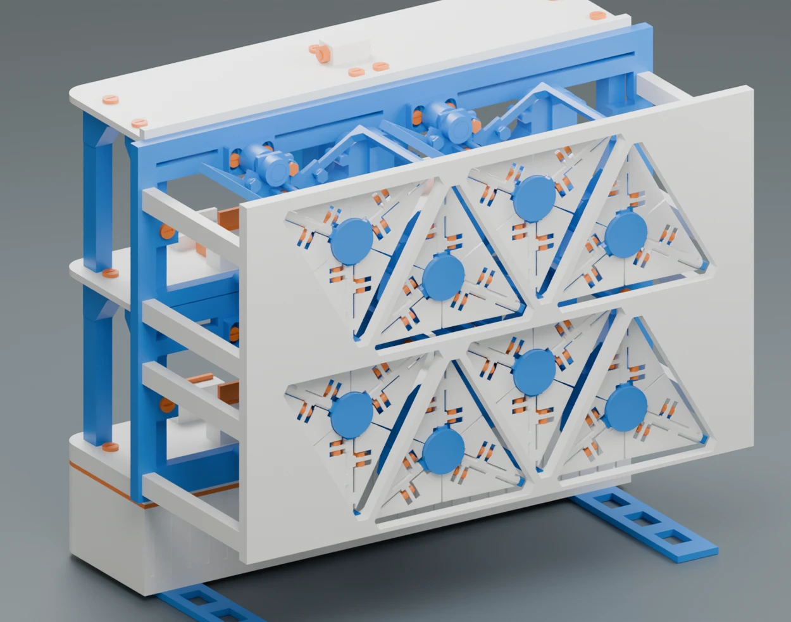
[picture p442: media/views/rigid_source_facade.webp]
Facade
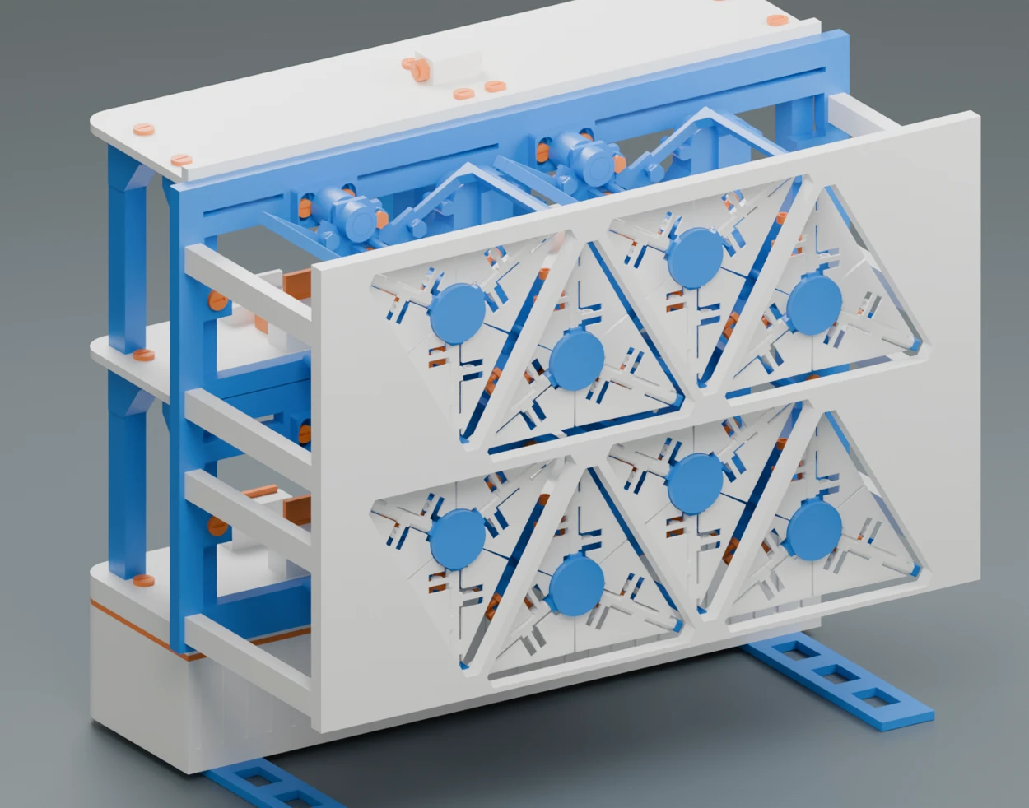
[picture p443: media/views/rigid_source_open.webp]
Open
|  |  | Rear |

| Elevation | Equipment bay |
|---|---|
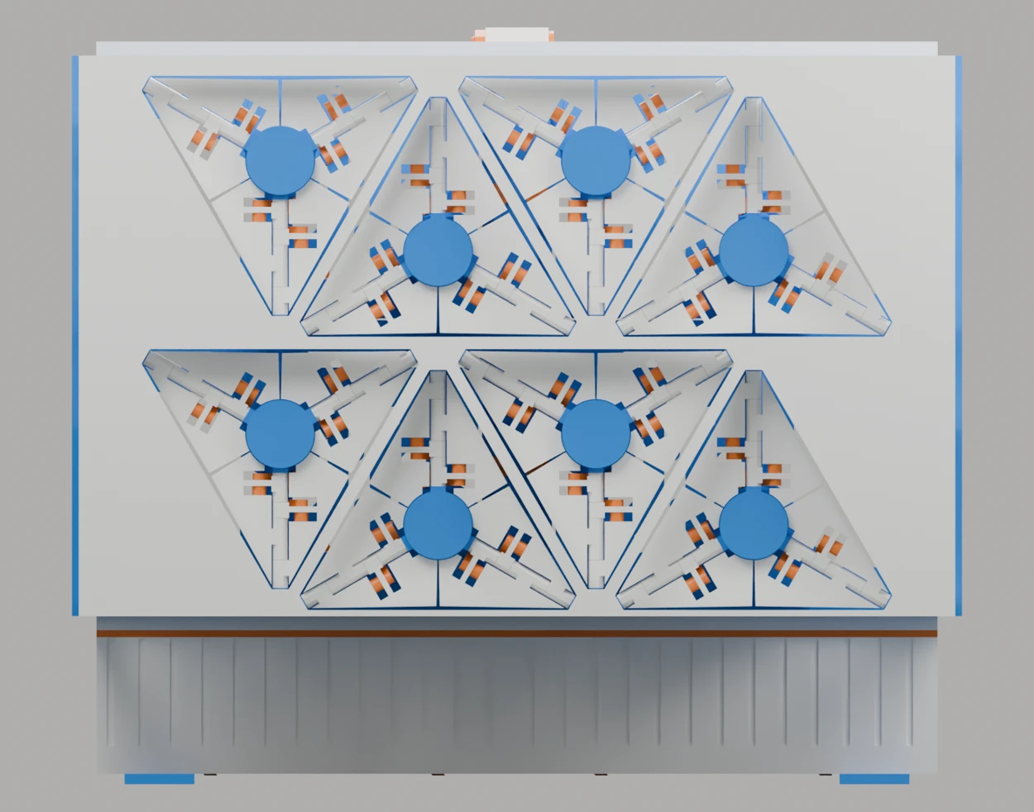
[picture p444: media/views/rigid_source_elevation.webp]
Elevation
|  | Equipment bay |

## Nine-module office

| Front | Front left quarter |
|---|---|
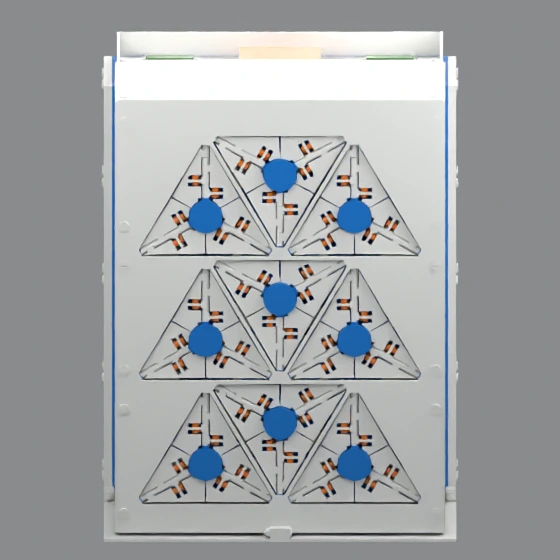
[picture p445: media/views/office9_front.webp]
Front
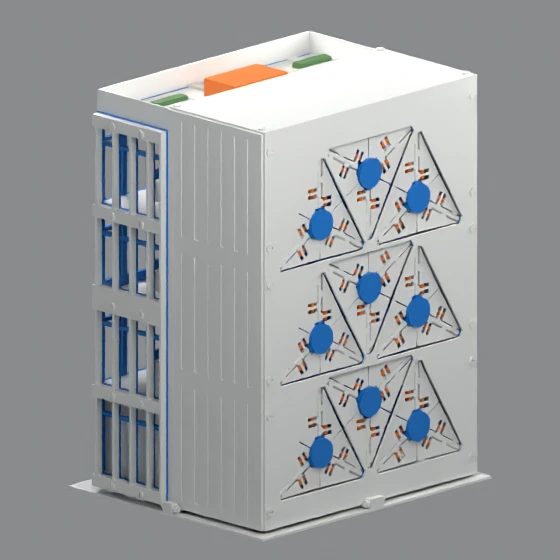
[picture p446: media/views/office9_front-quarter-a.webp]
Front left quarter
|  |  |

| Left elevation | Rear left quarter |
|---|---|
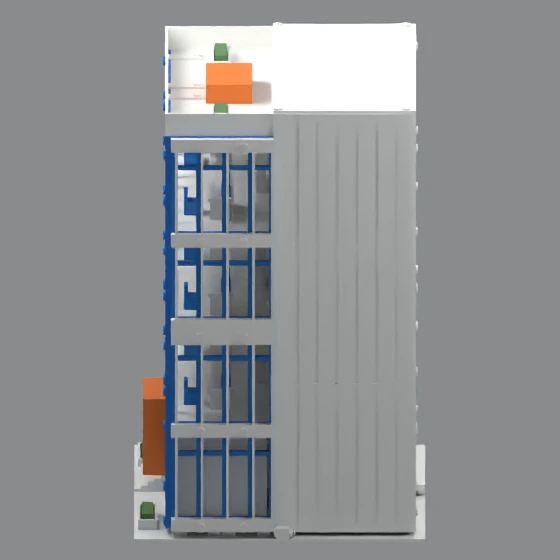
[picture p447: media/views/office9_side-a.webp]
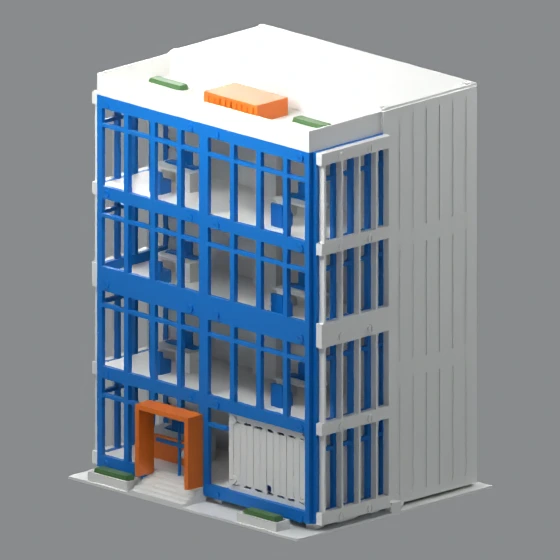
[picture p448: media/views/office9_rear-quarter-a.webp]
Rear left quarter
|  |  |

| Rear | Rear right quarter |
|---|---|
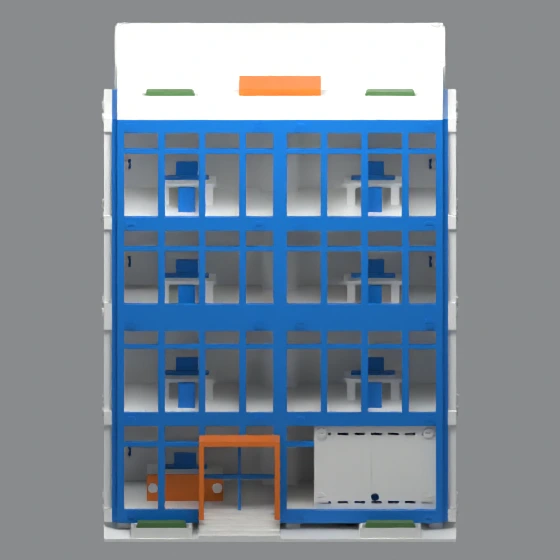
[picture p449: media/views/office9_rear.webp]
Rear
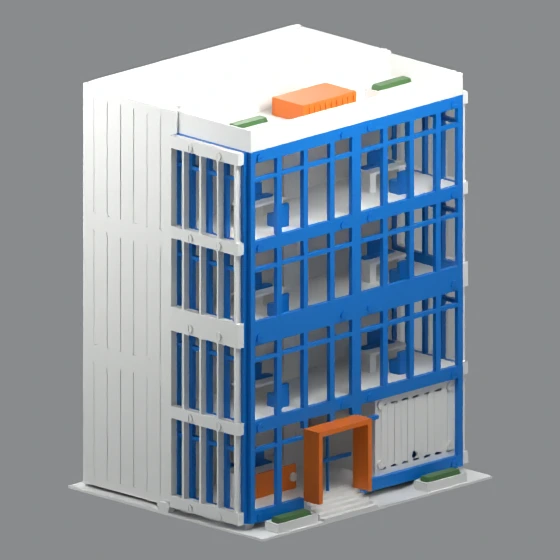
[picture p450: media/views/office9_rear-quarter-b.webp]
Rear right quarter
|  |  |

| Right elevation | Front right quarter |
|---|---|
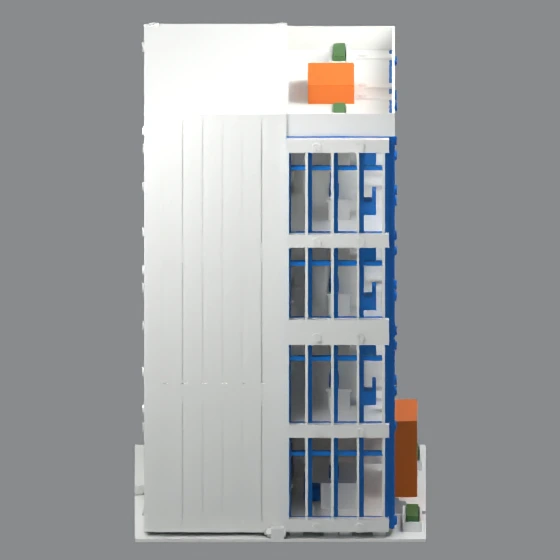
[picture p451: media/views/office9_side-b.webp]
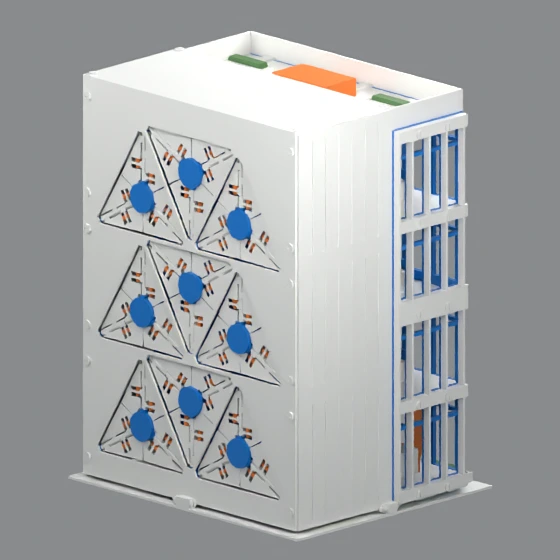
[picture p452: media/views/office9_front-quarter-b.webp]
Front right quarter
|  |  |

| Roof plan | Underside |
|---|---|
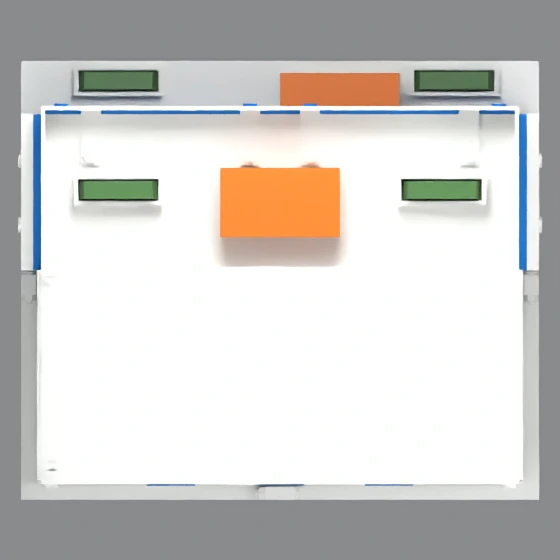
[picture p453: media/views/office9_roof.webp]
Roof plan
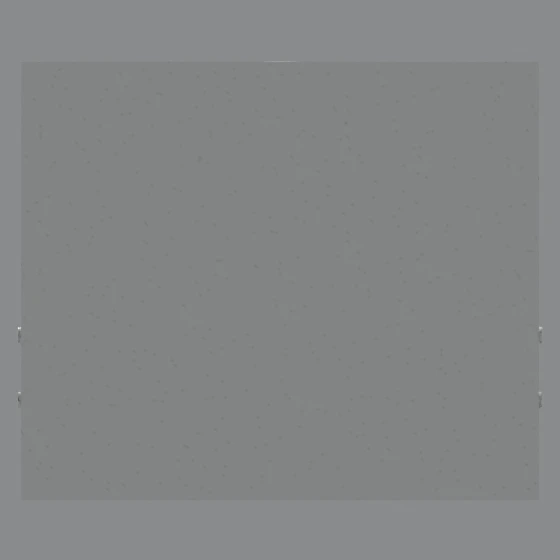
[picture p454: media/views/office9_underside.webp]
Underside
|  |  |

### Original project views

| Closed | Open | Rear |
|---|---|---|
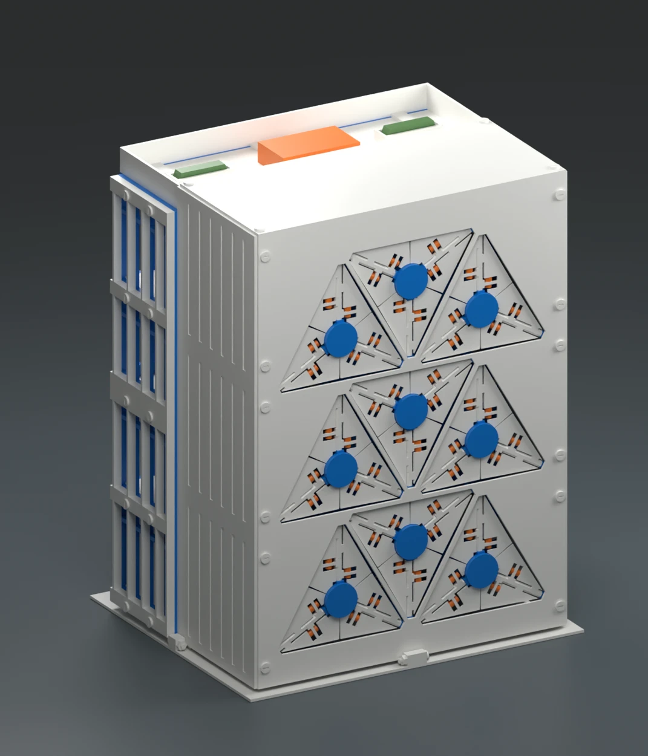
[picture p455: media/views/office9_source_closed.webp]
Closed
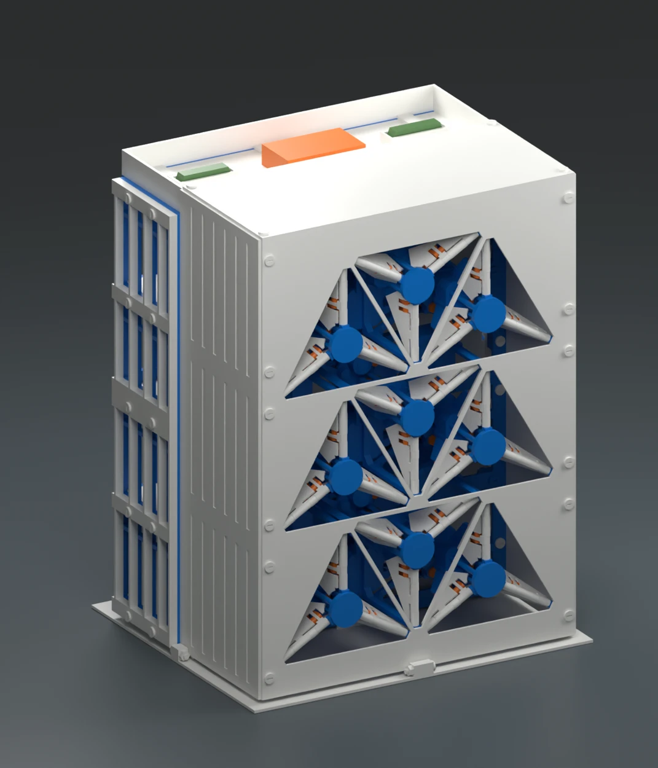
[picture p456: media/views/office9_source_open.webp]
Open
|  |  | Rear |

| Elevation | Wave | Service |
|---|---|---|
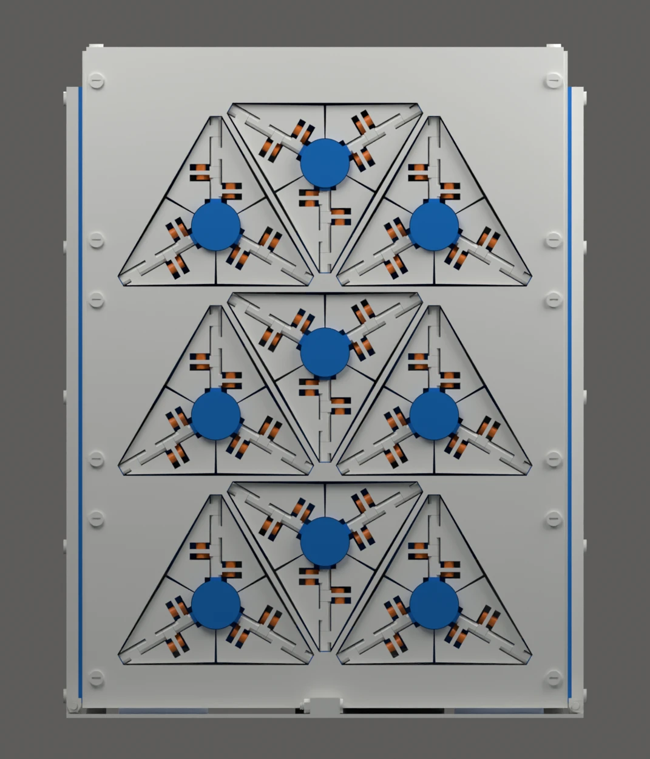
[picture p457: media/views/office9_source_elevation.webp]
Elevation
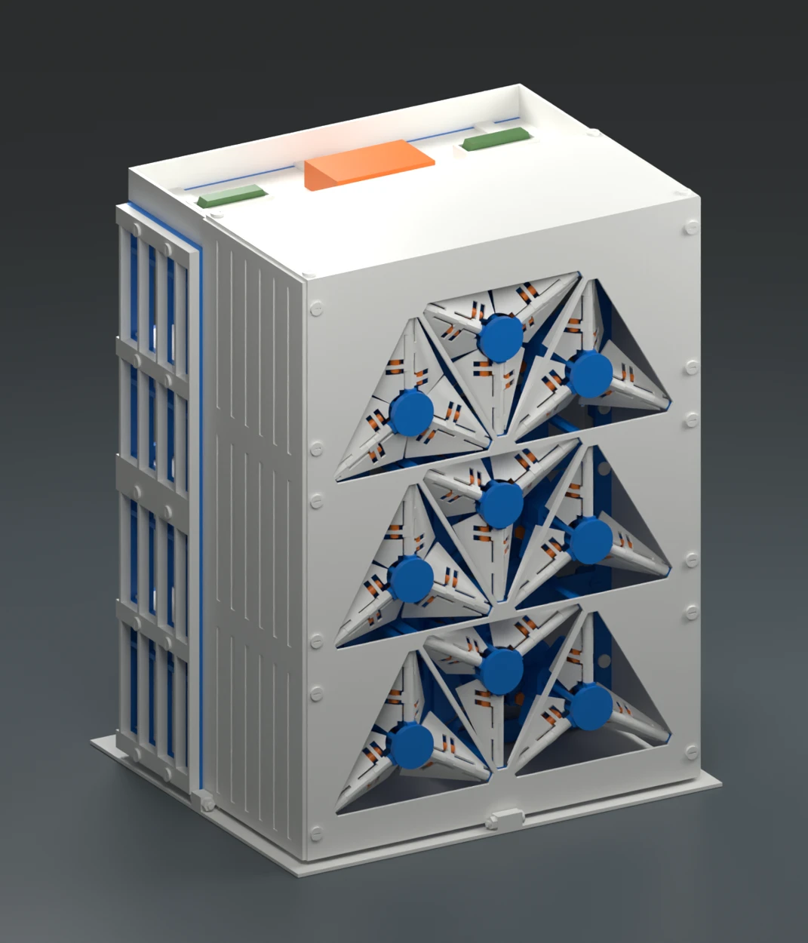
[picture p458: media/views/office9_source_wave.webp]
Wave
|  |  | Service |

## Furnished office

| Front | Front left quarter |
|---|---|
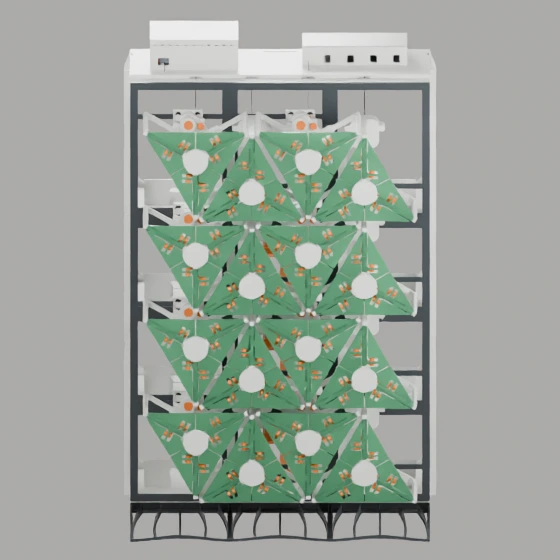
[picture p459: media/views/furnished_front.webp]
Front
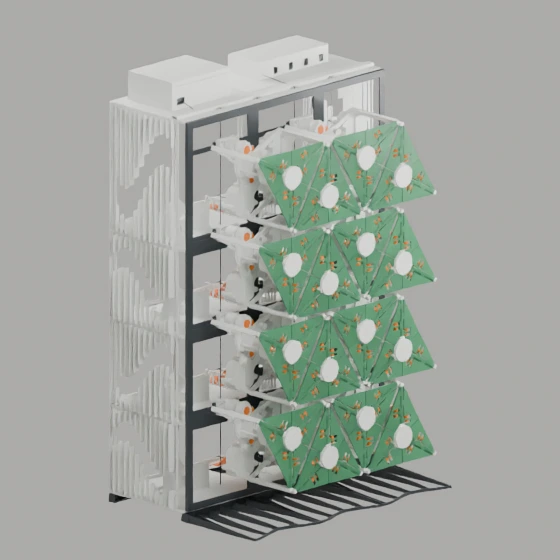
[picture p460: media/views/furnished_front-quarter-a.webp]
Front left quarter
|  |  |

| Left elevation | Rear left quarter |
|---|---|
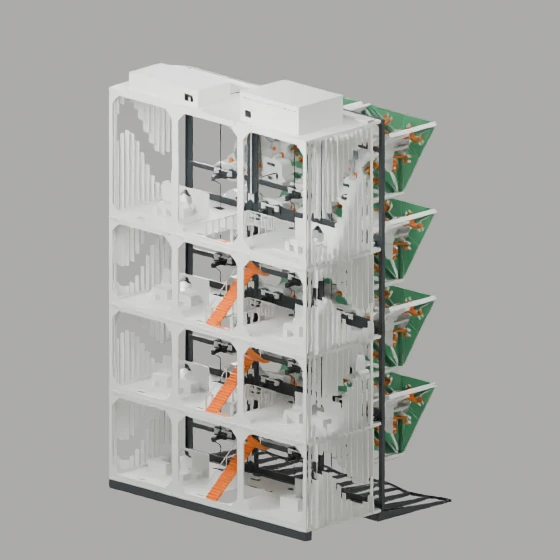
[picture p461: media/views/furnished_rear-quarter-a.webp]
Rear left quarter
| Left elevation |  |

| Rear | Rear right quarter |
|---|---|
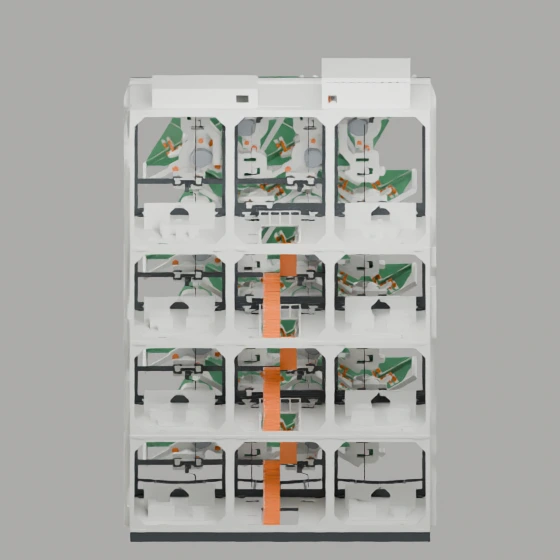
[picture p462: media/views/furnished_rear.webp]
Rear
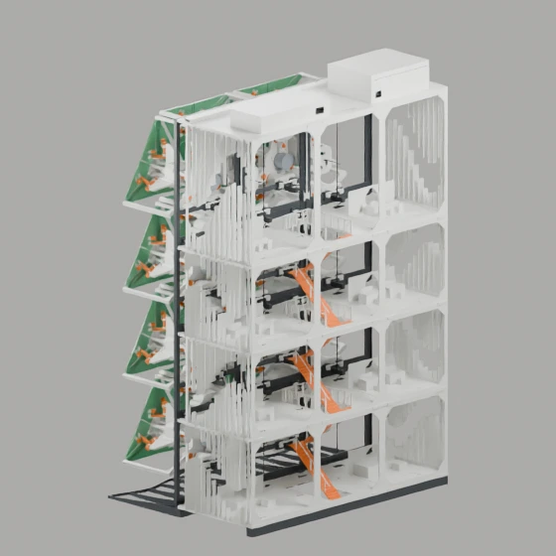
[picture p463: media/views/furnished_rear-quarter-b.webp]
Rear right quarter
|  |  |

| Right elevation | Front right quarter |
|---|---|
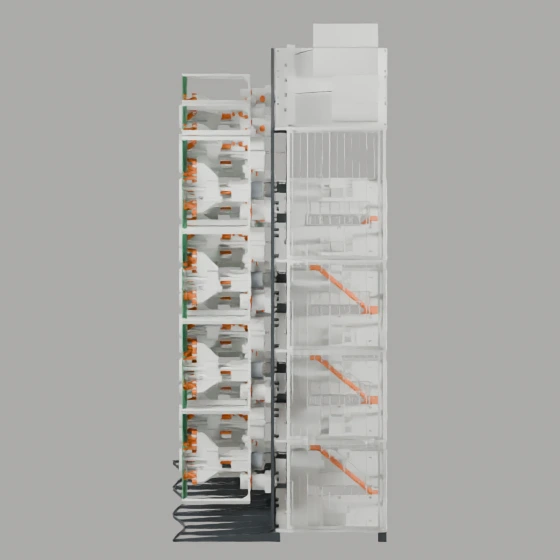
[picture p464: media/views/furnished_side-b.webp]
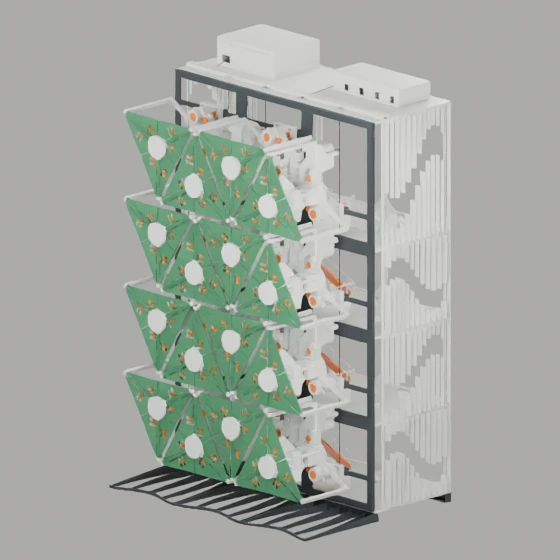
[picture p465: media/views/furnished_front-quarter-b.webp]
Front right quarter
|  |  |

| Roof plan | Underside |
|---|---|
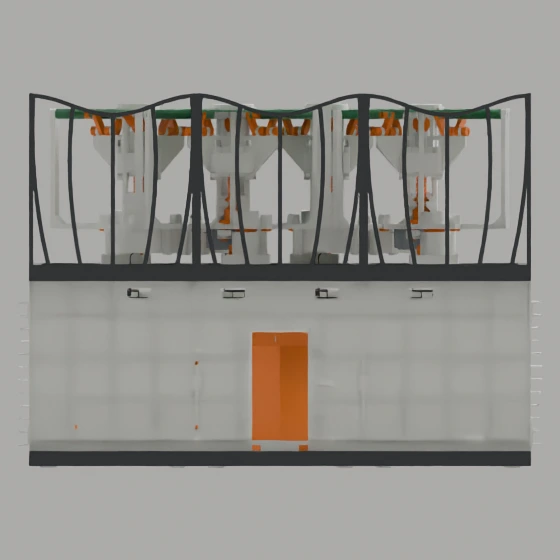
[picture p466: media/views/furnished_underside.webp]
Underside
| Roof plan |  |

### Original project views

| Open facade | Closed facade | Rear |
|---|---|---|
| Open facade | Closed facade | Rear |

| Stair and floors | Room detail | Side fins |
|---|---|---|
| Stair and floors | Room detail | Side fins |

| Cassette rear | Ribbed base |
|---|---|
| Cassette rear | Ribbed base |

## Simplified office

| Front | Front left quarter |
|---|---|
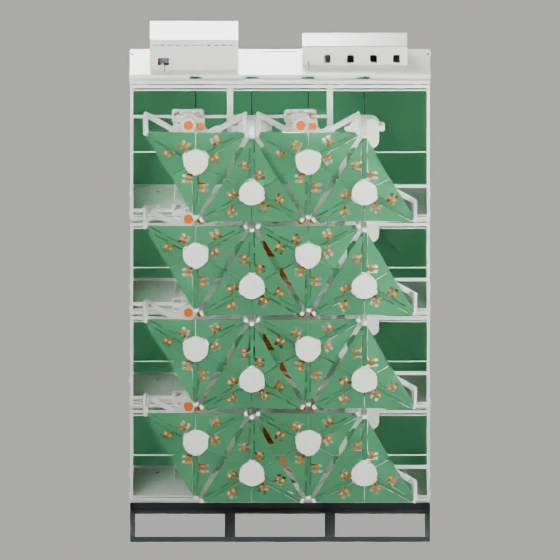
[picture p467: media/views/simplified_front.webp]
Front
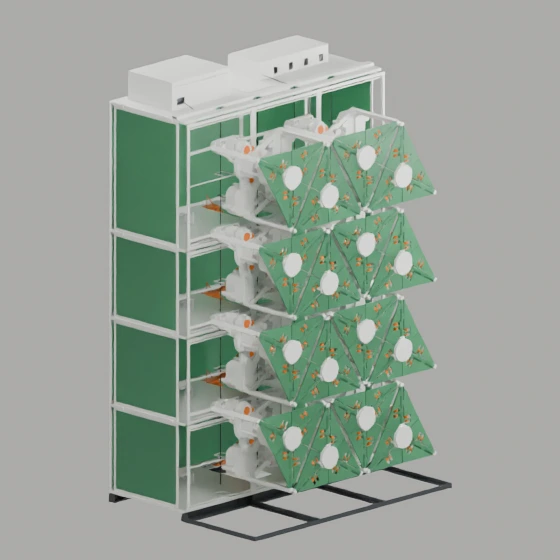
[picture p468: media/views/simplified_front-quarter-a.webp]
Front left quarter
|  |  |

| Left elevation | Rear left quarter |
|---|---|
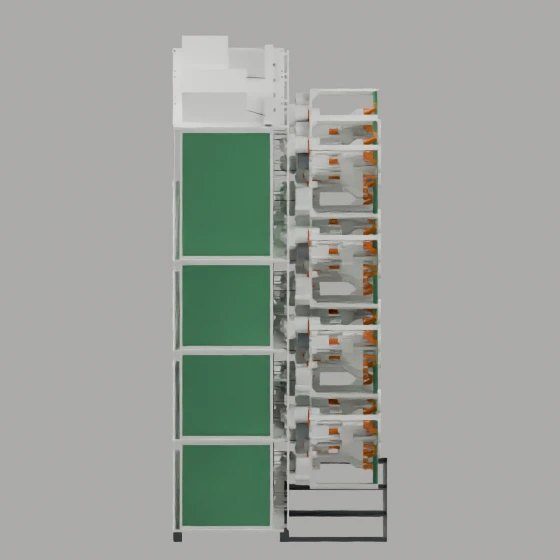
[picture p469: media/views/simplified_side-a.webp]
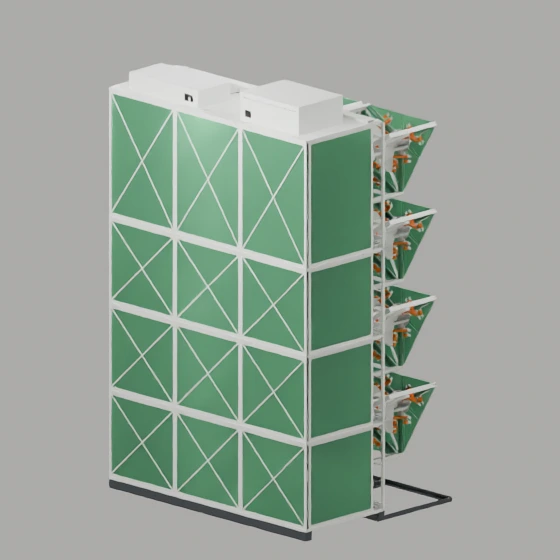
[picture p470: media/views/simplified_rear-quarter-a.webp]
Rear left quarter
|  |  |

| Rear | Rear right quarter |
|---|---|
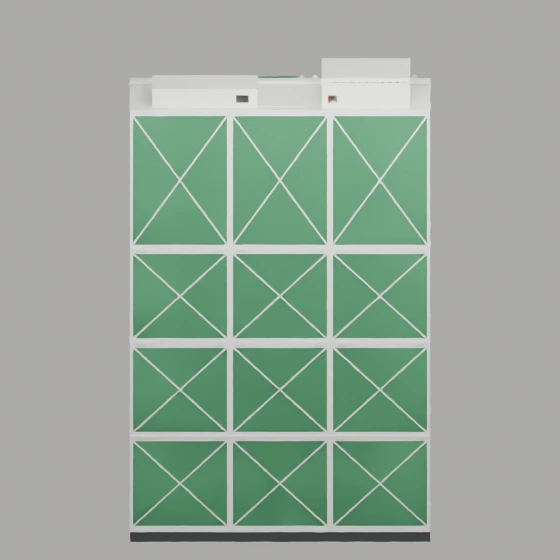
[picture p471: media/views/simplified_rear.webp]
Rear
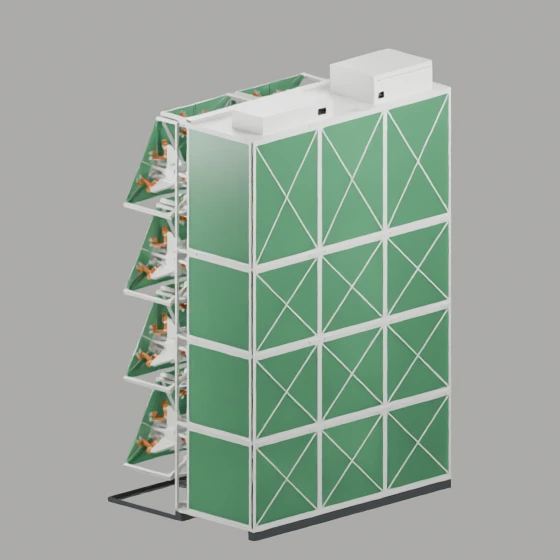
[picture p472: media/views/simplified_rear-quarter-b.webp]
Rear right quarter
|  |  |

| Right elevation | Front right quarter |
|---|---|
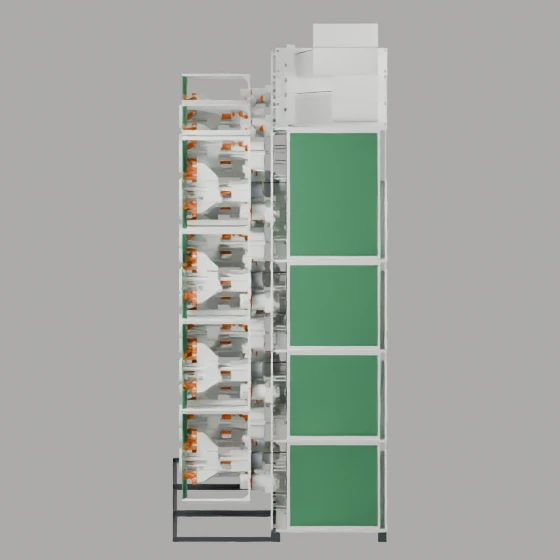
[picture p473: media/views/simplified_side-b.webp]
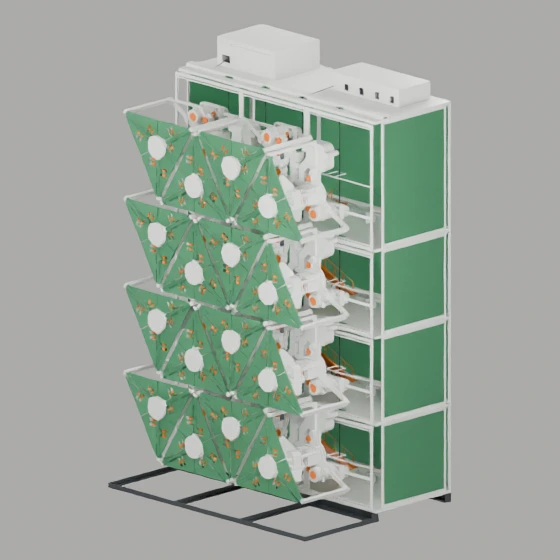
[picture p474: media/views/simplified_front-quarter-b.webp]
Front right quarter
|  |  |

| Roof plan | Underside |
|---|---|
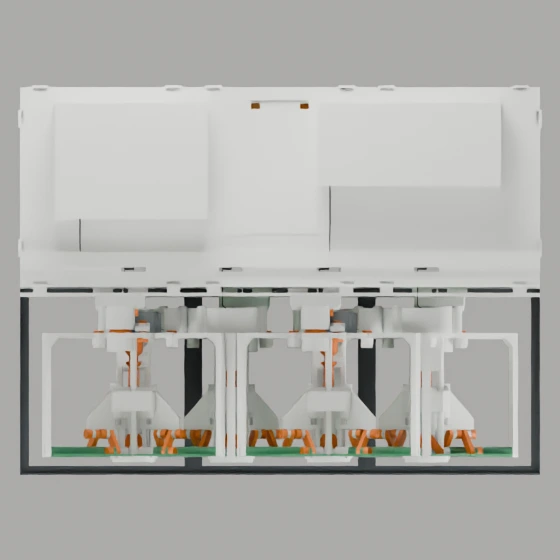
[picture p475: media/views/simplified_roof.webp]
Roof plan
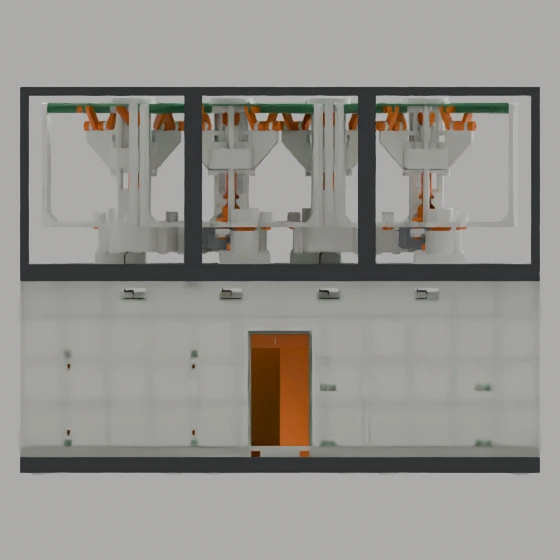
[picture p476: media/views/simplified_underside.webp]
Underside
|  |  |

### Original project views

| Open facade | Closed facade | Rear |
|---|---|---|
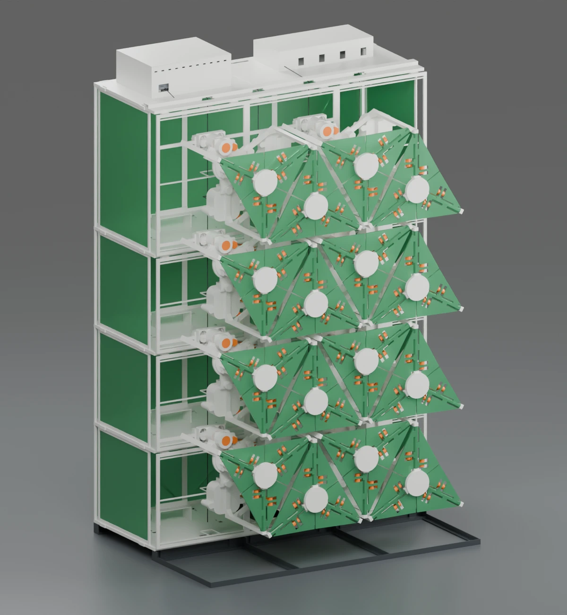
[picture p477: media/renders/simplified_closed.webp]
Closed facade
| Open facade |  | Rear |

| Stair and interior |
|---|
| Stair and interior |

## Independent stand

| Front | Front left quarter |
|---|---|
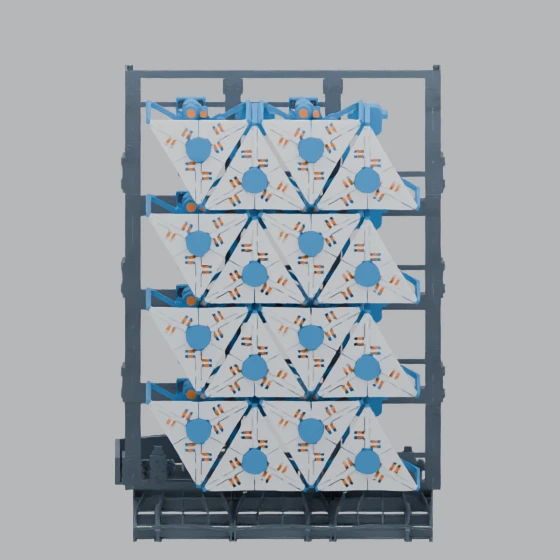
[picture p478: media/views/stand_front.webp]
Front
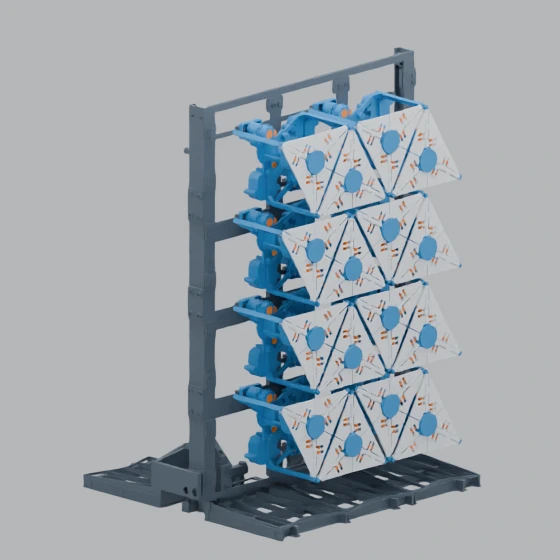
[picture p479: media/views/stand_front-quarter-a.webp]
Front left quarter
|  |  |

| Left elevation | Rear left quarter |
|---|---|
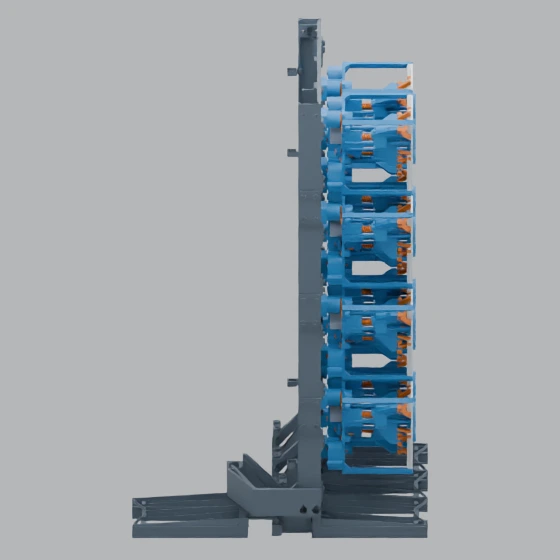
[picture p480: media/views/stand_side-a.webp]
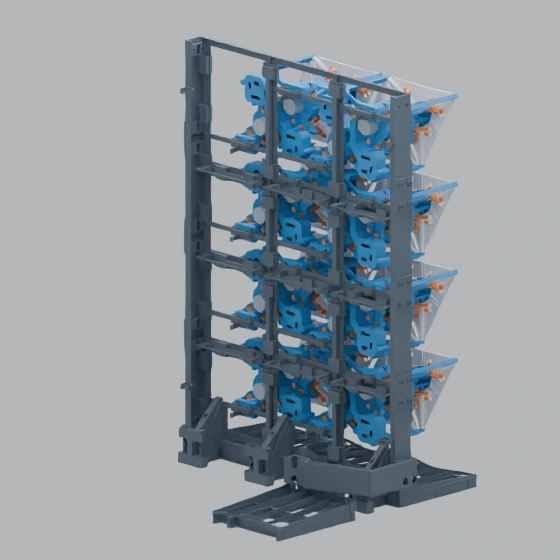
[picture p481: media/views/stand_rear-quarter-a.webp]
Rear left quarter
|  |  |

| Rear | Rear right quarter |
|---|---|
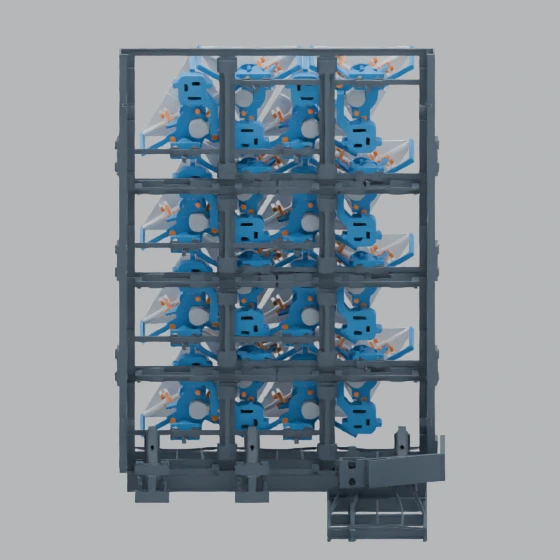
[picture p482: media/views/stand_rear.webp]
Rear
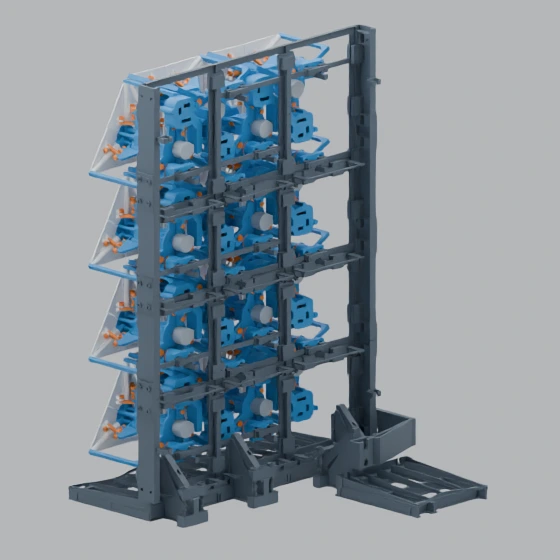
[picture p483: media/views/stand_rear-quarter-b.webp]
Rear right quarter
|  |  |

| Right elevation | Front right quarter |
|---|---|
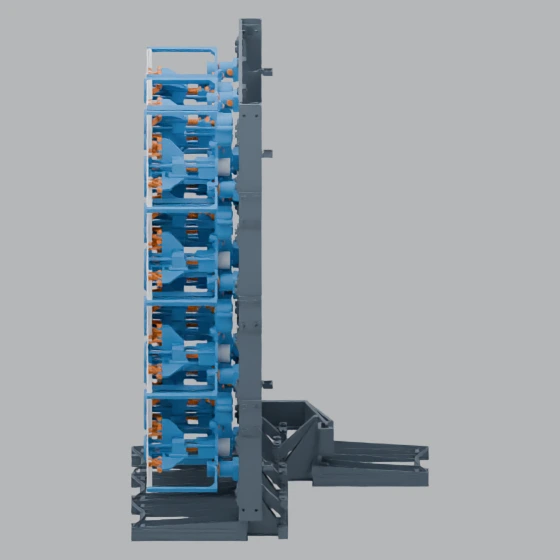
[picture p484: media/views/stand_side-b.webp]
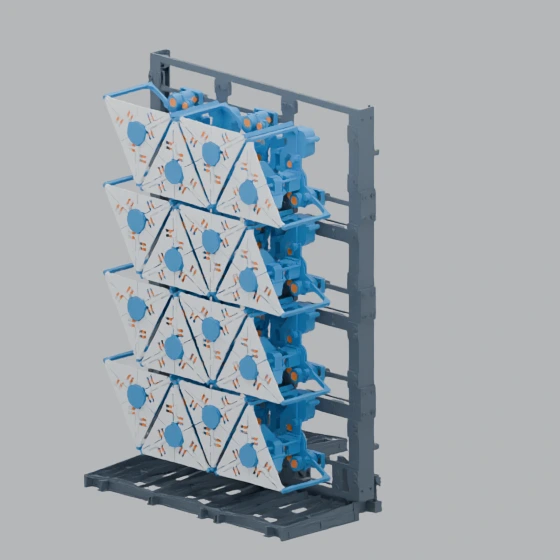
[picture p485: media/views/stand_front-quarter-b.webp]
Front right quarter
|  |  |

| Roof plan | Underside |
|---|---|
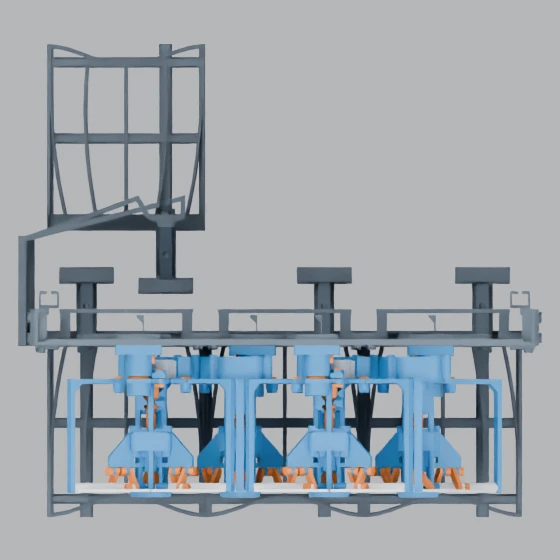
[picture p486: media/views/stand_roof.webp]
Roof plan
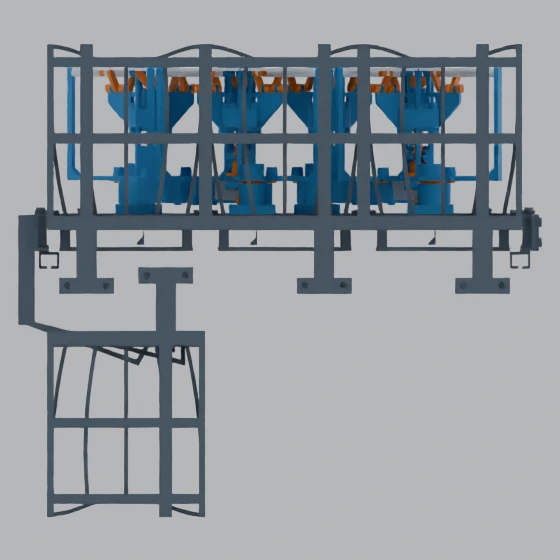
[picture p487: media/views/stand_underside.webp]
Underside
|  |  |

### Original project views

| Populated stand | Empty frame | Receiver assembly |
|---|---|---|
| Populated stand | Empty frame | Receiver assembly |

| Rear foot |
|---|
| Rear foot |
