vluncasu/SolarSkin/engineering/assembly/furnished_instances.csv

part_id | instance_name | x_mm | y_mm | z_mm | m00 | m01 | m02 | m03 | m10 | m11 | m12 | m13 | m20 | m21 | m22 | m23 | m30 | m31 | m32 | m33
J03_PROBA_IMBINARI | Proba_separata_de_ansamblu | 270.0 | -10.0 | 0.0 | 1.0 | 0.0 | 0.0 | 270.0 | 0.0 | 1.0 | 0.0 | -10.0 | 0.0 | 0.0 | 1.0 | 0.0 | 0.0 | 0.0 | 0.0 | 1.0
A01_PLANSEU_1 | Planseu_nivel_0_travee_1 | 0.0 | 0.0 | 18.0 | 1.0 | 0.0 | 0.0 | 0.0 | 0.0 | 1.0 | 0.0 | 0.0 | 0.0 | 0.0 | 1.0 | 18.0 | 0.0 | 0.0 | 0.0 | 1.0
A01_PLANSEU_2 | Planseu_nivel_0_travee_2 | 0.0 | 0.0 | 18.0 | 1.0 | 0.0 | 0.0 | 0.0 | 0.0 | 1.0 | 0.0 | 0.0 | 0.0 | 0.0 | 1.0 | 18.0 | 0.0 | 0.0 | 0.0 | 1.0
A01_PLANSEU_3 | Planseu_nivel_0_travee_3 | 0.0 | 0.0 | 18.0 | 1.0 | 0.0 | 0.0 | 0.0 | 0.0 | 1.0 | 0.0 | 0.0 | 0.0 | 0.0 | 1.0 | 18.0 | 0.0 | 0.0 | 0.0 | 1.0
J01_CHEIE_FLUTURE | J01_CHEIE_FLUTURE_1 | -78.0 | -178.0 | 17.15 | 1.0 | 0.0 | 0.0 | -78.0 | 0.0 | 1.0 | 0.0 | -178.0 | 0.0 | 0.0 | 1.0 | 17.15 | 0.0 | 0.0 | 0.0 | 1.0
J01_CHEIE_FLUTURE | J01_CHEIE_FLUTURE_2 | -78.0 | -110.0 | 17.15 | 1.0 | 0.0 | 0.0 | -78.0 | 0.0 | 1.0 | 0.0 | -110.0 | 0.0 | 0.0 | 1.0 | 17.15 | 0.0 | 0.0 | 0.0 | 1.0
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
