vluncasu/SolarSkin/engineering/assembly/simplified_instances.csv

part_id | instance_name | x_mm | y_mm | z_mm | m00 | m01 | m02 | m03 | m10 | m11 | m12 | m13 | m20 | m21 | m22 | m23 | m30 | m31 | m32 | m33
A04_PORTANT_1_N1 | A04_PORTANT_1_N1_1 | 0.0 | 0.0 | 0.0 | 1.0 | 0.0 | 0.0 | 0.0 | 0.0 | 1.0 | 0.0 | 0.0 | 0.0 | 0.0 | 1.0 | 0.0 | 0.0 | 0.0 | 0.0 | 1.0
J02_SURUB_RECEPTOR_D8 | Surub_modul_13_-160 | -159.722463925 | 9.0 | 74.0 | 1.0 | 0.0 | 0.0 | -159.722463925 | 0.0 | 2.220446049250313e-16 | -1.0 | 9.0 | 0.0 | 1.0 | 2.220446049250313e-16 | 74.0 | 0.0 | 0.0 | 0.0 | 1.0
J02_SURUB_RECEPTOR_D8 | Surub_modul_13_-128 | -127.722463925 | 9.0 | 74.0 | 1.0 | 0.0 | 0.0 | -127.722463925 | 0.0 | 2.220446049250313e-16 | -1.0 | 9.0 | 0.0 | 1.0 | 2.220446049250313e-16 | 74.0 | 0.0 | 0.0 | 0.0 | 1.0
A04_PORTANT_1_N2 | A04_PORTANT_1_N2_1 | 0.0 | 0.0 | 0.0 | 1.0 | 0.0 | 0.0 | 0.0 | 0.0 | 1.0 | 0.0 | 0.0 | 0.0 | 0.0 | 1.0 | 0.0 | 0.0 | 0.0 | 0.0 | 1.0
J02_SURUB_RECEPTOR_D8 | Surub_modul_09_-160 | -159.722463925 | 9.0 | 226.10000000000002 | 1.0 | 0.0 | 0.0 | -159.722463925 | 0.0 | 2.220446049250313e-16 | -1.0 | 9.0 | 0.0 | 1.0 | 2.220446049250313e-16 | 226.10000000000002 | 0.0 | 0.0 | 0.0 | 1.0
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
