vluncasu/SolarSkin/print/furnished/placements.csv

bed | material | part_id | instance | x_mm | y_mm
1 | matte_white_PLA | J03_PROBA_IMBINARI | 1 | 8 | 32
1 | matte_white_PLA | J01_CHEIE_FLUTURE | 30 | 46 | 32
1 | matte_white_PLA | F01_BOLT_5_6 | 1 | 70 | 32
1 | matte_white_PLA | F01_BOLT_5_6 | 2 | 86 | 32
1 | matte_white_PLA | F02_SIGURANTA_DUBLA | 1 | 70 | 52
1 | matte_white_PLA | F05_CHEIE_VERTICALA | 1 | 120 | 32
2 | matte_white_PLA | A01_PLANSEU_1 | 1 | 14 | 36.0
2 | matte_white_PLA | A01_PLANSEU_1 | 2 | 14 | 52.6
2 | matte_white_PLA | A01_PLANSEU_1 | 3 | 14 | 69.2
2 | matte_white_PLA | A01_PLANSEU_1 | 4 | 14 | 85.80000000000001
2 | matte_white_PLA | A01_PLANSEU_1 | 5 | 14 | 102.4
2 | matte_white_PLA | A01_PLANSEU_2 | 1 | 14 | 119.0
2 | matte_white_PLA | A01_PLANSEU_2 | 2 | 14 | 135.60000000000002
2 | matte_white_PLA | A01_PLANSEU_2 | 3 | 14 | 152.20000000000002
2 | matte_white_PLA | A01_PLANSEU_2 | 4 | 14 | 168.8
2 | matte_white_PLA | A01_PLANSEU_2 | 5 | 14 | 185.4
2 | matte_white_PLA | A01_PLANSEU_3 | 1 | 14 | 202.0
2 | matte_white_PLA | A01_PLANSEU_3 | 2 | 14 | 218.60000000000002
2 | matte_white_PLA | A01_PLANSEU_3 | 3 | 14 | 235.20000000000002
3 | matte_white_PLA | A01_PLANSEU_3 | 4 | 14 | 36.0
3 | matte_white_PLA | A01_PLANSEU_3 | 5 | 14 | 52.6
4 | matte_white_PLA | A02_CADRU_SPATE_INALT | 1 | 8 | 32
4 | matte_white_PLA | F06_CHEIE_VERTICALA_LUNGA | 1 | 8 | 192.0
4 | matte_white_PLA | F06_CHEIE_VERTICALA_LUNGA | 2 | 8 | 210.16
4 | matte_white_PLA | E07_CANAL_ACOPERIS_1 | 1 | 8 | 228.32
4 | matte_white_PLA | F02_SIGURANTA_DUBLA | 2 | 199.14 | 192.0
4 | matte_white_PLA | F02_SIGURANTA_DUBLA | 3 | 199.14 | 210.16
4 | matte_white_PLA | F02_SIGURANTA_DUBLA | 4 | 168.0 | 228.32
4 | matte_white_PLA | J01_CHEIE_FLUTURE | 1 | 235.5 | 32
4 | matte_white_PLA | J01_CHEIE_FLUTURE | 2 | 214.0 | 228.32
4 | matte_white_PLA | J01_CHEIE_FLUTURE | 3 | 227.4 | 228.32
5 | matte_white_PLA | A02_CADRU_SPATE_INALT | 2 | 8 | 32
5 | matte_white_PLA | E07_CANAL_ACOPERIS_2 | 1 | 8 | 192.0
5 | matte_white_PLA | E07_CANAL_ACOPERIS_3 | 1 | 8 | 210.0
5 | matte_white_PLA | E08_CAPAC_CANAL_ACOPERIS | 1 | 8 | 228.0
5 | matte_white_PLA | F02_SIGURANTA_DUBLA | 5 | 168.0 | 192.0
5 | matte_white_PLA | F02_SIGURANTA_DUBLA | 6 | 168.0 | 210.0
5 | matte_white_PLA | F02_SIGURANTA_DUBLA | 7 | 168.0 | 228.0
5 | matte_white_PLA | J01_CHEIE_FLUTURE | 4 | 235.5 | 32
5 | matte_white_PLA | J01_CHEIE_FLUTURE | 5 | 214.0 | 192.0
5 | matte_white_PLA | J01_CHEIE_FLUTURE | 6 | 227.4 | 192.0
5 | matte_white_PLA | J01_CHEIE_FLUTURE | 7 | 214.0 | 210.0
5 | matte_white_PLA | J01_CHEIE_FLUTURE | 8 | 227.4 | 210.0
5 | matte_white_PLA | J01_CHEIE_FLUTURE | 9 | 214.0 | 228.0
5 | matte_white_PLA | J01_CHEIE_FLUTURE | 10 | 227.4 | 228.0
6 | matte_white_PLA | A02_CADRU_SPATE_INALT | 3 | 8 | 32
6 | matte_white_PLA | E08_CAPAC_CANAL_ACOPERIS | 2 | 8 | 192.0
6 | matte_white_PLA | E08_CAPAC_CANAL_ACOPERIS | 3 | 8 | 210.0
6 | matte_white_PLA | F07_CHEIE_ORIZONTALA | 1 | 8 | 228.0
6 | matte_white_PLA | F05_CHEIE_VERTICALA | 2 | 131.44 | 228.0
6 | matte_white_PLA | F02_SIGURANTA_DUBLA | 8 | 168.0 | 192.0
6 | matte_white_PLA | F02_SIGURANTA_DUBLA | 9 | 168.0 | 210.0
6 | matte_white_PLA | J01_CHEIE_FLUTURE | 11 | 235.5 | 32
6 | matte_white_PLA | J01_CHEIE_FLUTURE | 12 | 214.0 | 192.0
6 | matte_white_PLA | J01_CHEIE_FLUTURE | 13 | 227.4 | 192.0
6 | matte_white_PLA | J01_CHEIE_FLUTURE | 14 | 214.0 | 210.0
6 | matte_white_PLA | J01_CHEIE_FLUTURE | 15 | 227.4 | 210.0
7 | matte_white_PLA | A07_LAMELE_UNDA_ETAJ_INALT | 1 | 8 | 32
7 | matte_white_PLA | F07_CHEIE_ORIZONTALA | 2 | 8 | 188.0
7 | matte_white_PLA | F07_CHEIE_ORIZONTALA | 3 | 8 | 206.16
7 | matte_white_PLA | F07_CHEIE_ORIZONTALA | 4 | 8 | 224.32
7 | matte_white_PLA | F05_CHEIE_VERTICALA | 3 | 131.44 | 188.0
7 | matte_white_PLA | F05_CHEIE_VERTICALA | 4 | 131.44 | 206.16
7 | matte_white_PLA | F05_CHEIE_VERTICALA | 5 | 131.44 | 224.32
7 | matte_white_PLA | I02_BARA_POZITIONARE | 1 | 8 | 242.48
7 | matte_white_PLA | I02_BARA_POZITIONARE | 2 | 106.0 | 242.48
7 | matte_white_PLA | J01_CHEIE_FLUTURE | 16 | 235.5 | 32
8 | matte_white_PLA | A07_LAMELE_UNDA_ETAJ_INALT | 2 | 8 | 32
8 | matte_white_PLA | F07_CHEIE_ORIZONTALA | 5 | 8 | 188.0
8 | matte_white_PLA | F07_CHEIE_ORIZONTALA | 6 | 8 | 206.16
8 | matte_white_PLA | F07_CHEIE_ORIZONTALA | 7 | 8 | 224.32
8 | matte_white_PLA | F05_CHEIE_VERTICALA | 6 | 131.44 | 188.0
8 | matte_white_PLA | F02_SIGURANTA_DUBLA | 10 | 131.44 | 206.16
8 | matte_white_PLA | F02_SIGURANTA_DUBLA | 11 | 177.44 | 206.16
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
16 | matte_white_PLA | A02_CADRU_SPATE | 8 | 8 | 32
17 | matte_white_PLA | A02_CADRU_SPATE | 9 | 8 | 32
18 | matte_white_PLA | A05_LAMELE_UNDA_ASCENDENTA | 1 | 8 | 32
19 | matte_white_PLA | A05_LAMELE_UNDA_ASCENDENTA | 2 | 8 | 32
20 | matte_white_PLA | A05_LAMELE_UNDA_ASCENDENTA | 3 | 8 | 32
21 | matte_white_PLA | A05_LAMELE_UNDA_ASCENDENTA | 4 | 8 | 32
22 | matte_white_PLA | A06_LAMELE_UNDA_DESCENDENTA | 1 | 8 | 32
23 | matte_white_PLA | A06_LAMELE_UNDA_DESCENDENTA | 2 | 8 | 32
24 | matte_white_PLA | E02_CUTIE_SURSA_12V | 1 | 8 | 32
24 | matte_white_PLA | E03_CAPAC_SURSA | 1 | 8 | 141.0
24 | matte_white_PLA | S03_BALUSTRADA_SEPARATA | 1 | 150.0 | 32
24 | matte_white_PLA | S03_BALUSTRADA_SEPARATA | 2 | 150.0 | 141.0
25 | matte_white_PLA | E05_CUTIE_COMANDA | 1 | 8 | 32
25 | matte_white_PLA | E06_CAPAC_COMANDA | 1 | 8 | 111.0
26 | matte_white_PLA | S03_BALUSTRADA_SEPARATA | 3 | 8 | 32
26 | matte_white_PLA | S03_BALUSTRADA_SEPARATA | 4 | 101.8425 | 32
26 | matte_white_PLA | S03_BALUSTRADA_SEPARATA | 5 | 8 | 124.00000000000001
26 | matte_white_PLA | S03_BALUSTRADA_SEPARATA | 6 | 101.8425 | 124.00000000000001
27 | matte_white_PLA | I01_RECEPTIE | 1 | 8 | 32
27 | matte_white_PLA | I01_RECEPTIE | 2 | 122.0 | 32
27 | matte_white_PLA | I01_ATELIER | 1 | 8 | 106.0
27 | matte_white_PLA | I01_ATELIER | 2 | 122.0 | 106.0
28 | matte_white_PLA | I01_ATELIER | 3 | 8 | 32
28 | matte_white_PLA | I01_ATELIER | 4 | 122.0 | 32
28 | matte_white_PLA | I01_SEDINTA | 1 | 8 | 106.0
28 | matte_white_PLA | I01_SEDINTA | 2 | 122.0 | 106.0
29 | anthracite_PLA | F04_CASETA_C2_N4 | 1 | 8 | 32
29 | anthracite_PLA | B03_SOCLU_SPATE_CU_TALPA | 1 | 8 | 192.00000000000003
29 | anthracite_PLA | B03_SOCLU_SPATE_CU_TALPA | 2 | 8 | 210.00000000000003
29 | anthracite_PLA | B03_SOCLU_SPATE_CU_TALPA | 3 | 8 | 228.00000000000003
30 | anthracite_PLA | F04_CASETA_C1_N4 | 1 | 8 | 32
31 | anthracite_PLA | F04_CASETA_C3_N4 | 1 | 8 | 32
32 | anthracite_PLA | B04_SOCLU_EVANTAI_INTEGRAT | 1 | 8 | 32
33 | anthracite_PLA | B04_SOCLU_EVANTAI_INTEGRAT | 2 | 8 | 32
34 | anthracite_PLA | B04_SOCLU_EVANTAI_INTEGRAT | 3 | 8 | 32
35 | anthracite_PLA | F04_CASETA_C2_N3 | 1 | 8 | 32
36 | anthracite_PLA | F04_CASETA_C1_N3 | 1 | 8 | 32
37 | anthracite_PLA | F04_CASETA_C3_N3 | 1 | 8 | 32
38 | anthracite_PLA | F04_CASETA_C1_N1 | 1 | 8 | 32
39 | anthracite_PLA | F04_CASETA_C1_N2 | 1 | 8 | 32
40 | anthracite_PLA | F04_CASETA_C2_N1 | 1 | 8 | 32
41 | anthracite_PLA | F04_CASETA_C2_N2 | 1 | 8 | 32
42 | anthracite_PLA | F04_CASETA_C3_N1 | 1 | 8 | 32
43 | anthracite_PLA | F04_CASETA_C3_N2 | 1 | 8 | 32
44 | orange_PLA | S01_SCARA_RAMPA_INFERIOARA | 1 | 8 | 32
44 | orange_PLA | S01_SCARA_RAMPA_INFERIOARA | 2 | 94.651 | 32
44 | orange_PLA | E04_BRIDA_SURSA | 1 | 8 | 148.0
44 | orange_PLA | E04_BRIDA_SURSA | 2 | 126.6 | 148.0
45 | orange_PLA | S01_SCARA_RAMPA_INFERIOARA | 3 | 8 | 32
45 | orange_PLA | S02_SCARA_RAMPA_SUPERIOARA | 1 | 94.651 | 32
46 | orange_PLA | S02_SCARA_RAMPA_SUPERIOARA | 2 | 8 | 32
46 | orange_PLA | S02_SCARA_RAMPA_SUPERIOARA | 3 | 89.65100000000022 | 32
