vluncasu/SolarSkin/print/simplified/placements.csv

bed | material | part_id | instance | x_mm | y_mm
1 | matte_white_PLA | J03_PROBA_IMBINARI | 1 | 8 | 32
1 | matte_white_PLA | J01_CHEIE_FLUTURE | 30 | 46 | 32
2 | matte_white_PLA | A01_PLANSEU_1 | 1 | 14 | 36.0
2 | matte_white_PLA | A01_PLANSEU_1 | 2 | 14 | 52.6
2 | matte_white_PLA | A01_PLANSEU_1 | 3 | 14 | 69.2
2 | matte_white_PLA | A01_PLANSEU_1 | 4 | 14 | 85.80000000000001
2 | matte_white_PLA | A01_PLANSEU_1 | 5 | 14 | 102.4
2 | matte_white_PLA | A01_PLANSEU_2 | 1 | 14 | 119.0
2 | matte_white_PLA | A01_PLANSEU_2 | 2 | 14 | 135.60000000000002
2 | matte_white_PLA | A01_PLANSEU_2 | 3 | 14 | 152.20000000000002
2 | matte_white_PLA | A01_PLANSEU_2 | 4 | 14 | 168.8
2 | matte_white_PLA | A01_PLANSEU_2 | 5 | 14 | 185.4
2 | matte_white_PLA | A01_PLANSEU_3 | 1 | 14 | 202.0
2 | matte_white_PLA | A01_PLANSEU_3 | 2 | 14 | 218.60000000000002
2 | matte_white_PLA | A01_PLANSEU_3 | 3 | 14 | 235.20000000000002
3 | matte_white_PLA | A01_PLANSEU_3 | 4 | 14 | 36.0
3 | matte_white_PLA | A01_PLANSEU_3 | 5 | 14 | 52.6
4 | translucent_green_PETG | V01_VITRAJ_SPATE_INALT | 1 | 8 | 32
5 | translucent_green_PETG | V01_VITRAJ_SPATE_INALT | 2 | 8 | 32
6 | translucent_green_PETG | V01_VITRAJ_SPATE_INALT | 3 | 8 | 32
7 | translucent_green_PETG | V02_VITRAJ_LATERAL_INALT | 1 | 8 | 32
8 | translucent_green_PETG | V02_VITRAJ_LATERAL_INALT | 2 | 8 | 32
9 | translucent_green_PETG | V01_VITRAJ_SPATE | 1 | 8 | 32
10 | translucent_green_PETG | V01_VITRAJ_SPATE | 2 | 8 | 32
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
57 | matte_white_PLA | E05_CUTIE_COMANDA | 1 | 8 | 32
57 | matte_white_PLA | E06_CAPAC_COMANDA | 1 | 8 | 111.0
58 | anthracite_PLA | B02_TALPA_FATA | 1 | 8 | 32
58 | anthracite_PLA | B01_SOCLU_SPATE | 1 | 8 | 211.2
58 | anthracite_PLA | B01_SOCLU_SPATE | 2 | 8 | 229.2
59 | anthracite_PLA | B02_TALPA_FATA | 2 | 8 | 32
59 | anthracite_PLA | B01_SOCLU_SPATE | 3 | 8 | 211.2
59 | anthracite_PLA | B03_SOCLU_SPATE_CU_TALPA | 1 | 8 | 229.2
60 | anthracite_PLA | B02_TALPA_FATA | 3 | 8 | 32
60 | anthracite_PLA | B03_SOCLU_SPATE_CU_TALPA | 2 | 8 | 211.2
60 | anthracite_PLA | B03_SOCLU_SPATE_CU_TALPA | 3 | 8 | 229.2
61 | orange_PLA | S01_SCARA_RAMPA_INFERIOARA | 1 | 8 | 32
61 | orange_PLA | S01_SCARA_RAMPA_INFERIOARA | 2 | 116.85 | 32
61 | orange_PLA | E04_BRIDA_SURSA | 1 | 8 | 148.0
61 | orange_PLA | E04_BRIDA_SURSA | 2 | 126.6 | 148.0
62 | orange_PLA | S01_SCARA_RAMPA_INFERIOARA | 3 | 8 | 32
62 | orange_PLA | S02_SCARA_RAMPA_SUPERIOARA | 1 | 116.85 | 32
63 | orange_PLA | S02_SCARA_RAMPA_SUPERIOARA | 2 | 8 | 32
63 | orange_PLA | S02_SCARA_RAMPA_SUPERIOARA | 3 | 111.85000000000001 | 32
