vluncasu/SolarSkin/media/renders/assembly_09.webp

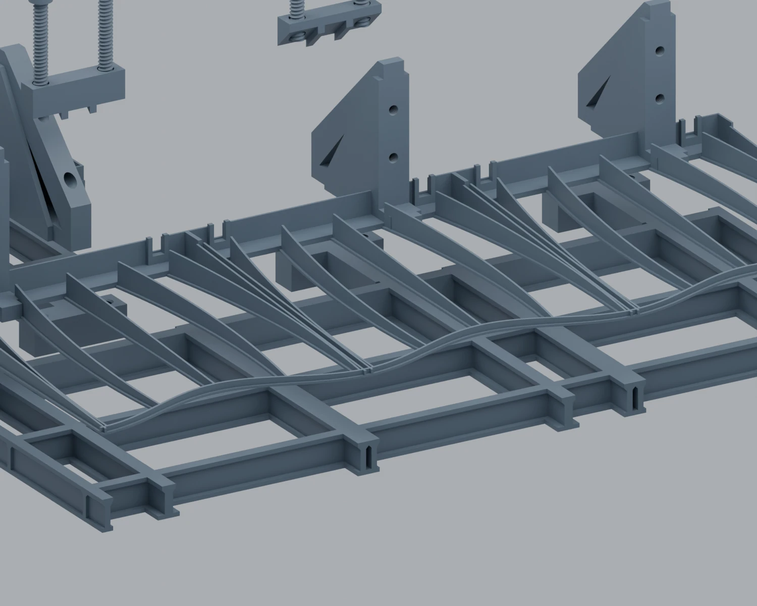
media/renders/assembly_09.webp
