vluncasu/SolarSkin/media/renders/building_motion.gif

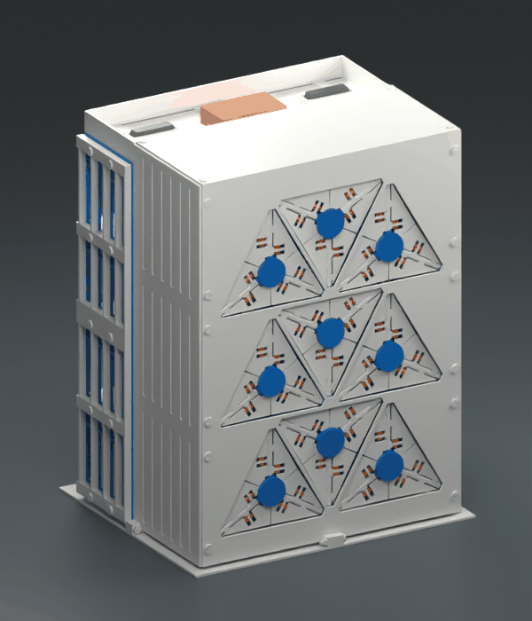
media/renders/building_motion.gif
