vluncasu/SolarSkin/engineering/results/reduction_table.csv

stroke_mm | extra_reduction | step_mode | nominal_steps_per_output_rev | screw_revolutions | geared_motor_output_revolutions | internal_rotor_revolutions_nominal | ideal_step_count | nearest_integer_steps | rate_steps_per_second | constant_rate_time_s | linear_speed_mm_per_second
15.348483958404778 | 1 | half | 4096 | 1.5348483958404777 | 1.5348483958404777 | 98.23029733379057 | 6286.739029362597 | 6287 | 180 | 34.92632794090331 | 0.439453125
15.348483958404778 | 1 | full | 2048 | 1.5348483958404777 | 1.5348483958404777 | 98.23029733379057 | 3143.3695146812984 | 3143 | 120 | 26.194745955677487 | 0.5859375
15.348483958404778 | 2 | half | 4096 | 1.5348483958404777 | 3.0696967916809554 | 196.46059466758115 | 12573.478058725193 | 12573 | 180 | 69.85265588180663 | 0.2197265625
15.348483958404778 | 2 | full | 2048 | 1.5348483958404777 | 3.0696967916809554 | 196.46059466758115 | 6286.739029362597 | 6287 | 120 | 52.38949191135497 | 0.29296875
15.348483958404778 | 4 | half | 4096 | 1.5348483958404777 | 6.139393583361911 | 392.9211893351623 | 25146.956117450387 | 25147 | 180 | 139.70531176361325 | 0.10986328125
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
