vluncasu/SolarSkin/firmware/baseline_web/src/main.cpp

#ifndef SOLARSKIN_HOST_TEST
#include <Arduino.h>
#include "network.h"
#endif
// Seven 74HC595: NEXT pin9 -> DATA pin14 of the next chip.
constexpr uint8_t DATA=23,CLOCK=18,LATCH=21,OE=22,REGISTERS=7;
constexpr uint16_t TRAVEL=6287;
constexpr uint8_t HALF[8]={1,3,2,6,4,12,8,9};
constexpr float MAX_RATE=180,MIN_RATE=40,ACCEL=80;
uint8_t phase=0;int direction=1;uint16_t done=0;
float rate=MIN_RATE;uint32_t nextUs=0,pauseUntil=0,lastRampUs=0;
bool waiting=true,stopped=false;int32_t position=0;uint16_t legSteps=TRAVEL;uint32_t sentFrames=0;
void sendPattern(uint8_t pattern){
 sentFrames++;
 uint8_t byte=(pattern&15)|((pattern&15)<<4);
 digitalWrite(CLOCK,LOW);digitalWrite(LATCH,LOW);
 for(int r=REGISTERS-1;r>=0;r--)for(int b=7;b>=0;b--){
  digitalWrite(DATA,(byte>>b)&1);delayMicroseconds(5);
  digitalWrite(CLOCK,HIGH);delayMicroseconds(5);
  digitalWrite(CLOCK,LOW);delayMicroseconds(5);
 }
 digitalWrite(LATCH,HIGH);delayMicroseconds(5);digitalWrite(LATCH,LOW);
}
void command(char c){
 if(c=='s'){stopped=true;sendPattern(0);return;}
 if(c!='r'&&c!='o'&&c!='c')return;
 stopped=false;
 direction=c=='o'?1:c=='c'?-1:(position>=TRAVEL?-1:1);
 legSteps=direction>0?TRAVEL-position:position;
 done=0;rate=MIN_RATE;waiting=true;pauseUntil=millis()+1000;
 sendPattern(0);
 if(legSteps==0){direction=-direction;legSteps=TRAVEL;}
}
void setup(){
 digitalWrite(OE,HIGH);pinMode(OE,OUTPUT);digitalWrite(OE,HIGH);
 pinMode(DATA,OUTPUT);pinMode(CLOCK,OUTPUT);pinMode(LATCH,OUTPUT);
 digitalWrite(DATA,LOW);digitalWrite(CLOCK,LOW);digitalWrite(LATCH,LOW);
 sendPattern(0);digitalWrite(OE,LOW);
 Serial.begin(115200);
 Serial.println("SolarSkin RESTORED 04 NOV: 7 registers, 14 motors; +6287/-6287 forever; 180 halfsteps/s; initial closed position assumed");
 pauseUntil=millis()+5000;
 publishStatus(position,sentFrames,direction,stopped,waiting);
 startNetwork();
}
void loop(){
 char c;while((c=readCommand())!=0)command(c);
 static uint32_t report=0;if((uint32_t)(millis()-report)>=100){report=millis();publishStatus(position,sentFrames,direction,stopped,waiting);}
 if(stopped){delay(1);return;}
 if(waiting){
  if((int32_t)(millis()-pauseUntil)<0){delay(1);return;}
  waiting=false;done=0;rate=MIN_RATE;nextUs=lastRampUs=micros();
  Serial.printf("ALL 14: direction=%d, commanded halfsteps=%u\n",direction,legSteps);
 }
 uint32_t now=micros();if((int32_t)(now-nextUs)<0){delayMicroseconds(40);return;}
 float dt=(uint32_t)(now-lastRampUs)*.000001f;lastRampUs=now;
 float brake=sqrtf(2*ACCEL*(legSteps-done));
 rate=fminf(MAX_RATE,fminf(rate+ACCEL*dt,fmaxf(MIN_RATE,brake)));
 phase=(phase+(direction>0?1:7))&7;
 sendPattern(HALF[phase]);done++;position+=direction;
 // One bounded step per service; no burst catch-up after serial or other delays.
 nextUs=now+(uint32_t)(1000000.f/rate);
 if(done==legSteps){
  sendPattern(0);Serial.println("LEG COMPLETE; outputs zero; reverse after 1 second");
  direction=-direction;legSteps=TRAVEL;waiting=true;pauseUntil=millis()+1000;
 }
}
