vluncasu/SolarSkin/(commit log)

2026-11-08 Publish essential kinetic facade: building CAD, renders, assembly and ESP32 controls
    [01_A01_ROOF_1.stl, 02_A01_ROOF_2.stl, 03_A01_FLOOR_1.stl, 04_A01_FLOOR_2.stl, 05_A01_GROUND_FLOOR_1.stl, 06_A01_GROUND_FLOOR_2.stl, 07_A02_FRAME_REAR.stl, 08_A02_FRAME_REAR_TALL.stl]
2026-11-08 Show the facade in motion and document four color-separated print beds
    [orange_plate_1.3mf, white_plate_1.3mf, windows_blue_plate_1.3mf, windows_blue_plate_2.3mf]
2026-11-08 Record checksums for the build guide and arranged plates
2026-11-08 Distinguish furnished office, rapid office and independent kinetic stand
    [OFFICE_16.blend, bed_01_matte_white_PLA.3mf, bed_02_matte_white_PLA.3mf, bed_03_matte_white_PLA.3mf, bed_04_matte_white_PLA.3mf, bed_04_translucent_green_PETG.3mf, bed_05_matte_white_PLA.3mf, bed_05_translucent_green_PETG.3mf]
2026-11-08 Illustrate every print mesh, assembly stages and verified simulation results
    [A01_PLANSEU_1.stl, A01_PLANSEU_2.stl, A01_PLANSEU_3.stl, A02_CADRU_SPATE.stl, A02_CADRU_SPATE_INALT.stl, A03_CADRU_LATERAL.stl, A03_CADRU_LATERAL_INALT.stl, A04_PORTANT_1_N1.stl]
2026-11-08 Restore the original twenty-module building and animate the earlier office models
    [AURORA_PAVILION.blend, COMPACT_OFFICE.blend, COMPLETE_BUILDING_20.blend, COMPLETE_BUILDING_R6.FCStd, RIGID_OFFICE.blend]
2026-11-08 Consolidate current downloads and use permanent latest-release links
